rjridle/GRAMS/2_Schematics_and_Layout/6_WIRING_DIAGRAM/Images/4TBLK_Wurth_Elektronik_691322310004.png

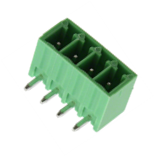
2_Schematics_and_Layout/6_WIRING_DIAGRAM/Images/4TBLK_Wurth_Elektronik_691322310004.png
