rjridle/GRAMS/3_Documentation/Polsir_isolated_design_discussion_06042024 1.pptx

## Polsir IPDU Isolated Design Discussion

## Overview of Ground Loop Risk to Polsir Design

- In the Polsir system, returns are tied to chassis in multiple places (input power source, S-band antenna, polarimeters)
  - Multiple connections to chassis and a shared return create loops (called ground loops) that can pick up noise and allow extraneous current flow in the system
  - This noise/current through chassis can impact sensitive measurements and damage electronics
- The IPDU can reduce these risks by implementing isolation in the design

Multiple tie points to chassis in the system and a single shared return produce ground loops, a design risk that can introduce noise and adversely impact sensitive instruments.

## Ground Loops

Simplified System Diagram

Ground Loop Illustration

Associated Design Risks
- The loop through the return and chassis forms an antenna
  - EM fields can induce current in the loop, introducing AC noise into the system
  - A large EM pulse can cause a current spike and damage the electronics
- The two chassis connection points may not have precisely the same ground voltage
  - This can cause a current flow that introduces an error in measurements

## Isolated Design Solution

In this isolated design, there is no path for a ground loop between the input and output

## Our System

Motor generates EM fields, which couple with RTN-chassis loop antenna, and generate chassis noise

Polarimeters require close ties to chassis due to high frequencies

Polarimeters share frequency bands with S-band antenna, which may increase susceptibility to chassis noise damage

S-band antenna requires close ties to chassis due to high frequencies

Vadir has sensitive electronics (24-bit ADC, 16-bit requirement); precise measurements are needed

## Input-Output Isolated System Solution

Noise generated by the motors and battery is kept away from sensitive electronics on Vadir and the polarimeters, at the cost of a second PCB and reduced PDU efficiency

Battery, motors, and the S-band antenna share a return

There are still ground loops on the input side and on the output side, but not across input to output

Polarimeters, Mini-Z, and Vadir share a return

Two conversion stages are needed, requiring a second PCB and reducing overall PDU efficiency (~4.7W additional dissipation)

## Isolated Design Impacts

Benefits
- An isolated design of the PDU can keep noise on the input side away from sensitive electronics and measurements on the output side
  - Ground loops within the input and output sides of the system would remain, but the overall risk is reduced
Drawbacks/Considerations
- A second PCB is required for the isolated converter stage, impacting cost and schedule
- PDU dissipation increases by approximately 4.7W
  - Currently investigating whether BCT can accommodate the increased power draw

Including an isolated stage in the PDU significantly improves the design overall, but has impacts on the power budget, cost, and schedule

All numbers shown are approximations

## Backup Slides

## Grounding Diagram
