rjridle/GRAMS/3_Documentation/4_Design_Specification_Documentation/SiPM_Warm_TPC_Box.pptx

Telemetry
Power Board 2

S33

S32

S31

S23

Warm TPC
Comm Board

Warm TPC
Power
(+/- 2V)

S22

Telemetry
Power Board 1

S21

S13

S12

S11
