rjridle/GRAMS/3_Documentation/4_Design_Specification_Documentation/Support_Images_For_Cold_TPC_SiPM_Users.pptx

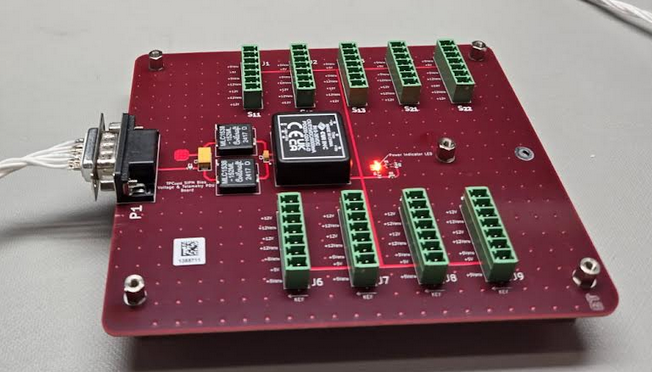
[picture p19: figure]

LED Indicator

## Slide 2

J2 – J7

1
2
3
4
5
6
7

+5V RTN

+5V RTN

+5V IN

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
+12V RTN

+12V IN

J2

+12V RTN

+12V IN

## Slide 3

Rack Supply

Chassis

+12V

+12V_RTN

Telemetry Power Board

J1

W1

J1

J2

W2

P_Out

J2

## Slide 4

TP

Shield

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
Chassis

TP

+12V_RTN

+12V IN

Würth Electronik
9-Position Socketed D-Sub
Part Num: 61800924923

TP

+12V_RTN

+12V IN

Terminate all +12V lines into the same banana connector
Terminate all +12V_RTN lines into the same banana connector
Terminate the Chassis line into its own banana connector

TP

+12V_RTN

+12V_RTN

+12V IN

+12V IN

Chassis

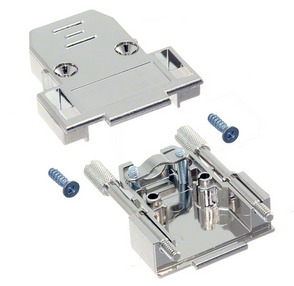
[picture p20: figure]

Würth Elektronik
9-Position Backshell
Part Number: 260709

## Slide 5

Würth Elektronik
3-Position Terminal Block
Part Number: 691361300003

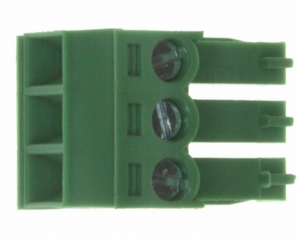
[picture p21: figure]

Phoenix Contact
7-Position Terminal Block
Part Number: 1803620

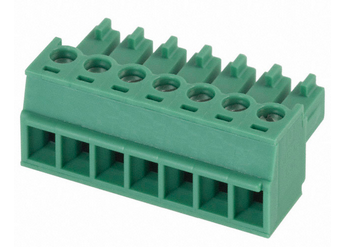
[picture p22: figure]

TP

Würth Elektronik
4-Position Terminal Block
Part Number: 691361100004

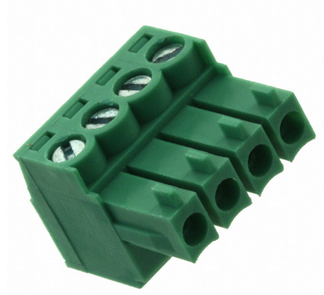
[picture p23: figure]

TP

## Slide 6

TP

Shield

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
Chassis

TP

HV Current Monitor

Telemetry Return

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
Chassis

Würth Electronik
9-Position Pin D-Sub
Part Num: 61800924823

TP

High Voltage Enable -

High Voltage Enable +

TP

High Voltage Monitor

Telemetry Return

Telemetry Return

Set High Voltage

Chassis

Würth Elektronik
9-Position Backshell
Part Number: 260709
