rjridle/GRAMS/3_Documentation/4_Design_Specification_Documentation/Support_Images_For_DSD.pptx

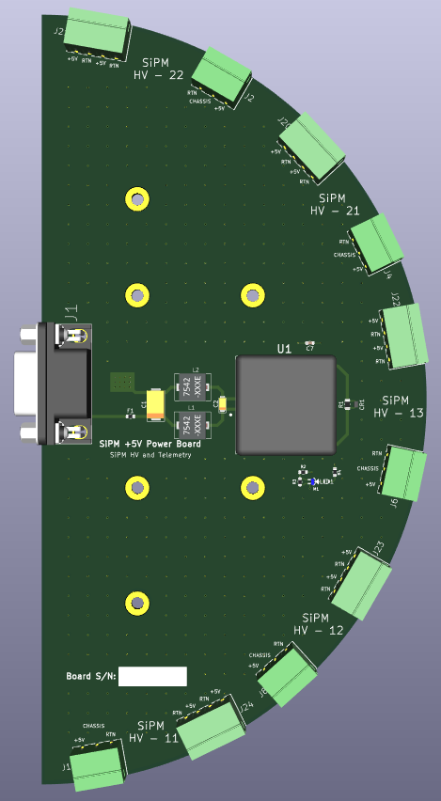
[picture p24: figure]

Telemetry
Power Board 2

S33

S32

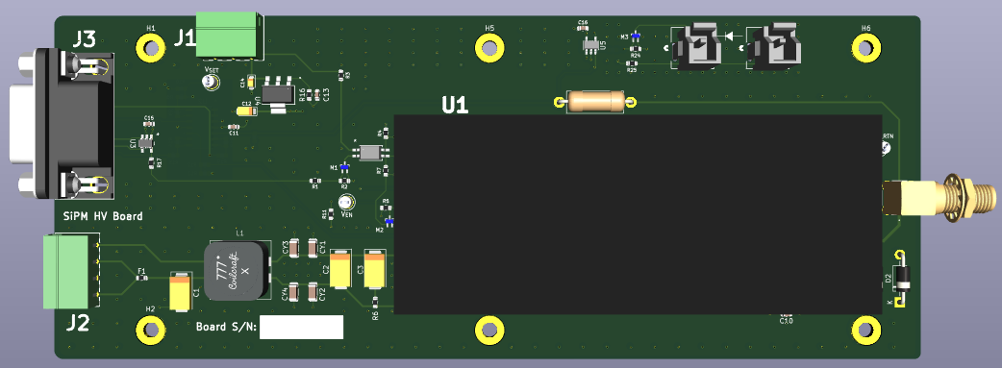
[picture p25: figure]

S33

S31

S23

Warm TPC
Comm Board

Warm TPC
Power
(+/- 2V)

S22

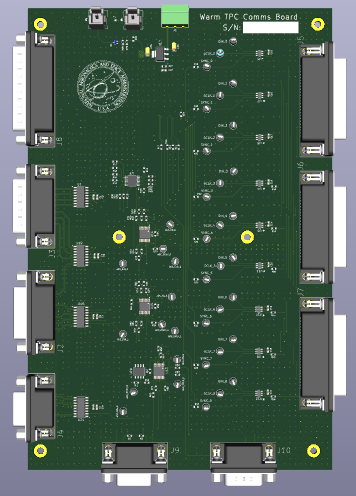
[picture p26: figure]
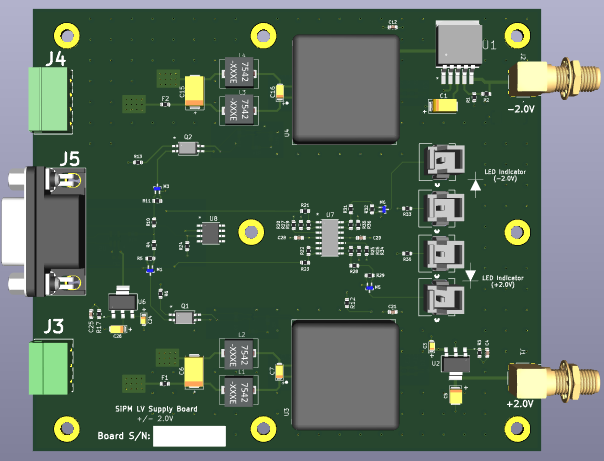
[picture p27: figure]

Telemetry
Power Board 1

S21

S13

S12

S11

S11

## Slide 2

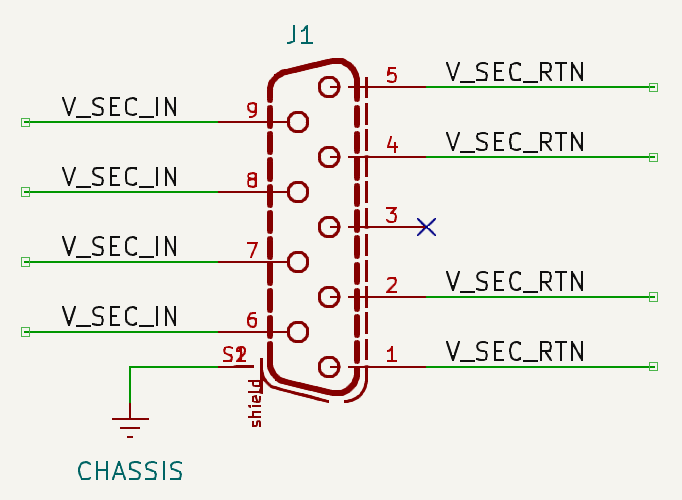
[picture p28: figure]

- J1 is a 9-Socketed D-Sub Connector
- U1 is the PDQ10-Q24-S5-D CUI DC-DC Converter
- LED1 indicates when output voltage from converter is on
- Terminal blocks (3 and 4 – Pos) headers

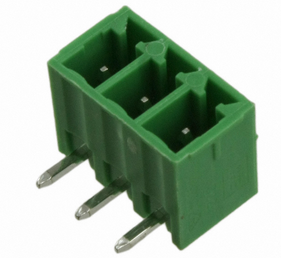
[picture p29: figure]

691322310003

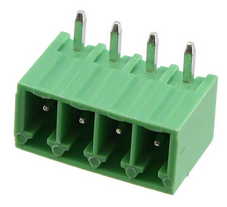
[picture p30: figure]

691322110004

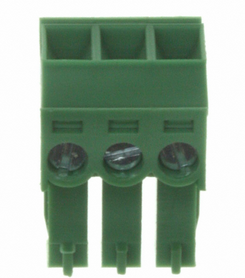
[picture p31: figure]

691361300003

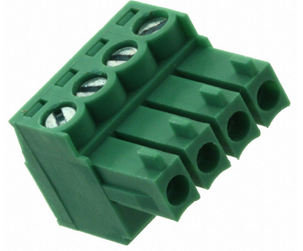
[picture p32: figure]

691361100004

## Slide 3

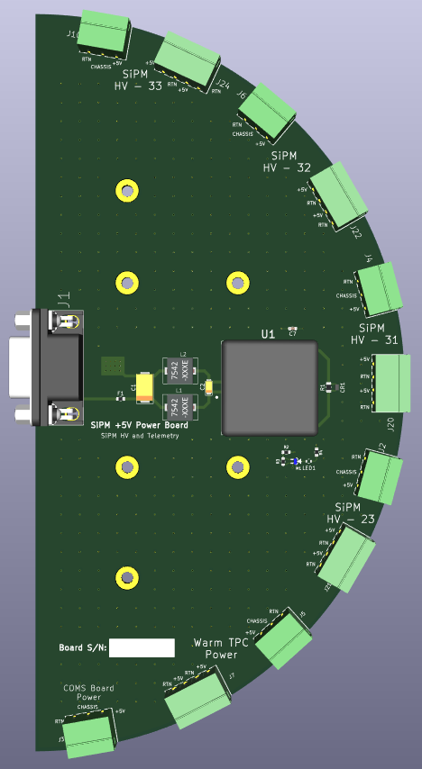
[picture p33: figure]
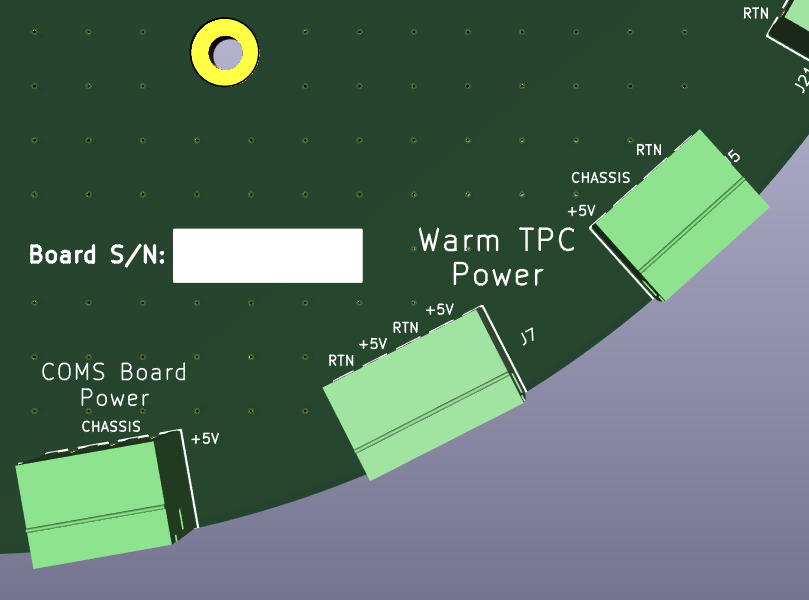
[picture p34: figure]

## Slide 4

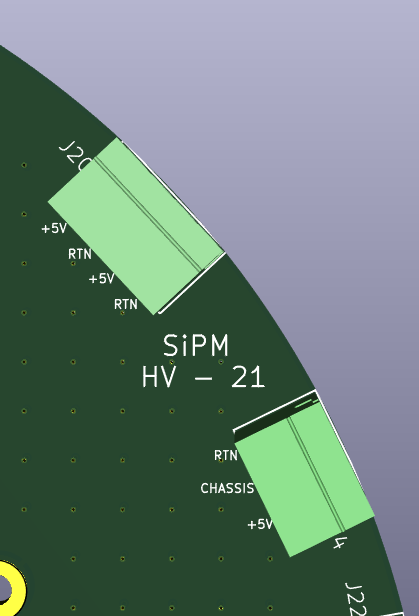
[picture p35: figure]

Power Board

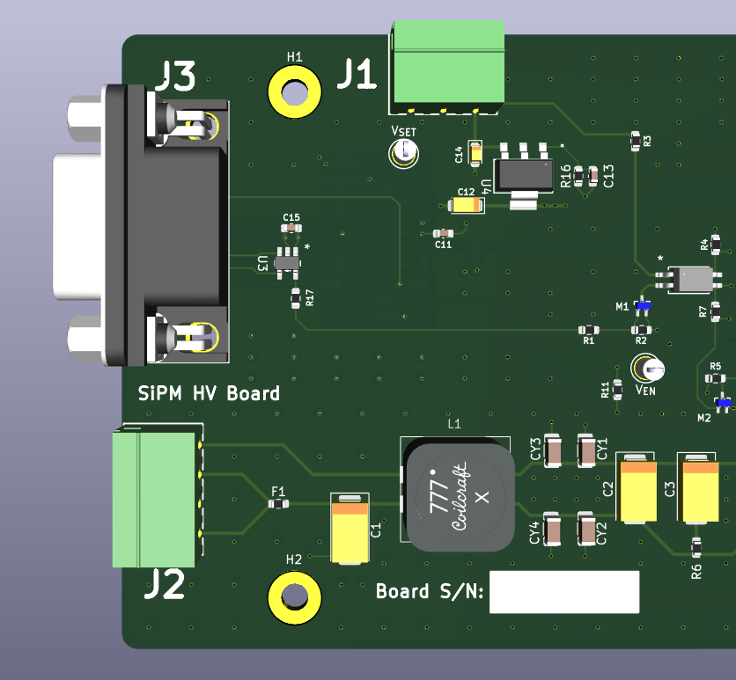
[picture p36: figure]

SiPM HV Board
