rjridle/GRAMS/2_Schematics_and_Layout/Block_Diagrams/SiPM_PDU_Block_Diagram.pptx

## SiPM HV Board (Box Concept)

## Slide 2

SiPM PDU BOX

SiPM HV Board

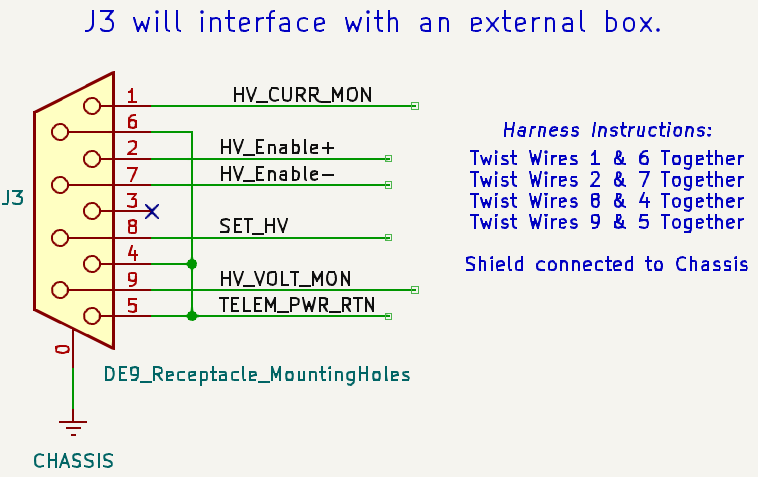
[picture p37: figure]

+12V

+5V

V_SEC_RTN

Telem V+

V_SEC

1

9-Pos D-Sub

Telem RTN

SiPM HV Board

SMA

V_SEC_RTN

V_SEC

2

9-Pos D-Sub

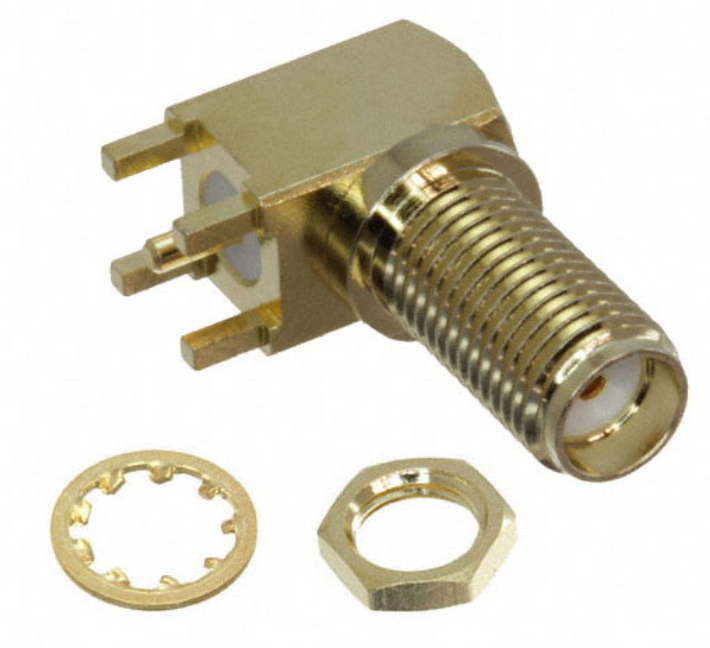
[picture p38: figure]

+12V

V_SEC

Telem RTN

Telem V+

SMA

V_SEC_RTN

V_SEC

V_SEC_RTN

V_SEC

Telemetry Supply (+5V)

V_SEC_RTN

Telem RTN

Telem V+

V_SEC_RTN

V_SEC

SiPM HV Board

Telem RTN

Telem V+

9

9-Pos D-Sub

SMA

Indicator LED outside of box

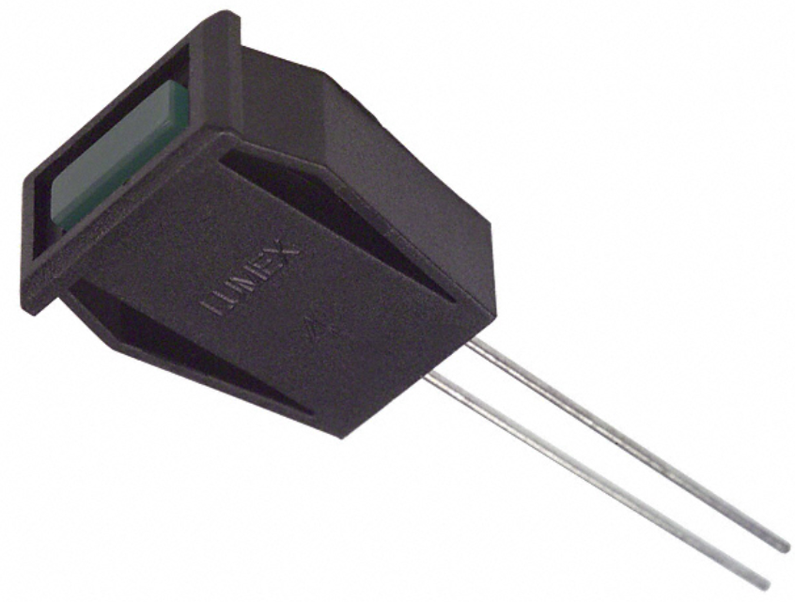
[picture p39: figure]

SiPM LV (+/- 2V Rails)

V_SEC_RTN

V_SEC

15-Pos D-Sub

+2V

RTN

Telem RTN

Telem V+

-2V

## SiPM HV Board (Schematic Design)

## Slide 4

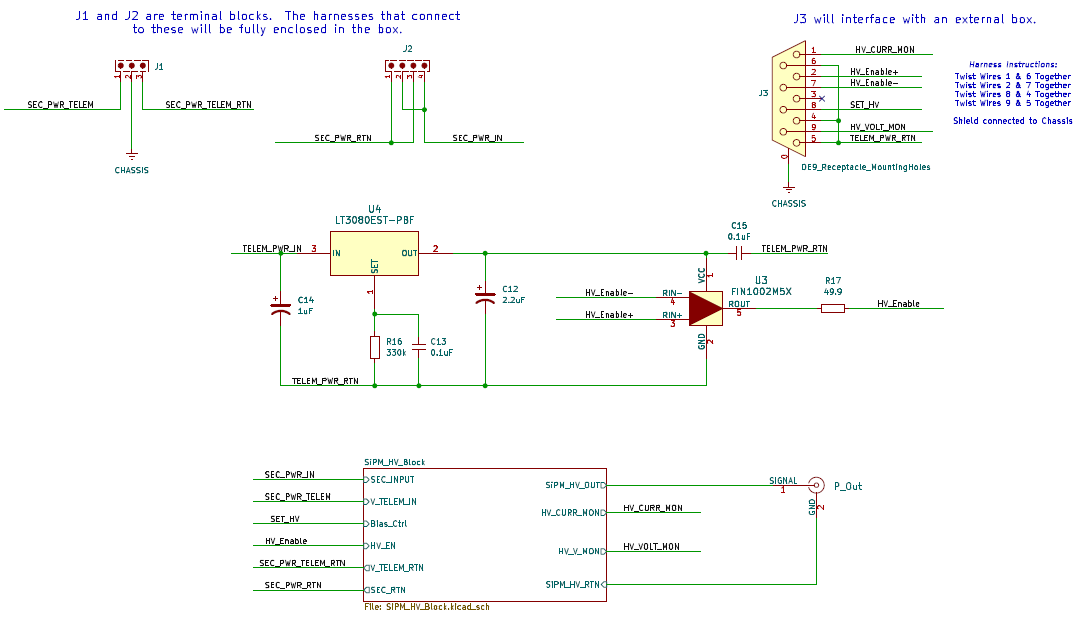
[picture p40: figure]

3.3V Logic for Enable Signal

LVDS Receiver

## Slide 5

DC-DC Converter Supplying SiPM with HV

Zap Trap

Prevents any drift
between HV and LV Returns

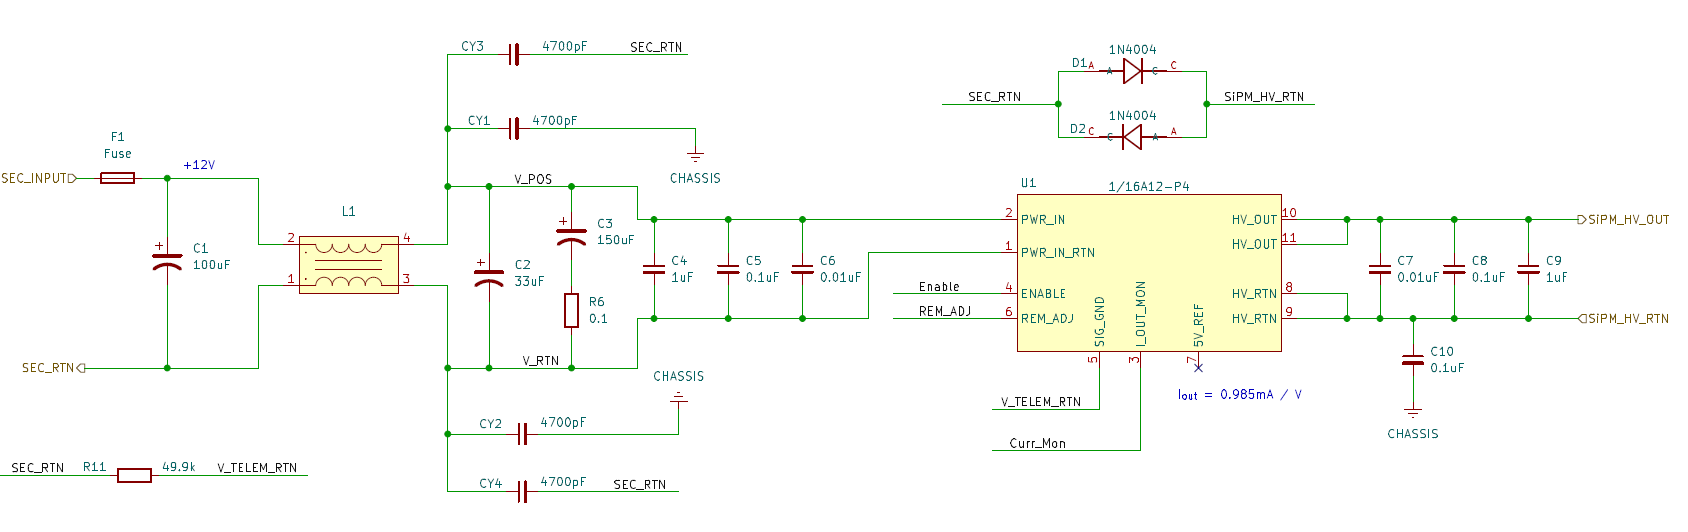
[picture p41: figure]

Safety Fuse

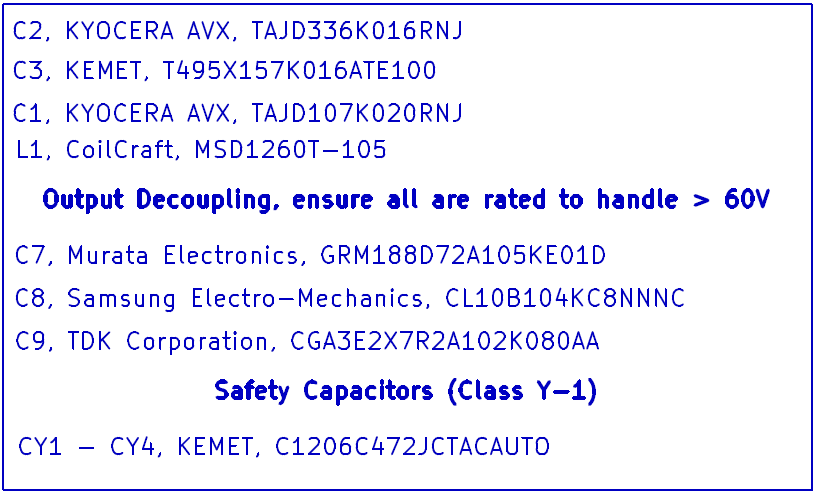
[picture p42: figure]

Keeps telemetry and secondary
returns from drifting away from
each other

## Slide 6

HV Enable Circuitry

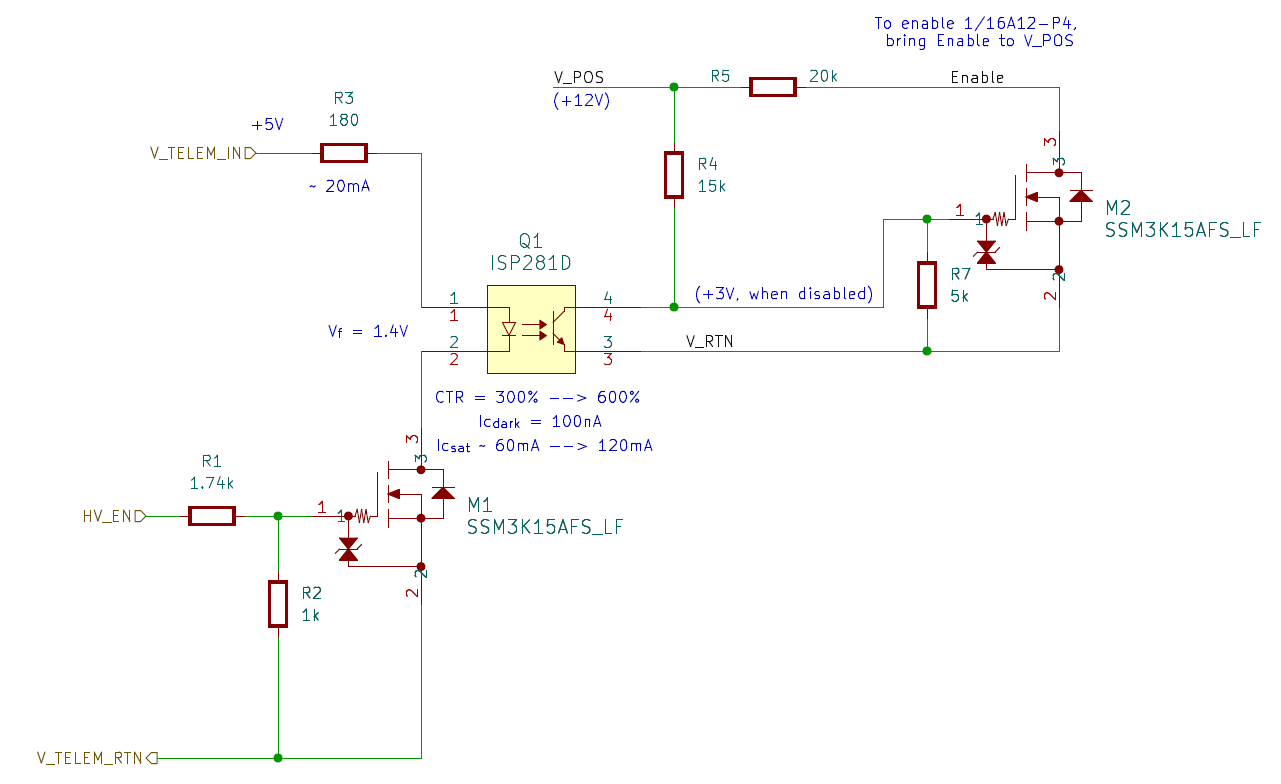
[picture p43: figure]

(DNP)

- Q1 Notes:
  - Pins 1 and 2 on Telemetry return plane
  - Pins 3 and 4 on the secondary return plane
- R5 is a DNP, as Enable pin within 1/16A12-P4 converter should be tied to V_POS via 10k resistor. If not, install R5.

## Slide 7

Telemetry Circuitry

Setting the HV Level

Current Monitor is outputting a voltage

HV Current Monitor

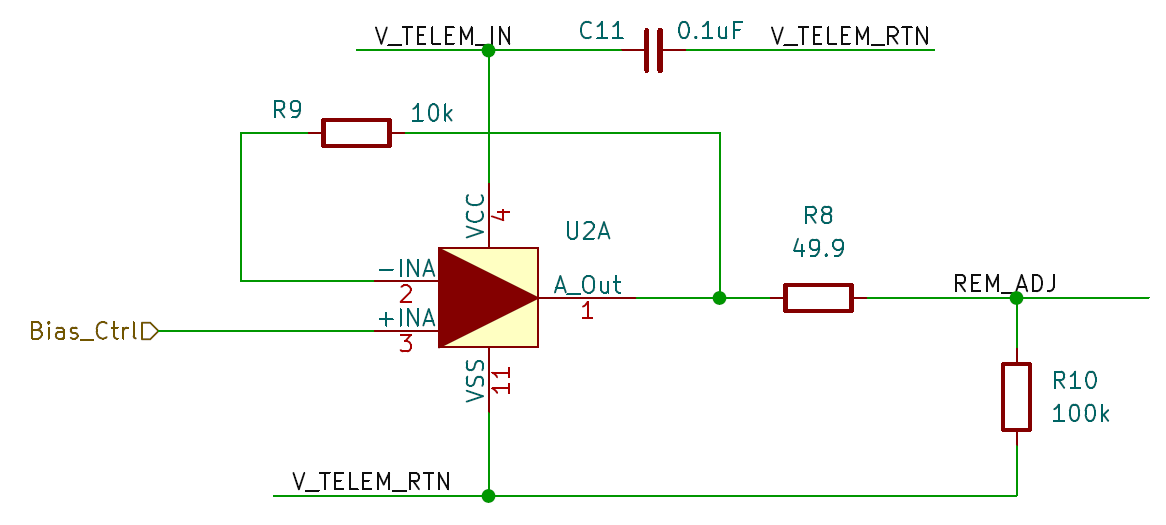
[picture p44: figure]
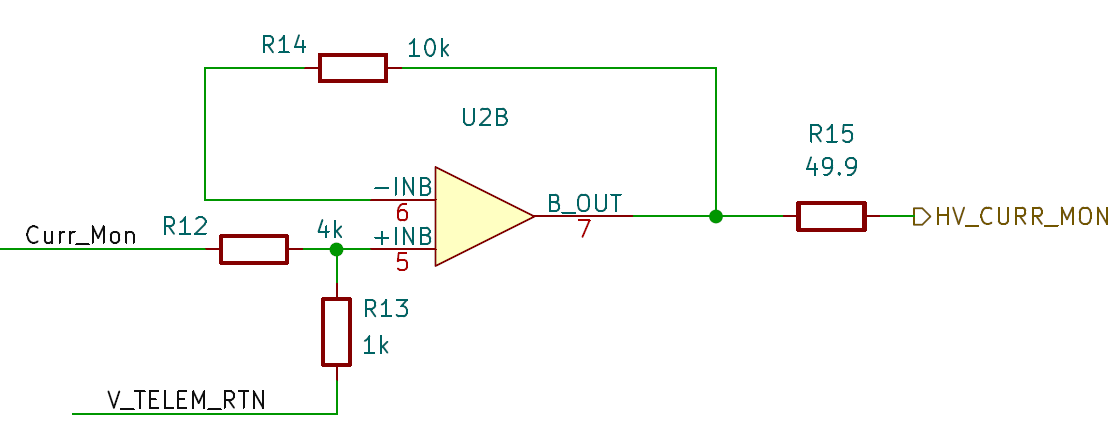
[picture p45: figure]

i_(HV) =(0.985mA)/(HV_CURR_MON)

V_(HV) =13.33(HV_(SET) )

High Voltage Monitor

Indicator LED

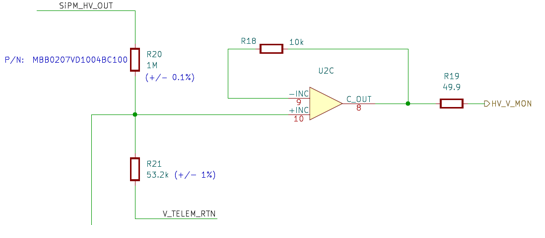
[picture p46: figure]

- R24 keeps M3 off when not driven by U2D.

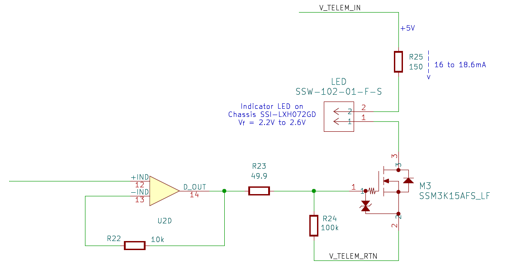
[picture p47: figure]

Shares Input from
High Voltage Mon
circuit.

HV_(MON) =V_(HV) ((R_21)/(R_20 +R_21))

V_(HV) =0.05(HV_(MON) )

V_(th) =1.5V
