rjridle/GRAMS/3_Documentation/Grounding Configuration.pptx

## GRAMS PDU Grounding Configuration

Dave Durachka, Code 564

## List of Sub-Systems in the PDU

1. Cold Time-Projection Chamber
  - Houses the SiPM Power Boards (x6), the SiPM Pre-Amplifier, Charge Pre-Amplifier, as well as Telemetry Power Boards
  - The High Voltage Board Inside the pressure vessel is also part of the Cold TPC section.
2. Warm Time-Projection Chamber
  - Houses the Shaper Power board, as well as the data acquisition power boards
3. CPU
  - Hub CPU and DAQ CPU power boards are housed here
4. Time of Flight Section
  - This houses the Time-Of-Flight Power Board.

## Design Philosophy

- Each of the sub-systems will be powered from a single DC-DC Conversion done on the Main PDU Box. This box will receive the +28V from the battery pack on the balloon gondola and convert down to +12V that will drive each Sub-System’s PDU Board.
  - Each sub-system will have a dedicated power board that will receive the +12V and convert down or up to the prescribed value needed for the sub-system.
  - Requirements have been captured for the PDU system and agreed to by everyone.
  - An Interface Control Document (ICD) will accompany this presentation to provide completeness to this design.

## Harnessing Nomenclature

- Classes of Harnessing
  - Input Power Cables to the PDU (Preceded with a P) at the box level
  - Telemetry Cables within the PDU (Preceded with a T) at the box level
  - Cables providing power From the PDU (Preceded with a J) at the box level

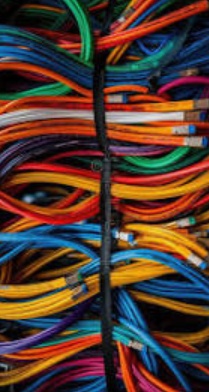
[picture p75: figure]

## COLD TPC PDU

## Cold TPC SiPM Bias Power Board

- The Image to the left is describing the board providing power for both the SiPM Bias as well as the telemetry section of the SiPM Bias Board.
  - J2 – J7 will provide +12V and +5V to each SiPM Bias Board.
  - This board will receive +12V from the Main DC-DC PDU Board.

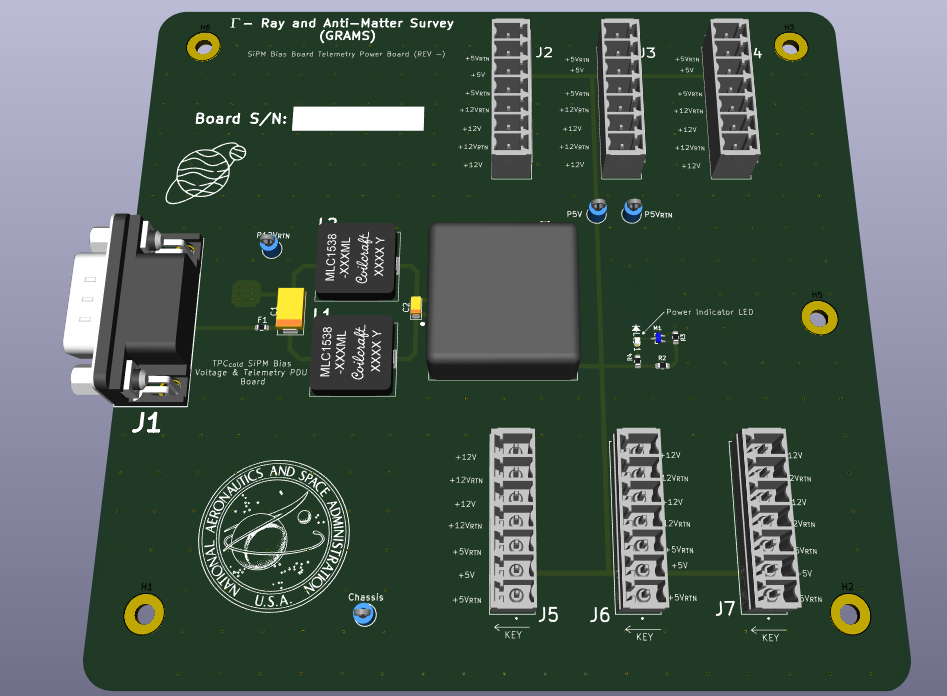
[picture p76: figure]

## Cold TPC SiPM Bias Board

- The SiPM Bias Board is shown to the Right.
  - J1 and J2 receive the +12V and +5V (with returns) respectively.
  - J3 is the command / control, and telemetry portal to this board.
  - U1 is the 1/16A12-P4-I5 converter manufactured by Ultravolt and will provide the prescribed voltage rail to each SiPM within the Cold TPC Section.

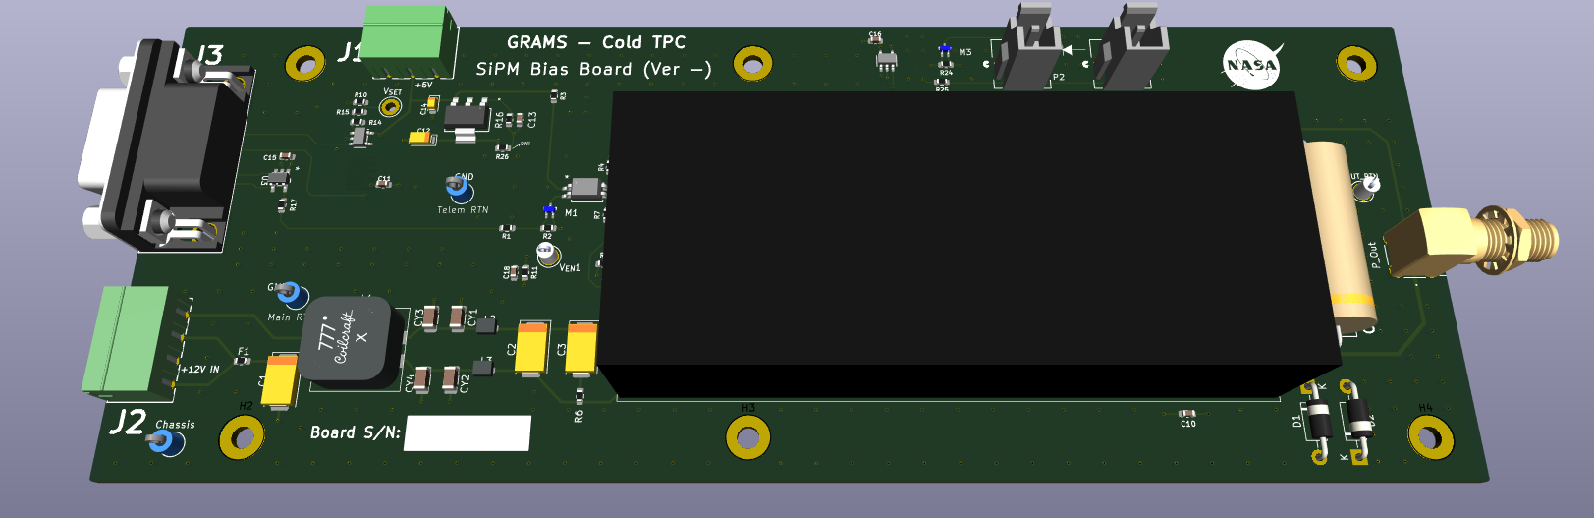
[picture p77: figure]
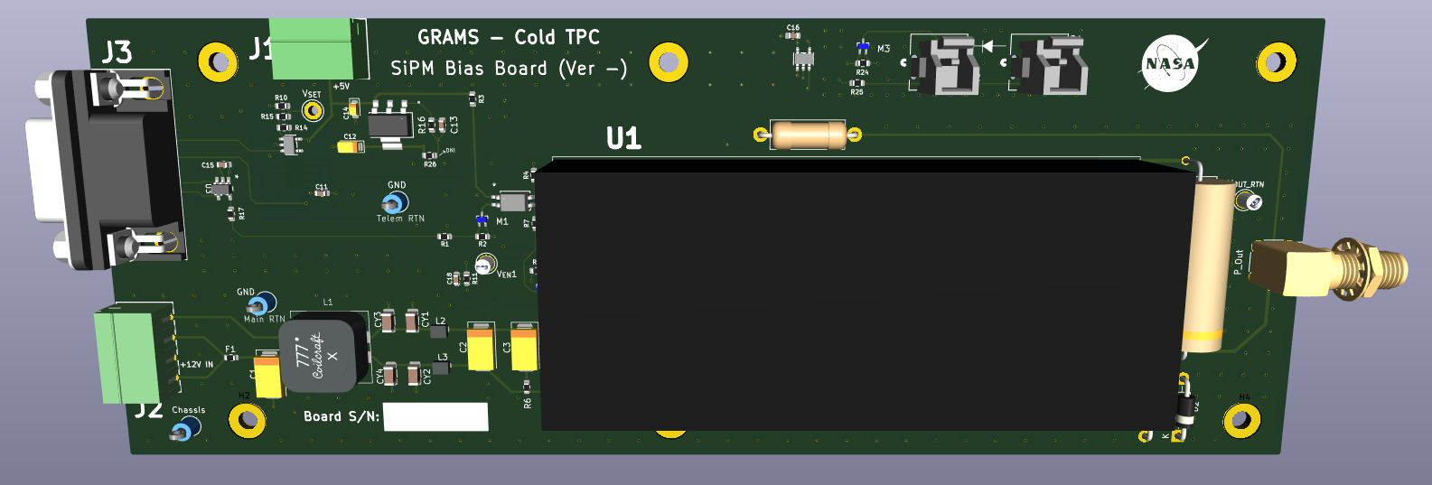
[picture p78: figure]

## Cold TPC SiPM Bias Box Wiring Diagram

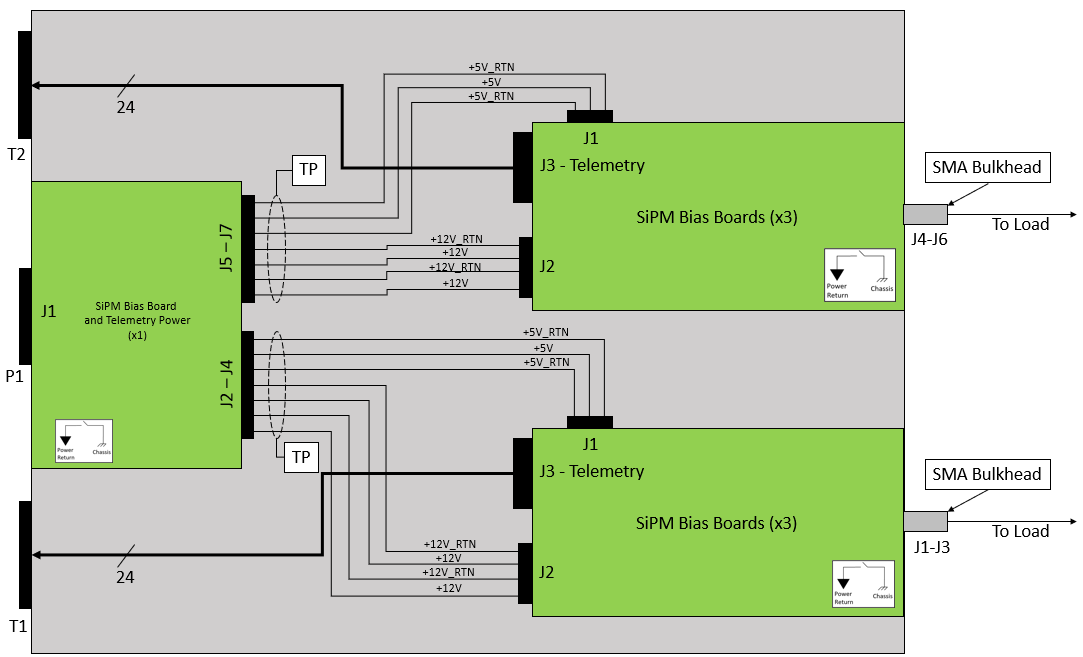
[picture p79: figure]

Chassis

## Cold TPC SiPM Bias Box Design

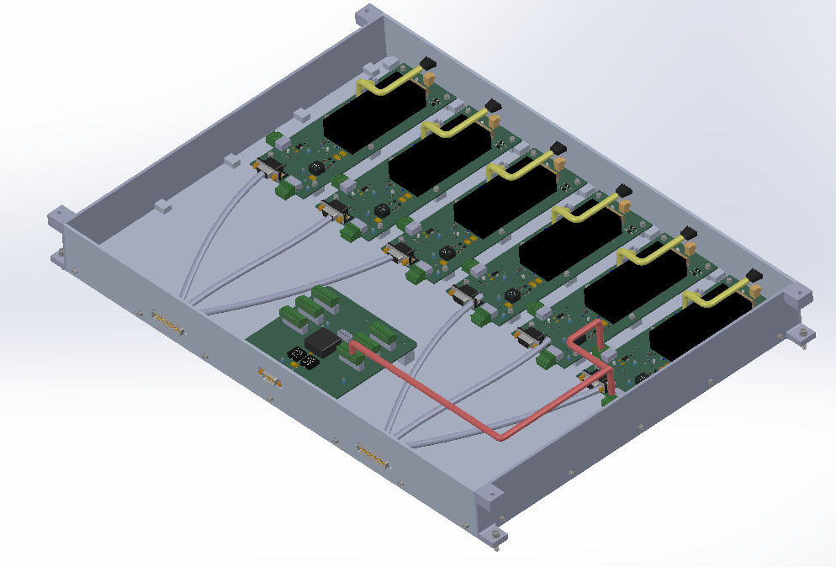
[picture p80: figure]

## Cold TPC Charge and SiPM Pre-Amp Power Board

- The image to the left describes the power board providing +/- 5V for the telemetry sections of the PDU Boards servicing the Charge and SiPM Pre-Amplifier Sub-Systems

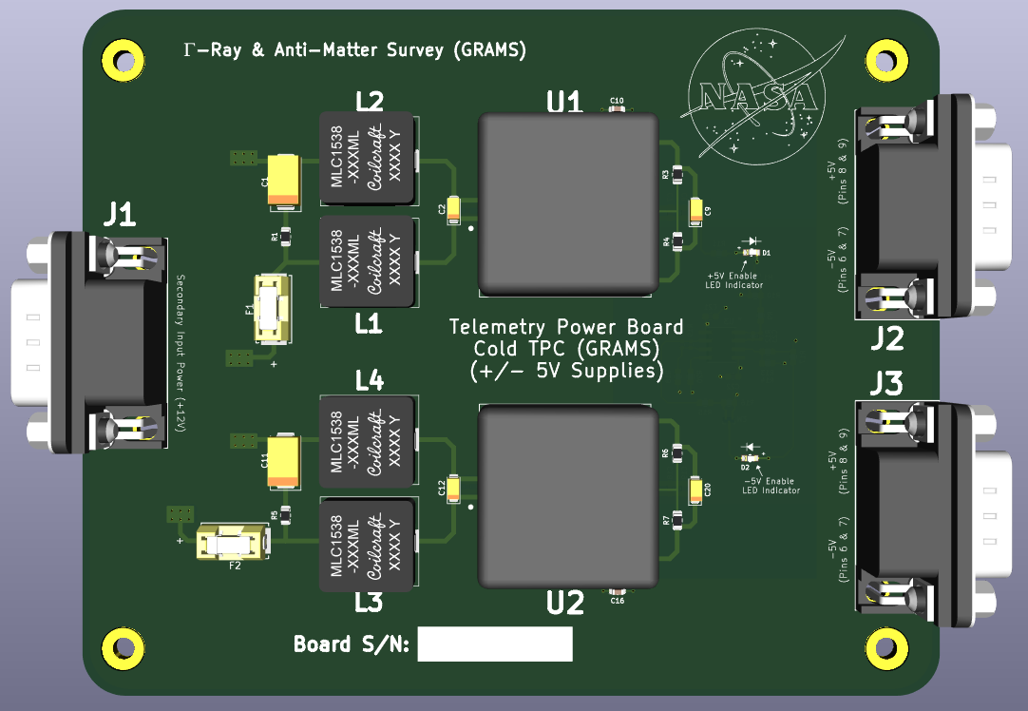
[picture p81: figure]

## SiPM Pre-Amplifier Board

- The Image to the Right is showing the SiPM Pre-Amplifier PDU Board.
  - J1 receives +12V from the Main PDU Board
  - J2 receives the +/- 5V from the Charge and SiPM Pre-Amplifier Board shown in the previous slide.
  - J3 Provides the telemetry from this board.
  - J4 and J5 deliver +2.5 / -5 respectively to the load.

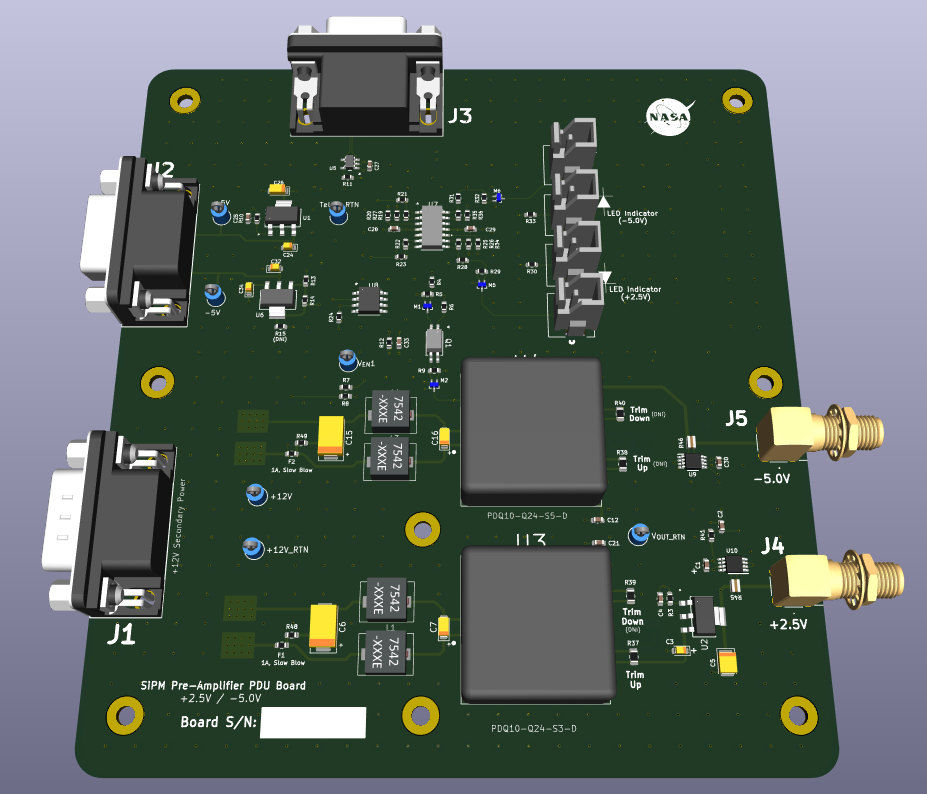
[picture p82: figure]

## Charge Pre-Amplifier Board

- The image to the right is showing the Charge Pre-Amplifier PDU Board
  - J1 is receiving the +12V from the Main PDU Board
  - J2 is receiving the +/- 5V from the Charge and Pre-Amplifier Power board
  - J3 is providing the telemetry from this board
  - J5 and J4 are providing the +/- 5V to the Load.

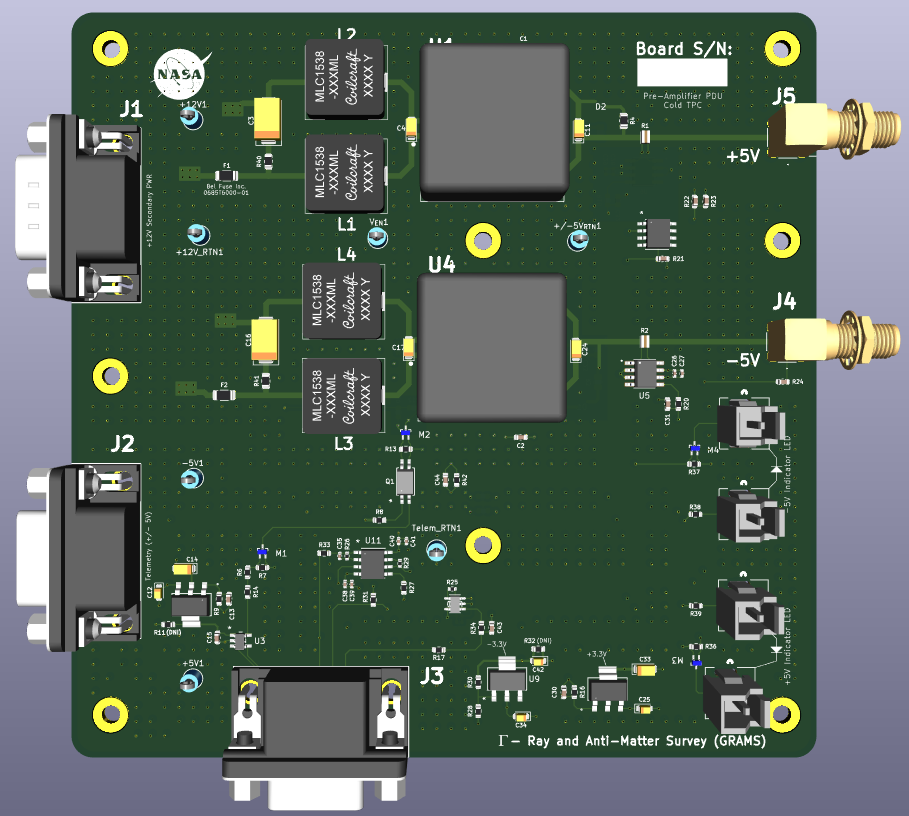
[picture p83: figure]

## Cold TPC Charge and SiPM Pre-Amp Box Wiring Diagram

* All harnessing called out in this drawing are Twisted Pair

15

T3

Telemetry Values

SiPM Pre-Amplifier
PDU Board

8

+12V_RTN

+12V

8

+/- 5V_RTN

+/- 5V

J2 (Telem power)

J3 (Telem)

P2

(-5V) J5

J7

To Load

SiPM and Charge
Pre-Amp Power Board

J1 (Main Power)

(+2.5V) J4

J8

To Load

P3

Charge Pre-Amplifier
PDU Board

J1 (Main Power)

(+5V) J5

J9

To Load

8

+12V

8

(-5V) J4

J10

To Load

P4

+12V_RTN

+/- 5V_RTN

+/- 5V

J2 (Telem power)

J3 (Telem)

12

Telemetry Values

T4

## High Voltage Bias (-10kV) for Cold TPC

- Images to right show the HV PDU board for the Cold TPC
  - J1 and J2 receive the main input power of +12V. The pinout orientation are identical, swapping these will not harm anything.
  - J3 is the Telemetry I/O
  - J4 provides a means to configure he onboard DAC and provide the enable signal. This board will reside in its own box.

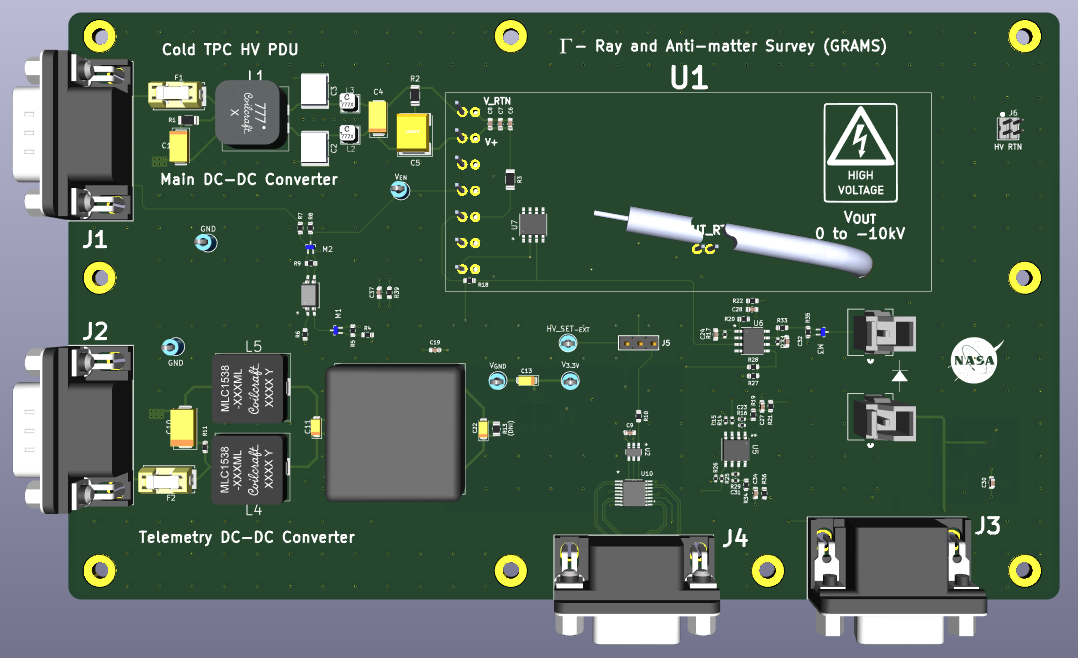
[picture p84: figure]
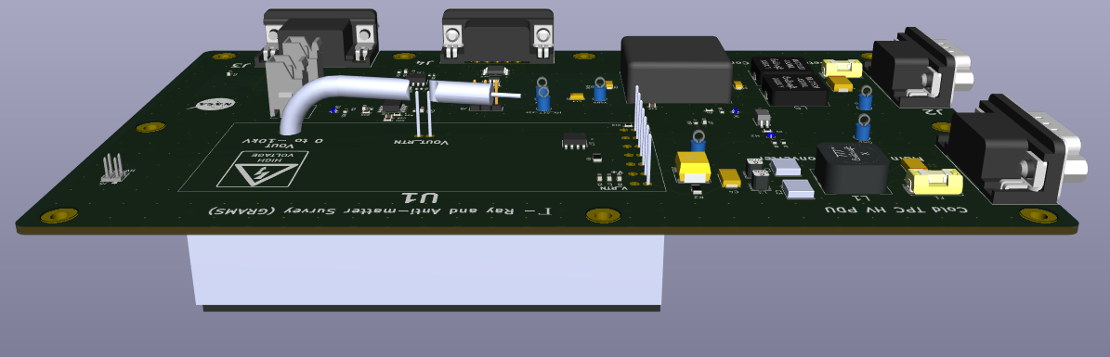
[picture p85: figure]

DC-DC Converter resides on bottom of the board

## Backup Slides

## Slide 16

Cold TPC PDU Section

SiPM Bias Boards (x6)

SiPM Pre-Amp &
Charge Pre-Amp

-10kV HV PDU

Main DC-DC
Converter Board

+28V

=

=

+12V

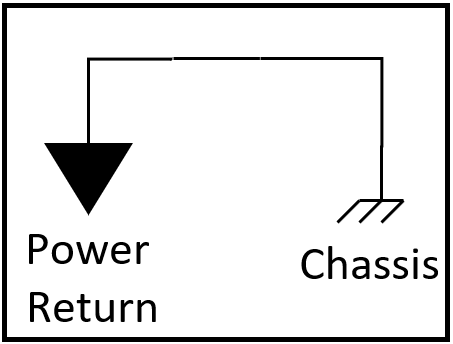
[picture p86: figure]

+28V RTN

+12V
RTN

Warm TPC PDU Section

Caen/Nevis DAQ

Shaper

HUB and DAQ Computer PDUs

Flight Computer

Power
Return

Chassis

## Slide 17

SiPM Bias Box (Cold TPC) Wiring Diagram

+12V_RTN

+12V_RTN

24

+5V_RTN

+5V_RTN

+5V

T2

SiPM Bias Board
and Telemetry Power
(x1)

TP

J3 - Telemetry

J1

SMA Bulkhead

J5 – J7

+12V_RTN

+12V

SiPM Bias Boards (x3)

J4-J6

To Load

J1

+12V

J2

+5V

P1

J2 – J4

+5V_RTN

+5V_RTN

TP

J1

J3 - Telemetry

SiPM Bias Boards (x3)

J1-J3

SMA Bulkhead

To Load

24

+12V_RTN

+12V

+12V

J2

T1
