rjridle/GRAMS/3_Documentation/6_Telemetry/GRAMS Telemetry.pptx

## GRAMS Telemetry

## COLD TPC (Low Voltage PDU) +2.5 / -5V

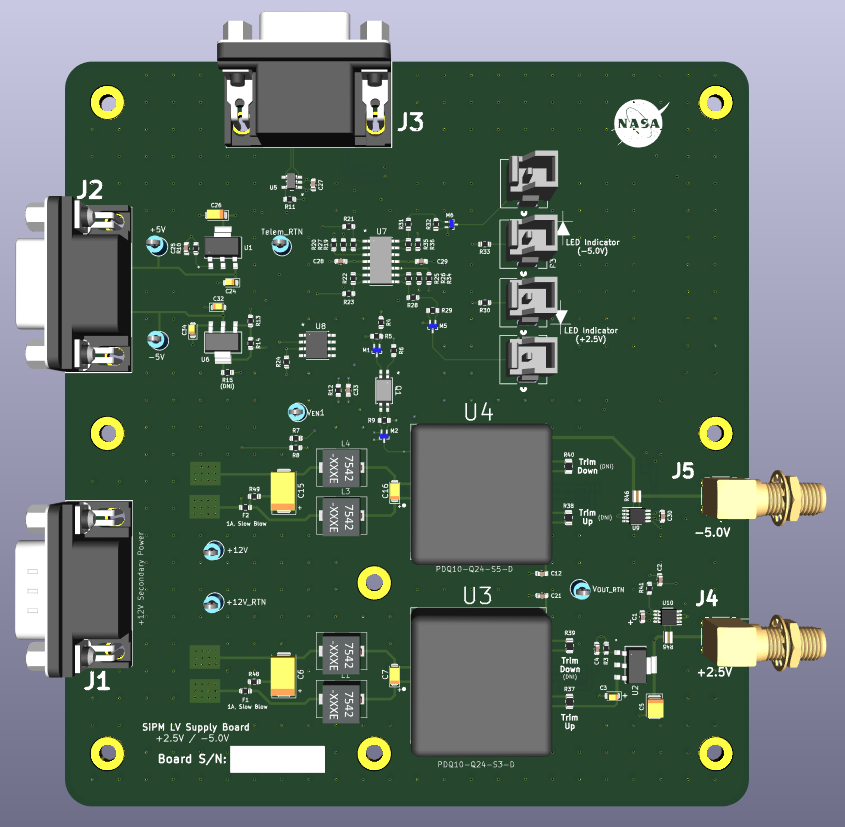
[picture p87: figure]
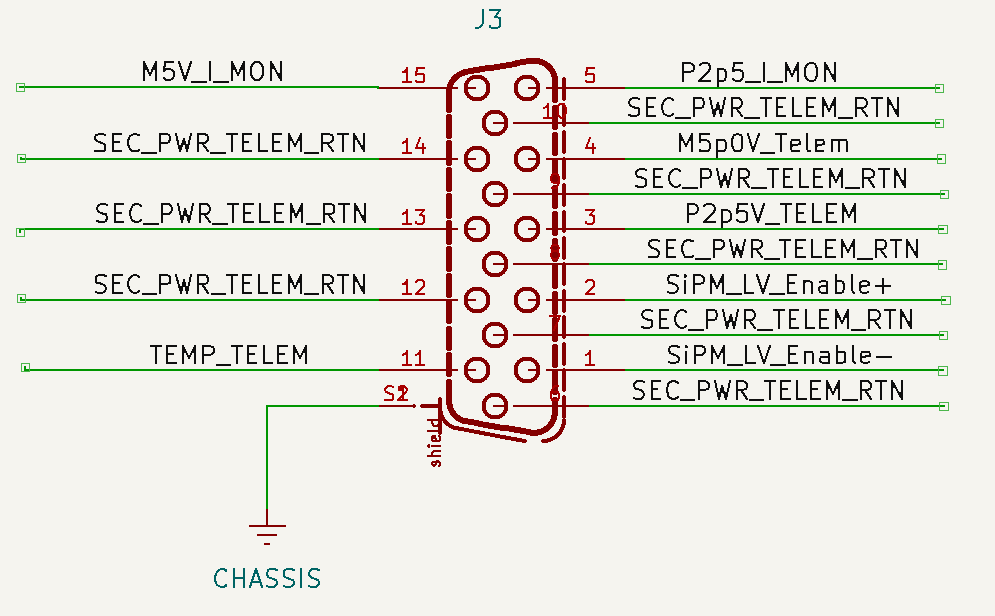
[picture p88: figure]

## COLD TPC (Pre-Amplifier PDU) +/- 5V

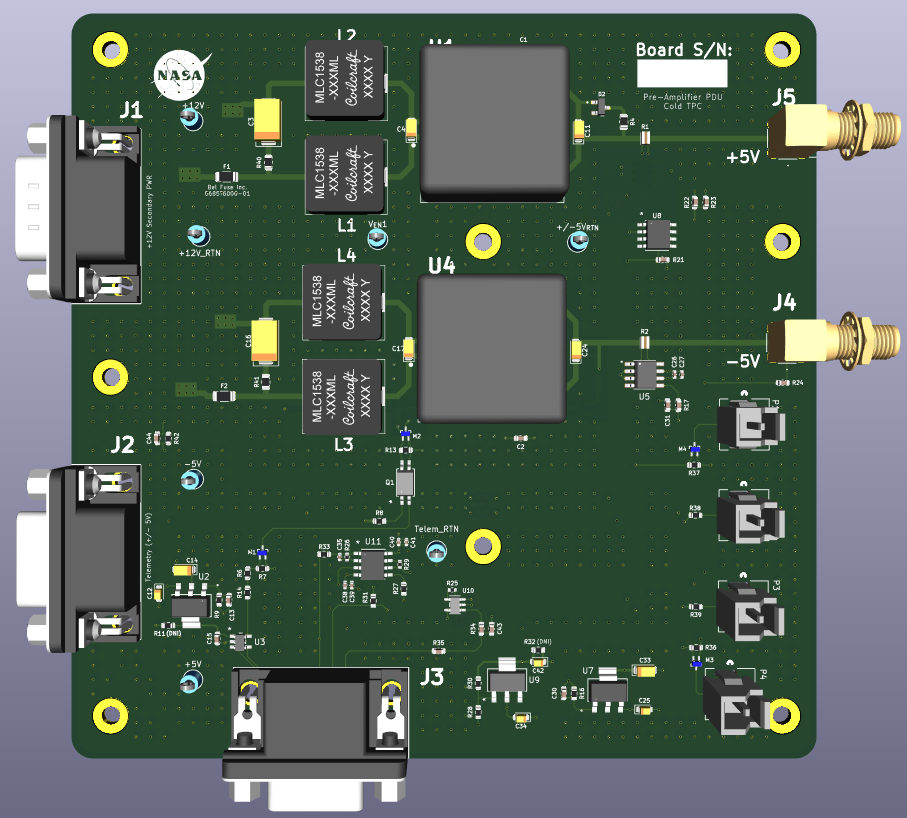
[picture p89: figure]
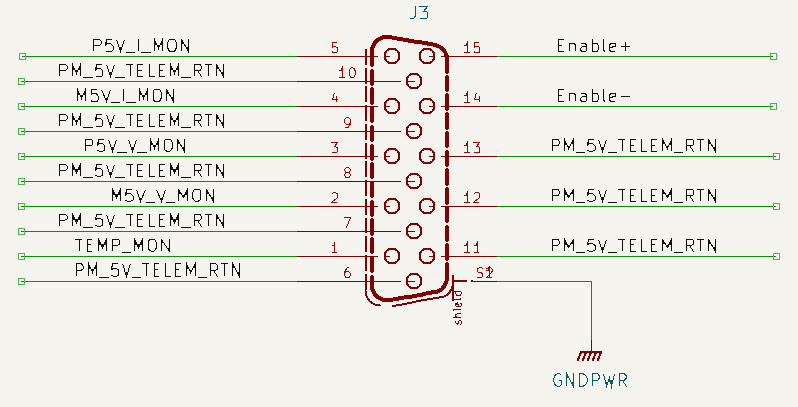
[picture p90: figure]

## COLD TPC (HV Bias) 0 to +60V

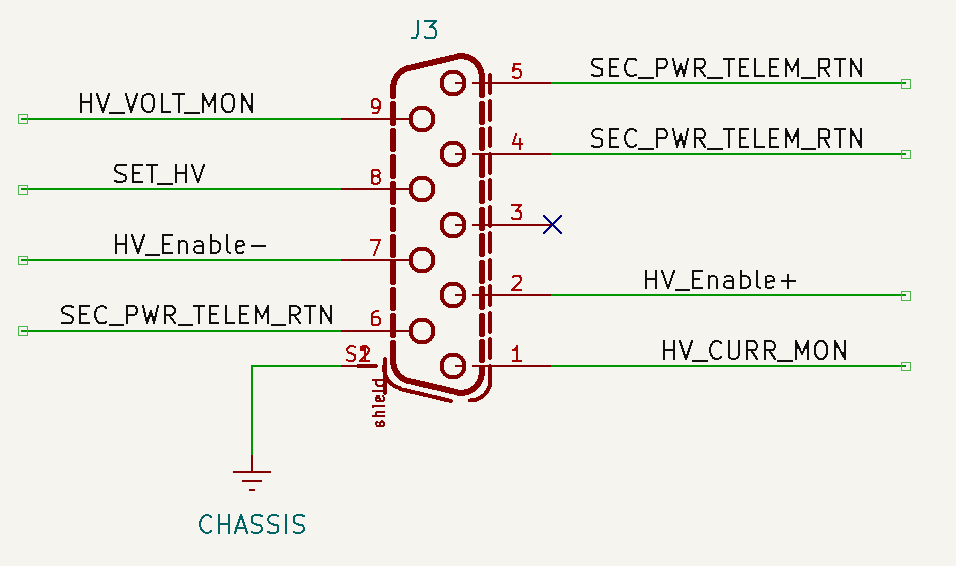
[picture p91: figure]
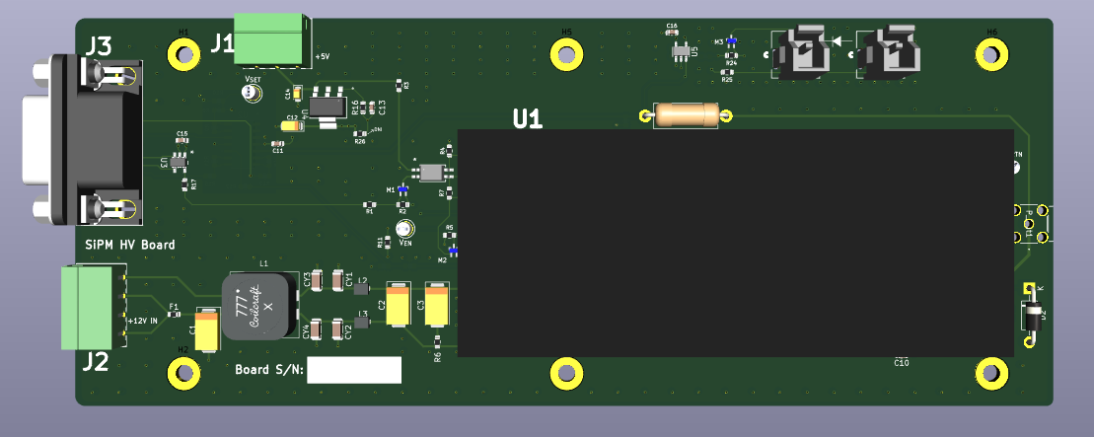
[picture p92: figure]

## TPC Cold PDU Box Block Diagram

## Slide 6

44-Pin D-Sub
(Telemetry for SiPM HV Boards)

Telemetry Power Board for SiPM HV Boards

Telemetry I/O

SiPM HV Bias 1

Secondary / Telemetry PWR

NOTES:
- All of the 9-Pin Secondary Power connectors have the same configuration. All of these will be receiving power from the main PDU Board.

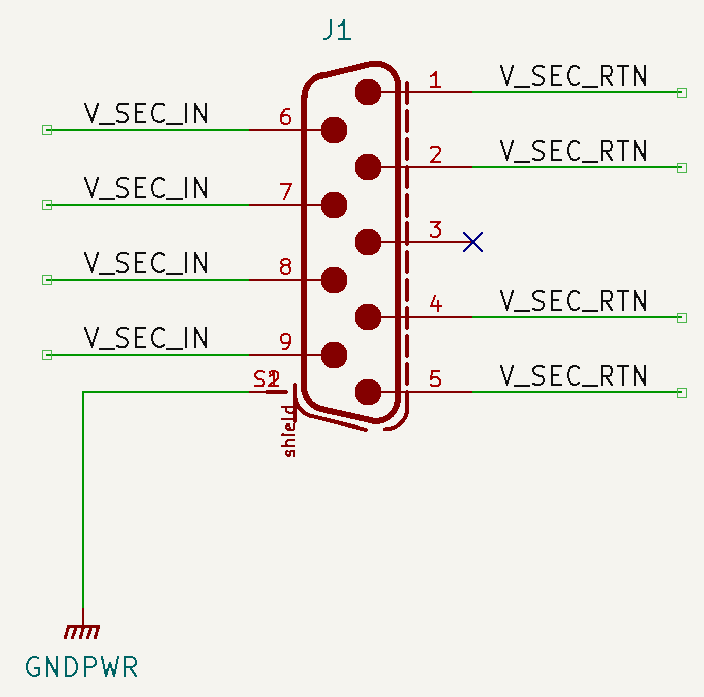
[picture p93: figure]

SiPM HV Bias 2

9-Pin D-Sub
Secondary Power

SiPM HV Bias 3

9-Pin D-Sub
Secondary Power

Telemetry Power Board for COLD TPC LV Boards

37-Pin D-Sub
(Telemetry for Cold TPC LV Boards)

SiPM HV Bias 6

Cold TPC (+2.5V / -5V)

Cold TPC (Pre-Amplifier PDU)

Secondary PWR

Telemetry PWR

9-Pin D-Sub
Secondary Power

9-Pin D-Sub
Secondary Power

Telemetry PWR

Secondary PWR
