rjridle/GRAMS/3_Documentation/5_Reviews/TPC-COLD/SiPM Box/GRAMS - SiPM PDU.pptx

## Gamma Ray and Anti-Matter Survey (GRAMS)

Power Distribution Unit (PDU)
Time Projection Chamber (TPC) SiPM Power & Telemetry Review

## Agenda

- The Power Distribution Unit (PDU) for GRAMS is extensive
  - Only reviewing the Silicon Photo-Multiplier (SiPM) PDU circuitry today
- Overview of Requirements for SiPM bias, command & control
- Block Diagram
- Schematic Review
- Grounding Configuration
- Layout Review

## Requirements for TPC SiPM Power

- The bias to the SiPMs shall be adjustable
  - VMIN 43V → VMAX 60V
  - Bias shall also have Enable / Disable Circuitry
  - Telemetry Points to measure the Bias and Current
  - The Current Draw for each SiPM is expected to be 20mA
  - Temperature Range: -55C to +70C
    - Target maximum altitude: 36km

Hamamatsu: S13370 Series

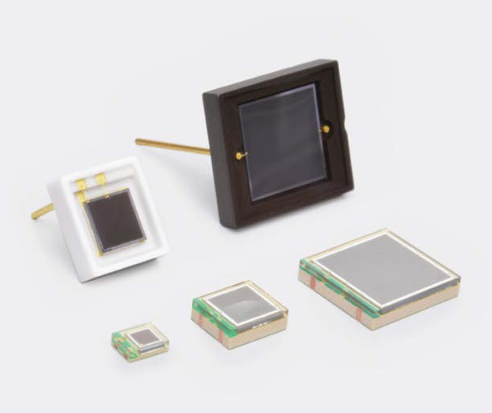
[picture p104: figure]

## Detector Information and Energy Ranges

- GRAMS is using a Liquid Argon Time Projection Chamber (LArTPC) to detect the high energy events
  - High energy particles through the argon will generate scintillated light to be collected by the SiPMs.
  - Typical bubble chamber operation
    - Superheated liquid is in the chamber and held just below its boiling point
    - Interaction with the high energy particles will cause the liquid to boil along its path, creating ‘bubbles’.

Generic bubble chamber image

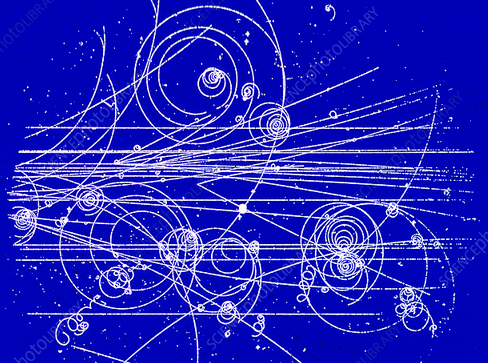
[picture p105: figure]
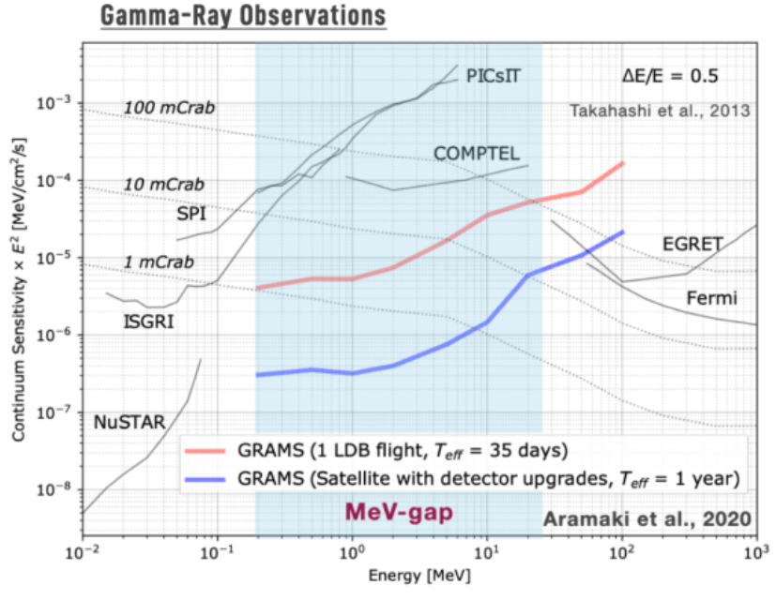
[picture p106: figure]

## SiPM DC-DC Converter Choice

- Ultravolt 1/16A12-P4 DC-DC Converter
  - Able to supply 62V @ 4W.
    - 60V @ 20mA: 1.2W
  - Has remote Enable / Disable Feature
  - Has remote adjust feature for the output voltage

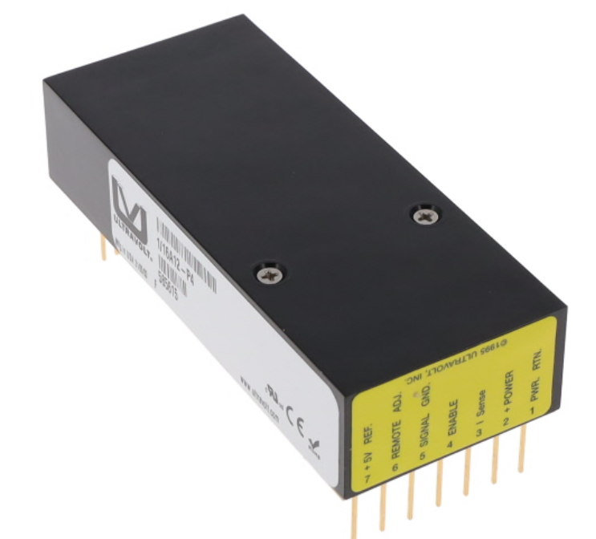
[picture p107: figure]

## 1/16A12-P4 Specifications

Input Parameters of the 1/16A12-P4 Converter
Parameter | Conditions | Values | Units
Input Voltage Range | Full Power | 11 to 16 | Volts
Current | Standby / Disabled | < 30 | mA
Current | Max Load @ output | < 100 | mA
AC Ripple | Max Load @ output | < 80 | mA(peak-peak)
Input Z | Nominal Conditions | 1.1 | MΩ
Enable/Disable Lvl | Nominal Conditions | Disable: 0 to 0.5 | Volts
| | Enable: < 2.4
Output Parameters of the 1/16A12-P4 Converter (Vin = 12V)
Parameter | Conditions | Values | Units
Output Power | Max Load @ Output | 4 | Watts
Max Current Output | Entire Output Range | 64 | mA
Output V Ripple | 0.02% of Output V | 1.28 | mV
Temperature Range
Parameter | Maximum (Deg C) | Minimum (Deg C) | Range (Deg C)
Op. (@ Max Load) | -40 | 65 | 105
Storage | -55 | 105 | 160

- Applying +12V at the input.
- Expecting a current draw of 20mA for each SiPM.
- Output Bias will range from 40 to 60V.
- Operational Temperature specs assume maximum load conditions

## PDQ10-Q24-S5-D DC-DC Converter

- Used these on COM-PAIR extensively to great success

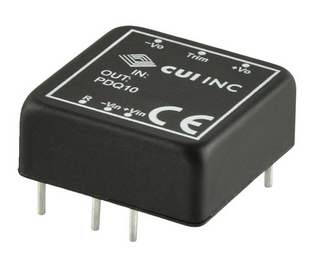
[picture p108: figure]

Input Parameters of the PDQ10-Q24-S5-D Converter
Parameter | Conditions | Values | Units
Input Voltage Range | Full Power | 9 to 36 | Volts
Current | Maximum Input | 1.4 | A
Current | Max Load @ Input | 1.02 | A
Output Parameters of the 1/16A12-P4 Converter (Vin = 12V)
Parameter | Conditions | Values | Units
Output Power | Max Load @ Output | 10 | Watts
Max Current Output | Entire Output Range | 835 | mA
Output V Ripple | 0.02% of Output V | 100 | mV
Temperature Range
Parameter | Maximum (Deg C) | Minimum (Deg C) | Range (Deg C)
Op. (@ Max Load) | -40 | 105 | 145
Storage | -55 | 125 | 180

## Block Diagram of TPC SiPM Box

- This box houses 10 boards
  - One Telemetry Power Board
  - Nine SiPM Power Boards
- Telemetry Board
  - Provides +12V to each SiPM DC-DC Converter
  - Provides +5V that drives Telemetry on SiPM Boards

S11

+12VIN

+5V

+12VRTN

=

=

+5VRTN

9 SiPM
PDU
Boards

S33

## SiPM Power Board

Board Dimensions: 7” x 2.8”

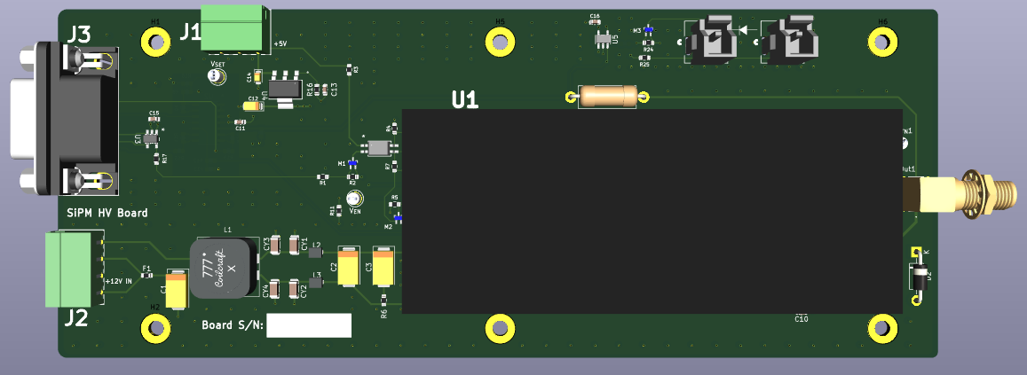
[picture p109: figure]

## TPC SiPM Telemetry Power Board

Board Dimensions: 5.9” x 4.9”

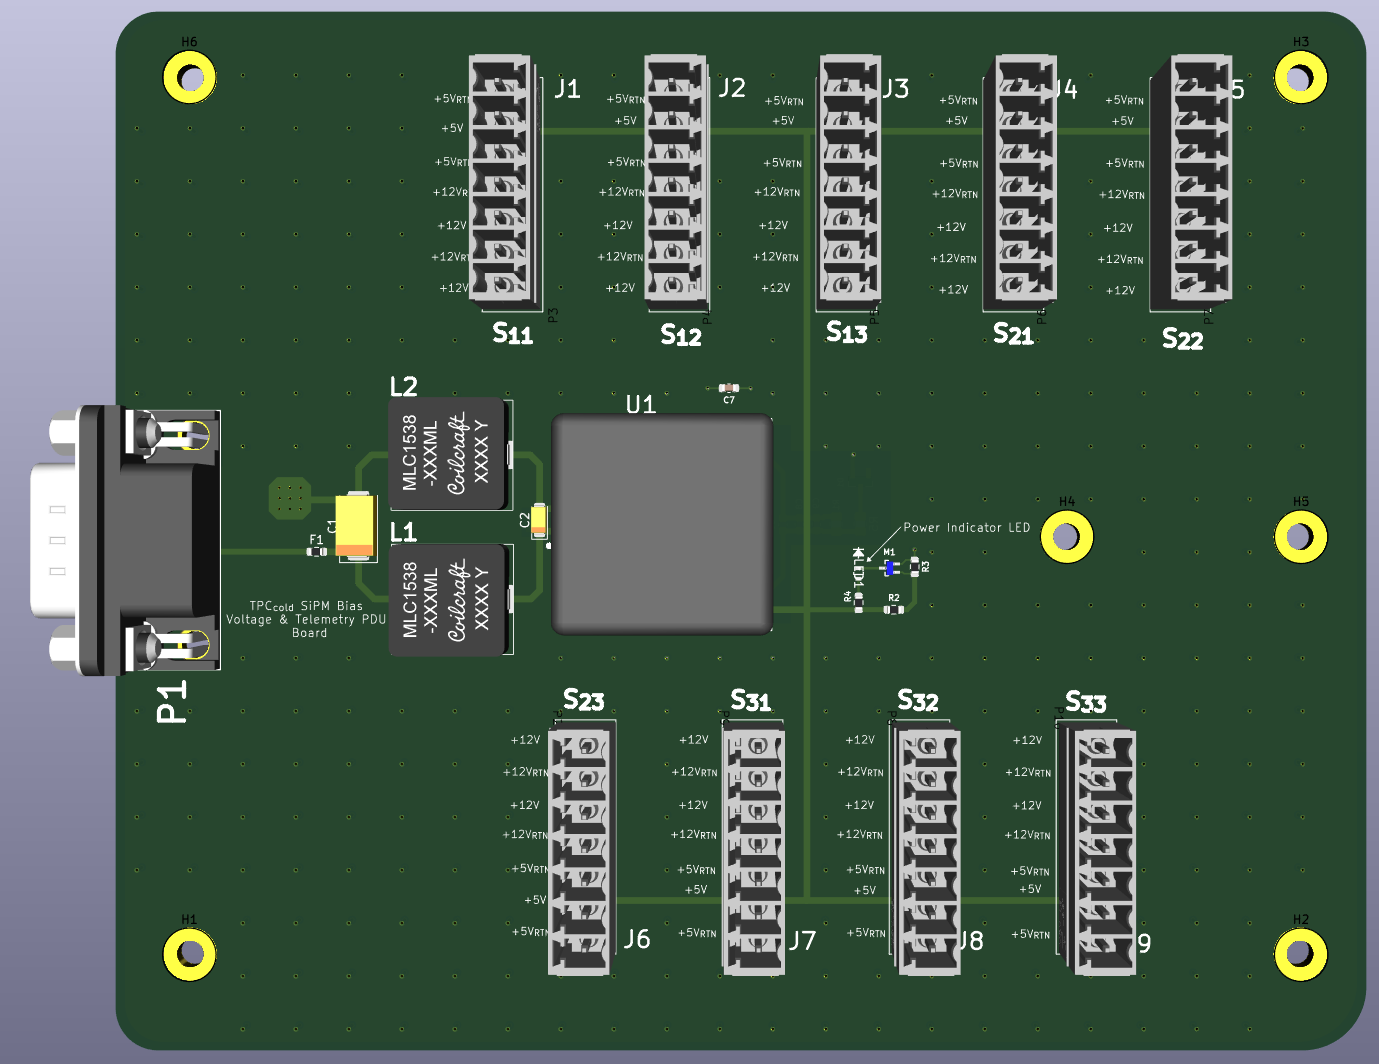
[picture p110: figure]

Wurth Electronik Phoenix Socket: 1803471


Wurth Electronik Phoenix Contact: 1803620

## Schematic Review of SiPM Bias Board

## Input EMI/EMC Network

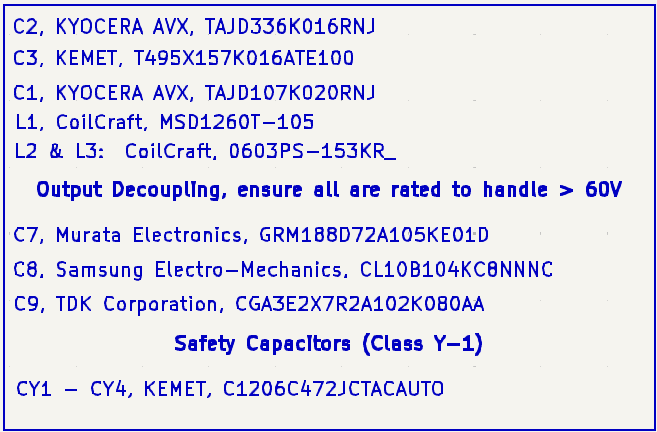
[picture p111: figure]
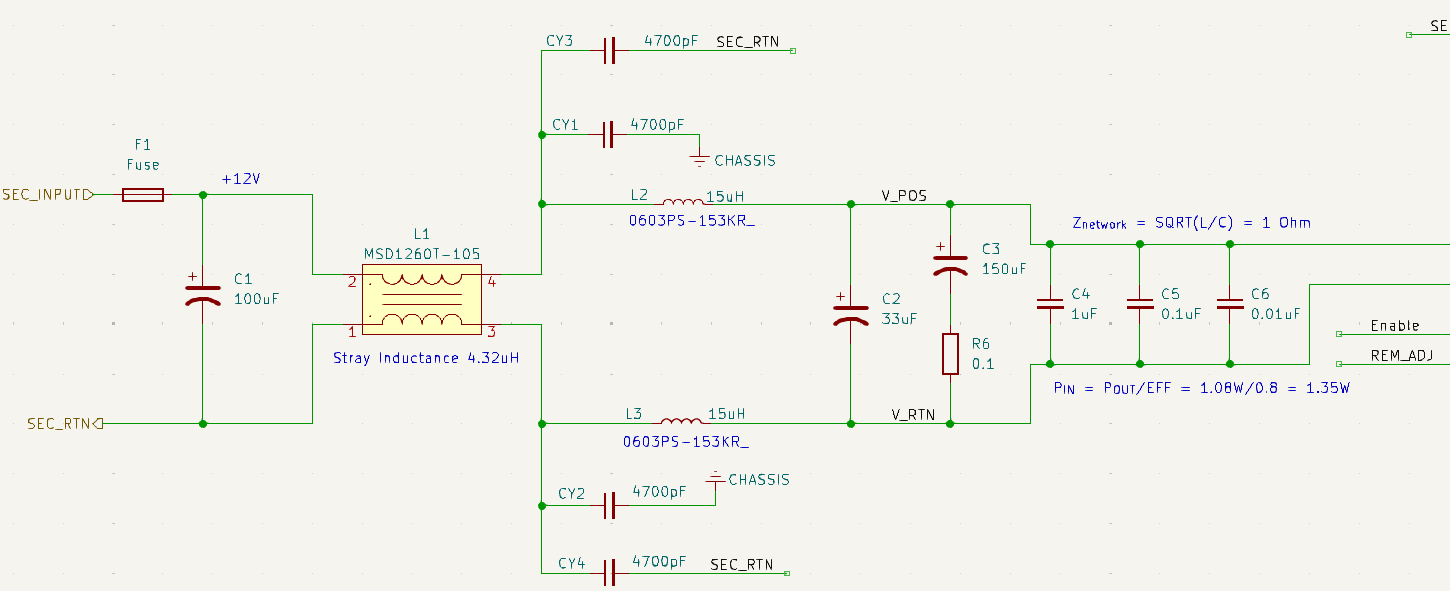
[picture p112: figure]

## Impedance and Cutoff Frequency of Input Filter

- Some Calculations:

Z_(IN_(min)) =(0.85(12V)^2)/(4W)=30.6Ω

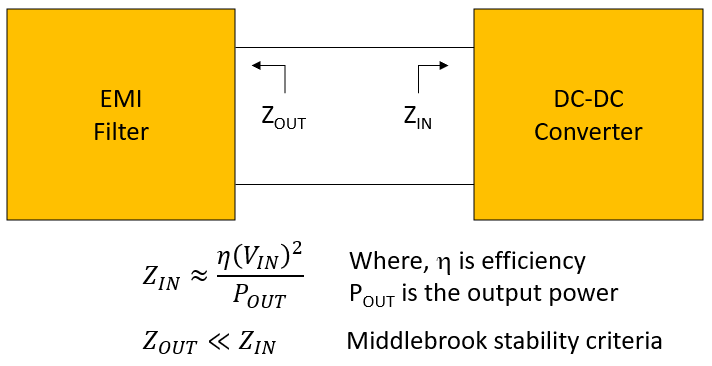
[picture p113: figure]

Impedances

Z_(Out) ≈1.1Ω

L_(Stray) ≈4.32μH

L_(Diff) =30μH

L_(Total) ≈34.32μH

Frequency

C_(Total) ≈30μF

f_c =1/(2(π)√(LC))=4.96kHz

(f_(sw) =64kHz)

## Enable / Disable Circuitry

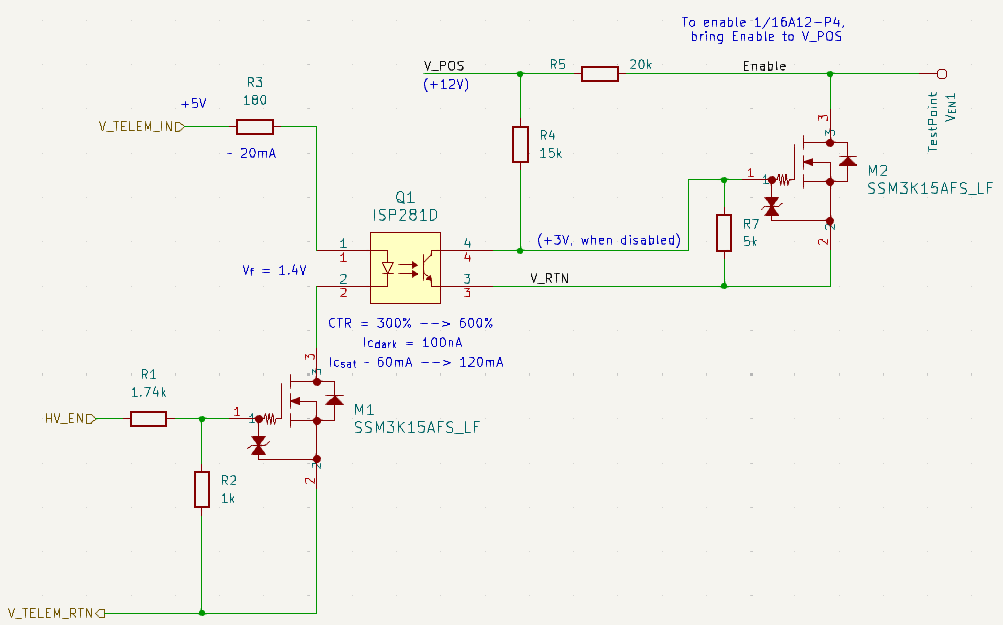
[picture p114: figure]

- 1/16A12-P4 Enable Signal
  - There is a 10kΩ Pull-Up resistor internal to the Converter that defaults the block to enabled if no external control circuitry is added.
  - Am using an opto-coupler to control this function
  - ISP281D:
    - Current Transfer Ratio (CTR): 300 to 600%
    - ID = 100nA
    - ISAT = 60 to 120mA

Truth Table
HV_EN | Low | High
Enable Line | Low | High
DC-DC Conv. | Disabled | Enabled

## Output Bias Control

- Output Bias Control is from external signal
  - Buffered in (LTC2052HV)
  - R10 ensures bias is low if Bias_Ctrl is floating

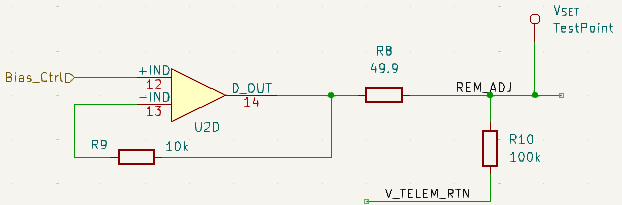
[picture p115: figure]

Bias Control Levels
Bias_Ctrl | 0V | 5V
Output Voltage | 0V | 65V

## Output Bias Current Monitoring

- The 1/16A12-P4 device has internal current monitoring
  - Pin 3, I_OUT_MON
I_(out) =(0.985mA)/V
  - IOUT = 20mA, I_OUT_MON = 19.7mA

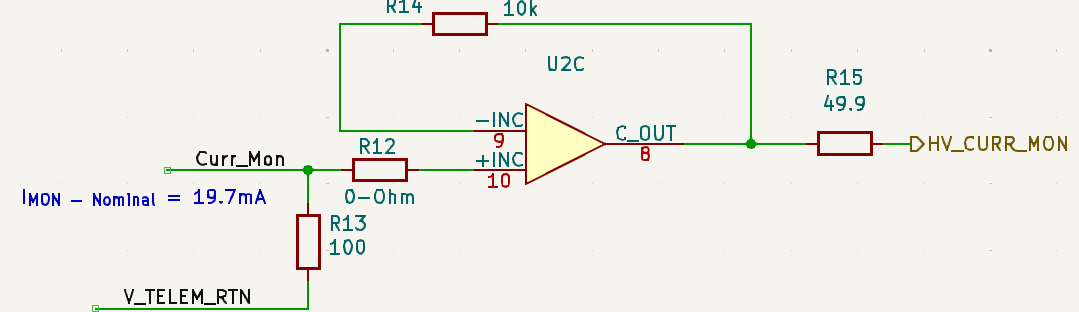
[picture p116: figure]

## Output Bias Voltage Monitoring

- Using a voltage divider and buffering output
  - 1MΩ resistor, (MBB0207VD1004BC100) is capable of dissipating 400mW.
  - Vdrop across this resistor is: 57V is the output bias is set to 60V.
    - PD = 3.3mW
  - Vdiv = 0.05(Bias Output)
    - 60V will produce 3V at the input of U2B

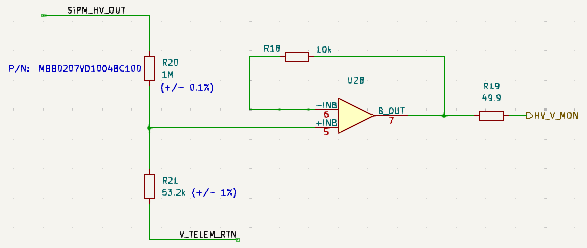
[picture p117: figure]

## LED Indicator

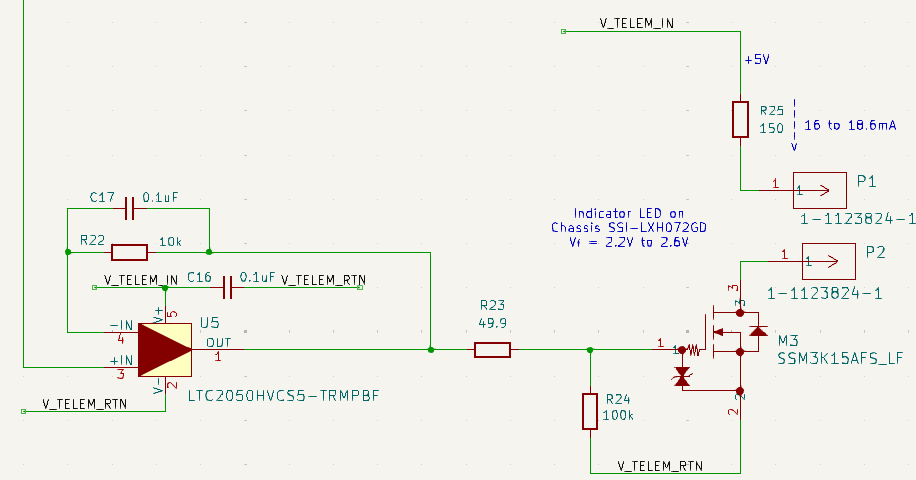
[picture p118: figure]

Part Num: SSI-LXH072GD

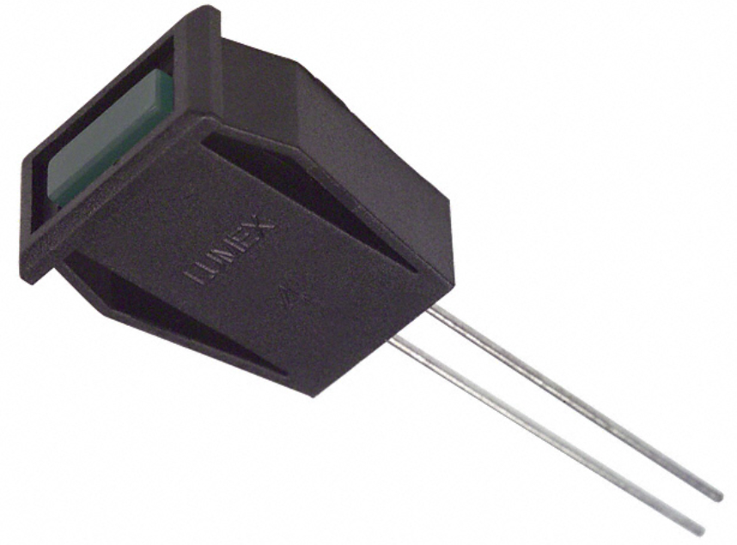
[picture p119: figure]

Mounted on Chassis

+3V @ Bias Level = 60V
+2V @ Bias Level = 40V

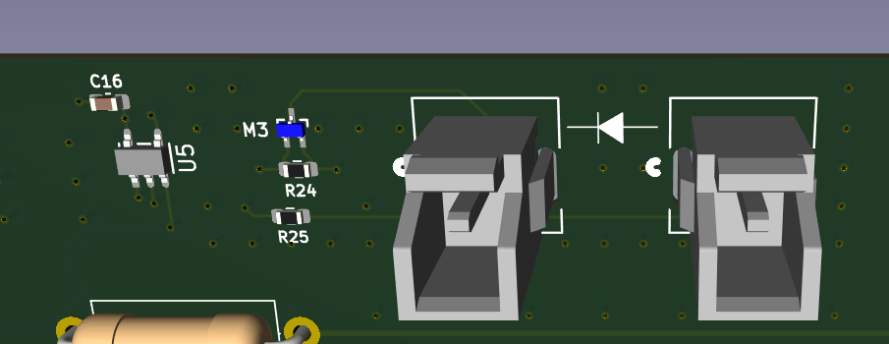
[picture p120: figure]

1-1123824-1

## Input Current and Power Calculations

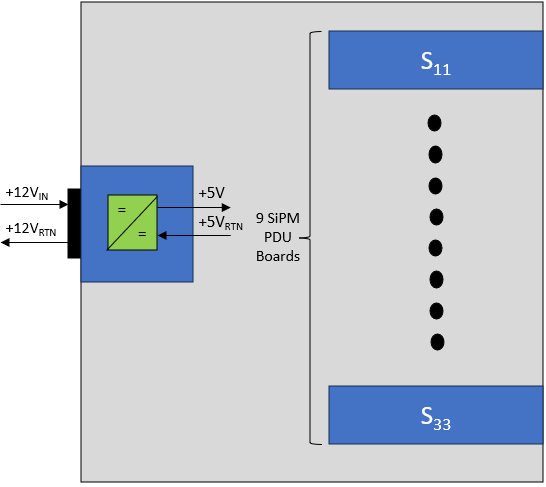
[picture p121: figure]

There are 9 boards pulling this
11.97WTotal
0.998A Total

- 1/16A12-P4
  - The expected load from each SiPM is approximately 20mA at maximum.
    - Sub-system testing is on-going.
    - VMIN 43V → VMAX 60V
    - Manufacturer quotes efficiency at 90%

P_(OUT_Min) =(43V)(0.02A)=860mW

P_(OUT_Max) =(60V)(0.02A)=1.2W

P_(IN) =(P_(OUT))/η=(1.2W)/(90%)=1.33W

i_(IN) =(1.33W)/(12V)=111mA

## Telemetry I/O

- All of the telemetry and control functions are sent and received through J3 (9-Pos Socketed D-SUB)
  - Enable function is received as a differential signal (LVDS)
  - U3, SN65LVDS2DBVR receives this signal, delivers to input of optocoupler (Q1)
  - SEC_PWR_TELEM_RTN is tied to the secondary 5V_RTN on the board.

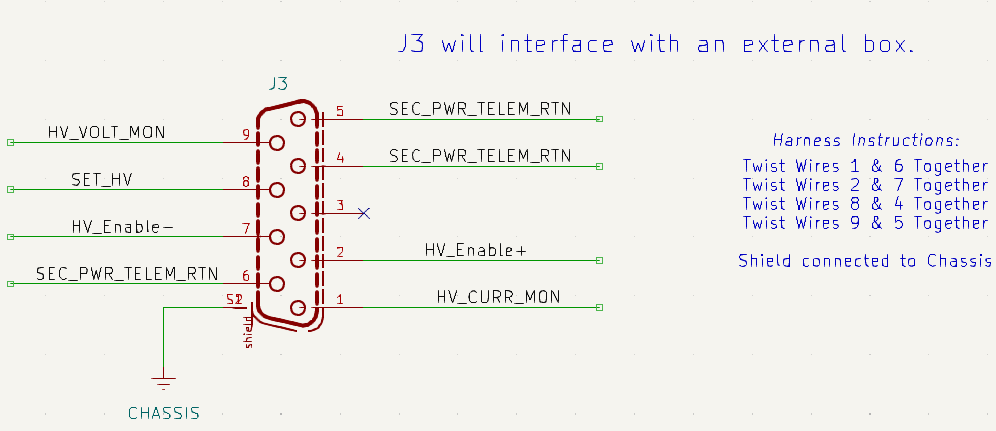
[picture p122: figure]

## Grounding Configuration

SiPM Telemetry
Power Board

SiPM Power
Board

V12V_RTN

+12VRTN

+12VIN

=

=

+5VRTN

+5VIN

SiPMBias_RTN

+12VIN

J1

49.9k

=

SiPMBias_RTN

SiPMBias

+12VRTN

J2

=

## Layout Review of SiPM Bias Board

## Layer Definition and Stack-Up

- 6 – Layer Board
  - Layer 1: Routing
  - Layer 2: Secondary Power RTN
  - Layer 3: Power Rails (+5V, +3.3V)
  - Layer 4: Routing
  - Layer 5: Secondary Power RTN
  - Layer 6: Chassis GND

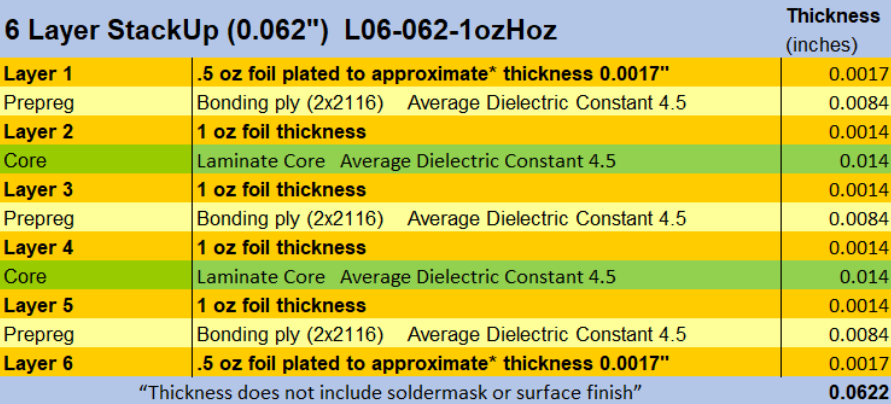
[picture p123: figure]

Board Fab House: Sunstone Circuits
Standard 6-Layer Stack up
Not expecting high currents or any high-speed signals

## Schematic Review of SiPM Telemetry Power Board

## Schematic of DC-DC Converter

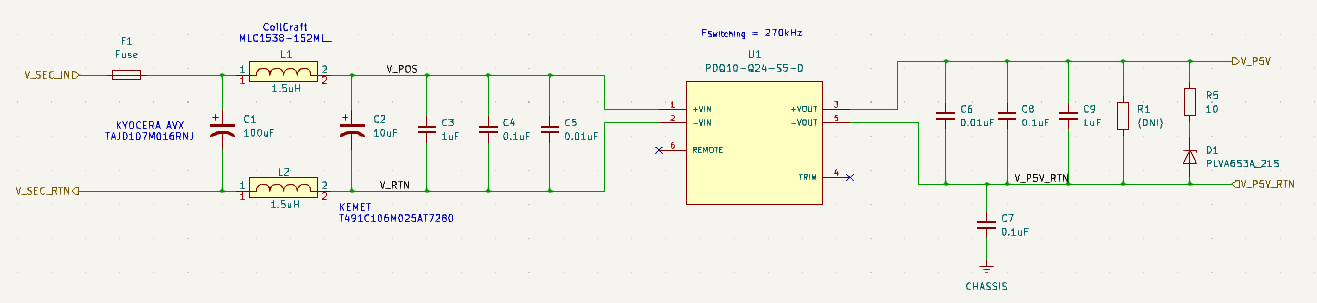
[picture p124: figure]

PDQ10-Q24-S5-D is manufactured by CUI
Used these extensively on COM-PAIR. No issues were seen.

## Impedance and Cutoff Frequency of Input Filter

- Some Calculations:

Z_(IN_(min)) =(0.85(12V)^2)/(10W)=12.24Ω

Impedances

Z_(Out) ≈0.548Ω

L_(Total) =3μH

C_(Total) =10μF

f_c =1/(2(π)√(LC))=29.1kHz

(f_(sw) =240kHz)

Frequency

## LED Power Indicator

- Useful to have a visual indicator if the board is working as designed.
  - LED will turn on if the +5V is being generated.

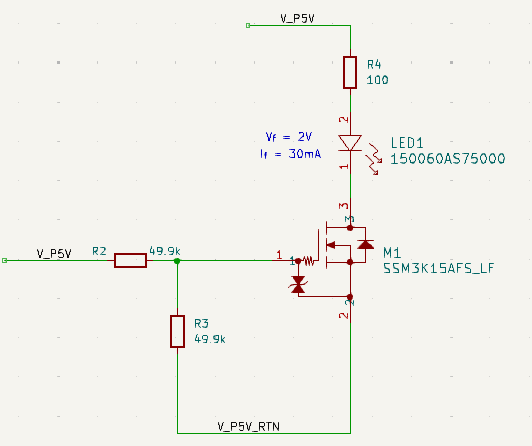
[picture p125: figure]

## Input Current and Power Calculations

- PDQ10-Q24-S5-D
  - The load from a single SiPM HV Board is ~ 52mA
    - There are 9 SiPM Boards
    - Total Current is ~ 470mA

P_(OUT) =(5V)(0.47A)=2.35W

P_(IN) =(P_(OUT))/η=(2.35W)/(80%)=2.94W

i_(IN) =(2.94W)/(12V)=245mA

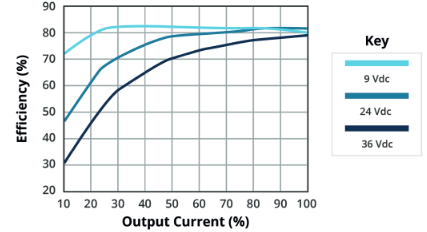
[picture p126: figure]

Combine this with SiPM HV Board Current:
Total Current Draw: 1.243A Total , 12V
14.92Watts

≈23.5%

## Layout Review of SiPM Telemetry Power Board

## Layer Definition and Stack-Up

- 6 – Layer Board
  - Layer 1: Routing
  - Layer 2: Secondary Power RTN
  - Layer 3: Secondary Power Rail (+12VIN)
  - Layer 4: Secondary Power Rail (+5VRTN)
  - Layer 5: Secondary Power RTN
  - Layer 6: Chassis GND

Board Fab House: Sunstone Circuits
Standard 6-Layer Stack up
Not expecting high currents or any high-speed signals
