rjridle/GRAMS/2_Schematics_and_Layout/1_COLD_TPC/3_COLD_TPC_Telem_PM5V_PDU/Quote/rjridle_3_COLD_TPC_Telem_PM5V_PDU Board _ CircuitHub.pdf

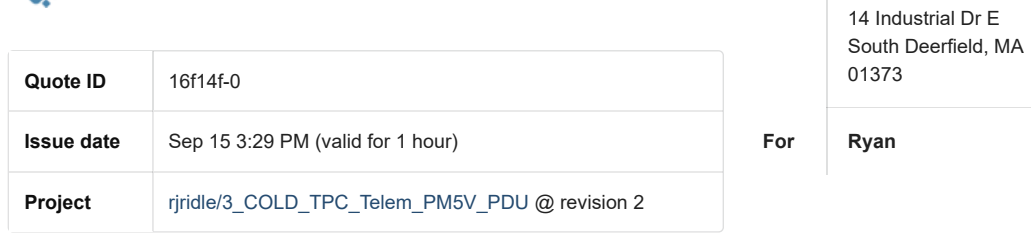
[picture p127: figure]
Quote ID; Project; rjridle/3_COLD_TPC_Telem_PM5V_PDU @ revision 2; 14 Industrial Dr E South Deerfield, MA 01373; For; Ryan

# 2 unit(s) of rjridle/3_COLD_TPC_Telem_PM5V_PDU to ship in 14 business days

Description | Quantity | Unit cost | Line cost
PCBs | 2 | $372.44 | $744.88
Parts | 2 | $197.69 | $395.38
Assembly | 2 | $256.41 | $512.82
Firmware | 2 | $0.00 | $0.00
Processing fee | | $0.00 | $0.00
Shipping (Ground) | | $14.18 | $14.18
Sales tax | | $0.00 | $0.00
| | Total | $1,667.26

# Details

Issue date | Sep 15 3:29 PM (valid for 1 hour)
From | CircuitHub
CircuitHub, Inc.

## PCB

Layers | 6
Dimensions | 127.05mm x 101.65mm

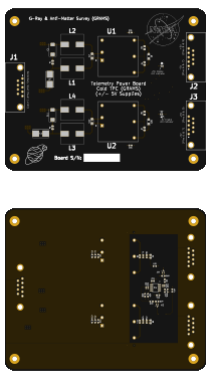
[picture p128: figure]

Min trace | 0.2mm
Min pitch | 0.2mm
Min hole | -mm
Blind/Buried holes | 0
Surface finish | ENIG
Soldermask | black
Silkscreen | white
Stackup | No custom stackup specified Standard stackups (http://docs.circuithub.com/board-specifications/standard-stackups)
Total thickness | 1.6mm

## Assembly & Parts

- 22 part(s) to be purchased and fitted
- 0 part(s) to be consigned (not purchased) and fitted
- 54 location(s) to be fitted

### Terms & Conditions

Quote is based on the information specified in this invoice.
Unless otherwise agreed to, these are the exact specifications that are to be built. All specifications listed in this invoice will override those specified in the original design files.
This invoice can be amended by additional requests, agreed to by Circuithub, on the order page. Further charges may apply. See further terms & conditions. (http://docs.circuithub.com/miscellaneous/terms-and-conditions)
Placing an order with CircuitHub signifies that you agree to all terms & conditions listed here.
Outer copper | 1 oz
Inner copper | 1 oz
Material | FR4 with TG130-135
Unique designs | 0
Cutouts | None
Via in pad | Fill not required
Impedance control | No impedance control specified
Custom requirements | No additional custom requirements specified
