rjridle/GRAMS/2_Schematics_and_Layout/1_COLD_TPC/4_COLD_TPC_SiPM_Pre_Amp/Quote/SiPM_Pre-Amp_Quote.pdf

# Saved Quote Detail

## Quote Info

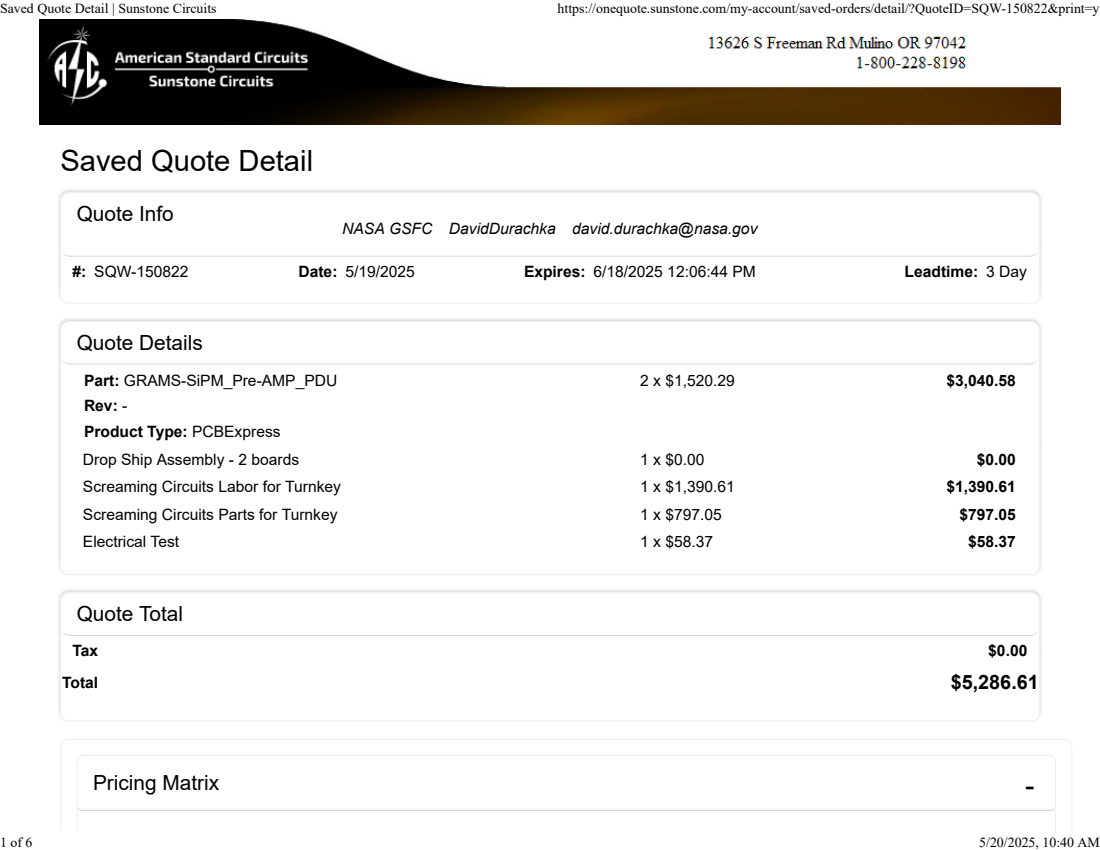
[picture p129: page 1]
#: SQW-150822; Date: 5/19/2025; Expires: 6/18/2025 12:06:44 PM; Leadtime: 3 Day; Quote Details; Drop Ship Assembly - 2 boards; Screaming Circuits Labor for Turnkey; Screaming Circuits Parts for Turnkey; Electrical Test; Quote Total; Tax; Total; Pricing Matrix; Saved Quote Detail | Sunstone Circuits; https://onequote.sunstone.com/my-account/saved-orders/detail/?QuoteID=SQW-150822&print=y

NASA GSFC DavidDurachka david.durachka@nasa.gov

Part: GRAMS-SiPM_Pre-AMP_PDU
Rev: -
Product Type: PCBExpress

Estimated shipping dates are based on an order date of "5/19/2025 " placed prior to cut off time.

*Electrical test charges are calculated from quantity and build time selections.
*Different quantity and build time selections will change the cost of the Electrical Test service.

QTY

1 Day
Wed May 21

2 Day
Thu May 22

3 Day
Fri May 23

4 Day
Tue May 27

1 Week
Wed May 28

2 Week
Wed Jun 04

3 Week
Wed Jun 11
ETest
2 | $2754.85 | $1950.41 | $1520.29 | $1307.73 | $1037.91 | $920.54 | $872.59 | $ 58.37
4 | $1455.77 | $1030.59 | $803.24 | $690.89 | $548.28 | $486.24 | $460.89 | $ 66.75
10 | $713.82 | $505.10 | $393.49 | $338.34 | $268.33 | $237.88 | $225.44 | $ 91.87
50 | $275.11 | $194.55 | $151.47 | $130.18 | $103.16 | $91.41 | $86.60 | $ 259.33

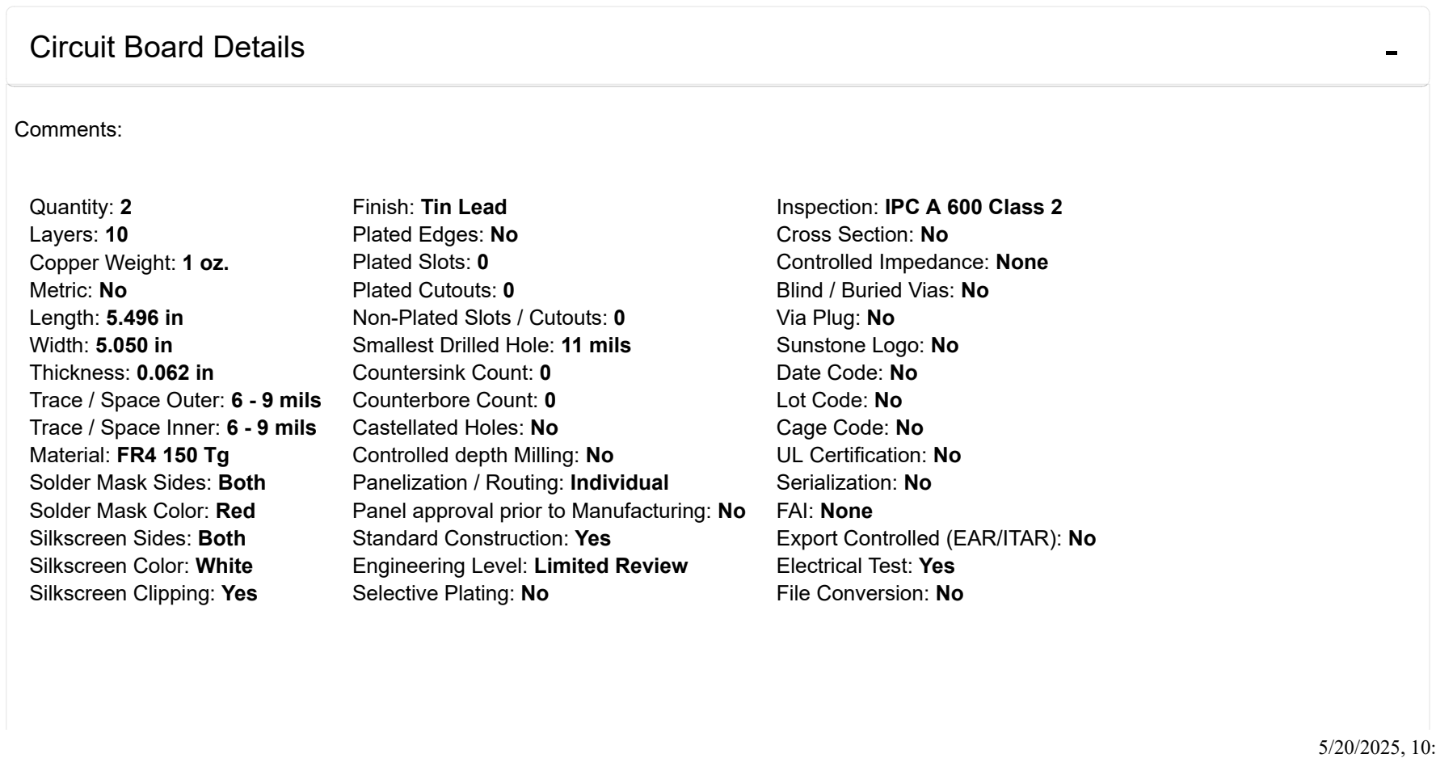
[picture p130: figure]
Comments:; Quantity: 2 Layers: 10 Copper Weight: 1 oz. Metric: No Length: 5.496 in Width: 5.050 in Thickness: 0.062 in Trace / Space Outer: 6 - 9 mils Trace / Space Inner: 6 - 9 mils Material: FR4 150 Tg Solder Mask Sides: Both Solder Mask Color: Red Silkscreen Sides: Both Silkscreen Color: White Silkscreen Clipping: Yes; Finish: Tin Lead Plated Edges: No Plated Slots: 0 Plated Cutouts: 0 Non-Plated Slots / Cutouts: 0 Smallest Drilled Hole: 11 mils Countersink Count: 0 Counterbore Count: 0 Castellated Holes: No Controlled depth Milling: No Panelization / Routing: Individual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

Panel approval prior to Manufacturing: No

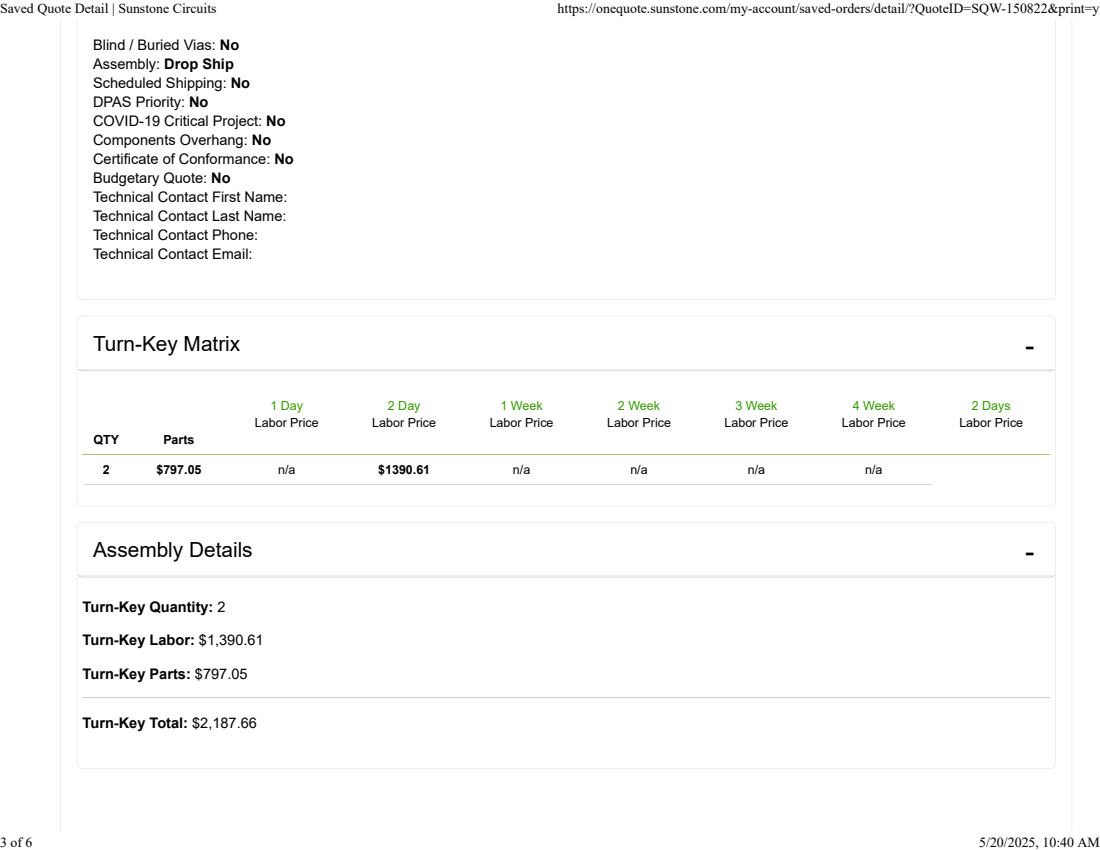
[picture p131: page 3]
QTY; Parts; 1 Day Labor Price; 2 Day Labor Price; 1 Week Labor Price; 2 Week Labor Price; 3 Week Labor Price; 4 Week Labor Price; 2 Days Labor Price; Turn-Key Matrix; Assembly Details

Blind / Buried Vias: No
Assembly: Drop Ship
Scheduled Shipping: No
DPAS Priority: No
COVID-19 Critical Project: No
Components Overhang: No
Certificate of Conformance: No
Budgetary Quote: No
Technical Contact First Name:
Technical Contact Last Name:
Technical Contact Phone:
Technical Contact Email:

Turn-Key Quantity: 2

Turn-Key Labor: $1,390.61

Turn-Key Parts: $797.05

Turn-Key Total: $2,187.66

SQW-150822-202551912648801-20250515011053-GRAMS_COLD_TPC_SiPM_Pre-AMP_PDUzip.zip

2 - COLD_TPC_P25M5-B_Paste.gbr | 3.2KB | 5/15/2025 4:07 PM | 2 - COLD_TPC_P25M5-B_Silkscreen.gbr | 36.4KB | 5/15/2025 4:07 PM
2 - COLD_TPC_P25M5-Edge_Cuts.gbr | 1.1KB | 5/15/2025 4:07 PM | 2 - COLD_TPC_P25M5-F_Cu.gbr | 63.5KB | 5/15/2025 4:07 PM
2 - COLD_TPC_P25M5-F_Mask.gbr | 13.9KB | 5/15/2025 4:07 PM | 2 - COLD_TPC_P25M5-F_Paste.gbr | 10.6KB | 5/15/2025 4:07 PM
2 - COLD_TPC_P25M5-F_Silkscreen.gbr | 295.8KB | 5/15/2025 4:07 PM | 2 - COLD_TPC_P25M5-In1_Cu.gbr | 266.2KB | 5/15/2025 4:07 PM
2 - COLD_TPC_P25M5-In2_Cu.gbr | 372.7KB | 5/15/2025 4:07 PM | 2 - COLD_TPC_P25M5-In3_Cu.gbr | 137.3KB | 5/15/2025 4:07 PM
2 - COLD_TPC_P25M5-In4_Cu.gbr | 20.6KB | 5/15/2025 4:07 PM | 2 - COLD_TPC_P25M5-In5_Cu.gbr | 20.5KB | 5/15/2025 4:07 PM
2 - COLD_TPC_P25M5-In6_Cu.gbr | 81.9KB | 5/15/2025 4:07 PM | 2 - COLD_TPC_P25M5-In7_Cu.gbr | 17.6KB | 5/15/2025 4:07 PM
2 - COLD_TPC_P25M5-In8_Cu.gbr | 266.2KB | 5/15/2025 4:07 PM | 2 - COLD_TPC_P25M5-job.gbrjob | 6.4KB | 5/15/2025 4:07 PM
2 - COLD_TPC_P25M5-NPTH.drl | 786B | 5/15/2025 4:07 PM | 2 - COLD_TPC_P25M5-NPTH-drl_map.gbr | 29.8KB | 5/15/2025 4:07 PM
2 - COLD_TPC_P25M5-PTH.drl | 7.7KB | 5/15/2025 4:07 PM | 2 - COLD_TPC_P25M5-PTH-drl_map.gbr | 192.3KB | 5/15/2025 4:07 PM
GRAMS_COLD_TPC_SiPM_Pre-AMP_PDU.cad | 140.3KB | 5/15/2025 4:06 PM | GRAMS_COLD_TPC_SiPM_Pre-AMP_PDU_BOM.xlsx | 15.6KB | 5/15/2025 4:05 PM
2 - COLD_TPC_P25M5-B_Cu.gbr | 675.1KB | 5/15/2025 4:07 PM | 2 - COLD_TPC_P25M5-B_Mask.gbr | 6.5KB | 5/15/2025 4:07 PM

© 2025 ASC Sunstone Circuits LLC. All Rights Reserved.
