rjridle/GRAMS/2_Schematics_and_Layout/1_COLD_TPC/5_COLD_TPC_Charge_Pre_Amp/Quote/Cold_TPC_Charge_Pre-Amp-PDU_Quote.pdf

# Saved Quote Detail

## Quote Info

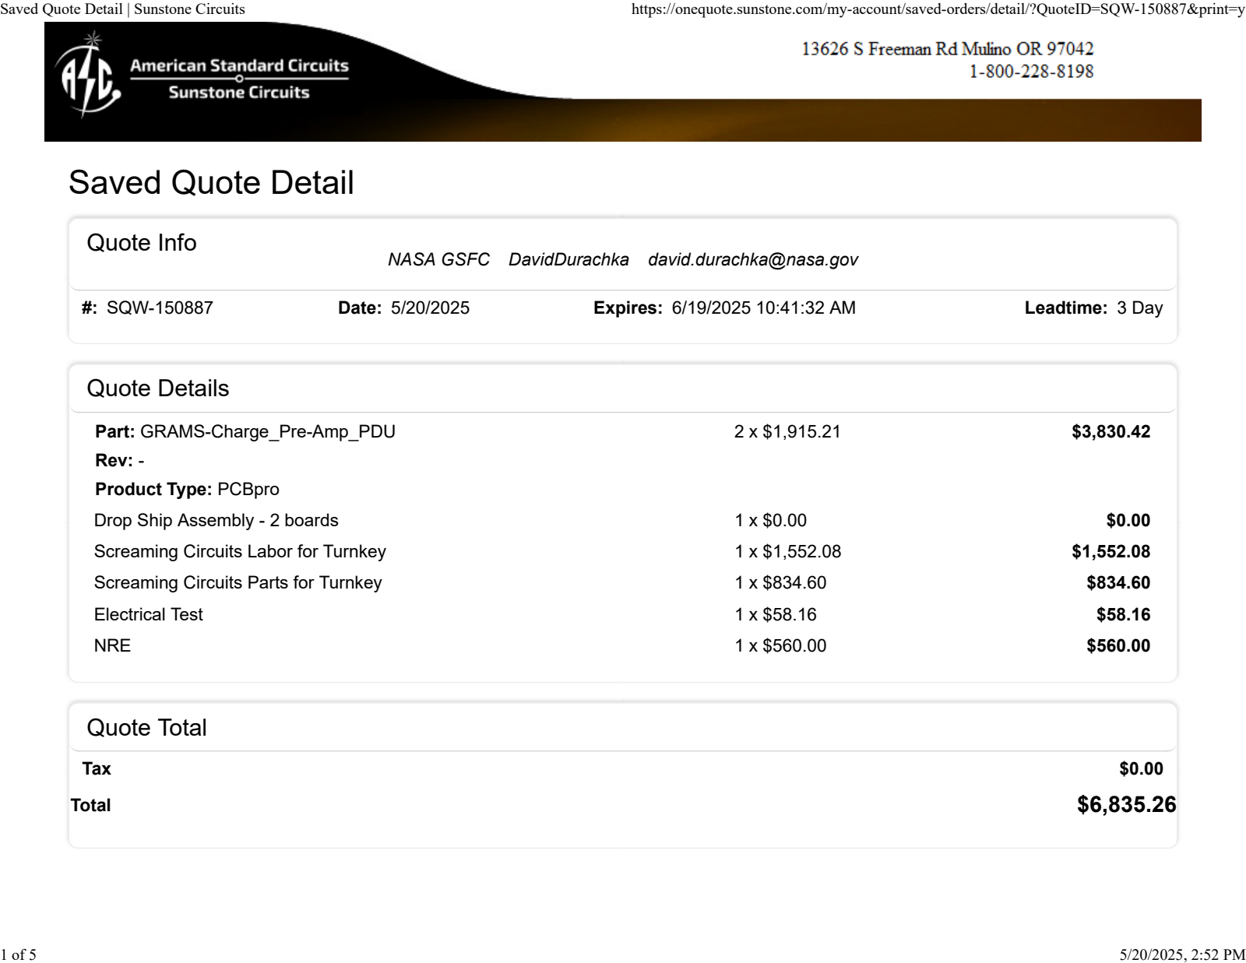
[picture p132: page 1]

#: SQW-150887 | Date: 5/20/2025 | Expires: 6/19/2025 10:41:32 AM | Leadtime: 3 Day

NASA GSFC DavidDurachka david.durachka@nasa.gov

## Quote Details

Part: GRAMS-Charge_Pre-Amp_PDU Rev: -
Product Type: PCBpro
2 x $1,915.21 | $3,830.42
Drop Ship Assembly - 2 boards | 1 x $0.00 | $0.00
Screaming Circuits Labor for Turnkey | 1 x $1,552.08 | $1,552.08
Screaming Circuits Parts for Turnkey | 1 x $834.60 | $834.60
Electrical Test | 1 x $58.16 | $58.16
NRE | 1 x $560.00 | $560.00

## Quote Total

Tax | | $0.00
Total | | $6,835.26
Saved Quote Detail | Sunstone Circuits | https://onequote.sunstone.com/my-account/saved-orders/detail/?QuoteID=SQW-150887&print=y
1 of 5 | 5/20/2025, 2:52 PM

Estimated shipping dates are based on an order date of "5/20/2025 " placed prior to cut off time.

*Electrical test charges are calculated from quantity and build time selections.
*Different quantity and build time selections will change the cost of the Electrical Test service.

QTY

1 Day
Wed May 21

2 Day
Thu May 22

3 Day
Fri May 23

4 Day
Tue May 27

1 Week
Wed May 28

2 Week
Wed Jun 04

3 Week
Wed Jun 11
ETest
2 | Custom | $3061.01 | $1915.21 | $1656.00 | $1398.92 | $1106.24 | $913.97 | $ 58.16
4 | Custom | $1611.10 | $1007.94 | $871.49 | $736.16 | $582.09 | $480.88 | $ 66.33
10 | Custom | $741.16 | $463.58 | $400.78 | $338.51 | $267.60 | $221.02 | $ 90.82
50 | Custom | $277.19 | $173.25 | $149.74 | $126.42 | $99.87 | $82.43 | $ 254.12
Pricing Matrix | -

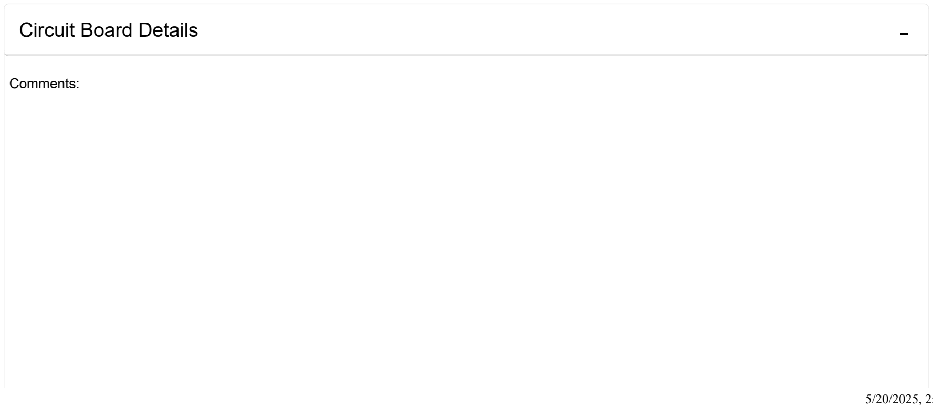
[picture p133: figure]
Comments:; Circuit Board Details

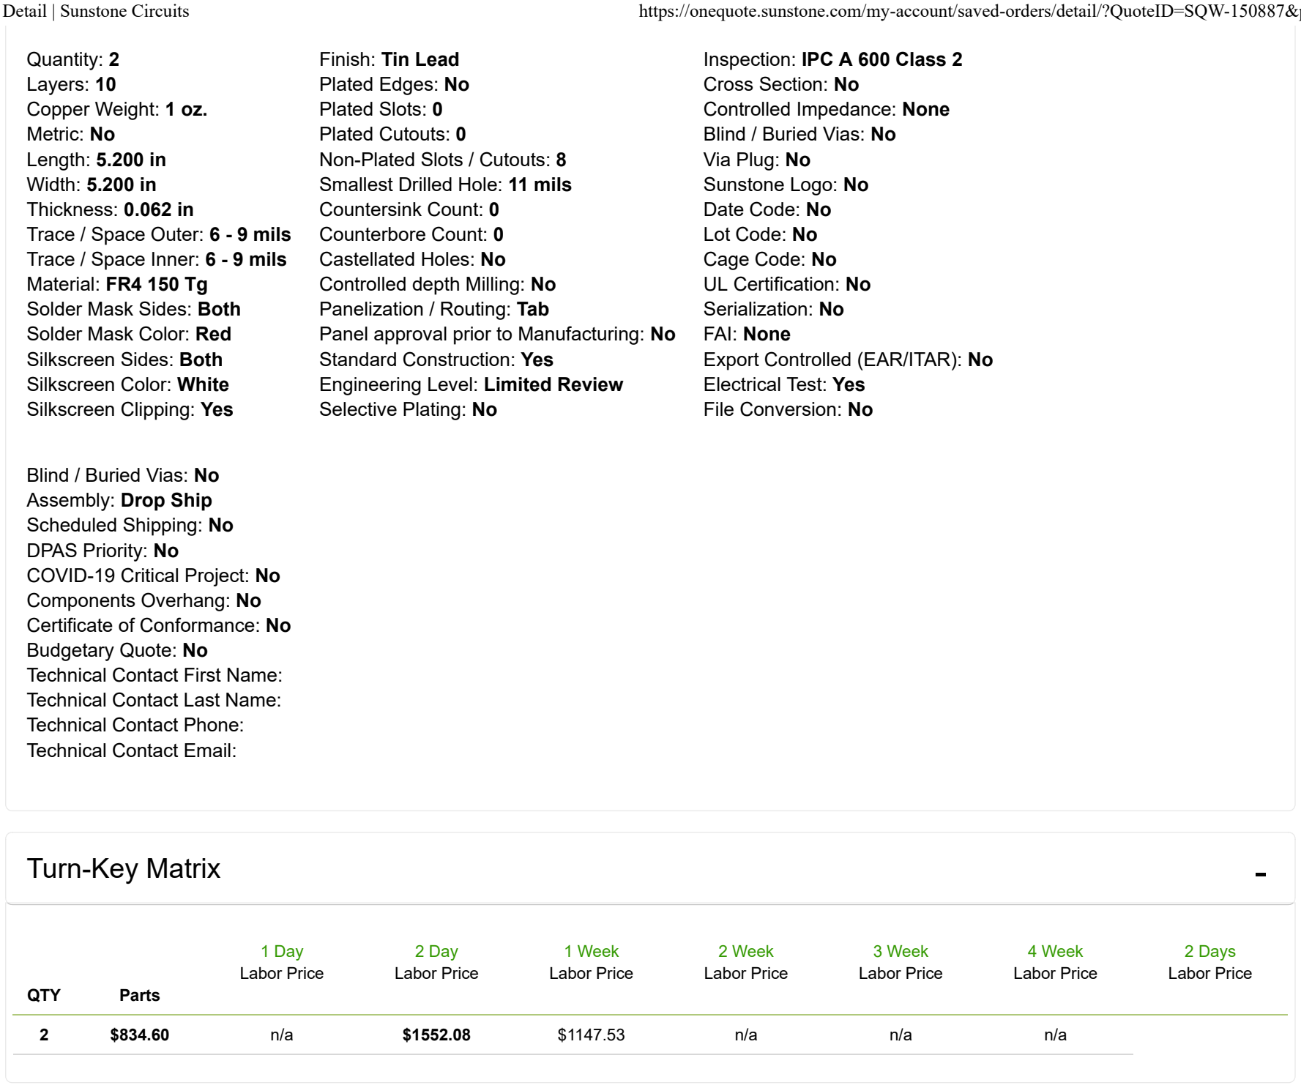
[picture p134: figure]
Quantity: 2 Layers: 10 Copper Weight: 1 oz. Metric: No Length: 5.200 in Width: 5.200 in Thickness: 0.062 in Trace / Space Outer: 6 - 9 mils Trace / Space Inner: 6 - 9 mils Material: FR4 150 Tg Solder Mask Sides: Both Solder Mask Color: Red Silkscreen Sides: Both Silkscreen Color: White Silkscreen Clipping: Yes; Finish: Tin Lead Plated Edges: No Plated Slots: 0 Plated Cutouts: 0 Non-Plated Slots / Cutouts: 8 Smallest Drilled Hole: 11 mils Countersink Count: 0 Counterbore Count: 0 Castellated Holes: No Controlled depth Milling: No Panelization / Routing: Tab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

Panel approval prior to Manufacturing: No

Assembly Details | -

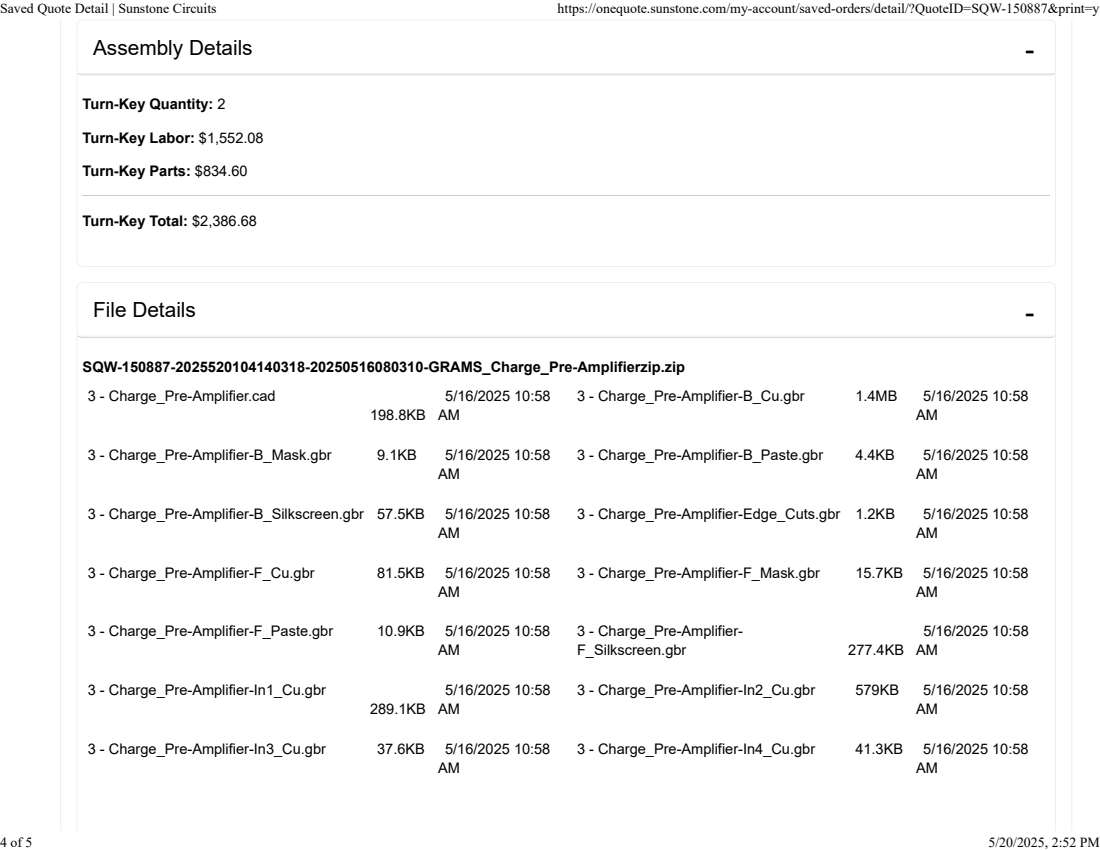
[picture p135: page 4]
File Details

Turn-Key Quantity: 2

Turn-Key Labor: $1,552.08

Turn-Key Parts: $834.60

Turn-Key Total: $2,386.68

SQW-150887-2025520104140318-20250516080310-GRAMS_Charge_Pre-Amplifierzip.zip

3 - Charge_Pre-Amplifier.cad | 198.8KB | 5/16/2025 10:58 AM | 3 - Charge_Pre-Amplifier-B_Cu.gbr | 1.4MB | 5/16/2025 10:58 AM

3 - Charge_Pre-Amplifier-B_Mask.gbr | 9.1KB | 5/16/2025 10:58 AM | 3 - Charge_Pre-Amplifier-B_Paste.gbr | 4.4KB | 5/16/2025 10:58 AM

3 - Charge_Pre-Amplifier-B_Silkscreen.gbr | 57.5KB | 5/16/2025 10:58 AM | 3 - Charge_Pre-Amplifier-Edge_Cuts.gbr | 1.2KB | 5/16/2025 10:58 AM

3 - Charge_Pre-Amplifier-F_Cu.gbr | 81.5KB | 5/16/2025 10:58 AM | 3 - Charge_Pre-Amplifier-F_Mask.gbr | 15.7KB | 5/16/2025 10:58 AM

3 - Charge_Pre-Amplifier-F_Paste.gbr | 10.9KB | 5/16/2025 10:58 AM | 3 - Charge_Pre-Amplifier-F_Silkscreen.gbr | 277.4KB | 5/16/2025 10:58 AM

3 - Charge_Pre-Amplifier-In1_Cu.gbr | 289.1KB | 5/16/2025 10:58 AM | 3 - Charge_Pre-Amplifier-In2_Cu.gbr | 579KB | 5/16/2025 10:58 AM

3 - Charge_Pre-Amplifier-In3_Cu.gbr | 37.6KB | 5/16/2025 10:58 AM | 3 - Charge_Pre-Amplifier-In4_Cu.gbr | 41.3KB | 5/16/2025 10:58 AM

© 2025 ASC Sunstone Circuits LLC. All Rights Reserved.

3 - Charge_Pre-Amplifier-In5_Cu.gbr | 39.5KB | 5/16/2025 10:58 AM | 3 - Charge_Pre-Amplifier-In6_Cu.gbr | 310.1KB | 5/16/2025 10:58 AM
3 - Charge_Pre-Amplifier-In7_Cu.gbr | 711.7KB | 5/16/2025 10:58 AM | 3 - Charge_Pre-Amplifier-In8_Cu.gbr | 289.1KB | 5/16/2025 10:58 AM
3 - Charge_Pre-Amplifier-job.gbrjob | 6.5KB | 5/16/2025 10:58 AM | 3 - Charge_Pre-Amplifier-NPTH.drl | 800B | 5/16/2025 10:58 AM
3 - Charge_Pre-Amplifier-NPTH-drl_map.gbr | 30KB | 5/16/2025 10:58 AM | 3 - Charge_Pre-Amplifier-PTH.drl | 16.1KB | 5/16/2025 10:58 AM
3 - Charge_Pre-Amplifier-PTH-drl_map.gbr | 287KB | 5/16/2025 10:58 AM | Charge_Pre-Amplifier_BOM.xlsx | 17.6KB | 5/16/2025 10:57 AM
