rjridle/GRAMS/3_Documentation/PGRAMS_2025May06.pdf

# pGRAMS Electronics Meeting #XX

# 2025 MAY 06

1

# pGRAMS Electronics Meeting

# BayCat (Hub Computer) I/Os

### 1 Intel Atom “Bay Trail” Processor

Up to 1.9 GHz clock rate. Quad, dual or single core options. Low power consumption.

### 2 High-performance Video

Integrated Intel Gen 7 graphics core supports DirectX 11, OpenGL 4, and H.264, MPEG-2 encoding/decoding. Analog VGA (2a) and mini DisplayPort video output (2b); both outputs support multiple display modes including Extended Desktop and Clone.

### 3 Trusted Platform Module (on back side)

On-board TPM security chip can lock out unauthorized hardware and software

### 4 RAM (on back side)

Up to 8 GB DDR3L socketed memory
(one SO-DIMM).

### 5 Network

Dual Ethernet interfaces, autodetect 10BaseT / 100BaseTX / 1000BaseT with remote boot support.

### 6 Industrial I/O

One USB 3.0 port (6a on back side); Dual RS-232/422/485 serial ports (6b); four USB 2.0 ports support keyboard, mouse, and other devices, three 8254 timer/counters, I²

C, and audio support (6c).

### 7 Digital I/O

Twenty-four 3.3V digital I/O lines.

### 8 SATA

3 Gb/s SATA port. Supports rotating or solid state SATA drive.

### 9 Mini PCIe socket

Supports Wi-Fi modems, GPS receivers, flash data storage with auto-detect mSATA flash storage support, and other mini PCIe modules.

### 10 MicroSD Socket

Supports removable microSD card solid-state drives.
12

11

10 9

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
### 11 SPI Interface

Supports SPI and SPX devices, including low cost analog and digital modules.

### 12 Main Power Input

5V Input ±5%

### 13 PC/104 Expansion (on back side)

Legacy PCI connector, stack-down

### 14 PC/104 Expansion (on back side)

Legacy ISA connector, stack-down

### Industrial Temperature

-40° to +85°C operation for harsh environments

### PC/104 Form Factor

Industry-standard PC/104-Plus expansion

### MIL-STD-202G

Qualified for high shock/vibration environments

# Features

2

# Adapter Cable (CBR-4005A)

# CBR-4005B Paddle Board

# BayCat (Hub Computer) I/Os

3

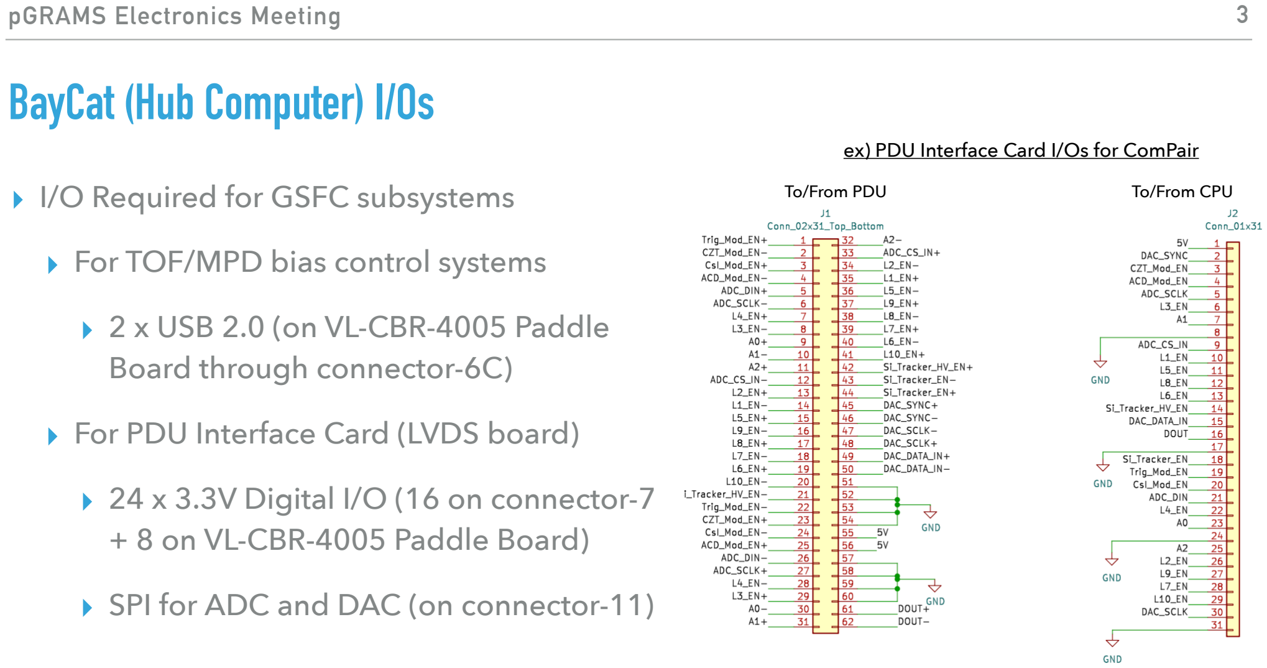
[picture p136: page 3]

# ▸ I/O Required for GSFC subsystems ▸ For TOF/MPD bias control systems ▸ 2 x USB 2.0 (on VL-CBR-4005 Paddle Board through connector-6C) ▸ For PDU Interface Card (LVDS board) ▸ 24 x 3.3V Digital I/O (16 on connector-7 + 8 on VL-CBR-4005 Paddle Board) ▸ SPI for ADC and DAC (on connector-11)

# ex) PDU Interface Card I/Os for ComPair

To/From PDU | To/From CPU

# BayCat (Hub Computer) I/Os

4

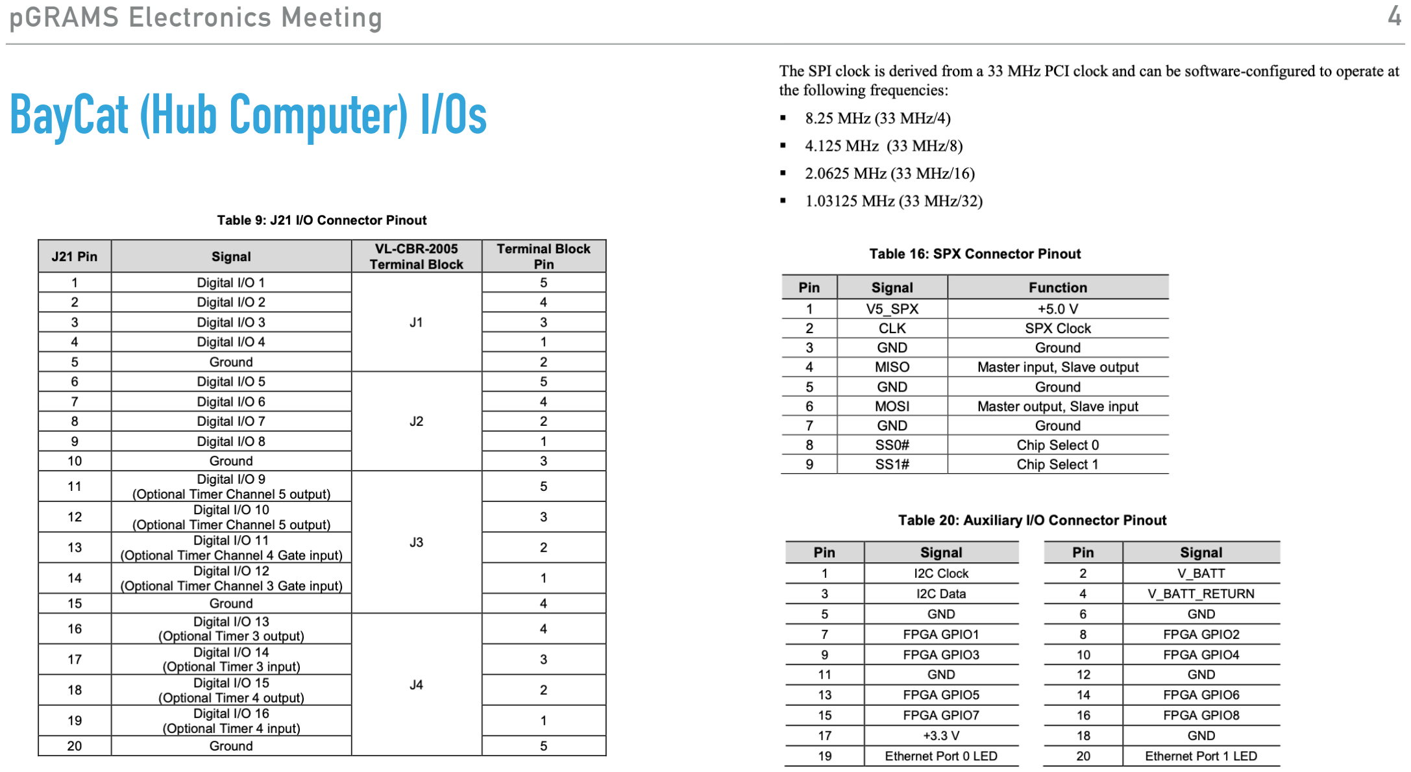
[picture p137: page 4]

# PDU Required number of Digital I/Os for pGRAMS

5

▸ Power Enable (13) 1. SiPM (6) Power EN 2. Cold TPC HV EN 3. Cold TPC Charge Pre-Amp EN 4. Cold TPC SiPM Pre-Amp EN 5. Warm TPC Shaper EN 6. CAEN - NEVIS 3.3V EN 7. CAEN - NEVIS 12V EN 8. CAEN - NEVIS +/- 5V EN 9. HUB CPU EN 10.DAQ CPU EN 11.TOF/MPD Readout +12V EN 12.TOF/MPD Bias Control +12V (+6V?) EN 13.TOF/MPD Bias DC-DC +12V (+6V?) EN

# ▸ PDU DAC MUX (3: A0 A1 A2) 1. SiPM 0 2. SiPM 1 3. SiPM 2 4. SiPM 3 5. SiPM 4 6. SiPM 5 7. TPC HV

# ▸ PDU ADC MUX (3: A0 A1 A2)

1. ???
2. ???
3. ???
4. ???
5. ???
6. ???
7. ???
