rjridle/GRAMS/1_Design_Requirements_Matrix/PDU-Requirements-Matrix_GRAMS_12-Nov-24.xlsx

Sheet: Sheet1
Power Distribution Unit - Environmental
Requirement ID | Requirement | Requirement Description | Values | Rationale | Verification (T - Test, A - Analysis, I - Inspection)
GRAMS-PDU-ENV-1 | Survive Temperature Environment | PDU Shall be able to withstand temperature variation during balloon flight | Low Temp: (-20) C High Temp: (50) C | During the Balloon Flight, the payload will be subject to temperature swings in the environment | T: Thermal Testing
GRAMS-PDU-ENV-2 | Mitigation of electrical arcing | Dimensions of layout and harnessing consistent with Paechen Law | - | Primarily for the (-10kV), in quazi-vacuum environment, high voltages can arc. | A and T: Analysis showing HV nodes if exposed are far enough apart to prevent arcing. Testing in Vacuum chamber (or Bell Jar) may be called for.
GRAMS-PDU-ENV-3 | Heat Dissipation | PDU Shall provide thermal path for waste heat | - | During the balloon flight, the efficiencies will not be 100%, waste heat from the converters will be generated, must provide thermal path for this heat to escape safely | T: Thermal Testing
Power Distribution Unit - Electrical (TOF-MPD - Time of Flight, Multi-Purpose-Detector)
Requirement ID | Requirement | Requirement Description | Values | Rationale | Verification
GRAMS-PDU-ELEC-1 | Time-of-Flight / Multi-Purpose Detector Voltage and Current Requirements | 48-Watt, 12V rail is nominal for TOF-MPD Unit | Voltage Rail: 12V Nominal Current: 4A | Values are based on data provided by the Design Team | T, A
Power Distribution Unit - Electrical (TPC - Time Projection Chamber) Cold Pre-AMP
Requirement ID | Requirement | Requirement Description | Values | Rationale | Verification
GRAMS-PDU-ELEC-2 | Time Projection Chamber Voltage and Current Requirements | 20-Watt, +/- 5V rail is nominal for TPC Unit | Voltage Rail: (+/- 5V) Nominal Current: 110mA / Channel | There are 180 Channels | T, A
GRAMS-PDU-ELEC-3 | Time Projection Chamber (-10kV Rail) | Current draw is <= 100nA | Maximum Voltage Rail is -10kV | Values are based on data provided by the Design Team | T, A
GRAMS-PDU_ELEC-4 | SiPM Pre-Amplifier Voltages and Current Requirements | +2.5 / -5V Rails for nominal performance | Voltage Rails: (+2.5 / -5V), Nominal Current: Unknown |  | T, A
Power Distribution Unit - Electrical (TPC - Warm) - SiPM Supplies
Requirement ID | Requirement | Requirement Description | Values | Rationale | Verification
GRAMS-PDU-ELEC-5 | SiPM Readout Supply | 2-Watt, +/- 2V rail is nominal for TPC Unit | Voltage Rail: (+/- 2V) Nominal Current: 0.5A | Values are based on data provided by the Design Team | T, A
GRAMS-PDU-ELEC-6 | SiPM HV Supply | 150mW, +72V rail is nominal | Voltage Rail: (72V) Nominal Current: 2mA | Values are based on data provided by the Design Team | T, A
Power Distribution Unit - Electrical (TPC - Warm) - CAEN Electronics
Requirement ID | Requirement | Requirement Description | Values | Rationale | Verification
GRAMS-PDU-ELEC-7 | +12V @ 4A |  |  |  | T, A
GRAMS-PDU-ELEC-8 | + 5V @ 5A |  |  |  | T, A
GRAMS-PDU-ELEC-9 | + 3.3V @ 10A |  |  |  | T, A
Power Distribution Unit - Electrical (TPC - Warm) - MicroBooNE Electronics
Requirement ID | Requirement | Requirement Description | Values | Rationale | Verification
GRAMS-PDU-ELEC-10 | +12V @ 2.48A |  |  | Time Protection Chamber | T, A
GRAMS-PDU-ELEC-11 | +/- 5V @ 4A |  |  | Time Protection Chamber | T, A
GRAMS-PDU-ELEC-12 | + 3.3V @ 8.49A |  |  | Time Protection Chamber | T, A
Power Distribution Unit - Electrical (Shaper Electronics)
Requirement ID | Requirement | Requirement Description | Values | Rationale | Verification
GRAMS-PDU-ELEC-13 | Shaper Electronics Voltage and Current Requirements | 3-Watt, +/- 3.3V rail is nominal | Voltage Rail: (+/- 3V) Nominal Current: 900mA | There are 6 boxes, each box houses 30 channels drawing 2.5mA each | T, A
NOTES: | These requirements assume that the PDU is providing a single or dual supply to the units described above. (i.e. not supplying a single rail for each channel)
Power Distribution Unit - Telemetry (Sub-Systems)
Requirement ID | Requirement | Requirement Description | Values | Rationale | Verification
GRAMS-PDU-TELEM-1, 2, 3… ,x | Need to understand what values need to be tracked. Currents and Voltages, be specific on what your needs are. Please go through the requirements above, don't say you want to track everything because that means it wasn't really looked at. Please review these requirements and provide comments.
Power Distribution Unit - Command (Sub-Systems)
Requirement ID | Requirement | Requirement Description | Values | Rationale | Verification
GRAMS-PDU-CMD-1, 2, 3… ,x | Need to understand the enable / disable features you would like to see. What needs to be enabled when? What do you want to turn off and on from control window?
GRAMS-PDU-CMD-(x+1) | Power-On Sequencing | This requirement describes how to power-on the PDU itself. (This will be fleshed out during design) | - | It may be necessary to power-on portions of the design before others. This to be completed as the design matures | T, A
Information from John Mitchell on 1-July-24

Sheet: Telemetry Points
Box / Board: | SiPM Box
 | TPC_Warm Telemetry Points
 |  | Name | Equation | Nominal Value
 | 1 | Positive 2 Volt Rail | Rail Voltage = V | 2V
 | 2 | Negative 2 Volt Rail | Rail Voltage = -V | 2V
 | 3 | Temperature | Temp(Kelvin) = V * 125 | 25K
 | 4 | Enable + | Enable Signal
 | 5 | Enable -
 | SiPM HV Board
 |  | Name | Equation | Nominal Value
 | 1 | HV Volt Mon | HV = V(0.0505) | 2.53V (for 50V)
 | 2 | HV Current Mon
