rjridle/GRAMS/1_Design_Requirements_Matrix/PDU-Requirements-Matrix_GRAMS_24-July_24.xlsx

Power Distribution Unit - Environmental
Requirement ID | Requirement | Requirement Description | Values | Rationale | Verification (T - Test, A - Analysis, I - Inspection)
GRAMS-PDU-ENV-1 | Survive Temperature Environment | PDU Shall be able to withstand temperature variation during balloon flight | Low Temp: (-20) C High Temp: (50) C | During the Balloon Flight, the payload will be subject to temperature swings in the environment | T: Thermal Testing
GRAMS-PDU-ENV-2 | Mitigation of electrical arcing | Dimensions of layout and harnessing consistent with Paechen Law | - | Primarily for the (-10kV), in quazi-vacuum environment, high voltages can arc. | A and T: Analysis showing HV nodes if exposed are far enough apart to prevent arcing. Testing in Vacuum chamber (or Bell Jar) may be called for.
GRAMS-PDU-ENV-3 | Heat Dissipation | PDU Shall provide thermal path for waste heat | - | During the balloon flight, the efficiencies will not be 100%, waste heat from the converters will be generated, must provide thermal path for this heat to escape safely | T: Thermal Testing
Power Distribution Unit - Electrical (TOF-MPD - Time of Flight, Multi-Purpose-Detector)
Requirement ID | Requirement | Requirement Description | Values | Rationale | Verification
GRAMS-PDU-ELEC-1 | Time-of-Flight / Multi-Purpose Detector Voltage and Current Requirements | 48-Watt, 12V rail is nominal for TOF-MPD Unit | Voltage Rail: 12V (Verify) Nominal Current: 4A (Verify) | Values are based on data provided by the Design Team | T, A
GRAMS-PDU-ELEC-2 | Power Supply Ripple Requirement | The power supply ripple shall be <= (Ripple Value) | Power Supply Ripple Requirement | This sets the ripple requirement for the supply. | T, A, I
Power Distribution Unit - Electrical (TPC - Time Projection Chamber) Cold Pre-AMP
Requirement ID | Requirement | Requirement Description | Values | Rationale | Verification
GRAMS-PDU-ELEC-3 | Time Projection Chamber Voltage and Current Requirements | 60-Watt, +/- 5V rail is nominal for TPC Unit | Voltage Rail: (+/- 5V) (Verify) Nominal Current: 6A (Verify) | Values are based on data provided by the Design Team | T, A
GRAMS-PDU-ELEC-4 | Power Supply Ripple Requirement | The power supply ripple shall be <= (Ripple Value) | Power Supply Ripple Requirement | This sets the ripple requirement for the supply. | T, A, I
Power Distribution Unit - Electrical (TPC - Warm)
Requirement ID | Requirement | Requirement Description | Values | Rationale | Verification
GRAMS-PDU-ELEC-5 | Charge Sensitive Preamplifier | 36-Watt, +/- 6V rail is nominal for TPC Unit | Voltage Rail: (+/- 6V) Nominal Current: 3A | Values are based on data provided by the Design Team | T, A
GRAMS-PDU-ELEC-6 | Power Supply Ripple Requirement for +/- 6V Rail on CSA | The power supply ripple shall be <= 1mV(RMS) | Less than or equal to 1mV rms | This sets the ripple requirement for the supply | T, A, I
GRAMS-PDU-ELEC-8 | SiPM Supply | 2-Watt, +/- 2V rail is nominal for TPC Unit | Voltage Rail: (+/- 2V) Nominal Current: 0.5A | Values are based on data provided by the Design Team | T, A
GRAMS-PDU-ELEC-7 | Power Supply Ripple Requirement for +/- 2V Rail on SiPM Power Supply | The power supply ripple shall be <= 1mV(RMS) | Less than or equal to 1mV rms | This sets the ripple requirement for the supply | T, A, I
GRAMS-PDU-ELEC-9 | SiPM HV Supply | 150mW, +72V rail is nominal | Voltage Rail: (72V) Nominal Current: 2mA | Values are based on data provided by the Design Team | T, A
GRAMS-PDU-ELEC-10 | Power Supply Ripple Requirement for +72V Rail (SiPM HV Rail) | The power supply ripple shall be <= 100uV pk-pk | Less than or equal to 0.1mV pk-pk | This sets the ripple requirement for the supply | T, A, I
GRAMS-PDU-ELEC-11 | Time Projection Chamber HV | x-Watts, 0 to -10kV | Voltage Rail: (0 to -10kV) Nominal Current: ? | Values are based on data provided by the Design Team | T, A
GRAMS-PDU-ELEC-12 | Power Supply Ripple Requirement for -10kV Rail (TPC HV Rail) | The power supply ripple shall be <= 3mV pk-pk | Less than 3mV pk-pk | This sets the ripple requirement for the supply | T, A, I
GRAMS-PDU-ELEC-13 | The TPC HV Rail shall be settable from 0 to -10kV from a control signal | A control signal shall be supplied from the command console that allows the TPC HV value to be set from 0 to -10kV | - | Conversion equation to be provided after design has been completed. | T, A, I
Power Distribution Unit - Electrical (PMT - Photo-Muiltiplier-Tubes)
Requirement ID | Requirement | Requirement Description | Values | Rationale | Verification
GRAMS-PDU-ELEC-14 | Photo Multiplier Tube Electronics Voltage and Current Requirements | 60-Watt, +/- 12V rail is nominal for TPC Unit | Voltage Rail: (+/- 12V) (Verify) Nominal Current: 2.4A (Verify) | Values are based on data provided by the Design Team | T, A
GRAMS-PDU-ELEC-15 | Power Supply Ripple Requirement for +/- 12V Rail | The power supply ripple shall be <= (Ripple Value) | Power Supply Ripple Requirement | This sets the ripple requirement for the supply | T, A, I
GRAMS-PDU-ELEC-16 |  | 13-Watt, +/- 5V rail is nominal for TPC Unit | Voltage Rail: (+/- 5V) (Verify) Nominal Current: 1.3A (Verify) | Values are based on data provided by the Design Team | T, A
GRAMS-PDU-ELEC-17 | Power Supply Ripple Requirement for +/- 5V Rail | The power supply ripple shall be <= (Ripple Value) | Power Supply Ripple Requirement | This sets the ripple requirement for the supply | T, A, I
Power Distribution Unit - Electrical (Shaper Electronics)
Requirement ID | Requirement | Requirement Description | Values | Rationale | Verification
GRAMS-PDU-ELEC-18 | Shaper Electronics Voltage and Current Requirements | 87-Watt, +/- 5V rail is nominal for TPC Unit | Voltage Rail: (+/- 5V) (Verify) Nominal Current: 8.7A (Verify) | Values are based on data provided by the Design Team | T, A
GRAMS-PDU-ELEC-19 | Power Supply Ripple Requirement for +/- 5V Rail | The power supply ripple shall be <= (Ripple Value) | Power Supply Ripple Requirement | This sets the ripple requirement for the supply | T, A, I
Power Distribution Unit - Electrical (Fill In Other Sub-Systems Here)
Requirement ID | Requirement | Requirement Description | Values | Rationale | Verification
GRAMS-PDU-ELEC-20
GRAMS-PDU-ELEC-21
GRAMS-PDU-ELEC-22
GRAMS-PDU-ELEC-23
GRAMS-PDU-ELEC-24
GRAMS-PDU-ELEC-25
GRAMS-PDU-ELEC-26
NOTES: | These requirements assume that the PDU is providing a single or dual supply to the units described above. (i.e. not supplying a single rail for each channel)
Power Distribution Unit - Telemetry (Sub-Systems)
Requirement ID | Requirement | Requirement Description | Values | Rationale | Verification
GRAMS-PDU-TELEM-1, 2, 3… ,x | Need to understand what values need to be tracked. Currents and Voltages, be specific on what your needs are. Please go through the requirements above, don't say you want to track everything because that means it wasn't really looked at. Please review these requirements and provide comments.
Power Distribution Unit - Command (Sub-Systems)
Requirement ID | Requirement | Requirement Description | Values | Rationale | Verification
GRAMS-PDU-CMD-1, 2, 3… ,x | Need to understand the enable / disable features you would like to see. What needs to be enabled when? What do you want to turn off and on from control window?
GRAMS-PDU-CMD-(x+1) | Power-On Sequencing | This requirement describes how to power-on the PDU itself. (This will be fleshed out during design) | - | It may be necessary to power-on portions of the design before others. This to be completed as the design matures | T, A
