rjridle/GRAMS/1_Design_Requirements_Matrix/DAQ_CAEN.jpg

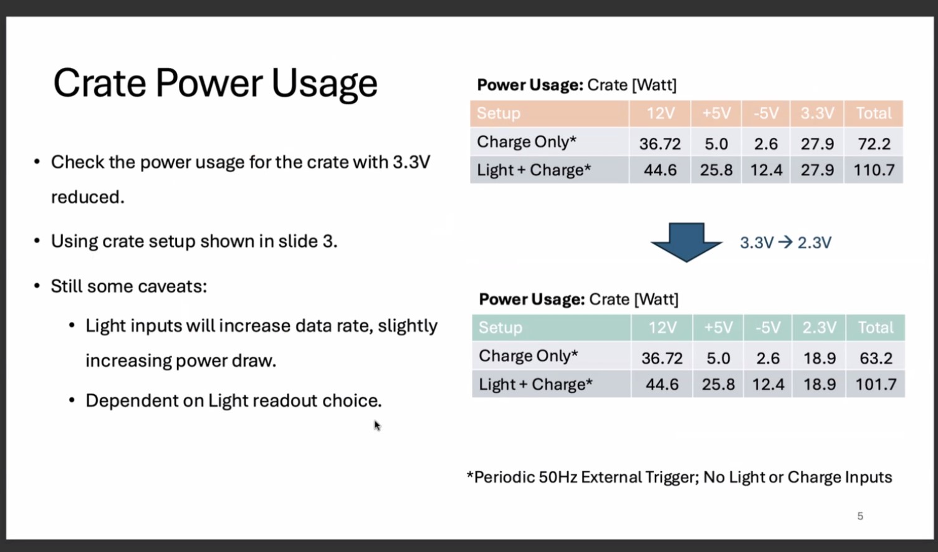
1_Design_Requirements_Matrix/DAQ_CAEN.jpg
