rjridle/GRAMS/1_Design_Requirements_Matrix/Screenshot 2024-09-09 102645.png

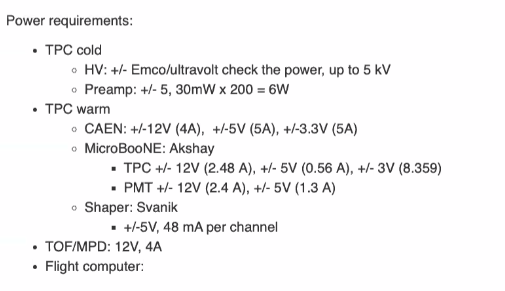
1_Design_Requirements_Matrix/Screenshot 2024-09-09 102645.png
