rjridle/GRAMS/1_Design_Requirements_Matrix/Screenshot 2024-12-09 161006.png

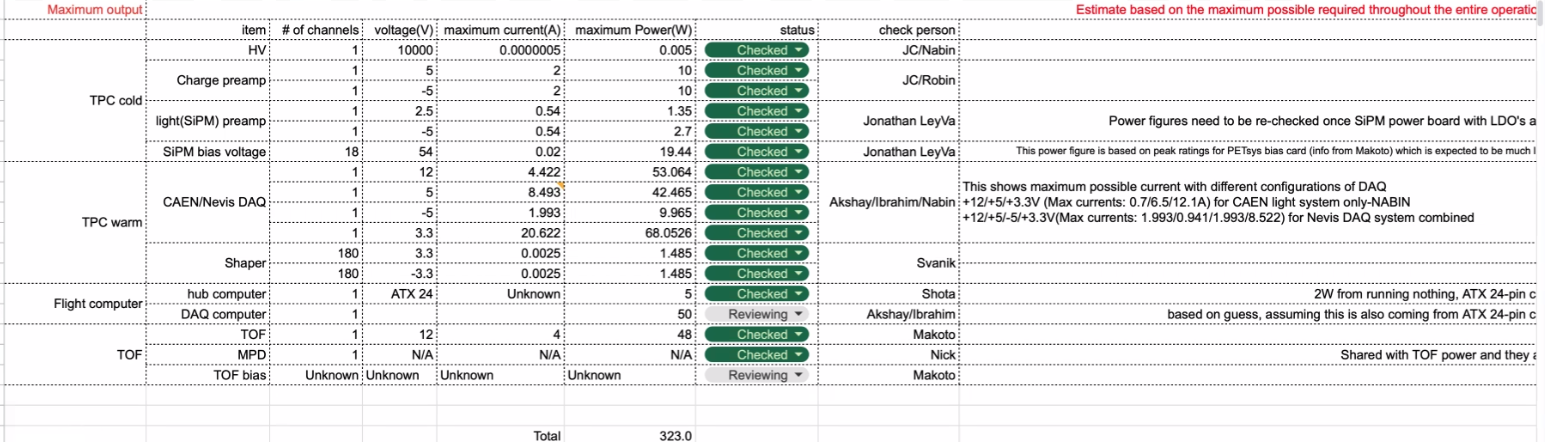
1_Design_Requirements_Matrix/Screenshot 2024-12-09 161006.png
