rjridle/GRAMS/1_Design_Requirements_Matrix/Voltage_Power_Sheet (Nov-21-24).png

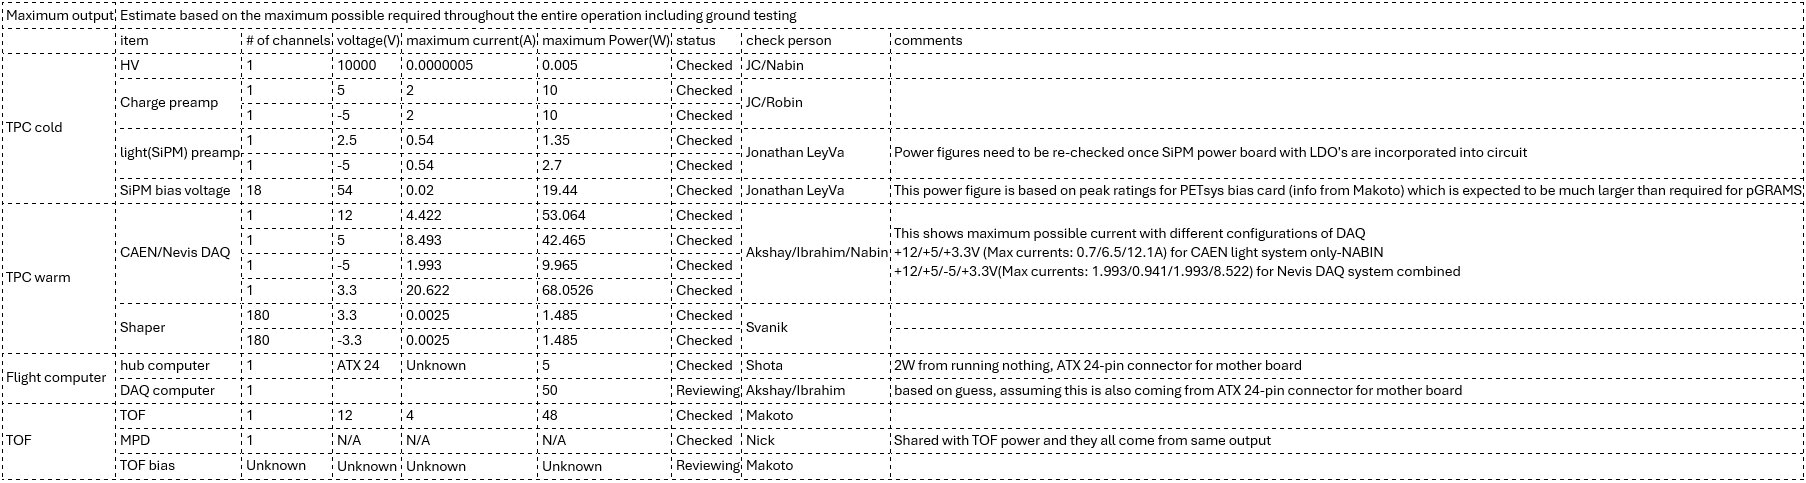
1_Design_Requirements_Matrix/Voltage_Power_Sheet (Nov-21-24).png
