rjridle/GRAMS/2_Schematics_and_Layout/100_GSE/Simulation_Folder/Stability/LC_CIRCUIT.png

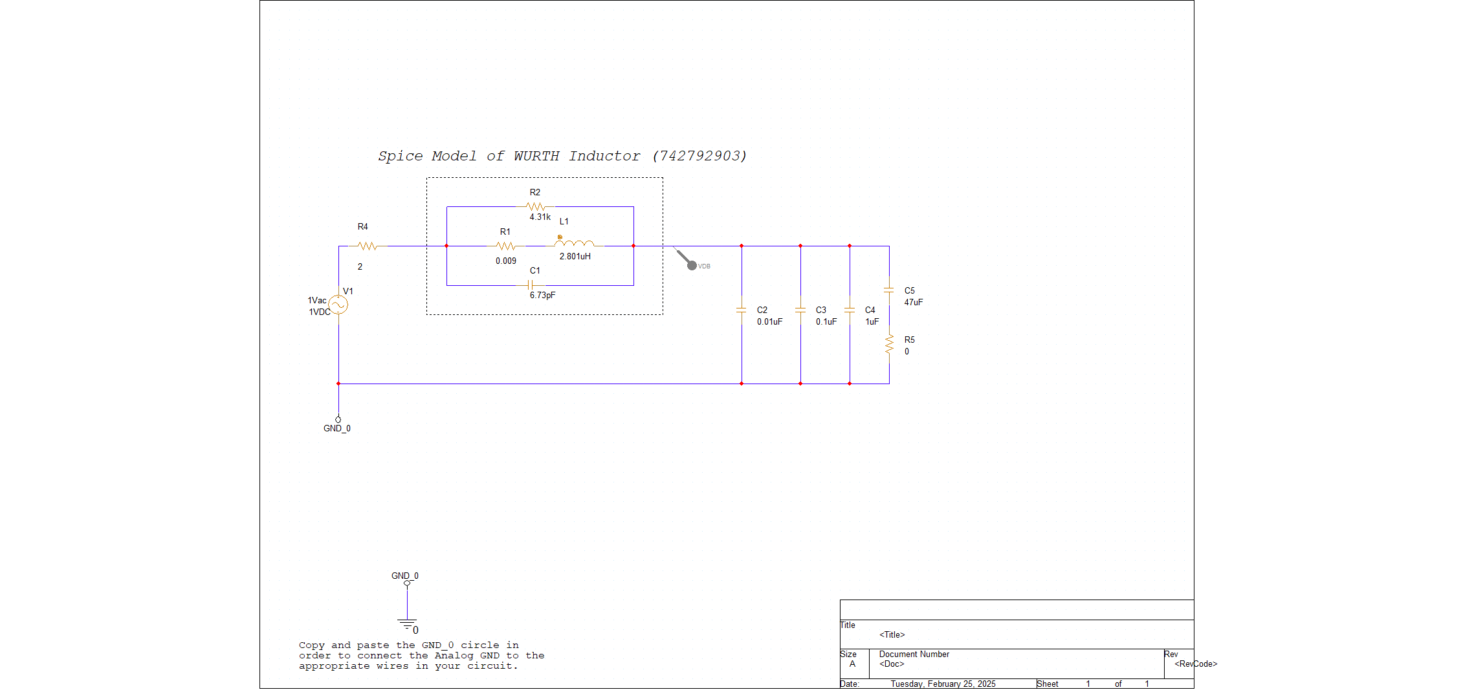
2_Schematics_and_Layout/100_GSE/Simulation_Folder/Stability/LC_CIRCUIT.png
