rjridle/GRAMS/2_Schematics_and_Layout/Images/Galaxy.png

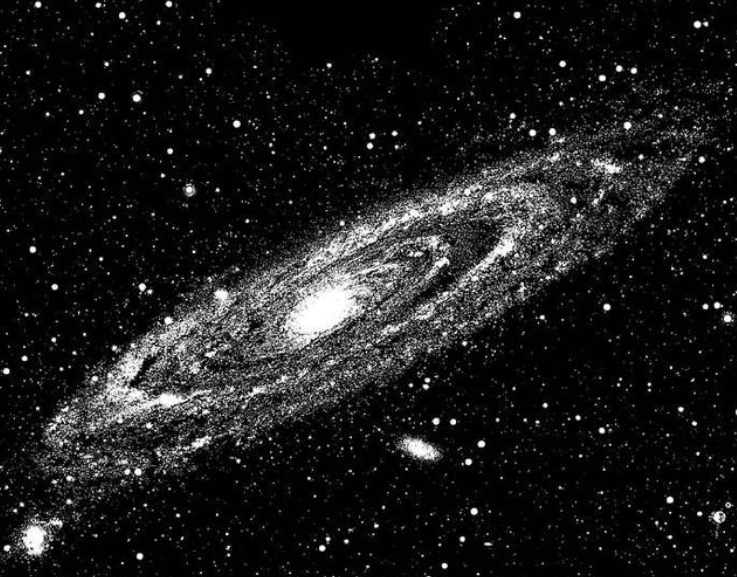
2_Schematics_and_Layout/Images/Galaxy.png
