rjridle/GRAMS/2_Schematics_and_Layout/Images/High_Voltage_Symbol.png

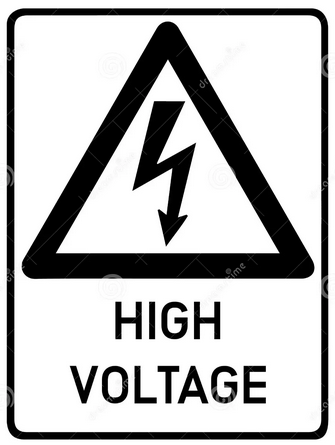
2_Schematics_and_Layout/Images/High_Voltage_Symbol.png
