rjridle/GRAMS/2_Schematics_and_Layout/Images/Moon.jpg

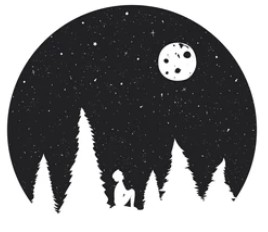
2_Schematics_and_Layout/Images/Moon.jpg
