rjridle/GRAMS/2_Schematics_and_Layout/Images/NASA_MeatBall_1.jpg

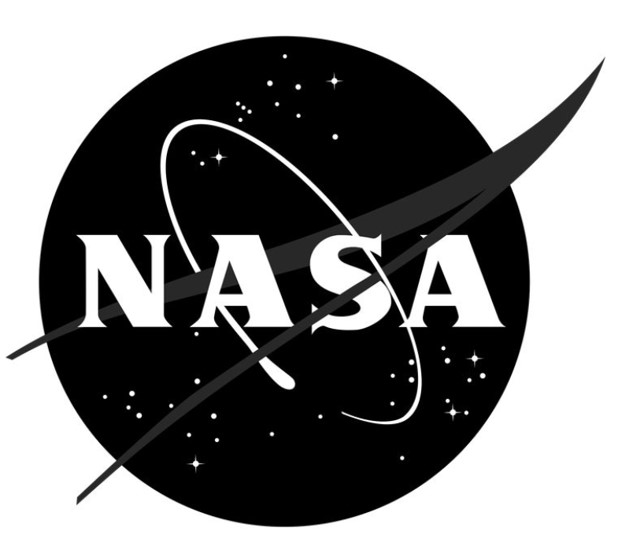
2_Schematics_and_Layout/Images/NASA_MeatBall_1.jpg
