rjridle/GRAMS/2_Schematics_and_Layout/Images/NASA_MeatBall_1.png

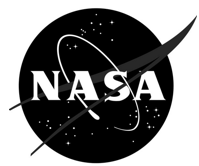
2_Schematics_and_Layout/Images/NASA_MeatBall_1.png
