rjridle/GRAMS/2_Schematics_and_Layout/Images/NASA_Meatball_10.png

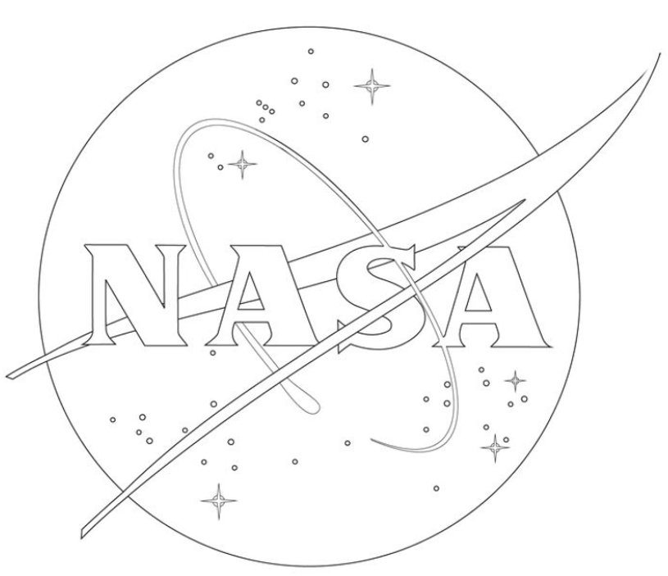
2_Schematics_and_Layout/Images/NASA_Meatball_10.png
