rjridle/GRAMS/2_Schematics_and_Layout/Images/Orbit_Image.png

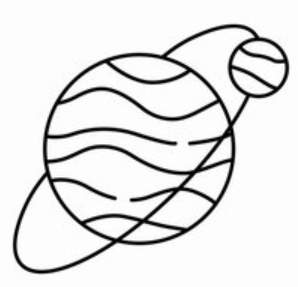
2_Schematics_and_Layout/Images/Orbit_Image.png
