rjridle/GRAMS/2_Schematics_and_Layout/Images/Small_MeatBall.png

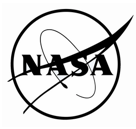
2_Schematics_and_Layout/Images/Small_MeatBall.png
