rjridle/GRAMS/2_Schematics_and_Layout/Images/Time_Of_Flight.png

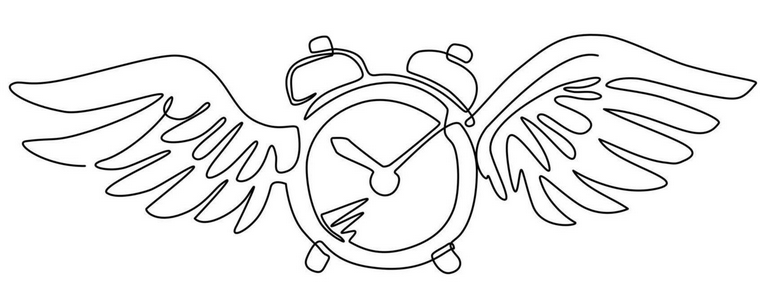
2_Schematics_and_Layout/Images/Time_Of_Flight.png
