rjridle/GRAMS/3_Documentation/pGRAMS_Block_Diagram.jpeg

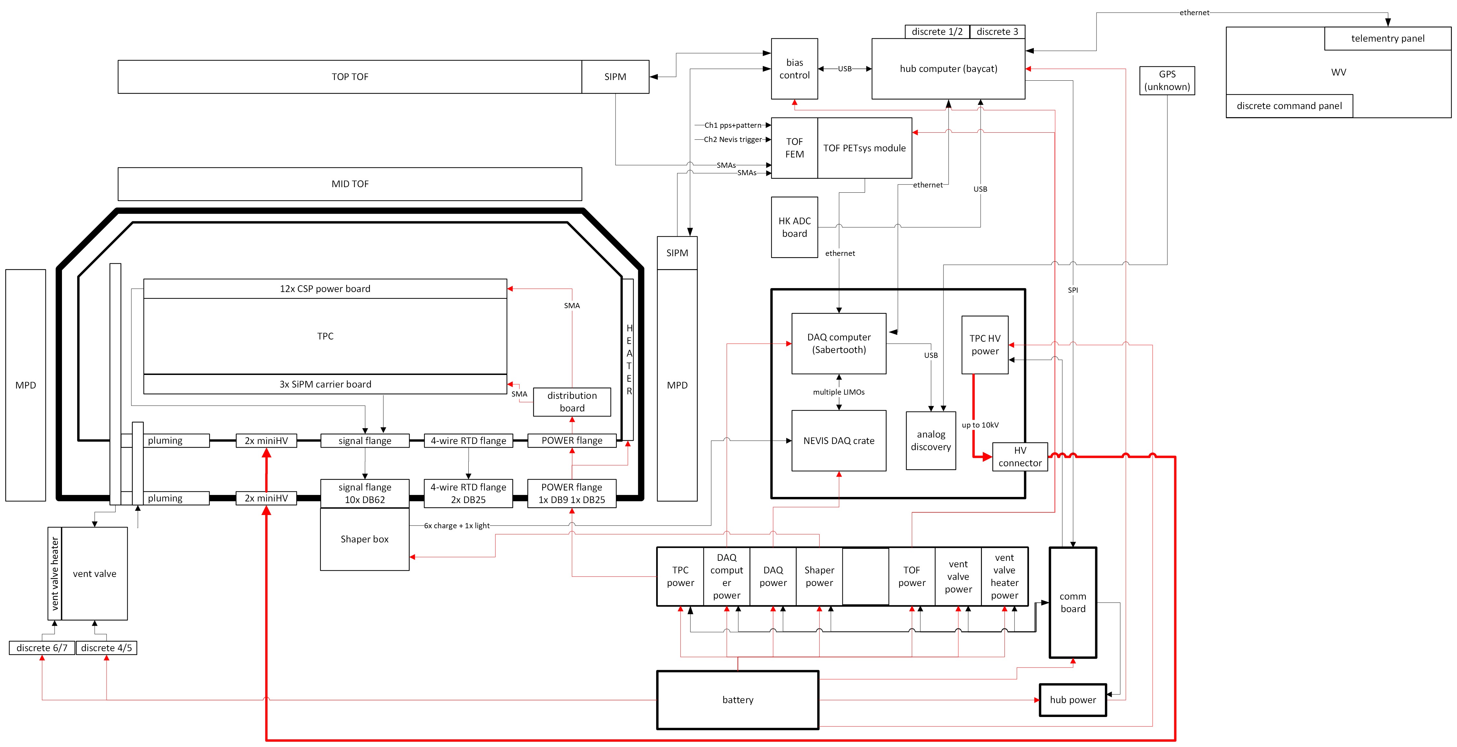
3_Documentation/pGRAMS_Block_Diagram.jpeg
