rjridle/GRAMS/2_Schematics_and_Layout/1_COLD_TPC/2_COLD_TPC_SiPM_Bias_PDU/rjridle_2_COLD_TPC_SiPM_Bias_PDU Parts _ CircuitHub.pdf

# 8 unit(s) of rjridle/2_COLD_TPC_SiPM_Bias_PDU to ship in 13 business days

Description | Quantity | Unit cost | Line cost
PCBs | 8 | $108.8475 | $870.78
Parts | 8 | $967.02125 | $7,736.17
Assembly | 8 | $143.1975 | $1,145.58
Firmware | 8 | $0.00 | $0.00
Processing fee | | $0.00 | $0.00
Shipping (Ground) | | $18.00 | $18.00
Sales tax | | $0.00 | $0.00
| | Total | $9,770.53

# Details

Quote ID | 16ccbd-0
Issue date | Aug 26 2:01 PM (valid for 1 hour)
Project | rjridle/2_COLD_TPC_SiPM_Bias_PDU (https://app.circuithub.com/workspaces/rjridle/projects/rjridle/2_COLD_TPC_SiPM_Bias_PDU/revisions/68446/parts) @ revision 1
From | CircuitHub CircuitHub, Inc. 14 Industrial Dr E South Deerfield, MA
| 01373
For | Ryan

# PCB

Layers | 6
Dimensions | 196.85mm x 73.025mm

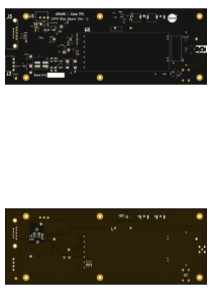
[picture p155: figure]

Min trace | 0.2mm
Min pitch | 0.241mm
Min hole | 0.3mm
Blind/Buried holes | 0
Surface finish | ENIG
Soldermask | black
Silkscreen | white
Stackup | No custom stackup specified Standard stackups (http://docs.circuithub.com/board-specifications/standard-stackups)
Total thickness | 1.6mm
Outer copper | 1 oz
Inner copper | 1 oz

# Assembly & Parts

- 44 part(s) to be purchased and fitted
- 0 part(s) to be consigned (not purchased) and fitted
- 75 location(s) to be fitted

## Terms & Conditions

Quote is based on the information specified in this invoice.
Unless otherwise agreed to, these are the exact specifications that are to be built. All specifications listed in this invoice will override those specified in the original design files.
This invoice can be amended by additional requests, agreed to by Circuithub, on the order page. Further charges may apply. See further terms & conditions. (http://docs.circuithub.com/miscellaneous/terms-and-conditions)
Placing an order with CircuitHub signifies that you agree to all terms & conditions listed here.
Material | FR4 with TG130-135
Unique designs | 0
Cutouts | None
Via in pad | Fill not required
Impedance control | No impedance control specified
Custom requirements | No additional custom requirements specified
