rjridle/GRAMS/2_Schematics_and_Layout/1_COLD_TPC/3_COLD_TPC_Telem_PM5V_PDU/rjridle_3_COLD_TPC_Telem_PM5V_PDU Parts _ CircuitHub.pdf

# 2 unit(s) of rjridle/3_COLD_TPC_Telem_PM5V_PDU to ship in 13 business days

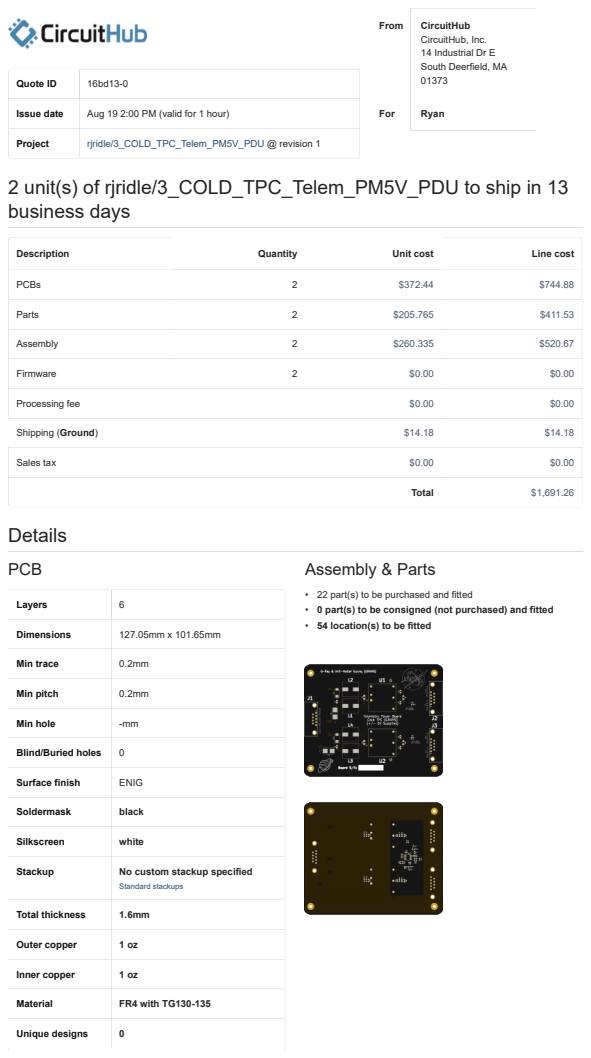
[picture p156: page 1]
Description; Quantity; Unit cost; Line cost; PCBs; Parts; Assembly; Firmware; Processing fee; Shipping (Ground); Sales tax; Total; Details; Quote ID; Issue date; Aug 19 2:00 PM (valid for 1 hour); Project; rjridle/3_COLD_TPC_Telem_PM5V_PDU @ revision 1; From; CircuitHub; For; Ryan; PCB; Layers; Dimensions; Min trace; Min pitch; Min hole; Blind/Buried holes; Surface finish; ENIG; Soldermask; black; Silkscreen; white; Stackup; No custom stackup specified; Standard stackups; Total thickness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

CircuitHub, Inc.
14 Industrial Dr E
South Deerfield, MA

• 22 part(s) to be purchased and fitted
• 0 part(s) to be consigned (not purchased) and fitted
• 54 location(s) to be fitted

### Terms & Conditions

Quote is based on the information specified in this invoice.
Unless otherwise agreed to, these are the exact specifications that are to be built. All specifications listed in this invoice will override those specified in the original design files.
This invoice can be amended by additional requests, agreed to by Circuithub, on the order page. Further charges may apply. See further terms & conditions. (http://docs.circuithub.com/miscellaneous/terms-and-conditions)
Placing an order with CircuitHub signifies that you agree to all terms & conditions listed here.
Cutouts | None
Via in pad | Fill not required
Impedance control | No impedance control specified
Custom requirements | No additional custom requirements specified
