rjridle/GRAMS/2_Schematics_and_Layout/2_WARM_TPC/10_WARM_TPC_Shaper/rjridle_10_WARM_TPC_Shaper Parts _ CircuitHub.pdf

# 2 unit(s) of rjridle/10_WARM_TPC_Shaper to ship in 20 business days

Description | Quantity | Unit cost | Line cost
PCBs | 2 | $589.405 | $1,178.81
Parts | 2 | $732.135 | $1,464.27
Assembly | 2 | $1,118.365 | $2,236.73
Firmware | 2 | $0.00 | $0.00
Processing fee | | $0.00 | $0.00
Shipping (Ground) | | $15.62 | $15.62
Sales tax | | $0.00 | $0.00
| | Total | $4,895.43

# Details

Quote ID | 16c2dc-0
Issue date | Aug 21 3:31 PM (valid for 1 hour)
Project | rjridle/10_WARM_TPC_Shaper (https://app.circuithub.com/workspaces/rjridle/projects/rjridle/10_WARM_TPC_Shaper/revisions/68475/parts) @ revision 1
From | CircuitHub CircuitHub, Inc. 14 Industrial Dr E South Deerfield, MA
| 01373
For | Ryan

## PCB

Layers | 10
Dimensions | 119.38mm x 233.68mm

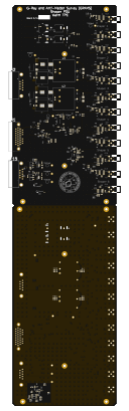
[picture p158: figure]

Min trace | 0.2mm
Min pitch | 0.2mm
Min hole | 0.3mm
Blind/Buried holes | 0
Surface finish | ENIG
Soldermask | black
Silkscreen | white
Stackup | No custom stackup specified Standard stackups (http://docs.circuithub.com/board-specifications/standard-stackups)
Total thickness | 1.6mm
Outer copper | 1 oz
Inner copper | 1 oz

## Assembly & Parts

- 50 part(s) to be purchased and fitted
- 0 part(s) to be consigned (not purchased) and fitted
- 219 location(s) to be fitted

### Terms & Conditions

Quote is based on the information specified in this invoice.
Unless otherwise agreed to, these are the exact specifications that are to be built. All specifications listed in this invoice will override those specified in the original design files.
This invoice can be amended by additional requests, agreed to by Circuithub, on the order page. Further charges may apply. See further terms & conditions. (http://docs.circuithub.com/miscellaneous/terms-and-conditions)
Placing an order with CircuitHub signifies that you agree to all terms & conditions listed here.
Material | FR4 with TG130-135
Unique designs | 0
Cutouts | None
Via in pad | Fill not required
Impedance control | No impedance control specified
Custom requirements | No additional custom requirements specified
