rjridle/GRAMS/2_Schematics_and_Layout/2_WARM_TPC/8_CAEN_NEVIS_DAQ_12V/rjridle_8_WARM_TPC_CAEN_NEVIS_DAQ_12V Parts _ CircuitHub.pdf

# 2 unit(s) of rjridle/8_WARM_TPC_CAEN_NEVIS_DAQ_12V to ship in 13 business days

Description | Quantity | Unit cost | Line cost
PCBs | 2 | $372.275 | $744.55
Parts | 2 | $308.78 | $617.56
Assembly | 2 | $381.475 | $762.95
Firmware | 2 | $0.00 | $0.00
Processing fee | | $0.00 | $0.00
Shipping (Ground) | | $14.18 | $14.18
Sales tax | | $0.00 | $0.00
| | Total | $2,139.24

# Details

Quote ID | 16c2de-0
Issue date | Aug 21 3:33 PM (valid for 1 hour)
Project | rjridle/8_WARM_TPC_CAEN_NEVIS_DAQ_12V (https://app.circuithub.com/workspaces/rjridle/projects/rjridle/8_WARM_TPC_CAEN_NEVIS_DAQ_12V/revisions/68473/parts) @ revision 1
From | CircuitHub CircuitHub, Inc. 14 Industrial Dr E South Deerfield, MA
| 01373
For | Ryan

# PCB

Layers | 6
Dimensions | 142.00000000000003mm x 90mm

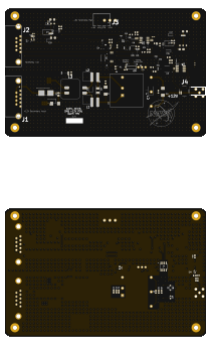
[picture p161: figure]

Min trace | 0.2mm
Min pitch | 0.22mm
Min hole | 0.3mm
Blind/Buried holes | 0
Surface finish | ENIG
Soldermask | black
Silkscreen | white
Stackup | No custom stackup specified Standard stackups (http://docs.circuithub.com/board-specifications/standard-stackups)
Total thickness | 1.6mm
Outer copper | 1 oz

# Assembly & Parts

- 44 part(s) to be purchased and fitted
- 0 part(s) to be consigned (not purchased) and fitted
- 77 location(s) to be fitted

### Terms & Conditions

Quote is based on the information specified in this invoice.
Unless otherwise agreed to, these are the exact specifications that are to be built. All specifications listed in this invoice will override those specified in the original design files.
This invoice can be amended by additional requests, agreed to by Circuithub, on the order page. Further charges may apply. See further terms & conditions. (http://docs.circuithub.com/miscellaneous/terms-and-conditions)
Placing an order with CircuitHub signifies that you agree to all terms & conditions listed here.
Inner copper | 1 oz
Material | FR4 with TG130-135
Unique designs | 0
Cutouts | None
Via in pad | Fill not required
Impedance control | No impedance control specified

Custom
requirements

No additional custom requirements specified
