rjridle/GRAMS/2_Schematics_and_Layout/2_WARM_TPC/9_CAEN_NEVIS_DAQ_3p3V/rjridle_7_WARM_TPC_CAEN_NEVIS_DAQ_3P3V Parts _ CircuitHub.pdf

# 2 unit(s) of rjridle/7_WARM_TPC_CAEN_NEVIS_DAQ_3P3V to ship in 16 business days

Description | Quantity | Unit cost | Line cost
PCBs | 2 | $506.655 | $1,013.31
Parts | 2 | $404.925 | $809.85
Assembly | 2 | $398.68 | $797.36
Firmware | 2 | $0.00 | $0.00
Processing fee | | $0.00 | $0.00
Shipping (Ground) | | $15.62 | $15.62
Sales tax | | $0.00 | $0.00
| | Total | $2,636.14

# Details

Quote ID | 16bd5e-0
Issue date | Aug 19 3:01 PM (valid for 1 hour)
Project | rjridle/7_WARM_TPC_CAEN_NEVIS_DAQ_3P3V (https://app.circuithub.com/workspaces/rjridle/projects/rjridle/7_WARM_TPC_CAEN_NEVIS_DAQ_3P3V/revisions/68472/parts) @ revision 1
From | CircuitHub CircuitHub, Inc. 14 Industrial Dr E South Deerfield, MA
| 01373
For | Ryan

## PCB

Layers | 8
Dimensions | 190.05mm x 117.55mm

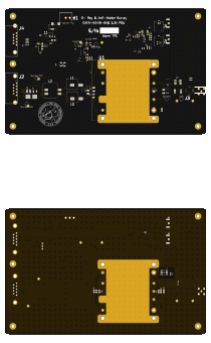
[picture p162: figure]

Min trace | 0.2mm
Min pitch | 0.2mm
Min hole | -mm
Blind/Buried holes | 0
Surface finish | ENIG
Soldermask | black
Silkscreen | white
Stackup | No custom stackup specified Standard stackups (http://docs.circuithub.com/board-specifications/standard-stackups)
Total thickness | 1.6mm
Outer copper | 1 oz
Inner copper | 1 oz

## Assembly & Parts

- 50 part(s) to be purchased and fitted
- 0 part(s) to be consigned (not purchased) and fitted
- 78 location(s) to be fitted

### Terms & Conditions

Quote is based on the information specified in this invoice.
Unless otherwise agreed to, these are the exact specifications that are to be built. All specifications listed in this invoice will override those specified in the original design files.
This invoice can be amended by additional requests, agreed to by Circuithub, on the order page. Further charges may apply. See further terms & conditions. (http://docs.circuithub.com/miscellaneous/terms-and-conditions)
Placing an order with CircuitHub signifies that you agree to all terms & conditions listed here.
Material | FR4 with TG130-135
Unique designs | 0
Cutouts | None
Via in pad | Fill not required
Impedance control | No impedance control specified
Custom requirements | No additional custom requirements specified
