rjridle/GRAMS/3_Documentation/Parts.xlsx

Quantity | Part | Part # | Vendor
2 | Cold TPC Telemetry Power Board |  | board
2 | SiPM HV Board |  | board
2 | Cold TPC SiPM Bias Voltage & Telemetry PDU |  | board
2 | Cold TPC HV PDU Board |  | board
12 | 100uF Tantalum Caps |  | KYOCERA AVX
7 | CONN D-SUB Plug 9pos R/A Solder |  | Digikey
16 | S29AL016J558FIR2 |  | Digikey
100 | CONN PLUG HSG 1POS |  | Digikey
50 | CONN SOCKET 18-22AWG CRIMP TIN |  | Digikey
30 | LED 2.3x7MM GREEN PANEL MOUNT |  | Digikey
5 | Isolated DC/DC Converters - Thru Hole | PDQ30-Q24-S5-D | Mouser
3 | CONN D-SUB Plug 9pos R/A Solder | 732-618009231221-ND
5 | Coilcraft MLC1538-152ML |  | Digikey
1 | 2x Zero-Drift Op Amp | LTC2051HVCS8 | Mouser
10 | Fuseblock w/ fuse 2A | 0154002.DR | Mouser
10 | 100uF Tantalum Caps KYOCERA | TAJD107K020RNJ | Mouser
50? | RES SMD 10K OHM 0.1% | P10KDCCT-ND | Digikey
9 | 10uF 16V Tantalum Capacitors | TAJA106K016RNJ | Mouser
9 | 0603 4.99Kohm 0.1% | ERA-3AEB4991V | Mouser
50? | 1uF 16V X5R 0402 10% | C0402C105K4PACTU | Mouser
9 | 10uF 16V Tantalum Capacitors | T491A106M016AT | Mouser
4 | 10ohm 1W 25ppm Thin Film Resistor | PCAN0805E10R0BST5 | Mouser
9 | 100Kohms 0603 1/10W Thin Film Resistor | ERA-3AEB104V | Mouser
9 | SM Sign N-CH MOS 30V | SSM3K15AFS,LF | Mouser
9 | CAP CER 10000PF 50V X7R 0603 | 1276-1009-1-ND | Digikey
9 | RES SMD 49.9K OHM 1% 1/16W 0603 | A102282CT-ND | Digikey
9 | CAP CER 1UF 25V X7R 0603 | 587-2984-1-ND | Digikey
4 | RES 24.9 OGM 0.01% 1/10W 0603 | RNCF0603TKY24R9CT-ND | Digikey
9 | RES SMD 300 OHM 1% 1/10W 0603 | 13-RT0603FRE07300RLCT-ND | Digikey
9 | WL-SMCW SMDMono TpVw Wurth Single Color LED | 150060VS75000 | Mouser
9 | CAP CER 0.1UF 16V X7R 0603 | 311-1088-1-ND | Digikey
1 | 3/4 Wave Transformer | ? | ?
2 | ARIES SOT23 | ? | ?
