rjridle/GRAMS/2_Schematics_and_Layout/1_COLD_TPC/2_COLD_TPC_SiPM_Bias_PDU/BOM/2_COLD_TPC_SiPM_Bias_PDU.xlsx

Item | Qty | REF DES | Manufacturer | Part Number |  |  |  | Description / Value | Package | Part Type | Notes
 |  |  |  | Manufacturer | Digi-Key | Mouser | Coil Craft
1 | 1 | C1 | Kyocer AVX | TAJD107K020RNJ | 478-1724-1-ND | - | - | Tantalum Capacitor, 100uF 20V | 2917 | SMD | -
2 | 1 | C2 | Kyocer AVX | TAJD336K016RNJ | 478-3930-1-ND | - | - | Tantalum Capacitor, 33uF 16V | 2917 | SMD | -
3 | 1 | C3 | KEMET | T495X157K016ATE100 | 399-3898-1-ND | - | - | Tantalum Capacitor, 150uF 16V | 2917 | SMD | -
4 | 1 | C4 | Taiyo Yuden | TMK107B7105KA-T | 587-2984-1-ND | - | - | Ceramic Capacitor, X7R 1uF | 0603 | SMD | -
5 | 8 | C5,C8,C10,C11,C13,C15,C16,C17 | Samsung Electro-Mechanics | CL10B104KB8NNNC | 1276-1000-1-ND | - | - | Ceramic Capacitor, X7R 0.1uF | 0603 | SMD | -
6 | 1 | C6 | Yageo | CC0603KRX7R9BB103 | 311-1085-1-ND | - | - | Ceramic Capacitor, X7R 0.01uF | 0603 | SMD | -
7 | 1 | C12 | Kyocer AVX | TAJA225K035RNJ | 478-3073-1-ND | - | - | Tantalum Capacitor, 2.2uF 35V | 1206 | SMD | -
8 | 4 | CY1,CY2,CY3,CY4 | KEMET | C1206C472JCTACAUTO | 399-C1206C472JBTACAUTOCT-ND | - | - | Saftey Capacitor, X8G 4700pF | 1206 | SMD | -
9 | 1 | C7 | Murata Electronics | GRM188D72A105KE01D | 490-GRM188D72A105KE01DCT-ND | - | - | Ceramic Capacitor, 1uF 100V | 0603 | SMD | -
10 | 1 | C8 | Samsung Electro-Mechanics | CL10B104KC8NNNC | 1276-6807-1-ND | - | - | Ceramic Capacitor, 0.1uF 100V | 0603 | SMD | -
11 | 1 | C9 | TDK Corporation | CGA3E2X7R2A102K080AA | 445-5806-1-ND | - | - | Ceramic Capacitor, 1nF 100V | 0603 | SMD | -
12 | 1 | C14 | Kyocer AVX | F921C105MPA | 478-8126-1-ND | - | - | Tantalum Capacitor, 1uF 16V | 0805 | SMD | -
13 | 2 | D1,D2 | Diotec Semiconductor | 1N4004 | 4878-1N4004CT-ND | - | - | General Purpose Diode, 400V, 1A | DO-41 | Through Hole | -
14 | 1 | F1 | Little Fuse | 0438001.WR | F2947CT-ND | - | - | FUSE BRD MNT 1A 32VAC 63VDC 0603 | 0603 | SMD | -
15 | 1 | J1 | Würth Elektronik | 691322310003 | 732-2089-ND | - | - | TERM BLOCK HDR 3POS 90DEG 3.81MM | 3 Pos | Through Hole | -
16 | 1 | J2 | Würth Elektronik | 691322110004 | 732-2771-ND | - | - | TERM BLOCK HDR 4POS 90DEG 3.5MM | 4 Pos | Through Hole | -
17 | 1 | J3 | Würth Elektronik | 618009231121 | 732-618009231121-ND | - | - | CONN D-SUB RCPT 9POS R/A SLDR | 9 Pos | Through Hole | -
18 | 1 | L1 | Coil Craft | MSD1260T-105 | - | - | MSD1260T-105 | Common Mode Choke |  | SMD | -
19 | 2 | L2,L3 | Coil Craft | 0603PS-153KR_ | - | - | 0603PS-153KR_ | Series Shielded Inductors (15uH) |  | SMD | -
20 | 3 | M1,M2,M3 | Toshiba Semiconductor and Storage | SSM3K15AFS,LF | SSM3K15AFSLFCT-ND | - | - | N-Channel 30 V 100mA (Ta) 100mW (Ta) | SSM | SMD | -
21 | 2 | P1,P2 | TE Connectivity AMP Connectors | 1-1123824-1 | A30708-ND | - | - | Connector Header | 1-Pos | Through Hole | -
22 | 1 | P_Out1 | Adam Tech | RF2-49B-T-00-50-G-HDW | 2057-RF2-49B-T-00-50-G-HDW-ND | - | - | RF SMA CONNECTOR | - | Through Hole | -
23 | 1 | Q1 | Isocom Components 2004 LTD | ISP281D | 58-ISP281DCT-ND | - | - | Opto-Isolator | 4-SOP | SMD | -
24 | 1 | R1 | Stackpole Electronics Inc | RMCF0603FT1K74 | RMCF0603FT1K74CT-ND | - | - | Series Resistor, 1.74k | 0603 | SMD | -
25 | 1 | R2 | YAGEO | RC0603FR-071KL | 311-1.00KHRCT-ND | - | - | Series Resistor, 1k | 0603 | SMD | -
26 | 1 | R3 | Panasonic Electronic Components | ERJ-3EKF1000V | P100HCT-ND | - | - | Series Resistor, 180 | 0603 | SMD | -
27 | 1 | R4 | Panasonic Electronic Components | ERA-3AEB153V | P15KDBCT-ND | - | - | Series Resistor, 15k | 0603 | SMD | -
28 | 1 | R5 | Panasonic Electronic Components | ERJ-3EKF2002V | P20.0KHCT-ND | - | - | Series Resistor, 20k | 0603 | SMD | -
29 | 1 | R6 | Panasonic Electronic Components | ERJ-3RSFR10V | P.10AJCT-ND | - | - | Series Resistor, 0.1 Ohms | 0603 | SMD | -
30 | 1 | R7 | Yageo | RT0603BRE075KL | 13-RT0603BRE075KLCT-ND | - | - | Series Resistor, 5k | 0603 | SMD | -
31 | 5 | R8,R15,R17,R19,R23 | Panasonic Electronic Components | ERJ-3EKF49R9V | P49.9HCT-ND | - | - | Series Resistor, 49.9 | 0603 | SMD | -
32 | 4 | R9,R14,R18,R22 | Susumu | RR0816P-103-D | RR08P10.0KDCT-ND | - | - | Series Resistor, 10K | 0603 | SMD | -
33 | 2 | R10,R24 | Panasonic Electronic Components | ERJ-3EKF1003V | P100KHCT-ND | - | - | Series Resistor, 100k | 0603 | SMD | -
34 | 1 | R11 | Yageo | RC0603FR-0749K9L | 311-49.9KHRCT-ND | - | - | Series Resistor, 49.9k | 0603 | SMD | -
35 | 1 | R12 | Stackpole Electronics Inc | RMCF0603ZT0R00 | RMCF0603ZT0R00CT-ND | - | - | Series Resistor, 0-Ohms | 0603 | SMD | -
36 | 1 | R13 | Panasonic Electronic Components | ERJ-3EKF1000V | P100HCT-ND | - | - | Series Resistor, 100 Ohms | 0603 | SMD | -
37 | 1 | R16 | Panasonic Electronic Components | ERJ-3EKF3303V | P330KHCT-ND | - | - | Series Resistor, 330k | 0603 | SMD | -
38 | 1 | R20 | Vishay Beyschlag/Draloric/BC Components | MBB0207VD1004BC100 | BC4506CT-ND | - | - |  |  | Through Hole | -
39 | 1 | R21 | KOA Speer Electronics, Inc. | RN73H1JTTD5302D100 | 2019-RN73H1JTTD5302D100CT-ND | - | - | Series Resistor, 53k | 0603 | SMD | -
40 | 1 | R25 | Panasonic Electronic Components | ERA-3AEB151V | P150DBCT-ND | - | - | Series Resistor, 150 Ohms | 0603 | SMD | -
41 | 2 | R26,R27 | Do Not Install
42 | 1 | U1 | ULTRAVOLT / Advanced Energy | 1/16A12-P4 | 2309-1/16A12-P4-ND | - | - | DC-DC Converter | - | Through Hole | -
43 | 1 | U2 | Analog Devices Inc. | LTC2052HVCS#PBF | LTC2052HVCS#PBF-ND | - | - | Quad Op-Amp Package | 14-SO | SMD | -
44 | 1 | U3 | Texas Instruments | SN65LVDS2DBVR | 296-6920-1-ND | - | - | LVDS Receiver | SOT-23-5 | SMD | -
45 | 1 | U4 | Analog Devices Inc. | LT3080EST#PBF | 505-LT3080EST#PBF-ND | - | - | Adjustable Voltage Regulator | SOT-223-3 | SMD | -
46 | 1 | U5 | Analog Devices Inc. | LTC2050HVCS5-TRMPBF | 505-LTC2050HVCS5#TRMPBFCT-ND | - | - | Single Op-Amp | TSOT-23-5 | SMD | -
47 | 3 | Ven, Vout, Vset | Keystone Electronics | 5011 | 36-5011-ND | - | - | Test Point | - | Through Hole | -
Total | 73 | Parts
