rjridle/GRAMS/2_Schematics_and_Layout/1_COLD_TPC/3_COLD_TPC_Telem_PM5V_PDU/BOM/GRAMS-PM5V_Cold-TPC_Telem_BRD_BOM.xlsx

Item | Qty | REF DES | Manufacturer | Part Number |  |  |  | Description / Value | Package | Part Type | Notes
 |  |  |  | Manufacturer | Digi-Key | Mouser | Coil Craft
1 | 2 | C1,C11 | KYOCERA AVX | TAJD107M016RNJ | 478-3919-1-ND | - | - | 16V Tantalum, 100uF | 2917 | SMD | -
2 | 4 | C2,C9,C12,C20 | KEMET | T491A106K016AT | 399-8269-1-ND | - | - | 16V Tantalum, 10uF | 1206 | SMD | -
3 | 4 | C3,C8,C13,C19 | KEMET | C0603C105K4RACTU | 399-C0603C105K4RACTUCT-ND | - | - | Ceramic Capacitor, 1uF | 0603 | SMD | -
4 | 2 | C23, C24 | KYOCERA AVX | 0402ZD105KAT2A | 478-KGM05AR51A105KHCT-ND | - | - | Ceramic Capacitor, 1uF | 0402 | SMD | -
4 | 8 | C4,C7,C10,C14,C16,C18,C21,C22 | YAGEO | CC0603KRX7R7BB104 | 311-1088-1-ND | - | - | Ceramic Capacitor, 0.1uF | 0603 | SMD | -
5 | 4 | C5,C6,C15,C17 | Murata Electronics | GCM188R72A103KA37D | 490-4781-1-ND | - | - | Ceramic Capacitor, 0.01uF | 0603 | SMD | -
6 | 2 | D1,D2 | Würth Elektronik | 150060VS75000 | 732-4980-1-ND | - | - | Green 570nm LED | 0603 | SMD | -
7 | 2 | F1,F2
8 | 3 | J1,J2,J3 | Würth Elektronik | 618009231221 | 732-618009231221-ND | - | - | 9 P0S D-Sub Plug, Male Pins Con | - | Through Hole | -
9 | 4 | L1,L2,L3,L4 | Coil Craft | MLC1538-152ML_ | - | - | MLC1538-152ML_ | Inductors | - | SMD | -
10 | 2 | M1,M2 | Toshiba Semiconductor | SSM3K15AFS,LF | SSM3K15AFSLFCT-ND | - | - | N-Channel 3FET | - | SMD | -
11 | 2 | R1,R5 | YAGEO | RC0805FR-0710RL | 311-10.0CRCT-ND | - | - | 10-Ohm 0.125W Resistor | 0805 | SMD | -
12 | 6 | R2,R3,R4,R6,R7,R8 | DO NOT INSTALL
13 | 3 | R9,R15,R20 | YAGEO | RC0603FR-0724R9L | 311-24.9HRCT-ND | - | - | 24.9 Ohm Resistor (0.1W) | 0603 | SMD | -
14 | 2 | R10,R16 | Vishay Dale | CRCW0603100KFKEA | 541-100KHCT-ND | - | - | 100K-Ohm Resistor (0.1W) | 0603 | SMD | -
15 | 2 | R11,R17 | YAGEO | RC0603JR-07300RL | 311-300GRCT-ND | - | - | 300-Ohm Resistor (0.1W) | 0603 | SMD | -
16 | 2 | R12,R19 | YAGEO | RC0402JR-0710KL | 311-10KJRCT-ND | - | - | 10k-Ohm resistor (1/16W) | 0402 | SMD | -
17 | 2 | R13,R14 | YAGEO | RT0603BRD0750KL | 13-RT0603BRD0750KLCT-ND | - | - | 50k-Ohm resistor (0.1W) | 0603 | SMD | -
18 | 1 | R18 | YAGEO | RT0603BRE075KL | 13-RT0603BRE075KLCT-ND | - | - | 5k-Ohm resistor (0.1W) | 0603 | SMD | -
19 | 2 | U1,U2 | CUI Inc. | PDQ30-Q24-S5-D | 102-3891-ND | - | - | Isolated DC DC Converter 5V, 6A | - | Through Hole | -
20 | 1 | U3 | Analog Devices | LTC2051HVCS8#TRPBF | LTC2051HVCS8#TRPBFCT-ND | - | - | Chopper 0-Drift Dual Amp | 8-SOIC | SMD | -
