rjridle/GRAMS/2_Schematics_and_Layout/1_COLD_TPC/4_COLD_TPC_SiPM_Pre_Amp/Build_Files/GRAMS_COLD_TPC_SiPM_Pre-AMP_PDU_BOM.xlsx

# | Reference | Value | Manufacturer | Man. Part Num | Distributor | Dist. Part Num | Package | Description | Part Type
1 | +5V,+12V | TestPoint | Keystone Electronics | 5005 | Digi-Key | 36-5005-ND |  | Red PC Test Point, Compact Phosphor Bronze Silver Plating Through Hole Mounting Type | Through Hole
2 | +12V_RTN,Telem_RTN,V_{OUT_RTN} | TestPoint | Wurth Electronics | 5006 | Digi-Key | 36-5006-ND |  | Black PC Test Point, Compact Phosphor Bronze Silver Plating Through Hole Mounting Type | Through Hole
3 | -5V1 | TestPoint | Keystone Electronics | 5009 | Digi-Key | 36-5009-ND |  | Yellow PC Test Point, Compact Phosphor Bronze Silver Plating Through Hole Mounting Type | Through Hole
4 | C1,C4,C9,C12,C13,C18,C21,C22,C25,C27,C28,C29,C30,C33 | 0.1uF | YAGEO | CC0603KRX7R7BB104 | Digi-Key | 311-1088-1-ND | 0603 (1608 Metric) | 0.1µF±10% 16V Ceramic Capacitor X7R 0603 (1608 Metric) | SMD
5 | C2,C8,C14,C17,C23,C31 | 1uF | Samsung Electro-Mechanics | CL10B105KO8NNNC | Digi-Key | 1276-1019-1-ND | 0603 (1608 Metric) | 1µF±10% 16V Ceramic Capacitor X7R 0603 (1608 Metric)
6 | C3,C24,C32,C34 | 1uF | KYOCERA AVX | F921C105MPA | Digi-Key | 478-8126-1-ND | 0805 (2012 Metric) | 1µF Molded Tantalum Capacitors 16 V 0805 (2012 Metric) 12Ohm | SMD
7 | C5,C26 | 2.2uF | KYOCERA AVX | TAJA225K035RNJ | Digi-Key | 478-3073-1-ND | 1206 (3216 Metric) | 2.2µF Molded Tantalum Capacitors 35 V 1206 (3216 Metric) 4.5Ohm | SMD
8 | C6,C15 | 100uF | KYOCERA AVX | TAJD107K016RNJ | Digi-Key | 478-1723-1-ND | 2917 (7343 Metric) | 100µF Molded Tantalum Capacitors 16 V 2917 (7343 Metric) 600mOhm | SMD
9 | C7,C16 | 10uF | KYOCERA AVX | T491A106M016AT | Digi-Key | 399-3687-1-ND | 1206 (3216 Metric) | 10µF Molded Tantalum Capacitors 16 V 1206 (3216 Metric) 7Ohm | SMD
10 | C10,C11,C19,C20 | 0.01uF | KEMET | C0603C103K5RACTU | Digi-Key | 399-C0603C103K5RACTUCT-ND | 0603 (1608 Metric) | 10000 pF±10% 50V Ceramic Capacitor X7R 0603 (1608 Metric) | SMD
11 | D1,D2 | PLVA653A_215 | Nexperia USA Inc. | PLVA653A,215 | Digi-Key | 1727-5168-1-ND | TO-236AB | Zener Diode 5.3 V 250 mW±4% Surface Mount TO-236AB | SMD
12 | F1,F2 | Fuse | Bourns Inc. | SF-0603SP100M-2 | Digi-Key | SF-0603SP100M-2CT-ND | 0603 (1608 Metric) | 1 A AC 32 V DC Fuse Board Mount (Cartridge Style Excluded) Surface Mount 0603 (1608 Metric) | SMD
13 | J1 | 618009231221 | Wurth Electronics | 618009231221 | Digi-Key | 732-618009231221-ND |  | CONN D-SUB PLUG 9POS R/A SOLDER | Through Hole
14 | J2 | 618009231121 | Wurth Electronics | 618009231121 | Digi-Key | 732-618009231121-ND |  | CONN D-SUB RCPT 9POS R/A SOLDER | Through Hole
15 | J3 | 618015330923 | Wurth Electronics | 618015330923 | Digi-Key | 732-618015330923-ND |  | CONN D-SUB HD RCPT 15P R/A SLDR | Through Hole
16 | J4,J5 | RF2-49B-T-00-50-G-HDW | Adam Tech | RF2-49B-T-00-50-G-HDW | Digi-Key | 2057-RF2-49B-T-00-50-G-HDW-ND | SMA Right Angle Solder | SMA Connector Jack, Female Socket 50 Ohms Through Hole, Right Angle Solder | Through Hole
17 | L1,L2,L3,L4 | 1.5uH | Coil Craft | MLC7540-142ME | Digi-Key | MLC7540-142ME |  | Shielded Power Inductors€“ MLC75xx | SMD
18 | M1,M2,M5,M6 | SSM3K15AFS_LF | Toshiba Semiconductor and Storage | SSM3K15AFS,LF | Digi-Key | SSM3K15AFSLFCT-ND | SSM_TOS | MOSFET N-CH 30V 100MA SSM | SMD
19 | P1,P2,P3,P4 | 1-1123824-1 | TE Connectivity AMP Connectors | 1-1123824-1 | Digi-Key | A30708-ND |  | Connector Header Through Hole 1 position | Through Hole
20 | Q1 | ISP281D | Isocom Components 2004 LTD | ISP281D | Digi-Key | 58-ISP281DCT-ND | 4-SOP | Optoisolator Transistor Output 3750Vrms 1 Channel 4-SOP | SMD
21 | R1,R2,R48,R49 | 10 | Stackpole Electronics Inc | RMCF0603FT10R0 | Digi-Key | RMCF0603FT10R0CT-ND | 0603 (1608 Metric) | 10 Ohms±1% 0.1W, 1/10W Chip Resistor 0603 (1608 Metric) Automotive AEC-Q200 Thick Film | SMD
22 | R3 | 250k | Vishay Sfernice | P0603H2503BNT | Digi-Key | 716-P0603H2503BNTCT-ND | 0603 (1608 Metric) | 250 kOhms±0.1% 0.125W, 1/8W Chip Resistor 0603 (1608 Metric) Anti-Sulfur, Automotive AEC-Q200, Moisture Resistant, Pulse Withstanding Thin Film | SMD
23 | R4 | 835 | KOA Speer Electronics, Inc. | RN73H1JTTD8350A05 | Digi-Key | 2019-RN73H1JTTD8350A05CT-ND | 0603 (1608 Metric) | 835 Ohms±0.05% 0.1W, 1/10W Chip Resistor 0603 (1608 Metric) Automotive AEC-Q200, Moisture Resistant Metal Film | SMD
24 | R5,R12 | 1k | YAGEO | RT0603BRD071KL | Digi-Key | YAG1237CT-ND | 0603 (1608 Metric) | 1 kOhms±0.1% 0.1W, 1/10W Chip Resistor 0603 (1608 Metric) Thin Film | SMD
25 | R6 | 180 | Vishay Beyschlag/Draloric/BC Components | MCT06030C1800FP500 | Digi-Key | 749-1612-1-ND | 0603 (1608 Metric) | 180 Ohms±1% 0.125W, 1/8W Chip Resistor 0603 (1608 Metric) Anti-Sulfur Thin Film | SMD
26 | R7 | 15k | Panasonic Electronic Components | ERA-3AEB153V | Digi-Key | P15KDBCT-ND | 0603 (1608 Metric) | 15 kOhms±0.1% 0.1W, 1/10W Chip Resistor 0603 (1608 Metric) Automotive AEC-Q200 Thin Film | SMD
27 | R8,R19,R22,R26,R35 | 10k | Stackpole Electronics Inc | RNCP0603FTD10K0 | Digi-Key | RNCP0603FTD10K0CT-ND | 0603 (1608 Metric) | 10 kOhms±1% 0.125W, 1/8W Chip Resistor 0603 (1608 Metric) Anti-Sulfur Thin Film | SMD
28 | R9,R25 | 5k | YAGEO | RT0603BRE075KL | Digi-Key | 13-RT0603BRE075KLCT-ND | 0603 (1608 Metric) | 5 kOhms±0.1% 0.1W, 1/10W Chip Resistor 0603 (1608 Metric) Thin Film | SMD
29 | R10 | 330k | Susumu | RG1608P-334-B-T5 | Digi-Key | RG16P330KBCT-ND | 0603 (1608 Metric) | 330 kOhms±0.1% 0.1W, 1/10W Chip Resistor 0603 (1608 Metric) Anti-Sulfur, Automotive AEC-Q200 Thin Film | SMD
30 | R11,R21,R23,R28,R31,R34 | 49.9 | Stackpole Electronics Inc | RNCP0603FTD49R9 | Digi-Key | RNCP0603FTD49R9CT-ND | 0603 (1608 Metric) | 49.9 Ohms±1% 0.125W, 1/8W Chip Resistor 0603 (1608 Metric) Anti-Sulfur Thin Film | SMD
31 | R13 | 196 | Panasonic Electronic Components | ERA-3AEB1960V | Digi-Key | P196DBCT-ND | 0603 (1608 Metric) | 196 Ohms±0.1% 0.1W, 1/10W Chip Resistor 0603 (1608 Metric) Automotive AEC-Q200 Thin Film | SMD
32 | R14,R15 | 120 | YAGEO | RT0603DRE07120RL | Digi-Key | 311-2409-1-ND | 0603 (1608 Metric) | 120 Ohms±0.5% 0.1W, 1/10W Chip Resistor 0603 (1608 Metric) Thin Film | SMD
33 | R20,R41,R42,R43,R44 | 24.9 | Stackpole Electronics Inc | RNCF0603TKY24R9 | Digi-Key | RNCF0603TKY24R9CT-ND | 0603 (1608 Metric) | 24.9 Ohms±0.01% 0.1W, 1/10W Chip Resistor 0603 (1608 Metric) Automotive AEC-Q200 Thin Film | SMD
34 | R24 | 8k | YAGEO | RT0603BRE078KL | Digi-Key | 13-RT0603BRE078KLCT-ND | 0603 (1608 Metric) | 8 kOhms±0.1% 0.1W, 1/10W Chip Resistor 0603 (1608 Metric) Thin Film | SMD
35 | R27 | 20k | Vishay Dale | TNPW060320K0BEEA | Digi-Key | TNP20.0KAACT-ND | 0603 (1608 Metric) | 20 kOhms±0.1% 0.21W Chip Resistor 0603 (1608 Metric) Anti-Sulfur, Automotive AEC-Q200, Moisture Resistant Thin Film | SMD
36 | R29,R32 | 100k | Vishay Dale | TNPW0603100KBEEA | Digi-Key | TNP100KAACT-ND | 0603 (1608 Metric) | 100 kOhms±0.1% 0.21W Chip Resistor 0603 (1608 Metric) Anti-Sulfur, Automotive AEC-Q200, Moisture Resistant Thin Film | SMD
37 | R30,R33 | 150 | Panasonic Electronic Components | ERA-3AEB151V | Digi-Key | P150DBCT-ND | 0603 (1608 Metric) | 150 Ohms±0.1% 0.1W, 1/10W Chip Resistor 0603 (1608 Metric) Automotive AEC-Q200 Thin Film | SMD
38 | R36 | 40k | Vishay Dale Thin Film | PAT0603E4002BST1 | Digi-Key | PAT40KACT-ND | 0603 (1608 Metric) | 40 kOhms±0.1% 0.15W Chip Resistor 0603 (1608 Metric) Anti-Sulfur, Automotive AEC-Q200, Moisture Resistant Thin Film | SMD
39 | R37,R38,R39,R40 | DO NOT POPULATE |  |  |  |  |  | - | -
40 | R45,R46 | FCSL20R010FER | Ohmite | FCSL20R010FER | Digi-Key | FCSL20R010FERCT-ND | 0805 (2012 Metric) | 10 mOhms±1% 1W Chip Resistor Wide 0805 (2012 Metric), 0508 Current Sense, Moisture Resistant Metal Foil | SMD
41 | U1,U2 | LT3080EST-PBF | Analog Devices Inc. | LT3080EST#PBF | Digi-Key | 505-LT3080EST#PBF-ND | SOT223-3 | IC REG LIN POS ADJ 1.1A SOT223-3 | SMD
42 | U3,U4 | PDQ10-Q24-S3-D | CUI Inc. | PDQ10-Q24-S3-D | Digi-Key | 102-3868-ND | DIP-6 CUI | Isolated Module DC DC Converter 1 Output 3.3V 2.5A 9V - 36V Input | Through Hole
43 | U5 | SN65LVDS2DBVR | Texas Instruments | SN65LVDS2DBVR | Digi-Key | 296-6920-1-ND | SOT-23-5 | 0/1 Receiver LVDS SOT-23-5 | SMD
44 | U6 | LM337IMPX/NOPB | Texas Instruments | LM337IMPX/NOPB | Mouser | 926-LM337IMPX/NOPB | SOT223-4 | Linear Voltage Regulators 3-Term Adj Neg Reg A 926-LM337IMP/NOPB | SMD
45 | U7 | LTC2052HVCS | Analog Devices Inc. | LTC2052HVCS#PBF | Digi-Key | LTC2052HVCS#PBF-ND | 14-SOIC | Chopper (Zero-Drift) Amplifier 4 Circuit Rail-to-Rail 14-SO | SMD
46 | U8 | AD590JRZ-RL | Analog Devices Inc. | AD590JRZ | Digi-Key | AD590JRZ-ND | 8-SOIC | SENSOR ANALOG -55C-150C 8SOIC | SMD
47 | U9,U10 | INA286 | Texas Instruments | INA286AIDR | Digi-Key | 296-43593-1-ND | 8-SOIC | Current Monitor Regulator High/Low-Side 8-SOIC | SMD
48 | V_{EN} | TestPoint | Wurth Electronics | 5008 | Digi-Key | 36-5008-ND |  | Orange PC Test Point, Compact Phosphor Bronze Silver Plating Through Hole Mounting Type | Through Hole
