rjridle/GRAMS/2_Schematics_and_Layout/1_COLD_TPC/5_COLD_TPC_Charge_Pre_Amp/Build_Files/Charge_Pre-Amplifier_BOM.xlsx

# | Reference | Qty | Value | Distributor | Dist. Part Num | Manufacturer | Man. Part Num | Package | Part Type | Description
1 | +/-5V_{RTN},+12V_RTN,Telem_RTN | 3 | TestPoint | Digi-Key | 36-5006-ND | Keystone Electronics | 5006 |  | Through Hole | Black PC Test Point, Compact Phosphor Bronze Silver Plating Through Hole Mounting Type
2 | +5V1,+12V1 | 2 | TestPoint | Digi-Key | 36-5007-ND | Keystone Electronics | 5007 |  | Through Hole | White PC Test Point, Compact Phosphor Bronze Silver Plating Through Hole Mounting Type
3 | -5V1 | 1 | TestPoint | Digi-Key | 36-5008-ND | Keystone Electronics | 5008 |  | Through Hole | Orange PC Test Point, Compact Phosphor Bronze Silver Plating Through Hole Mounting Type
4 | C1,C2,C6,C9,C13,C15,C19,C22,C30,C44 | 10 | 0.1uF | Digi-Key | 399-C0603C104K5RACTUCT-ND | KEMET | C0603C104K5RACTU | 0603 (1608 Metric) | SMD | 0.1 µF ±10% 50V Ceramic Capacitor X7R 0603 (1608 Metric)
5 | C3,C16 | 2 | 100uF | Digi-Key | 399-3770-1-ND | KEMET | T491D107K016AT | 2917 (7343 Metric) | SMD | 100 µF Molded Tantalum Capacitors 16 V 2917 (7343 Metric) 700mOhm
6 | C4,C11,C17,C24 | 4 | 10uF | Digi-Key | 399-3687-1-ND | KEMET | T491A106M016AT | 1206 (3216 Metric) | SMD | 10 µF Molded Tantalum Capacitors 16 V 1206 (3216 Metric) 7Ohm
7 | C5,C10,C18,C23,C31,C32,C35,C43 | 8 | 1uF | Digi-Key | 1276-1184-1-ND | Samsung Electro-Mechanics | CL10B105KA8NNNC | 0603 (1608 Metric) | SMD | 1 µF ±10% 25V Ceramic Capacitor X7R 0603 (1608 Metric)
8 | C7,C8,C20,C21 | 4 | 0.01uF | Digi-Key | 478-KGM15AR71H103KTCT-ND | KYOCERA AVX | KGM15AR71H103KT | 0603 (1608 Metric) | SMD | 10000 pF ±10% 50V Ceramic Capacitor X7R 0603 (1608 Metric)
9 | C12,C25,C34,C42 | 4 | 1uF | Digi-Key | 478-8126-1-ND | KYOCERA AVX | F921C105MPA | 0805 (2012 Metric) | SMD | 1 µF Molded Tantalum Capacitors 16 V 0805 (2012 Metric) 12Ohm
10 | C14,C33 | 2 | 2.2uF | Digi-Key | 478-3073-1-ND | KYOCERA AVX | TAJA225K035RNJ | 1206 (3216 Metric) | SMD | 2.2 µF Molded Tantalum Capacitors 35 V 1206 (3216 Metric) 4.5Ohm
11 | C26,C28,C37,C38,C40 | 5 | 0.01uF | Digi-Key | 490-1313-1-ND | Murata Electronics | GRM155R71C103KA01D | 0402 (1005 Metric) | SMD | 10000 pF ±10% 16V Ceramic Capacitor X7R 0402 (1005 Metric)
12 | C27,C29,C36,C39,C41 | 5 | 0.1uF | Digi-Key | 1276-6720-1-ND | Samsung Electro-Mechanics | CL05B104KA5NNNC | 0402 (1005 Metric) | SMD | 0.1 µF ±10% 25V Ceramic Capacitor X7R 0402 (1005 Metric)
13 | D1,D2 | 2 | PLVA653A,215 | Digi-Key | 1727-5168-1-ND | Nexperia USA Inc. | PLVA653A,215 | TO-236AB | SMD | Zener Diode 5.3 V 250 mW ±4% Surface Mount TO-236AB
14 | F1,F2 | 2 | Fuse | Digi-Key | 5923-0685T6000-01CT-ND | Bel Fuse Inc. | 0685T6000-01 | 1206 (3216 Metric) | SMD | 6 A 63 V AC 63 V DC Fuse Board Mount (Cartridge Style Excluded) Surface Mount 1206 (3216 Metric)
15 | J1 | 1 | 618009231221 | Digi-Key | 732-618009231221-ND | Wurth Electronics | 618009231221 |  | Through Hole | CONN D-SUB PLUG 9POS R/A SOLDER
16 | J2 | 1 | 618009231121 | Digi-Key | 732-618009231121-ND | Wurth Electronics | 618009231121 |  | Through Hole | CONN D-SUB RCPT 9POS R/A SOLDER
17 | J3 | 1 | 618015330923 | Digi-Key | 732-618015330923-ND | Wurth Electronics | 618015330923 |  | Through Hole | CONN D-SUB HD RCPT 15P R/A SLDR
18 | J4,J5 | 2 | RF2-49B-T-00-50-G-HDW | Digi-Key | 2057-RF2-49B-T-00-50-G-HDW-ND | Adam Tech | RF2-49B-T-00-50-G-HDW |  | Through Hole | SMA Connector Jack, Female Socket 50 Ohms Through Hole, Right Angle Solder (Voltage Rating = 335V)
19 | L1,L2,L3,L4 | 4 | 1.5uH | Coil Craft | MLC1245-152ML | Coil Craft | MLC1245-152ML |  | SMD | Shielded Power Inductors MLC12xx/15xx
20 | M1,M2,M3,M4 | 4 | SSM3K15AFS_LF | Digi-Key | SSM3K15AFSLFCT-ND | Toshiba Semiconductor and Storage | SSM3K15AFS,LF | SSM_TOS | SMD | MOSFET N-CH 30V 100MA SSM
21 | P1,P2,P3,P4 | 4 | 1-1123824-1 | Digi-Key | A30708-ND | TE Connectivity AMP Connectors | 1-1123824-1 |  | Through Hole | Connector Header Through Hole 1 position
22 | Q1 | 1 | ISP281D | Digi-Key | 58-ISP281DCT-ND | Isocom Components 2004 LTD | ISP281D | 4-SOP | SMD | Optoisolator Transistor Output 3750Vrms 1 Channel 4-SOP
23 | R1,R2 | 2 | FCSL20R010FER | Digi-Key | FCSL20R010FERCT-ND | Ohmite | FCSL20R010FER | 0805 (2012 Metric) | SMD | 10 mOhms ±1% 1W Chip Resistor Wide 0805 (2012 Metric), 0508 Current Sense, Moisture Resistant Metal Foil
24 | R3,R4,R40,R41 | 4 | 10 | Digi-Key | P10ADCT-ND | Panasonic Electronic Components | ERJ-P06J100V | 0805 (2012 Metric) | SMD | 10 Ohms ±5% 0.5W, 1/2W Chip Resistor 0805 (2012 Metric) Automotive AEC-Q200, Pulse Withstanding Thick Film
25 | R5,R11,R15 | 3 | DO NOT INSTALL
26 | R6 | 1 | 835 | Digi-Key | 2019-RN73R1JTTD8350B25CT-ND | KOA Speer Electronics, Inc. | RN73R1JTTD8350B25 | 0603 (1608 Metric) | SMD | 835 Ohms ±0.1% 0.125W, 1/8W Chip Resistor 0603 (1608 Metric) Automotive AEC-Q200, Moisture Resistant Thin Film
27 | R7 | 1 | 1k | Digi-Key | YAG1237CT-ND | YAGEO | RT0603BRD071KL | 0603 (1608 Metric) | SMD | 1 kOhms ±0.1% 0.1W, 1/10W Chip Resistor 0603 (1608 Metric) Thin Film
28 | R8 | 1 | 180 | Digi-Key | A129679CT-ND | TE Connectivity Passive Product | CRGCQ0603F180R | 0603 (1608 Metric) | SMD | 180 Ohms ±1% 0.1W, 1/10W Chip Resistor 0603 (1608 Metric) Automotive AEC-Q200, Moisture Resistant Thick Film
29 | R9,R16 | 2 | 330k | Digi-Key | P330KDBCT-ND | Panasonic Electronic Components | ERA-3AEB334V | 0603 (1608 Metric) | SMD | 330 kOhms ±0.1% 0.1W, 1/10W Chip Resistor 0603 (1608 Metric) Automotive AEC-Q200 Thin Film
30 | R10 | 1 | 15k | Digi-Key | P15KDBCT-ND | Panasonic Electronic Components | ERA-3AEB153V | 0603 (1608 Metric) | SMD | 15 kOhms ±0.1% 0.1W, 1/10W Chip Resistor 0603 (1608 Metric) Automotive AEC-Q200 Thin Film
31 | R12 | 1 | 20k | Digi-Key | P20KDBCT-ND | Panasonic Electronic Components | ERA-3AEB203V | 0603 (1608 Metric) | SMD | 20 kOhms ±0.1% 0.1W, 1/10W Chip Resistor 0603 (1608 Metric) Automotive AEC-Q200 Thin Film
32 | R13 | 1 | 5k | Digi-Key | 13-RT0603BRE075KLCT-ND | YAGEO | RT0603BRE075KL | 0603 (1608 Metric) | SMD | 5 kOhms ±0.1% 0.1W, 1/10W Chip Resistor 0603 (1608 Metric) Thin Film
33 | R14 | 1 | 49.9 | Digi-Key | P49.9HCT-ND | Panasonic Electronic Components | ERJ-3EKF49R9V | 0603 (1608 Metric) | SMD | 49.9 Ohms ±1% 0.1W, 1/10W Chip Resistor 0603 (1608 Metric) Automotive AEC-Q200 Thick Film
34 | R17,R18,R19,R20,R27,R34,R35 | 7 | 24.9 | Digi-Key | 13-RT0603FRE0724R9LCT-ND | YAGEO | RT0603FRE0724R9L | 0603 (1608 Metric) | SMD | 24.9 Ohms ±1% 0.1W, 1/10W Chip Resistor 0603 (1608 Metric) Thin Film
35 | R21 | 1 | 8k | Digi-Key | 13-RT0603BRE078KLCT-ND | YAGEO | RT0603BRE078KL | 0603 (1608 Metric) | SMD | 8 kOhms ±0.1% 0.1W, 1/10W Chip Resistor 0603 (1608 Metric) Thin Film
36 | R22,R23,R36,R37 | 4 | 100k | Digi-Key | P100KDBCT-ND | Panasonic Electronic Components | ERA-3AEB104V | 0603 (1608 Metric) | SMD | 100 kOhms ±0.1% 0.1W, 1/10W Chip Resistor 0603 (1608 Metric) Automotive AEC-Q200 Thin Film
37 | R24 | 1 | 49.9k | Digi-Key | TNP49.9KAACT-ND | Vishay Dale | TNPW060349K9BEEA | 0603 (1608 Metric) | SMD | 49.9 kOhms ±0.1% 0.21W Chip Resistor 0603 (1608 Metric) Anti-Sulfur, Automotive AEC-Q200, Moisture Resistant Thin Film
38 | R25,R26,R29 | 3 | -- mixed values -- | Digi-Key | P24.9KDCCT-ND | Panasonic Electronic Components | ERA-2AEB2492X | 0402 (1005 Metric) | SMD | 24.9 kOhms ±0.1% 0.063W, 1/16W Chip Resistor 0402 (1005 Metric) Automotive AEC-Q200 Thin Film
39 | R28 | 1 | 196 | Digi-Key | P196DBCT-ND | Panasonic Electronic Components | ERA-3AEB1960V | 0603 (1608 Metric) | SMD | 196 Ohms ±0.1% 0.1W, 1/10W Chip Resistor 0603 (1608 Metric) Automotive AEC-Q200 Thin Film
40 | R30,R32 | 2 | 120 | Digi-Key | P120DBCT-ND | Panasonic Electronic Components | ERA-3AEB121V | 0603 (1608 Metric) | SMD | 120 Ohms ±0.1% 0.1W, 1/10W Chip Resistor 0603 (1608 Metric) Automotive AEC-Q200 Thin Film
41 | R31,R33 | 2 | 49.9 | Digi-Key | 541-2031-1-ND | Vishay Dale | TNPW060349R9BEEA | 0603 (1608 Metric) | SMD | 49.9 Ohms ±0.1% 0.21W Chip Resistor 0603 (1608 Metric) Anti-Sulfur, Automotive AEC-Q200, Moisture Resistant Thin Film
42 | R38,R39 | 2 | 150 | Digi-Key | P150DBCT-ND | Panasonic Electronic Components | ERA-3AEB151V | 0603 (1608 Metric) | SMD | 150 Ohms ±0.1% 0.1W, 1/10W Chip Resistor 0603 (1608 Metric) Automotive AEC-Q200 Thin Film
43 | R42 | 1 | 49.9k | Digi-Key | TNPU49.9KBACT-ND | Vishay Dale | TNPU060349K9BZEN00 | 0603 (1608 Metric) | SMD | 49.9 kOhms ±0.1% 0.1W, 1/10W Chip Resistor 0603 (1608 Metric) Anti-Sulfur, Automotive AEC-Q200, Moisture Resistant Thin Film
44 | U1,U4 | 2 | PDQ10-Q24-S5-D | Digi-Key | PDQ30-Q24-S5-D | CUI Inc. | 102-3891-ND | DIP-6 CUI | Through Hole | Isolated Module DC DC Converter 1 Output 5V 6A 9V - 36V Input
45 | U2,U7 | 2 | LT3080EST-PBF | Digi-Key | 505-LT3080EST#PBF-ND | Analog Devices Inc. | LT3080EST#PBF | SOT223-3 | SMD | IC REG LIN POS ADJ 1.1A SOT223-3
46 | U3 | 1 | SN65LVDS2DBVR | Digi-Key | 296-6920-1-ND | Texas Instruments | SN65LVDS2DBVR | SOT-23-5 | SMD | 0/1 Receiver LVDS SOT-23-5
47 | U5,U6 | 2 | INA286 | Digi-Key | 296-43593-1-ND | Texas Instruments | INA286AIDR | 8-SOIC | SMD | IC CURRENT MONITOR 0.4% 8SOIC
48 | U8 | 1 | AD590JRZ-RL | Digi-Key | AD590JRZ-ND | Analog Devices Inc. | AD590JRZ | 8-SOIC | SMD | SENSOR ANALOG -55C-150C 8SOIC
49 | U9 | 1 | LM337IMPX/NOPB | Mouser | 926-LM337IMPX/NOPB | Texas Instruments | LM337IMPX/NOPB | SOT223-4 | SMD | Linear Voltage Regulators 3-Term Adj Neg Reg A 926-LM337IMP/NOPB
50 | U10 | 1 | LTC2050HVCS5-TRMPBF | Digi-Key | 505-LTC2050HVCS5#TRMPBFCT-ND | Analog Devices Inc. | LTC2050HVCS5#TRMPBF | TSOT23-5 | SMD | IC OPAMP ZER-DRIFT 1CIR TSOT23-5
51 | U11 | 1 | LTC2051H | Digi-Key | LTC2051HVCS8#TRPBFCT-ND | Analog Devices Inc. | LTC2051HVCS8#TRPBF | 8-SOIC | SMD | IC OPAMP ZERO-DRIFT 2 CIRC 8SOIC
52 | V_{EN} | 1 | TestPoint | Digi-Key | 36-5005-ND | Keystone Electronics | 5005 |  | Through Hole | Red PC Test Point, Compact Phosphor Bronze Silver Plating Through Hole Mounting Type
