rjridle/GRAMS/2_Schematics_and_Layout/2_WARM_TPC/10_WARM_TPC_Shaper/BOM/BOM_WARM_TPC_Shaper.xlsx

Qty | Reference | Value | Footprint | DNP | Manufacturer | Distributor | Dist. Part Num | Notes | Package | Part Type
7 | C1,C18,C21,C22,C65,C66,C67 | 100uF,10uF,1uF | Capacitor_Tantalum_SMD:CP_EIA-2012-12_Kemet-R,Capacitor_Tantalum_SMD:CP_EIA-3216-12_Kemet-S,Capacitor_Tantalum_SMD:CP_EIA-7343-20_Kemet-V |  | KYOCERA AVX | Digi-Key | 478-1655-1-ND,478-1723-1-ND,478-8927-1-ND |  | 0805 (2012 Metric),1206 (3216 Metric),2917 (7343 Metric) | SMD
25 | C2,C7,C9,C14,C24,C27,C30,C33,C36,C39,C42,C45,C48,C51,C54,C57,C60,C63,C64,C68,C69,C71,C72,C73,C74 | 0.1uF,1uF | Capacitor_SMD:C_0402_1005Metric,Capacitor_SMD:C_0603_1608Metric |  | Samsung Electro-Mechanics | Digi-Key | 1276-1019-1-ND,1276-1445-1-ND,1276-6720-1-ND |  | 0402 (1005 Metric),0603 (1608 Metric) | SMD
43 | C3,C4,C5,C6,C8,C10,C11,C12,C13,C15,C16,C17,C19,C23,C25,C26,C28,C29,C31,C32,C34,C35,C37,C38,C40,C41,C43,C44,C46,C47,C49,C50,C52,C53,C55,C56,C58,C59,C61,C62,C70,C75,C76 | 0.01uF,0.1uF | Capacitor_SMD:C_0402_1005Metric,Capacitor_SMD:C_0603_1608Metric |  | KEMET | Digi-Key | 399-C0402C103K5RACTUCT-ND,399-C0603C103K5RACTUCT-ND,399-C0603C104K5RAC7411CT-ND |  | 0402 (1005 Metric),0603 (1608 Metric) | SMD
1 | C20 | 2.2uF | Capacitor_Tantalum_SMD:CP_EIA-3216-12_Kemet-S |  | Vishay Sprague | Digi-Key | 718-1131-1-ND |  | 1206 (3216 Metric) | SMD
2 | D2,D3 | 1SMB5915BT3G | ONSemi:DIOM5436X247N |  | onsemi | Digi-Key | 1SMB5915BT3GOSCT-ND |  | Surface Mount SMB | SMD
2 | F1,F5 | Fuse | Resistor_SMD:R_1206_3216Metric |  | 0438001.WR | Digi-Key | F2947CT-ND |  | 0603 (1608 Metric) | SMD
1 | J1 | M83513/10-E01CP | Cinch_Connectivity:BEL_M83513_10-E01CP |  | ITT Cannon, LLC | Digi-Key | IM83513/10-E01CP-ND |  | - | Through Hole
4 | J2,J15,LED1,LED2 | 150060AS75000,618009231121,618009231221 | Wurth_Elektronik:618009231121,Wurth_Elektronik:618009231221,Wurth_Elektronik:LED_0AS75000_WRE |  | Wurth Elektronik | Digi-Key | 732-150060AS75000CT-ND,732-618009231121-ND,732-618009231221-ND |  | -,0603 (1608 Metric),None | SMD,Through Hole
12 | J3,J4,J5,J6,J7,J8,J9,J10,J11,J12,J13,J14 | RF2-49B-T-00-50-G-HDW | Adam_Tech:CONN_RF2-49B-T-00-50-G-HDW_ADM |  | Adam Tech | Digi-Key | 2057-RF2-49B-T-00-50-G-HDW-ND |  | - | Through Hole
4 | L1,L2,L9,L10 | 1.5uH | CoilCraft:MLC1538- |  | Coil Craft | Coil Craft | MLC1538-152ML_ |  | - | SMD
6 | M1,M2,M3,M4,M5,M6 | SSM3K15AFS_LF | Toshiba_Semi:SSM_TOS |  | Toshiba Semiconductor and Storage | Digi-Key | SSM3K15AFSLFCT-ND |  | Surface Mount SSM | SMD
4 | P1,P2,P3,P4 | 1-1123824-1 | TE_Connectivity:conn1_1-1123824-1_TEC |  | TE Connectivity AMP Connectors | Digi-Key | A30708-ND |  | - | Through Hole
1 | Q1 | ISP281D | ISOCOM:ISP281D_ISO |  | Isocom Components 2004 LTD | Digi-Key | 58-ISP281DCT-ND |  | 4-SOP | SMD
12 | R1,R2,R3,R4,R5,R6,R7,R8,R9,R10,R11,R12 | FCSL20R010FER | Foil_Resistors:RES_FCSL20_OHM-L |  | Ohmite | Digi-Key | FCSL20R010FERCT-ND |  | 0805 (2012 Metric) | SMD
12 | R13,R26,R33,R40,R51,R52,R59,R64,R65,R66,R72,R76 | 10k,15k | Resistor_SMD:R_0402_1005Metric,Resistor_SMD:R_0603_1608Metric |  | Panasonic Electronic Components | Digi-Key | P10KDCCT-ND,P15KDBCT-ND |  | 0402 (1005 Metric),0603 (1608 Metric) | SMD
32 | R14,R15,R16,R17,R18,R19,R20,R21,R22,R23,R24,R25,R27,R29,R30,R31,R34,R35,R36,R41,R42,R43,R44,R45,R46,R49,R50,R56,R57,R58,R71,R77 | 10,100k,120,150,180,196,49.9 | Resistor_SMD:R_0603_1608Metric |  | Vishay Dale | Digi-Key | 541-2031-1-ND,541-3165-1-ND,541-4531-1-ND,541-TNPW0603150RBYENCT-ND,541-TNPW0603196RBEEACT-ND,TNP10.0AACT-ND,TNP100KAACT-ND |  | 0603 (1608 Metric) | SMD
12 | R28,R54,R62,R63,R67,R68,R69,R70,R74,R75,R78,R79 | 1k,24.9,330k,5k,845,8k | Resistor_SMD:R_0402_1005Metric,Resistor_SMD:R_0603_1608Metric |  | YAGEO | Digi-Key | 13-RT0603BRE075KLCT-ND,13-RT0603BRE078KLCT-ND,13-RT0603FRE0724R9LCT-ND,311-24.9LRCT-ND,311-330KGRCT-ND,311-845HRCT-ND,YAG1237CT-ND |  | 0402 (1005 Metric),0603 (1608 Metric) | SMD
7 | R32,R38,R39,R53,R60,R61,R73 | 10k | Resistor_SMD:R_0603_1608Metric |  | Stackpole Electronics Inc | Digi-Key | RNCP0603FTD10K0CT-ND |  | 0603 (1608 Metric) | SMD
1 | R37 | 5.97k | Resistor_SMD:R_0603_1608Metric |  | KOA Speer Electronics, Inc. | Digi-Key | 2019-RN73R1JTTD5971B25CT-ND |  | 0603 (1608 Metric) | SMD
2 | R47,R48 | 10 | Resistor_SMD:R_0805_2012Metric |  | TE Connectivity Passive Product | Digi-Key | A126420CT-ND |  | 0805 (2012 Metric) | SMD
1 | R55 | (DNI) | Resistor_SMD:R_0603_1608Metric | DNP
7 | SEC_{RTN}1,SEC_{RTN}2,TELEM_{+5V}1,TELEM_{-5V}1,TELEM_{RTN}1,TELEM_{RTN}2,V_{EN}1 | TestPoint | TestPoint:TestPoint_Keystone_5005-5009_Compact |  | Keystone Electronics | Digi-Key | 36-5005-ND |  | - | Through Hole
2 | U1,U2 | PDQ10-Q24-S3-D | CUI:CONV_PDQ10-Q24-S3-D |  | CUI Inc. | Digi-Key | 102-3868-ND |  | DIP-6 CUI | Through Hole
6 | U3,U16,U17,U18,U20,U22 | AD590JRZ-RL,LT3080EST-PBF,LTC2050HVCS5-TRMPBF,LTC2051HVCS5-TRMPBF | Analog_Devices:R_8_ADI,Analog_Devices:SOT-3_ST_LIT,Analog_Devices:S_5_ADI |  | Analog Devices Inc. | Digi-Key | 505-LT3080EST#PBF-ND,505-LTC2050HVCS5#TRMPBFCT-ND,AD590JRZ-ND,LTC2051HVIS8#TRPBFCT-ND |  | 8-SOIC,SOT-223-3,TSOT-23-5 | SMD
14 | U4,U5,U6,U7,U8,U9,U10,U11,U12,U13,U14,U15,U19,U21 | INA286,LM337IMPX/NOPB,SN65LVDS2DBVR | Texas_Instruments:DBV5,Texas_Instruments:INA28x_8SOIC,Texas_Instruments:LM337IMPX |  | Texas Instruments | Digi-Key | 296-43593-1-ND,296-6920-1-ND,LM337IMPX/NOPBCT-ND |  | 8-SOIC,SOT-223-4,SOT-23-5 | SMD
