rjridle/GRAMS/3_Documentation/PDU_Table.xlsx

Sheet: PDU Harnessing
List of Harnesses
Box 1 | Board |  | Harness # |  | Box 2 | Designators on Board |  |  |  | Description
 | Con - 1 | Con - 2 |  |  |  | Con - 1 |  | Con - 2
 | Battery Pack | MPD | P - 1 | P - 1 |  |  |  | P1 | 25-FDSUB | Main Power from Battery is routed into the PDU here
Main PDU Box | 0_MAIN_PDU | 1_COLD_TPC_SiPM_and_TELEM_PDU | P - 2 | P - 2 | Cold TPC SiPM Bias Box | J2 | 9-FDSUB | J1 | 9-MDSUB
 | 0_MAIN_PDU | 3_COLD_TPC_TELEM_PM5V_PDU | P - 4 | P - 4 | COLD TPC SiPM & Charge Pre Amp Box | J4 | 9-FDSUB | J1 | 9-MDSUB
 |  | 4_COLD_TPC_SiPM_PRE_AMP | P - 3 | P - 3 |  | J3 | 9-FDSUB | J1 | 9-MDSUB
 |  | 5_COLD_TPC_CHARGE_PRE_AMP | P - 5 | P - 5 |  | J5 | 9-FDSUB | J1 | 9-MDSUB
 | 0_MAIN_PDU | 6_COLD_TPC_HV | P - 6 | P - 6 | COLD TPC HV Box | J6 | 9-FDSUB | J1 | 9-MDSUB
 |  |  | P - 7 | P - 7 |  | J7 | 9-MDSUB | J2 | 9-FDSUB
 | 0_MAIN_PDU | 7_WARM_TPC_CAEN_NEVIS_DAQ_P3V3 | P - 11 | P - 11 | WARM TPC DAQ PDU Box | J11 | 9-FDSUB | J2 | 9-MDSUB
 |  | 8_WARM_TPC_CAEN_NEVIS_DAQ_12V | P - 10 | P - 10 |  | J10 | 9-FDSUB | J1 | 9-MDSUB
 |  | 9_WARM_TPC_CAEN_NEVIS_DAQ_PM5V | P - 8 | P - 8 |  | J8 | 9-FDSUB | J2 | 9-MDSUB
 |  |  | P - 9 | P - 9 |  | J9 | 9-FDSUB | J3 | 9-MDSUB
 | 0_MAIN_PDU | 10_WARM_TPC_SHAPER | P - 12 | P - 12 | WARM TPC Shaper Box | J12 | 9-FDSUB | J2 | 9-MDSUB
 | 0_MAIN_PDU | 11_CPU_PDU | P - 15 | P - 15 | CPU & TOF Box | J15 | 9-FDSUB | J1 | 9-MDSUB
 |  |  | P - 16 | P - 16 |  | J16 | 9-FDSUB | J2 | 9-MDSUB
 |  |  | P - 14 | P - 14 |  | J14 | 9-FDSUB | J3 | 9-MDSUB
 |  |  | P - 17 | P - 17 |  | J17 | 9-FDSUB | J4 | 9-MDSUB
 |  |  | P - 18 | P - 18 |  | J18 | 9-FDSUB | J5 | 9-MDSUB
 |  |  | P - 20 | P - 20 |  | J20 | 9-FDSUB | J13 | 9-MDSUB
 |  | 12_TOF_PDU | P - 13 | P - 13 |  | J13 | 9-FDSUB | J1 | 9-MDSUB
 |  |  | P - 14 | P - 14 |  | J14 | 9-FDSUB | J2 | 9-MDSUB
 | 0_MAIN_PDU | 13_COMMS | P - 21 | P - 21 | COMMS and HUB Box | J21 | 9-FDSUB | J1 | 9-MDSUB
COLD TPC SiPM Bias Box | 1_COLD_TPC_SiPM_and_TELEM_PDU | 0_MAIN_PDU | P1 | P1 | Main PDU Box | J1 | 9-MDSUB | J2 | 9-FDSUB
 |  | 2_COLD_TPC_SiPM_BIAS_PDU | W - 102 | W - 102 | COLD TPC SiPM Bias Box | J2 | 7-TBLK | J1 | 3-TBLK
 |  |  |  |  |  |  |  | J2 | 4-TBLK
 |  |  | W - 103 | W - 103 |  | J3 | 7-TBLK | J1 | 3-TBLK
 |  |  |  |  |  |  |  | J2 | 4-TBLK
 |  |  | W - 104 | W - 104 |  | J4 | 7-TBLK | J1 | 3-TBLK
 |  |  |  |  |  |  |  | J2 | 4-TBLK
 |  |  | W - 105 | W - 105 |  | J5 | 7-TBLK | J1 | 3-TBLK
 |  |  |  |  |  |  |  | J2 | 4-TBLK
 |  |  | W - 106 | W - 106 |  | J6 | 7-TBLK | J1 | 3-TBLK
 |  |  |  |  |  |  |  | J2 | 4-TBLK
 |  |  | W - 107 | W - 107 |  | J7 | 7-TBLK | J1 | 3-TBLK
 |  |  |  |  |  |  |  | J2 | 4-TBLK
 |  |  | W - 100 | T1
 |  |  | W - 101 | T2
 |  |  |  |  | To Load
COLD TPC SiPM & Charge Pre-Amp Box |  |  | W - 202 | W - 202 |  | J?
 |  |  | W - 203 | W - 203 |  | J?
WARM TPC DAQ PDU Box |  |  | W - 203 | W - 203 |  | J?
 |  |  | W - 204 | W - 204 |  | J?
 |  |  | W - 205 | W - 205 |  | J?
 |  |  | W-300 | W-300
 |  |  | W-301 | W-301
 |  |  | W - 400 | W - 400
 |  |  | W - 500 | W - 500
 |  |  | W - 501 | W - 501
 |  |  | W - 502 | W - 502
 |  |  | W - 503 | W - 503
 |  |  | W - 504 | W - 504
 |  |  | W - 505 | W - 505
 |  |  | W - 506 | W - 506
 |  |  | W - 507 | W - 507
 |  |  | W - 508 | W - 508
 | Harness Descriptions
 | Designator | Description |  |  |  |  |  |  |  | Terminations | Comments / Questons
 | P1 | High Voltage Bias (0V to -10kV) |  |  |  |  |  |  |  | SHV Cable and Terminations
 | P2 | +/- 5V (6Watts) 200 Channels |  |  |  |  |  |  |  | Plan to use D-Sub Harnessing | How are these fanned out?
 | P3 | CAEN, +/- 12V (96-Watts) |  |  |  |  |  |  |  | Plan to use D-Sub Harnessing
 | P4 | CAEN, +/- 5V (50 Watts) |  |  |  |  |  |  |  | Plan to use D-Sub Harnessing
 | P5 | CAEN, +/- 3.3V (33 Watts) |  |  |  |  |  |  |  | Plan to use D-Sub Harnessing
 | P6 | u-Boon, +/- 12V (60 Watts) |  |  |  |  |  |  |  | Plan to use D-Sub Harnessing
 | P7 | u-Boon, +/- 5V (5.6 Watts) |  |  |  |  |  |  |  | Plan to use D-Sub Harnessing
 | P8 | u-Boon, +/- 3.3V (55 Watts) |  |  |  |  |  |  |  | Plan to use D-Sub Harnessing
 | P9 | u-Boon, +/- 12V (58 Watts) |  |  |  |  |  |  |  | Plan to use D-Sub Harnessing
 | P10 | u-Boon, +/- 5V (13 Watts) |  |  |  |  |  |  |  | Plan to use D-Sub Harnessing
 | P11 | Shaper, +/- 3.3V (0.5 W) |  |  |  |  |  |  |  | SMA Cabling
 | P12 | Shaper, +/- 3.3V (0.5 W) |  |  |  |  |  |  |  | SMA Cabling
 | P13 | Shaper, +/- 3.3V (0.5 W) |  |  |  |  |  |  |  | SMA Cabling
 | P14 | Shaper, +/- 3.3V (0.5 W) |  |  |  |  |  |  |  | SMA Cabling
 | P15 | Shaper, +/- 3.3V (0.5 W) |  |  |  |  |  |  |  | SMA Cabling
 | P16 | Shaper, +/- 3.3V (0.5 W) |  |  |  |  |  |  |  | SMA Cabling
 | P17 | SiPM HV Supply (Adjustable) (0.5W) |  |  |  |  |  |  |  | SMA Cabling
 | P18 | SiPM HV Supply (Adjustable) (0.5W) |  |  |  |  |  |  |  | SMA Cabling
 | P19 | SiPM HV Supply (Adjustable) (0.5W) |  |  |  |  |  |  |  | SMA Cabling
 | P20 | SiPM HV Supply (Adjustable) (0.5W) |  |  |  |  |  |  |  | SMA Cabling
 | P21 | SiPM HV Supply (Adjustable) (0.5W) |  |  |  |  |  |  |  | SMA Cabling
 | P22 | SiPM HV Supply (Adjustable) (0.5W) |  |  |  |  |  |  |  | SMA Cabling
 | P23 | SiPM HV Supply (Adjustable) (0.5W) |  |  |  |  |  |  |  | SMA Cabling
 | P24 | SiPM HV Supply (Adjustable) (0.5W) |  |  |  |  |  |  |  | SMA Cabling
 | P25 | SiPM HV Supply (Adjustable) (0.5W) |  |  |  |  |  |  |  | SMA Cabling
 | P26 | TOF/MPD (96 Watts) |  |  |  |  |  |  |  | Plan to use D-Sub Harnessing
 | Total Power Calculation
 | HV Bias | 0.001
 | Cold TPC Pre-Amp | 6
 | CAEN | 96
 |  | 50
 |  | 33
 | u-Boon | 60
 |  | 5.6
 |  | 55
 |  | 58
 |  | 13
 | Shaper | 3
 | SiPM HV Supply | 4.5
 | TOF/MPD | 96
 |  | 480.101

Sheet: PDU Converter Efficiency
 |  |  |  |  | Input Power Calculations (Cold TPC SiPM Bias Box)
 |  |  |  |  | Board Name | Output Power (W) | DC-DC Converter | % of Load | Efficiency (%) | Input Power (W)
 |  |  |  |  | 1_COLD_TPC_SiPM_and_TELEM_PDU | 6.435 | PDQ10-Q24-S5-D | 0.6435 | 0.84 | 7.4646
 |  |  |  |  | 2_COLD_TPC_SiPM_BIAS_PDU | 20.5 | 1/16A12-P4-I5 |  | 0.8 | 24.6
 |  |  |  |  |  |  |  |  | Total: | 32.0646
 |  |  |  |  | Input Power Calculations (Cold TPC SiPM and Charge Pre-Amp Box)
 |  |  |  |  | Board Name | Output Power (W) | DC-DC Converter | % of Load | Efficiency (%) | Input Power (W)
 |  |  |  |  | 3_COLD_TPC_TELEM_PM5V_PDU
 |  |  |  |  | 4_COLD_TPC_SiPM_PRE_AMP | 3.35 |  |  | 0.8 | 22.2W
 |  |  |  |  | 5_COLD_TPC_CHARGE_PRE_AMP | 20 |  |  | 0.9 | 5.72W
 |  |  |  |  |  |  |  |  | Total: | 31.16W
Input Power Calculations (Cold TPC Section) - Telemetry
Board Name | Output Power | Efficiency | Input Power
HV Board (Telem) | 2W | 0.9 | 2.1W
Charge Pre-Amp PDU Board (Telem) | 2W | 0.9 | 2.1W
SiPM Pre-Amp PDU Board (Telem) | 2.25W | 0.8 | 2.8W
SiPM Bias Board (Telem) (x6) | 3.47W | 0.9 | 3.85W
 |  | Total: | 10.85W
Input Power Calculations (Cold TPC Section) - Telemetry |  |  |  |  |  |  |  |  |  |  | Input Power Calculations (Cold TPC SiPM Bias Box)
Board Name | Output Power | Efficiency | Input Power |  |  |  |  |  |  |  | Board Name | Output Power | Efficiency | Input Power
HV Board (Telem) | 2W | 0.9 | 2.1W
Charge Pre-Amp PDU Board (Telem) | 2W | 0.9 | 2.1W |  |  |  |  |  |  |  | HV Board | Negligible
SiPM Pre-Amp PDU Board (Telem) | 2.25W | 0.8 | 2.8W
SiPM Bias Board (Telem) (x6) | 3.47W | 0.9 | 3.85W
 |  | Total: | 10.85W
Converter | QSB40024S12 | PDQ10-Q24-S5-D | 1/16A12-P4-I5
Vin (V) | 24 | 12 | 12
Vout (V) | 12 | 5 | 54 | Average Vout
Max Input Current (A) | 19.36 | 1.53 | 0.40
Max Output Current (A) | 33.3 | 2 | 0.064
Max Output Power (W) | 399.6 | 10 | 3.456
% of load | Efficiency (%)
0.1 | 0.77 | 0.5 | 0.83
0.2 | 0.84 | 0.65 | 0.83
0.3 | 0.85 | 0.75 | 0.83
0.4 | 0.85 | 0.78 | 0.83
0.5 | 0.86 | 0.81 | 0.83
0.6 | 0.86 | 0.84 | 0.83
0.7 | 0.86 | 0.84 | 0.83
0.8 | 0.86 | 0.84 | 0.83
0.9 | 0.86 | 0.84 | 0.83
1 | 0.86 | 0.84 | 0.83

Sheet: PDU Power Demand
PDU Maximum and Nominal Power Budget
KEY | Cells in Yellow need to be added/verified |  |  |  | Cells in Blue will auto-calculate once the values are entered |  |  |  |  |  | Cells in Red have not been reviewed yet
Maximum Outputs
Estimate based on the maximum possible required throughout the entire operation including ground testing
TPC cold | HV | 1 | 1 | 10000 | 5e-07 | 0.005 | 5e-07 | 0.005 | Reviewing | JC/Nabin |  | Total Power Demand on Main DC-DC Converter Box
 | Charge PreAmp | 1 | 1 | 5 | 2 | 10 | 2 | 10 | Reviewing | JC/Robin |  | Box | Boards | # Channels | Voltage (V) | Max Current (A) | Max Power (W)
 |  | 1 | 1 | -5 | 2 | 10 | 2 | 10 | Reviewing |  |  | Cold TPC HV | HV | 2x input 9-DSUB | V_SEC_IN (+12V)
 | SiPM PreAmp | 1 | 3 | (bezier |  |  | 0.54 | 1.35 | Reviewing | Jonathan LeyVa | Power figures need to be re-checked once SiPM power board with LDO's are incorporated into circuit. Current SiPM Bias board only has +/-5V so it will need a redesign |  |  | output 1-JACK | P5V (+5V) | 5e-07 | 0.005
 |  | 1 | 3 |  | (pts |  | 0.54 | 2.7 | Reviewing |  |  | Cold TPC SiPM Bias | SiPM_and_TELEM_PDU | input 9-DSUB | V_SEC_IN (+12V)
 | SiPM Bias (6x) | 1 | 18 |  |  | (xy 694.69 336.55) (xy 688.34 327.66) (xy 679.45 322.58) (xy 673.1 336.55) | 0.36 | 19.44 | Reviewing |  | This power figure is based on peak ratings for PETsys bias card (info from Makoto) which is expected to be much larger than required for pGRAMS |  |  | 7x output 7-TBLK | V_SEC_OUT (+12V) & SEC_SiPM_PWR (+5V) | Sends to SiPM_BIAS_PDU
TPC warm | CAEN-NEVIS +/-5V DAQ PDU | 1 | 1 |  | ) |  | 11.66 | 58.3 | Checked | Jon Sensenig/Nabin | This shows maximum possible current with different configurations of DAQ +12/+5/+3.3V (Max currents: 0.7/6.5/12.1A) for CAEN light system only-NABIN +12/+5/-5/+3.3V(Max currents: 1.993/0.941/1.993/8.522) for Nevis DAQ system combined +12/+5/-5/+3.3V (Max currents: 3.67/5.16/2.47/8.46) for Nevis DAQ system combined (update 03/05/2025 Jon) (Optional: Can replace 3.3V with 2.3V to reduce power usage 2.3V @ 8.21A) |  | 6x SiPM_BIAS_PDU | input 3-TBLK | V_SEC_IN (+12V)
 |  | 1 | 1 |  | (stroke (width 0.5) (type default) (color 255 0 0 1)) |  | 2.47 | 12.35 | Checked |  |  |  |  | input 4-TBLK | V_SEC_OUT (+12V) & SEC_SiPM_PWR (+5V)
 | CAEN-NEVIS 12V DAQ PDU | 1 | 1 |  | (fill (type none)) |  | 4.37 | 52.44 | Checked |  |  |  |  | output 1-JACK | SiPM_HV_OUT (+54V) | 0.02 x 6 = 0.12 | 6.48
 | CAEN-NEVIS 3.3V DAQ PDU | 1 | 1 |  | (uuid fc31c553-8c7b-4d46-a089-f27eee51e3f5) |  | 20.56 | 67.848 | Checked |  |  | Cold TPC SiPM Charge & Pre-Amp | TELEM_PM5V_PDU | input 9-DSUB | V_SEC_IN (+12V)
 | Shaper | 6 | 180 | ) |  |  | 0.45 | 8.91 | Reviewing | Svanik |  |  |  | output 9-DSUB | P5_OUT (+5V) | 8.493 | 42.465
 |  | 6 | 180 | -3.3 | 0.0025 | 1.485 | 0.45 | 8.91 | Reviewing |  |  |  |  | output 9-DSUB | M5_OUT (-5V) | 1.993 | 9.965
CPU | Sabertooth | 1 | 1 | 12 | 4 | 4 | 4 | 48 | Checked | Jon Sensenig | ~~based on guess, assuming this is also coming from ATX 24-pin connector for mother board~~ |  | SiPM_PRE_AMP | input 9-DSUB | V_SEC_IN (+12V)
 | PCIe Bifurcator | 1 | 1 | 12 | 2 | 2 | 2 | 24 | Checked |  | based on preliminary measurements with flight equivalent electronics setup at 500Hz event rate |  |  | input 9-DSUB | PM5_TELEM (+/-5V)
 | Saberthooth IO | 1 | 1 | 3.3 | 0.5 | 0.5 | 0.5 | 1.65 | Checked |  |  |  |  | output 1-JACK | P5V_OUT (+5V) | 0.54 | 2.7
 | SSD | 1 | 1 | 5 | 1 | 1 | 1 | 5 | Checked |  |  |  |  | output 1-JACK | M5V_OUT (-5V) | 0.54 | 2.7
TOF/MPD | TOF / MPD | 1 | 1 | 12 | 4 | 48 | 4 | 48 | Checked | Makoto / Nick |  |  | SiPM_CHARGE_PRE_AMP | input 9-DSUB | V_SEC_IN (+12V)
 | TOF bias | 2 | 2 | 5 | 3 | 15 | 6 | 30 | Reviewing | Luke |  |  |  | input 9-DSUB | PM5_TELEM (+/-5V)
Flight computer | Hub Computer | 1 | 1 | 5 | 1 | 5 | 5 | 5 | Reviewing | Robin/Shota | 2W from running nothing, ATX 24-pin connector for mother board |  |  | output 1-JACK | P5V_OUT (+5V) | 2 | 10
 |  |  |  |  |  | Total | 67.9 | 413.903 |  |  |  |  |  | output 1-JACK | M5V_OUT (-5V) | 2 | 10
 |  |  |  |  |  |  |  |  |  |  |  | Warm TPC DAQ | CAEN_NEVIS_DAQ_PM5V | 2x input 9-DSUB | V_SEC_IN (+12V)
 |  |  |  |  |  |  |  |  |  |  |  |  |  | output 9-DSUB | P5_OUT (+5V) | 8.493 | 42.465
 |  |  |  |  |  |  |  |  |  |  |  |  |  | output 9-DSUB | M5_OUT (-5V) | 1.993 | 9.965
 |  |  |  |  |  |  |  |  |  |  |  |  | CAEN_NEVIS_DAQ_12V | 2x input 9-DSUB | V_SEC_IN (+12V)
Nominal/Flight Outputs |  |  |  |  |  |  |  |  |  |  |  |  |  | output 1-JACK | P12V_OUT (+12V) | 4.422 | 53.064
Estimate for flight operation |  |  |  |  |  |  |  |  |  |  |  |  | CAEN_NEVIS_DAQ_P3V3 | 2x input 9-DSUB | V_SEC_IN (+12V)
 | PDU Subsystem | # of Outputs | # of channels | Voltage (V) | Nom Channel Current (A) | Nom Channel Power (W) | Nom PDU Current (A) | Nom PDU Power (W) | Status | Check Person | Comments |  |  | output 1-JACK | V_3V3_SUPPLY (+3.3V) | 20.622 | 68.0526
TPC cold | HV | 1 | 1 | 10000 |  | 0 | 0 | 0 | Reviewing | JC/Nabin |  | Warm TPC Shaper | SHAPER | input 9-DSUB | V_SEC_IN (+12V)
 | Charge PreAmp | 1 | 1 | 5 |  | 0 | 0 | 0 | Reviewing | JC/Robin |  |  |  | input 9-DSUB | V_TELEM_IN (+/-5V)
 |  | 1 | 1 | -5 |  | 0 | 0 | 0 | Reviewing |  |  |  |  | 6x output 1-JACK | P_SHPR_x (+3.3V) | 0.0025 | 1.485
 | SiPM PreAmp | 1 | 3 | 2.5 |  | 0 | 0 | 0 | Reviewing | Jonathan LeyVa |  |  |  | 6x output 1-JACK | M_SHPR_x (-3.3V) | 0.0025 | 1.485
 |  | 1 | 3 | -5 |  | 0 | 0 | 0 | Reviewing |  |  | CPU & TOF | CPU | 6x input 9-DSUB | V_SEC_IN (+12V)
 | SiPM Bias | 1 | 18 | 54 |  | 0 | 0 | 0 | Reviewing |  |  |  |  | output 15-DSUB | Sabertooth_P12V_OUT(+12V) | 4.16 | 50
TPC warm | CAEN-NEVIS +/-5V DAQ PDU | 1 | 1 | 5 | 5.1 | 25.5 | 5.1 | 25.5 | Checked | Jon Sensenig/Nabin |  |  |  | output 9-DSUB | PCIe_Bifurcation_12V_OUT (+12V) | 1
 |  | 1 | 1 | -5 | 2.47 | 12.35 | 2.47 | 12.35 | Checked |  |  |  |  | output 15-DSUB | SSD_5V_OUT(+5V) | 1
 | CAEN-NEVIS 12V DAQ PDU | 1 | 1 | 12 | 3.72 | 44.64 | 3.72 | 44.64 | Checked |  |  |  |  | output 9-DSUB | Sabertooth_IO (+12V, +5V, +3.3V) | 1
 | CAEN-NEVIS 3.3V DAQ PDU | 1 | 1 | 3.3 | 8.46 | 27.918 | 8.46 | 27.918 | Checked |  |  |  |  | output 1-JACK | HUB_5V_OUT (+5V) | 1 | 5
 | Shaper | 6 | 180 | 3.3 |  | 0 | 0 | 0 | Reviewing | Svanik |  |  | TOF | 2x input 9-DSUB | V_SEC_IN (+12V)
 |  | 6 | 180 | -3.3 |  | 0 | 0 | 0 | Reviewing |  |  |  |  | output 1-JACK | V_TOF_OUT (+12V) | 4 | 48
CPU | Sabertooth | 1 | 1 | 12 | 3.3 | 39.6 | 3.3 | 39.6 | Reviewing | Jon Sensenig |  |  |  | output 1-JACK | V_TOF_OUT (+12V) | 4 | 48
 | PCIe Bifurcator | 1 | 1 | 12 | 0.65 | 7.8 | 0.65 | 7.8 | Reviewing |  |  | Hub & Comms | Comms | input 9-DSUB | V_SEC_IN (+12V)
 | Saberthooth IO | 1 | 1 | 3.3 | 0.07 | 0.231 | 0.07 | 0.231 | Checked |  |  |  |  | misc outputs | N/A | 0.036 | 263
 | SSD | 1 | 1 | 5 | 1 | 5 | 1 | 5 | Checked |  |  | Current Draw @ 12V |  |  |  | 67.297 | Amps
TOF/MPD | TOF / MPD | 1 | 1 | 12 | 2 | 24 | 2 | 24 | Reviewing | Makoto / Nick |  | Total Power Needs |  |  |  | 5.6 | Watts
 | TOF bias | 2 | 2 | 5 | 1.5 | 7.5 | 3 | 15 | Reviewing | Luke
Flight computer | Hub computer | 1 | 1 | 5 |  | 0 | 0 | 0 | Reviewing | Robin/Shota
 |  |  |  |  |  | Total | 29.8 | 202.039
 |  |  |  |  |  | Estimated Nominal Output Power | 181.24W
 |  |  |  |  |  |  | 259.444
