rjridle/GRAMS/3_Documentation/6_Telemetry/Telemetry_Tables.xlsx

Sheet: Sheet1
COLD TPC List of Telemetry Points
Low Voltage Board (+2.5V / -5V)
Connector Designator | Type of Connector | Pin-Out Description |  | Equation | Units
 |  | Pin | Signal Name
J3 (On Board) | HD-DSUB Female 15 (P/N: 618015330923 Man: Wurth Electronik) | 1 | Enable - | - | None
 |  | 2 | Enable + | - | None
 |  | 3 | +2.5V Voltage Monitor | V = Value | Volts
 |  | 4 | -5.0V Voltage Monitor | V = -2*Value | Volts
 |  | 5 | +2.5V Current Monitor | I = Value | Amps
 |  | 6 | Telemetry RTN | - | None
 |  | 7 | Telemetry RTN | - | None
 |  | 8 | Telemetry RTN | - | None
 |  | 9 | Telemetry RTN | - | None
 |  | 10 | Telemetry RTN | - | None
 |  | 11 | Temperature Monitor | T = Value(125) | Kelvin
 |  | 12 | Telemetry RTN | - | None
 |  | 13 | Telemetry RTN | - | None
 |  | 14 | Telemetry RTN | - | None
 |  | 15 | -5.0V Current Monitor | I = Value | Amps
COLD TPC List of Telemetry Points
Pre-Amplifier PDU Board (+/- 5V)
Connector Designator | Type of Connector | Pin-Out Description |  | Equation | Units
 |  | Pin | Signal Name
J3 (On Board) | HD-DSUB Female 15 (P/N: 618015330923 Man: Wurth Electronik) | 1 | Temperature Monitor | T = Value(125) | Kelvin
 |  | 2 | -5V Voltage Monitor | V = (-Value * 2) | Volts
 |  | 3 | +5V Voltage Monitor | V = (Value * 2) | Volts
 |  | 4 | -5V Current Monitor | I = Value | Amps
 |  | 5 | +5V Current Monitor | I = Value | Amps
 |  | 6 | Telemetry RTN | - | None
 |  | 7 | Telemetry RTN | - | None
 |  | 8 | Telemetry RTN | - | None
 |  | 9 | Telemetry RTN | - | None
 |  | 10 | Telemetry RTN | - | None
 |  | 11 | N/C | - | None
 |  | 12 | N/C | - | None
 |  | 13 | N/C | - | None
 |  | 14 | Enable - | - | None
 |  | 15 | Enable + | - | None
COLD TPC List of Telemetry Points
High Voltage Board (Telemetry)
Connector Designator | Type of Connector | Pin-Out Description |  | Equation | Units
 |  | Pin | Signal Name
J3 (On Board) | HD-DSUB Female 15 (P/N: 618015330923 Man: Wurth Electronik) | 1 | Temp Monitor 1 | T = Value(125) | Kelvin
 |  | 2 | Temp Monitor 2 | T = Value(125) | Kelvin
 |  | 3 | N/C | - | None
 |  | 4 | HV Current Monitor | I = (8e-5)*Value | Amps
 |  | 5 | HV Set Value | HV = 13*Value | Volts
 |  | 6 | Telemetry RTN | - | None
 |  | 7 | Telemetry RTN | - | None
 |  | 8 | Telemetry RTN | - | None
 |  | 9 | Telemetry RTN | - | None
 |  | 10 | Telemetry RTN | - | None
 |  | 11 | N/C | - | None
 |  | 12 | N/C | - | None
 |  | 13 | N/C | - | None
 |  | 14 | N/C | - | None
 |  | 15 | N/C | - | None
COLD TPC List of Telemetry Points
High Voltage Board (SPI and Enables)
Connector Designator | Type of Connector | Pin-Out Description |  | Equation | Units
 |  | Pin | Signal Name
J3 (On Board) | HD-DSUB Female 9 (P/N: 618009231121 Man: Wurth Electronik) | 1 | DAC Sync_n+ | - | None
 |  | 2 | Enable + | - | None
 |  | 3 | N/C | - | None
 |  | 4 | DAC SCLK+ | - | None
 |  | 5 | DAC Data_IN- | - | None
 |  | 6 | DAC Sync_n- | - | None
 |  | 7 | Enable - | - | None
 |  | 8 | DAC SCLK- | - | None
 |  | 9 | DAC Data_IN+ | - | None

Sheet: Cold TPC
SiPM Bias Board Telemetry |  | Box Level Connector
Board 0 J3 connector |  | T1 Connector, 44 Pin
Pin Locatoin | Signal | Pin Location | Signal Name | Twisted Pair
1 | High Voltage Current Monitor | 1 | B0, HV Current Mon (Pin 1) | B0, Return (Pin 5) | 23
2 | HV-Enable + | 2 | B0, HV Enable + | B0, HV Enable - (Pin 7) | 24
3 | No Conn | 3 | B0, Set HV (Pin 8) | B0, Return (Pin 6) | 25
4 | Return | 4 | B0, HV Voltage Mon (Pin 9) | B0, Return (Pin 8) | 26
5 | Return | 5 | B0, Return | B0, HV Current Mon (Pin 1) | 27
6 | Return | 6 | B0, Return | B0, Set HV (Pin 8) | 28
7 | HV-Enable - | 7 | B0, HV Enable - | B0, HV Enable + | 29
8 | SET HV | 8 | B0, Return | B0, HV Voltage Mon (Pin 9) | 30
9 | HV Voltage Monitor | 9 |  |  | 31
 |  | 10 |  |  | 32
 |  | 11 |  |  | 33
 |  | 12 |  |  | 34
 |  | 13 |  |  | 35
 |  | 14 |  |  | 36
 |  | 15 |  |  | 37
 |  | 16 |  |  | 38
 |  | 17 |  |  | 39
 |  | 18 |  |  | 40
 |  | 19 |  |  | 41
 |  | 20 |  |  | 42
 |  | 21 |  |  | 43
 |  | 22 |  |  | 44
