rjridle/GRAMS/Ki-CAD6_Library_Files/Parts/Analog Devices/AD590KRZ/R_8_ADI.step

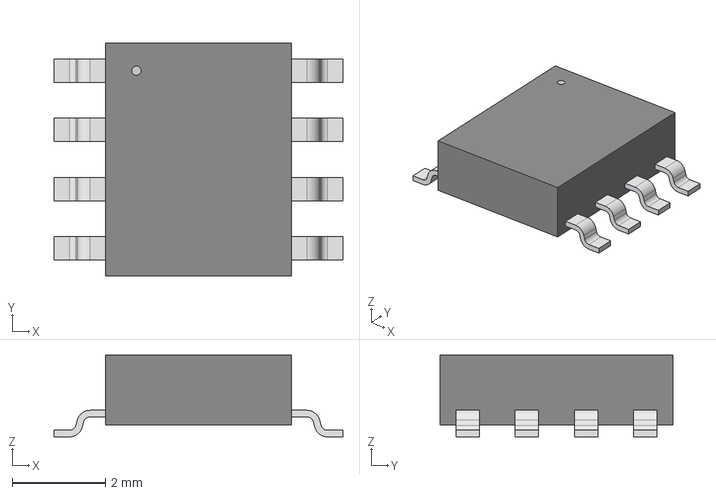
[picture p167: CAD file, 2025-10-30]
Ki-CAD6_Library_Files/Parts/Analog Devices/AD590KRZ/R_8_ADI.step
6.20 x 5.00 x 1.75 mm
