rjridle/GRAMS/Ki-CAD6_Library_Files/Parts/Analog Devices/AD8465/CP_12_3_ADI.step

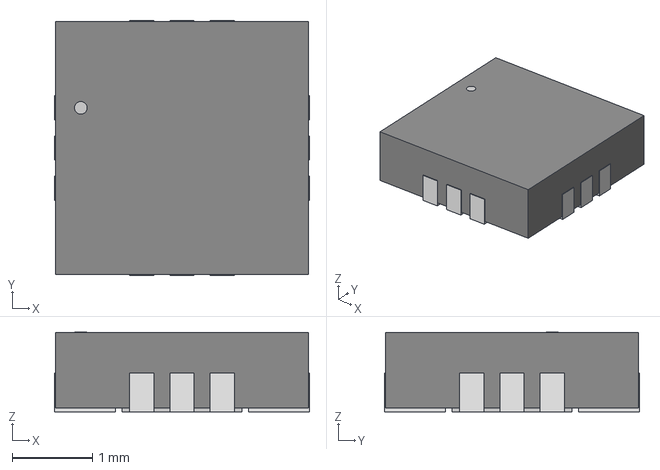
[picture p168: CAD file, 2025-10-30]
Ki-CAD6_Library_Files/Parts/Analog Devices/AD8465/CP_12_3_ADI.step
3.18 x 3.18 x 0.993 mm
