rjridle/GRAMS/Ki-CAD6_Library_Files/Parts/Analog Devices/LT3080EST-PBF/SOT-3_ST_LIT.step

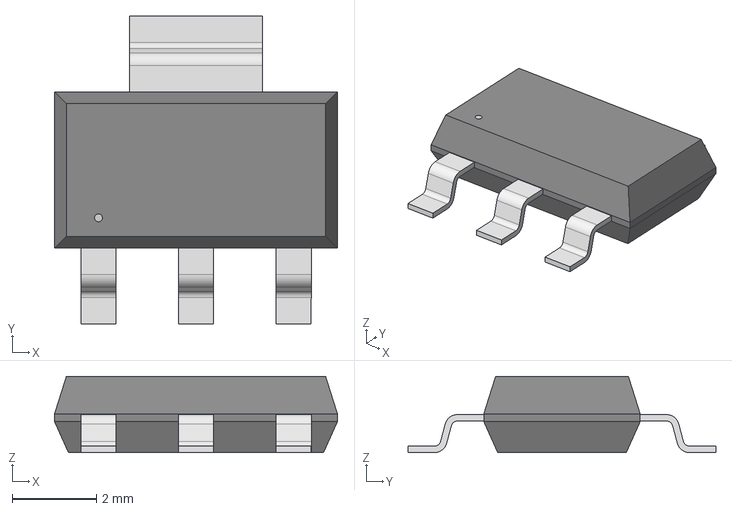
[picture p169: CAD file, 2025-10-30]
Ki-CAD6_Library_Files/Parts/Analog Devices/LT3080EST-PBF/SOT-3_ST_LIT.step
6.71 x 7.29 x 1.81 mm
