rjridle/GRAMS/Ki-CAD6_Library_Files/Parts/Analog Devices/LT5400-4/MSOP-8_MS_LIT.step

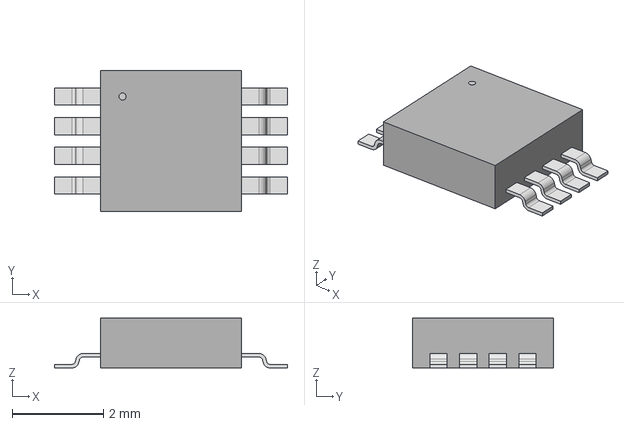
[picture p170: CAD file, 2025-10-30]
Ki-CAD6_Library_Files/Parts/Analog Devices/LT5400-4/MSOP-8_MS_LIT.step
5.11 x 3.10 x 1.09 mm
