rjridle/GRAMS/Ki-CAD6_Library_Files/Parts/Analog Devices/LT6650/S_5_ADI.step

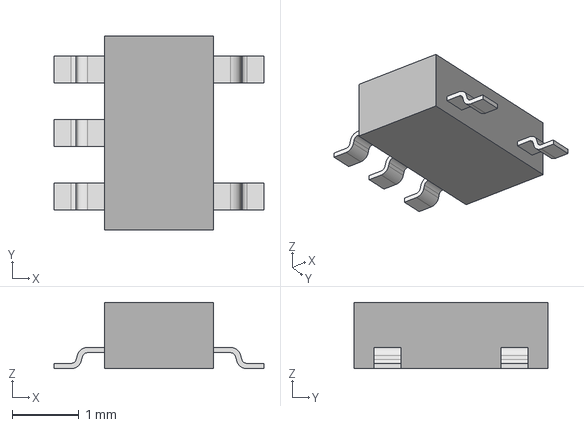
[picture p171: CAD file, 2025-10-30]
Ki-CAD6_Library_Files/Parts/Analog Devices/LT6650/S_5_ADI.step
3.14 x 2.90 x 0.991 mm
