rjridle/GRAMS/Ki-CAD6_Library_Files/Parts/Analog Devices/LTC2052HV/SO-14_S_LIT.step

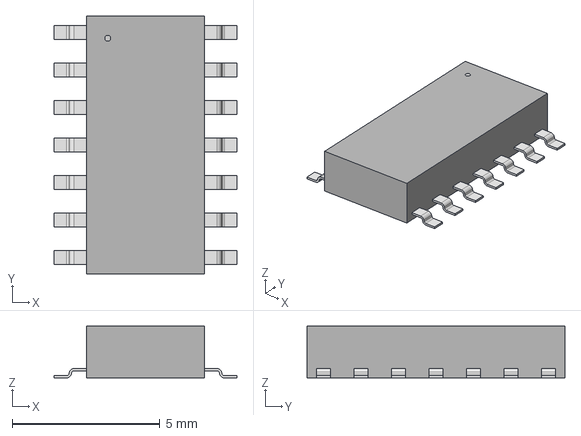
[picture p172: CAD file, 2025-10-30]
Ki-CAD6_Library_Files/Parts/Analog Devices/LTC2052HV/SO-14_S_LIT.step
6.20 x 8.74 x 1.75 mm
