rjridle/GRAMS/Ki-CAD6_Library_Files/Parts/CoilCraft/MLC1770/Coilcraft-MLC1770.STEP

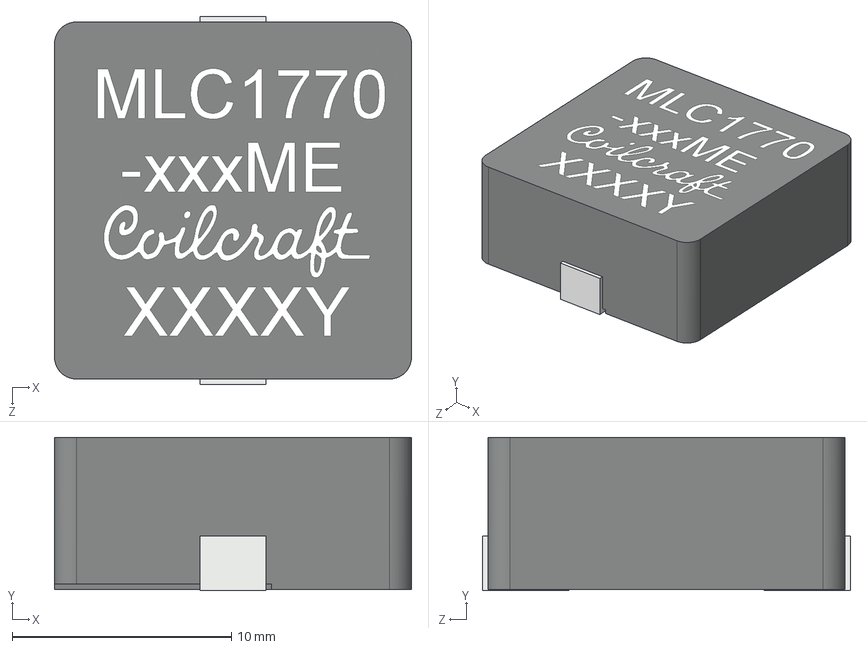
[picture p173: CAD file, 2025-10-30]
Ki-CAD6_Library_Files/Parts/CoilCraft/MLC1770/Coilcraft-MLC1770.STEP
16.3 x 7.00 x 16.8 mm
