rjridle/GRAMS/Ki-CAD6_Library_Files/Parts/CoilCraft/MLC7542/3D Models/Coilcraft-MLC7542.STEP

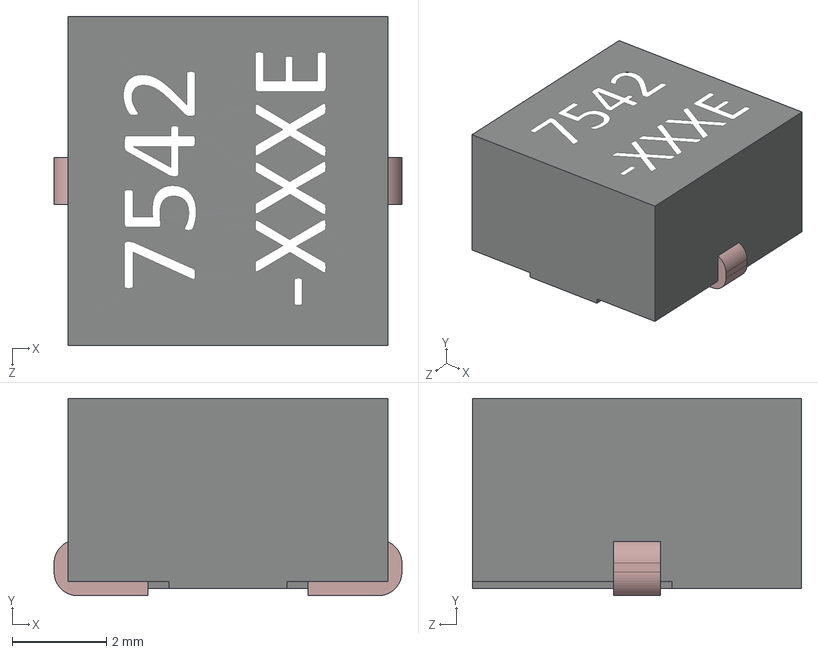
[picture p174: CAD file, 2025-10-30]
Ki-CAD6_Library_Files/Parts/CoilCraft/MLC7542/3D Models/Coilcraft-MLC7542.STEP
7.40 x 4.20 x 7.00 mm
