rjridle/GRAMS/Ki-CAD6_Library_Files/Parts/CoilCraft/MSD1260T-105/3D/Coilcraft-MSD1260T.STEP

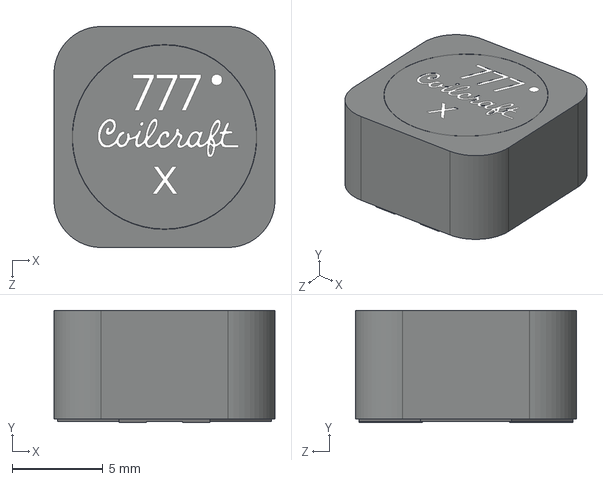
[picture p175: CAD file, 2025-10-30]
Ki-CAD6_Library_Files/Parts/CoilCraft/MSD1260T-105/3D/Coilcraft-MSD1260T.STEP
12.2 x 6.20 x 12.2 mm
