rjridle/GRAMS/Ki-CAD6_Library_Files/Parts/CoilCraft/MSS1278H/Coilcraft-MSS1278H.STEP

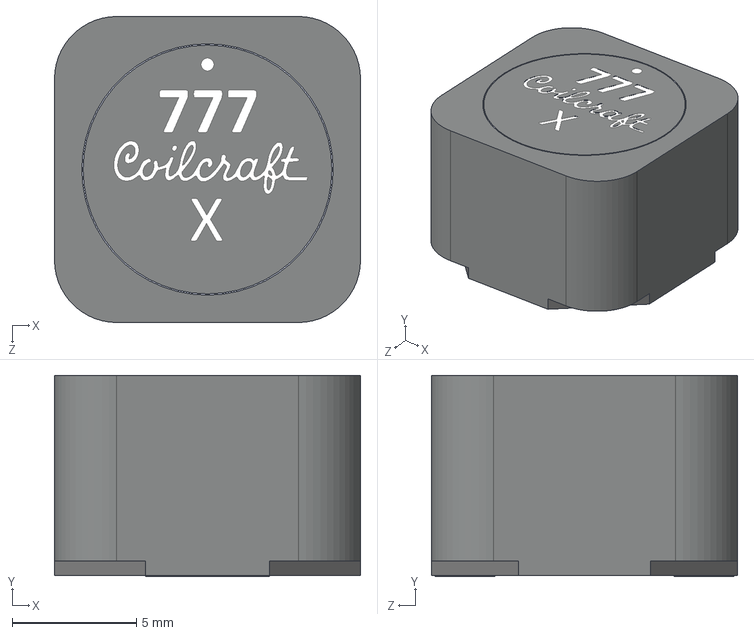
[picture p176: CAD file, 2025-10-30]
Ki-CAD6_Library_Files/Parts/CoilCraft/MSS1278H/Coilcraft-MSS1278H.STEP
12.3 x 8.09 x 12.3 mm
