rjridle/GRAMS/Ki-CAD6_Library_Files/Parts/CUI/PDQ30-Q24-S3-D/3D Model/PDQ10-Q24-S3-D--3DModel-STEP-387902.STEP

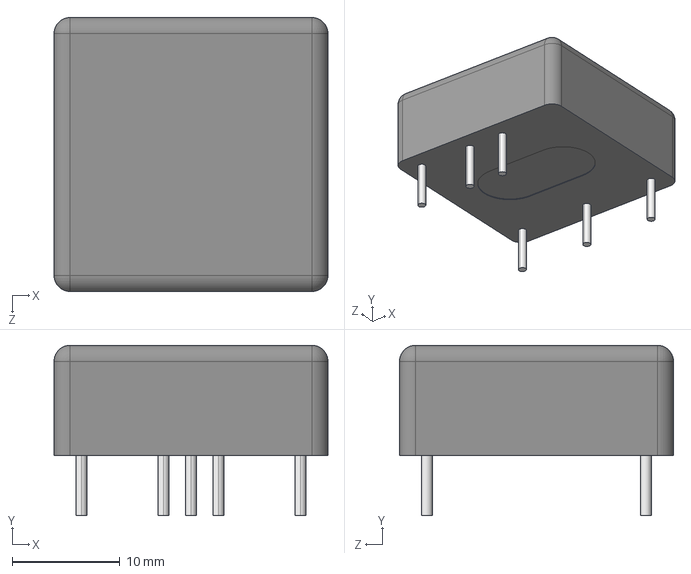
[picture p177: CAD file, 2025-10-30]
Ki-CAD6_Library_Files/Parts/CUI/PDQ30-Q24-S3-D/3D Model/PDQ10-Q24-S3-D--3DModel-STEP-387902.STEP
25.4 x 15.8 x 25.4 mm
