rjridle/GRAMS/Ki-CAD6_Library_Files/Parts/Hirose/DF14A-2P-1.25H_56/DF14A-2P-1.25H_56_/3D/DF14A-2P-1.25H_56_.stp

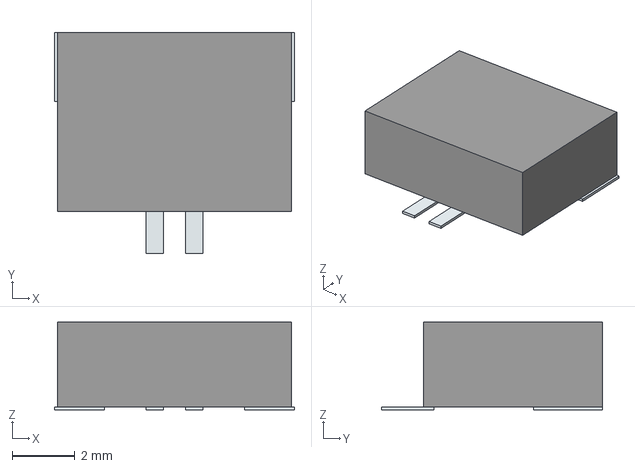
[picture p178: CAD file, 2025-10-30]
Ki-CAD6_Library_Files/Parts/Hirose/DF14A-2P-1.25H_56/DF14A-2P-1.25H_56_/3D/DF14A-2P-1.25H_56_.stp
7.65 x 7.03 x 2.80 mm
Pins
