rjridle/GRAMS/Ki-CAD6_Library_Files/Parts/Hirose/DF52-2S-0-8H-21/3D_Model/DF52-2S-0.8H.stp

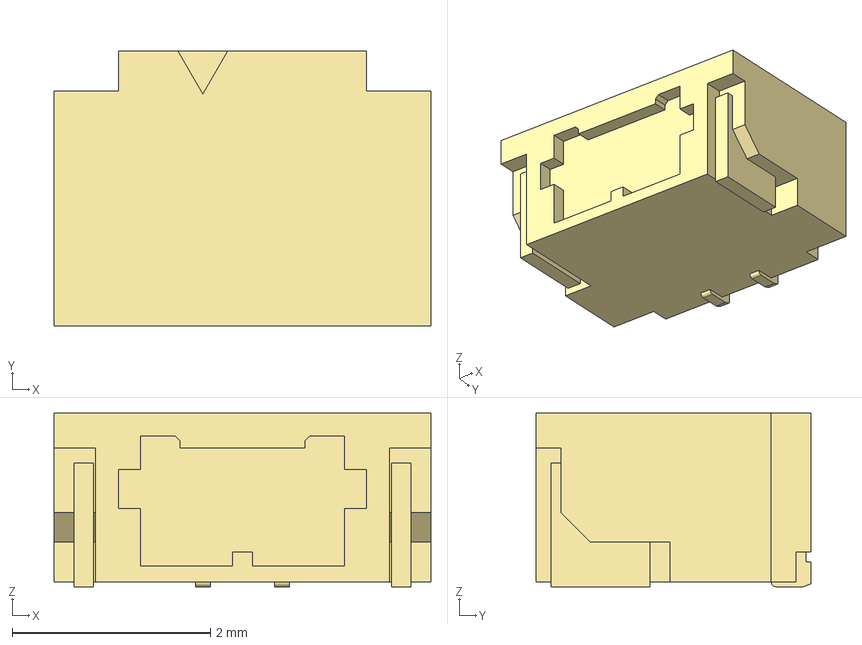
[picture p179: CAD file, 2025-10-30]
Ki-CAD6_Library_Files/Parts/Hirose/DF52-2S-0-8H-21/3D_Model/DF52-2S-0.8H.stp
3.80 x 2.77 x 1.75 mm
