rjridle/GRAMS/Ki-CAD6_Library_Files/Parts/ISOCOM/ISP281D/ISP281D_ISO.step

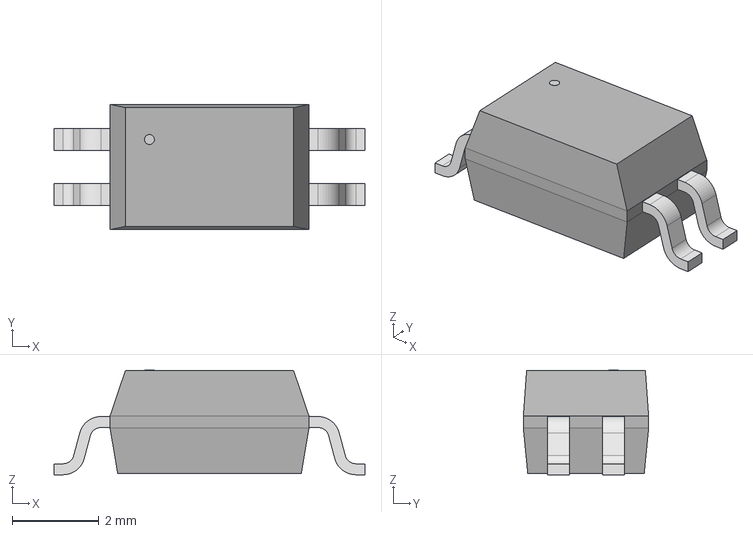
[picture p180: CAD file, 2025-10-30]
Ki-CAD6_Library_Files/Parts/ISOCOM/ISP281D/ISP281D_ISO.step
7.19 x 2.90 x 2.42 mm
