rjridle/GRAMS/Ki-CAD6_Library_Files/Parts/Little_Fuse/015401-5DR/0154Series_LTF.step

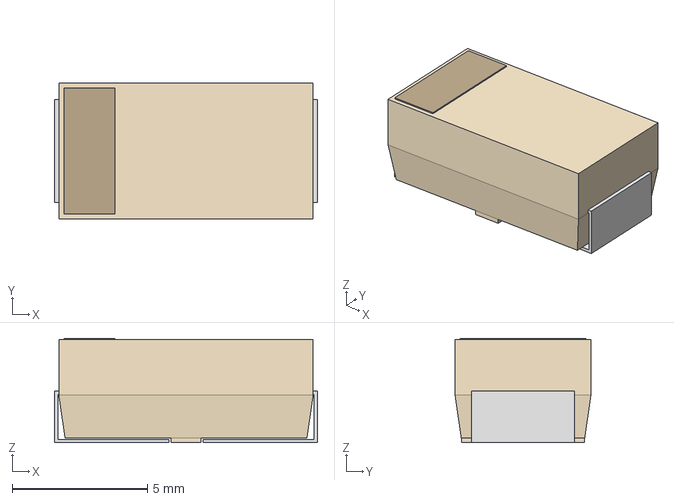
[picture p181: CAD file, 2025-10-30]
Ki-CAD6_Library_Files/Parts/Little_Fuse/015401-5DR/0154Series_LTF.step
9.73 x 5.03 x 3.86 mm
