rjridle/GRAMS/Ki-CAD6_Library_Files/Parts/Little_Fuse/SMDJ6-0A/SMDJSeries_LTF.step

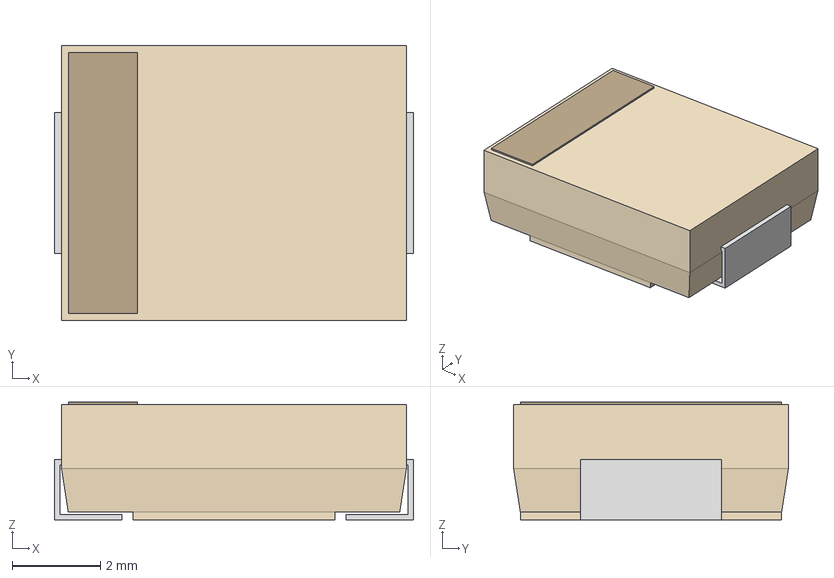
[picture p182: CAD file, 2025-10-30]
Ki-CAD6_Library_Files/Parts/Little_Fuse/SMDJ6-0A/SMDJSeries_LTF.step
8.13 x 6.22 x 2.67 mm
