rjridle/GRAMS/Ki-CAD6_Library_Files/Parts/MEDER_Elec/Reed_Relays/SIL03-1A72-71D/3D_Model/SIL03-1A72-71D/3D/SIL03-1A72-71D.stp

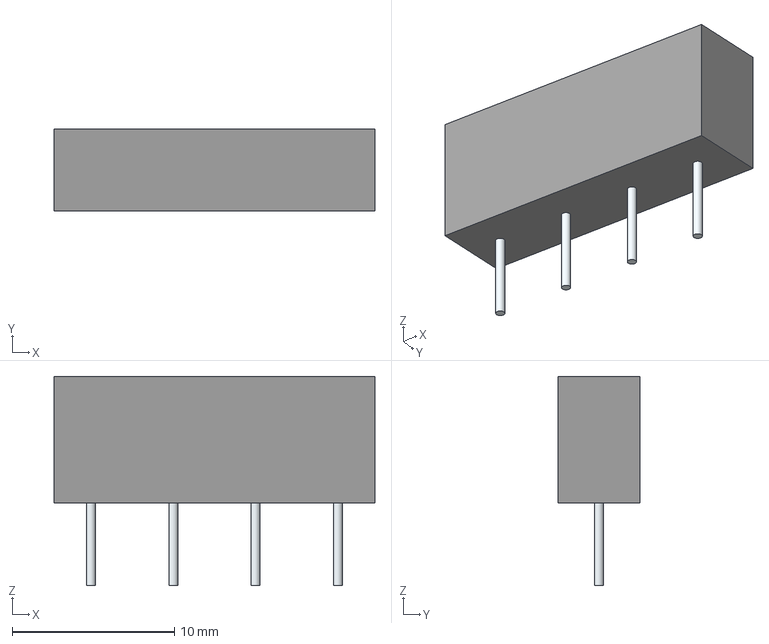
[picture p183: CAD file, 2025-10-30]
Ki-CAD6_Library_Files/Parts/MEDER_Elec/Reed_Relays/SIL03-1A72-71D/3D_Model/SIL03-1A72-71D/3D/SIL03-1A72-71D.stp
19.8 x 5.08 x 12.9 mm
Leads x 4
