rjridle/GRAMS/Ki-CAD6_Library_Files/Parts/Samtec/SMP/SMP-PC-P-HG-ST-TH2.stp

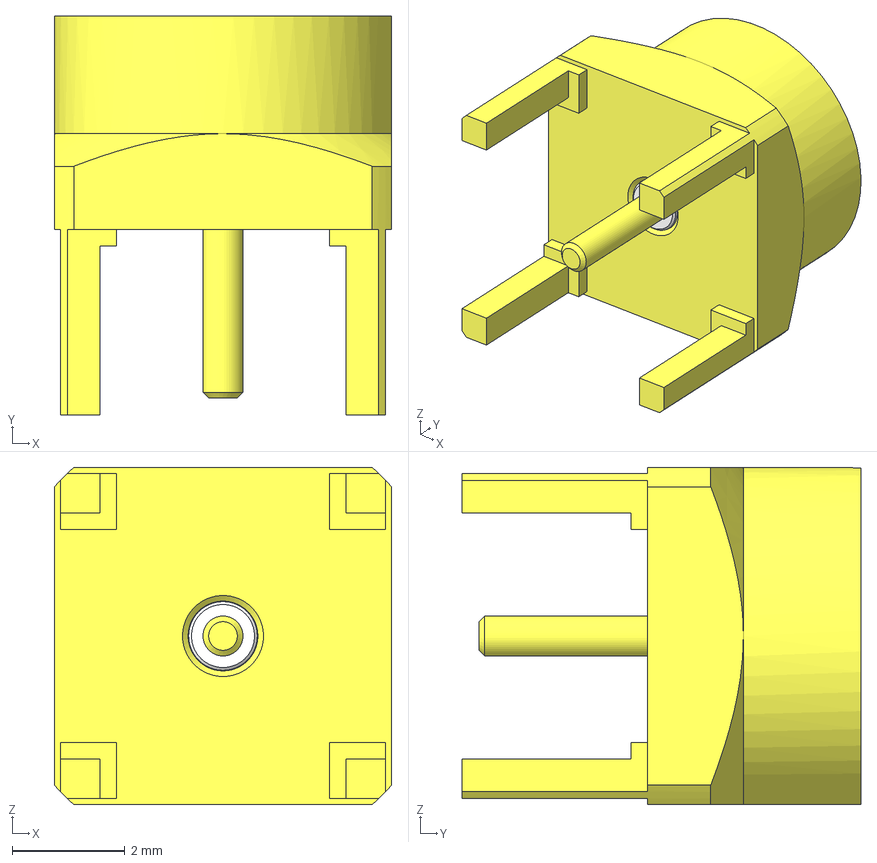
[picture p184: CAD file, 2025-10-30]
Ki-CAD6_Library_Files/Parts/Samtec/SMP/SMP-PC-P-HG-ST-TH2.stp
5.99 x 7.09 x 5.99 mm
SMP-PC-P-HG-ST-TH2_s
SMP-PC-P-HG-ST-TH2_i
SMP-PC-P-HG-ST-TH2_p
