rjridle/GRAMS/Ki-CAD6_Library_Files/Parts/Samtec/T1M-02-F-SH-L/Cable_Interconnect/ISS1-02-L.stp

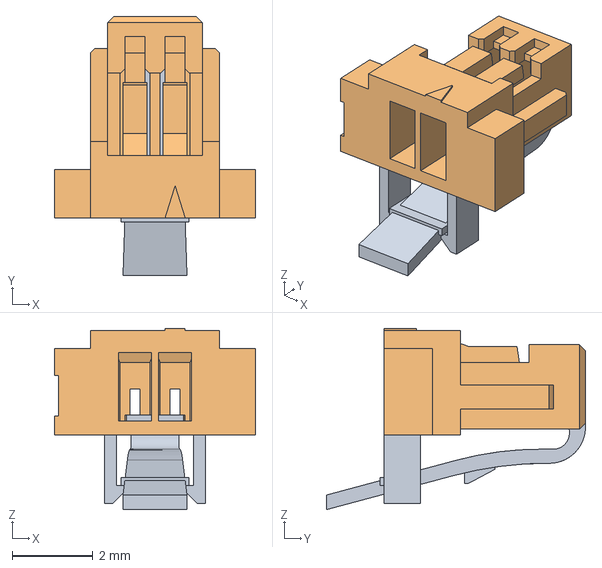
[picture p185: CAD file, 2025-10-30]
Ki-CAD6_Library_Files/Parts/Samtec/T1M-02-F-SH-L/Cable_Interconnect/ISS1-02-L.stp
5.00 x 6.43 x 4.50 mm
ISS1-02-L-latch
ISS1-02-Lbody
