rjridle/GRAMS/Ki-CAD6_Library_Files/Parts/Samtec/T1M-02-F-SH-L/T1M-02-F-SH-L.stp

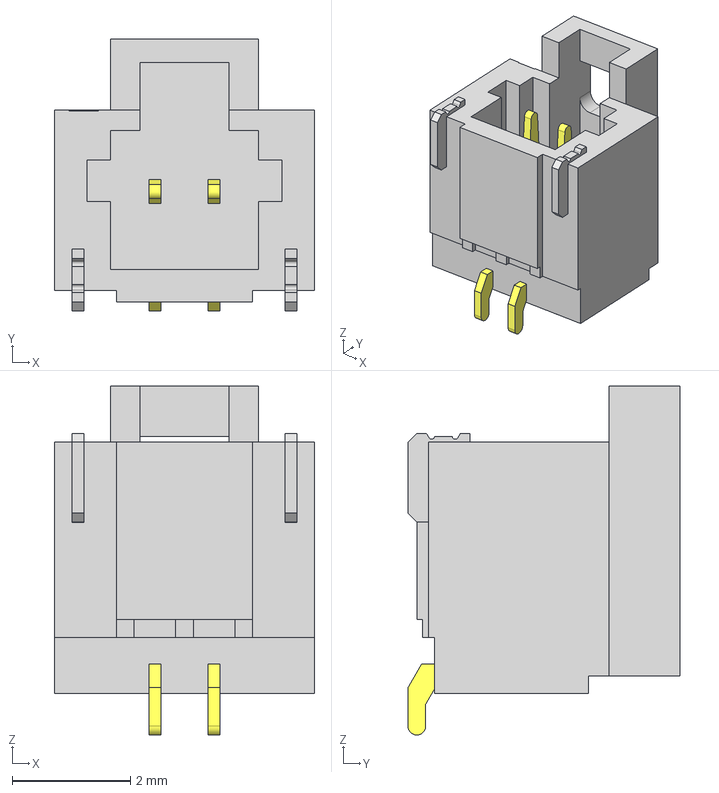
[picture p186: CAD file, 2025-10-30]
Ki-CAD6_Library_Files/Parts/Samtec/T1M-02-F-SH-L/T1M-02-F-SH-L.stp
4.40 x 4.60 x 5.90 mm
P2T1M-02-T-SH-L
T1T1M-02-T-SH-L
