rjridle/GRAMS/Ki-CAD6_Library_Files/Parts/Samtec/T1M-03-F-SH-L/Cable_Interconnect/ISS1-03-L.stp

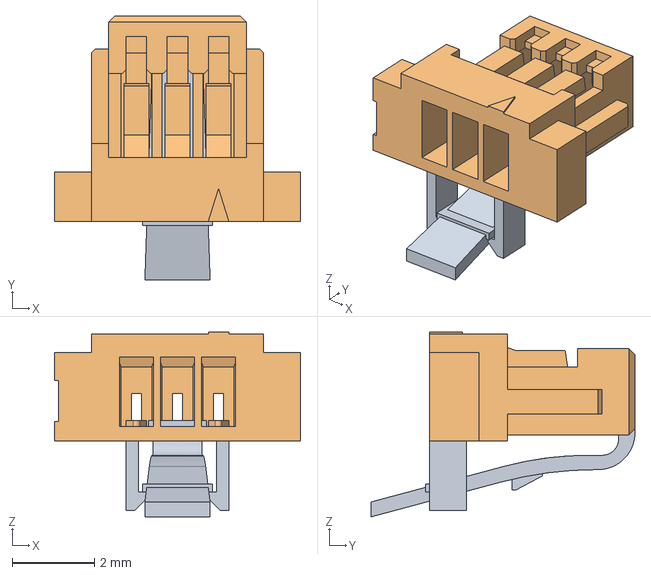
[picture p188: CAD file, 2025-10-30]
Ki-CAD6_Library_Files/Parts/Samtec/T1M-03-F-SH-L/Cable_Interconnect/ISS1-03-L.stp
6.00 x 6.43 x 4.50 mm
ISS1-03-L-latch
ISS1-03-Lbody
