rjridle/GRAMS/Ki-CAD6_Library_Files/Parts/Samtec/T1M-03-F-SV-L/3D Model/T1M-03-F-SV-L.stp

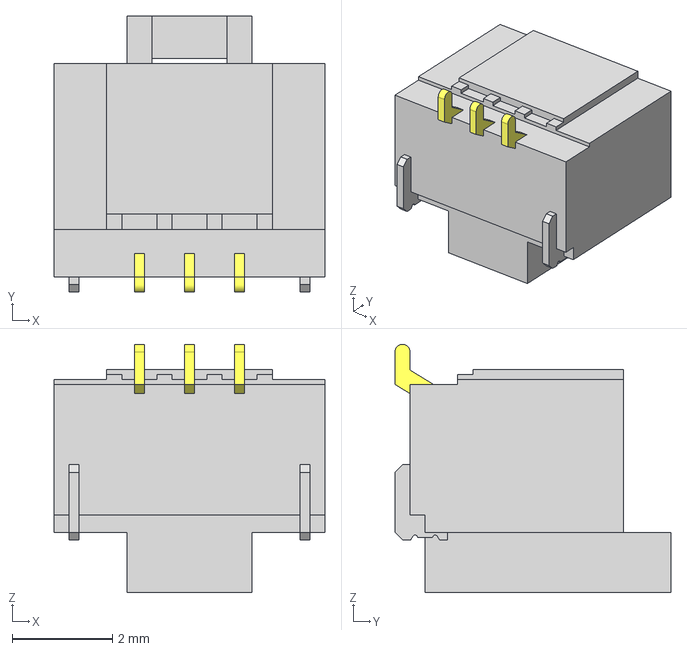
[picture p190: CAD file, 2025-10-30]
Ki-CAD6_Library_Files/Parts/Samtec/T1M-03-F-SV-L/3D Model/T1M-03-F-SV-L.stp
5.40 x 5.50 x 4.95 mm
P2T1M-03-T-SV-L
T1T1M-03-T-SV-L
