rjridle/GRAMS/Ki-CAD6_Library_Files/Parts/Samtec/T1M-05-F-SH-L/T1M-05-F-SH-L.step

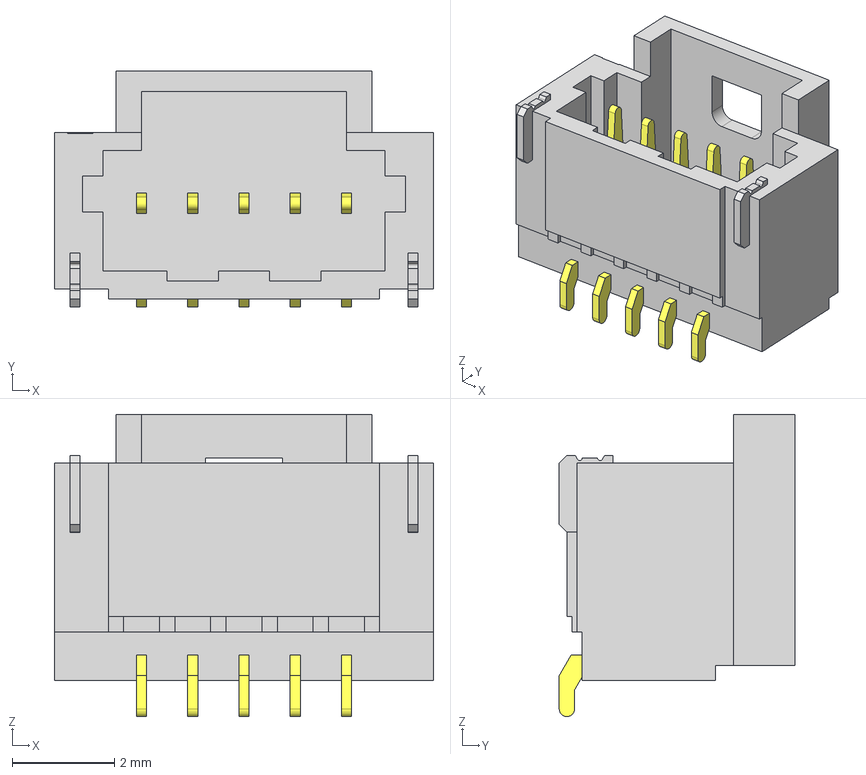
[picture p191: CAD file, 2025-10-30]
Ki-CAD6_Library_Files/Parts/Samtec/T1M-05-F-SH-L/T1M-05-F-SH-L.step
7.40 x 4.60 x 5.90 mm
T1T1M-05-T-SH-L
P2T1M-05-T-SH-L
