rjridle/GRAMS/Ki-CAD6_Library_Files/Parts/Samtec/T1M-06-F-SH-L/3D Model/T1M-06-X-SH-L.step

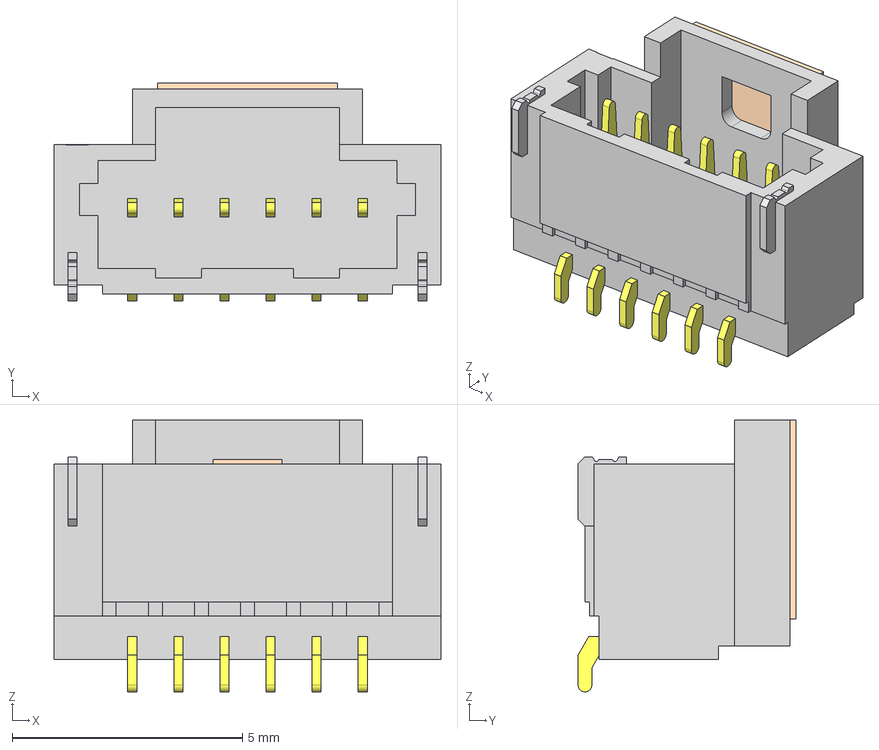
[picture p192: CAD file, 2025-10-30]
Ki-CAD6_Library_Files/Parts/Samtec/T1M-06-F-SH-L/3D Model/T1M-06-X-SH-L.step
8.40 x 4.73 x 5.90 mm
T1T1M-06-T-SH-L
P2T1M-06-T-SH-L
K-DOT-154x170-297-005
