rjridle/GRAMS/Ki-CAD6_Library_Files/Parts/Samtec/T1M-09-F-SH-L/Cable_Interconnect/ISS1-09-L.stp

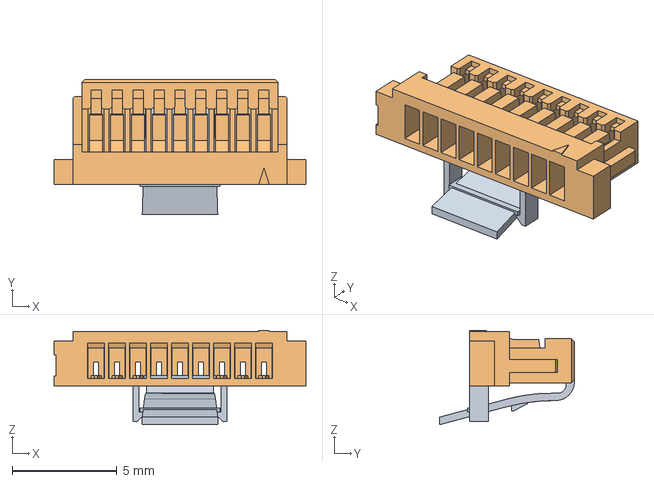
[picture p193: CAD file, 2025-10-30]
Ki-CAD6_Library_Files/Parts/Samtec/T1M-09-F-SH-L/Cable_Interconnect/ISS1-09-L.stp
12.0 x 6.43 x 4.50 mm
ISS1-09-L-latch
ISS1-09-Lbody
