rjridle/GRAMS/Ki-CAD6_Library_Files/Parts/Samtec/T1M-09-F-SH-L/T1M-09-F-SH-L.step

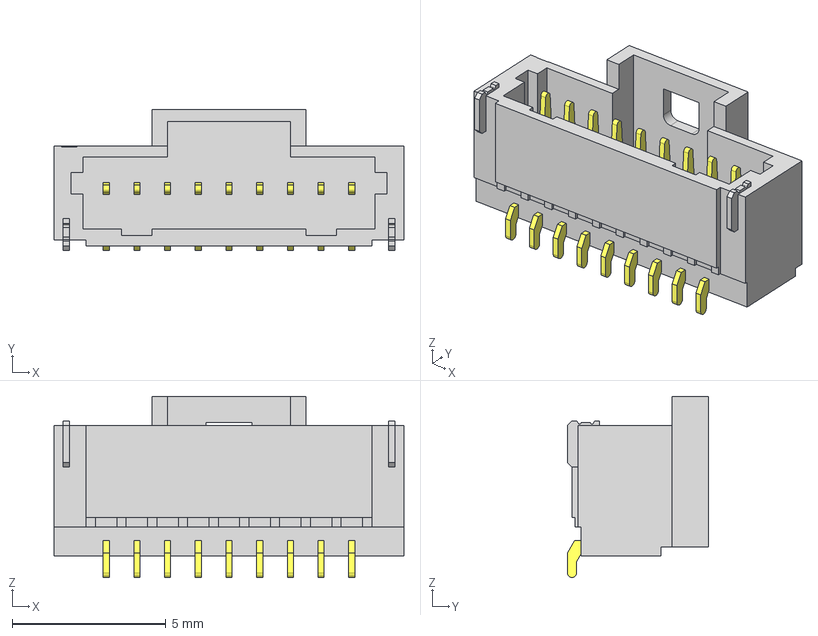
[picture p194: CAD file, 2025-10-30]
Ki-CAD6_Library_Files/Parts/Samtec/T1M-09-F-SH-L/T1M-09-F-SH-L.step
11.4 x 4.60 x 5.90 mm
P2T1M-09-T-SH-L
T1T1M-09-T-SH-L
