rjridle/GRAMS/Ki-CAD6_Library_Files/Parts/Samtec/T1M-10-F-SH-L-K/Cable_Interconnect/ISS1-10-L.stp

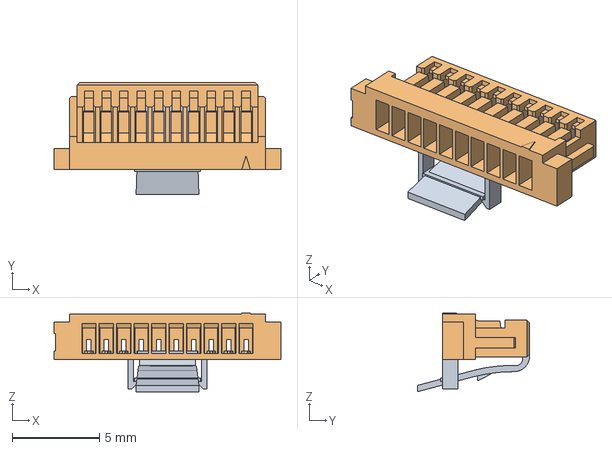
[picture p196: CAD file, 2025-10-30]
Ki-CAD6_Library_Files/Parts/Samtec/T1M-10-F-SH-L-K/Cable_Interconnect/ISS1-10-L.stp
13.0 x 6.43 x 4.50 mm
ISS1-10-L-latch
ISS1-10-Lbody
