rjridle/GRAMS/Ki-CAD6_Library_Files/Parts/Samtec/T1M-10-F-SH-L-K/T1M-10-F-SH-L-K.step

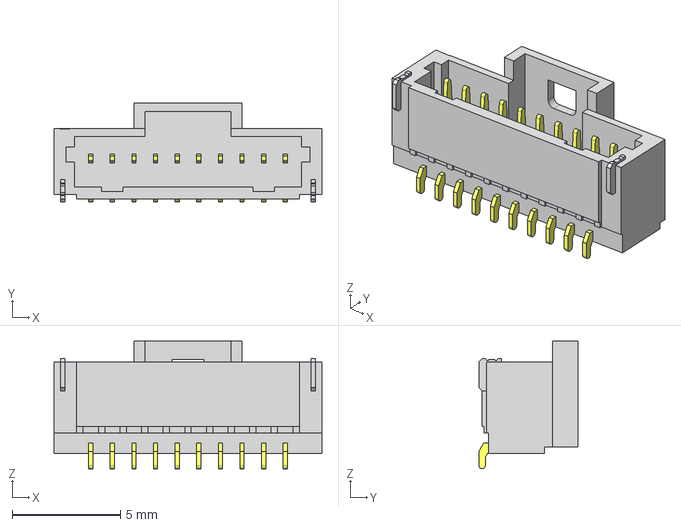
[picture p197: CAD file, 2025-10-30]
Ki-CAD6_Library_Files/Parts/Samtec/T1M-10-F-SH-L-K/T1M-10-F-SH-L-K.step
12.4 x 4.60 x 5.90 mm
P2T1M-10-T-SH-L
T1T1M-10-T-SH-L
