rjridle/GRAMS/Ki-CAD6_Library_Files/Parts/TE_Connectivity/Rt_Angle_Connectors/5103310-5/c-5103310-5-b-3d.stp

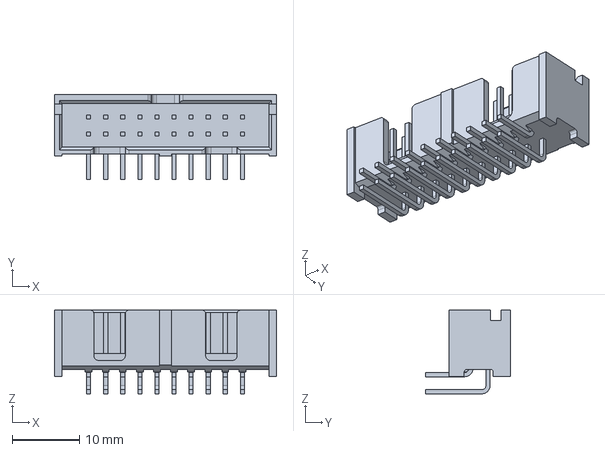
[picture p199: CAD file, 2025-10-30]
Ki-CAD6_Library_Files/Parts/TE_Connectivity/Rt_Angle_Connectors/5103310-5/c-5103310-5-b-3d.stp
33.0 x 12.6 x 12.5 mm

Ki-CAD6_Library_Files/Parts/Texas_Inst/INA283AIDGKT/STEP/DGK0008A.stp
4.90 x 3.00 x 1.10 mm
BODY_MUA08A
LEAD_MUA08A x 8
