rjridle/GRAMS/Ki-CAD6_Library_Files/Parts/Texas_Inst/INA350CDS/DDF0008A.stp

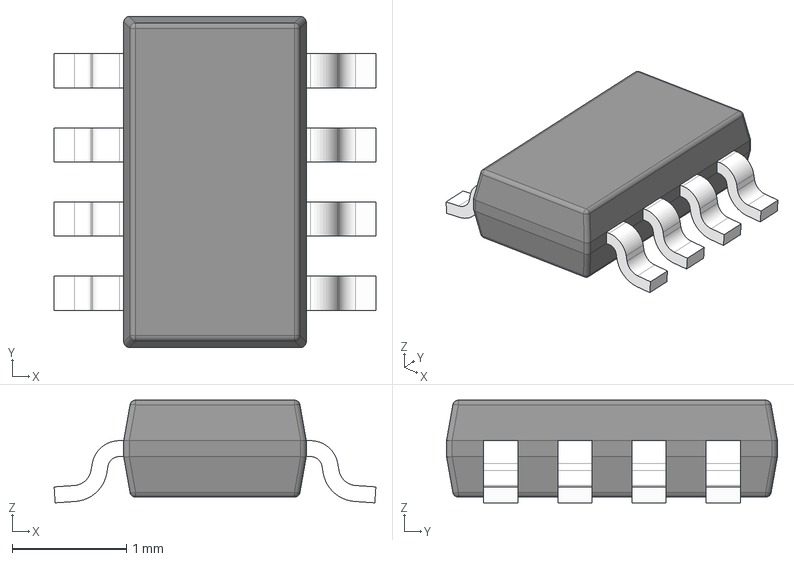
[picture p201: CAD file, 2025-10-30]
Ki-CAD6_Library_Files/Parts/Texas_Inst/INA350CDS/DDF0008A.stp
2.82 x 2.90 x 0.9 mm
BODY-SO
LEAD-SO x 8
PIN1-ID
