rjridle/GRAMS/Ki-CAD6_Library_Files/Parts/Texas_Inst/LM117HVHRQMLV/NDT0003A.stp

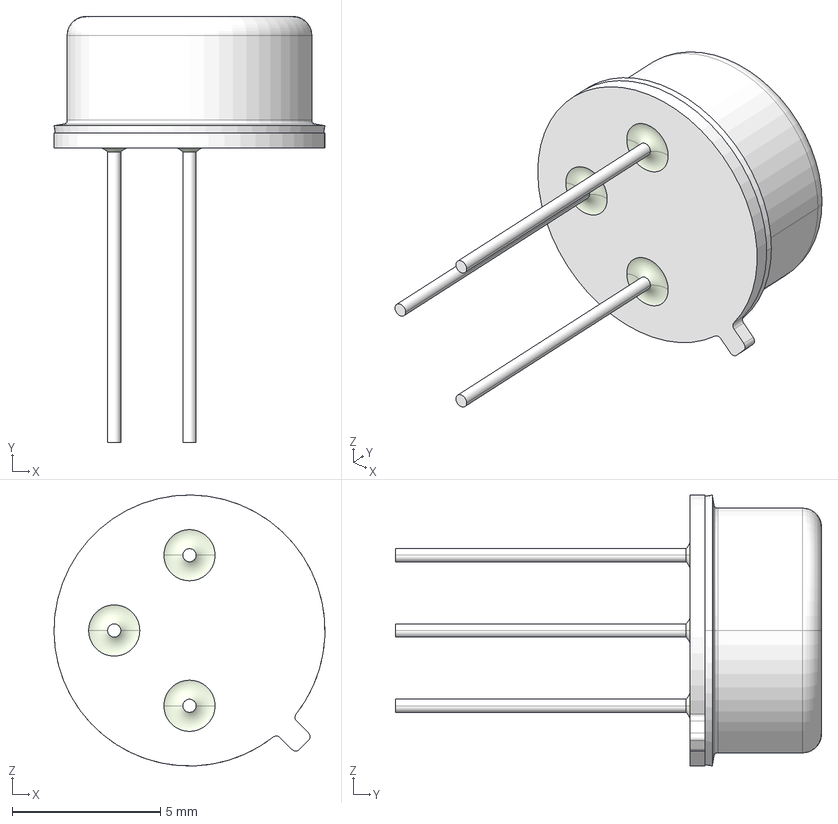
[picture p202: CAD file, 2025-10-30]
Ki-CAD6_Library_Files/Parts/Texas_Inst/LM117HVHRQMLV/NDT0003A.stp
9.14 x 14.4 x 9.14 mm
CAN_AF0
GLASS_AF0
GLASS_AF1
GLASS_AF2
PIN1_AF0
PIN1_AF1
PIN1_AF2
CANCOVER_AF0
