rjridle/GRAMS/Ki-CAD6_Library_Files/Parts/Texas_Inst/lp3964/MP05A_TEX.step

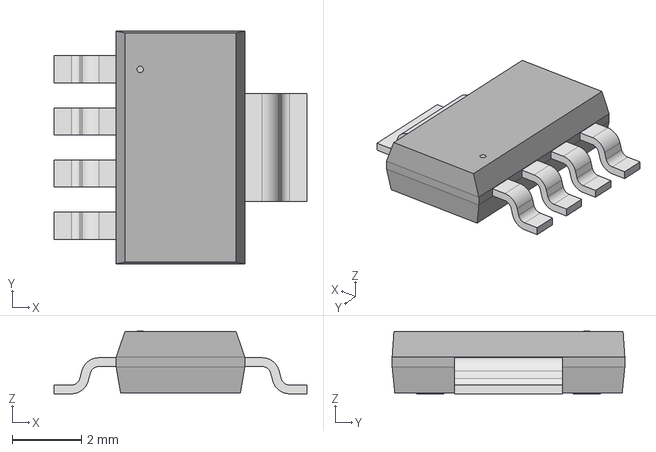
[picture p203: CAD file, 2025-10-30]
Ki-CAD6_Library_Files/Parts/Texas_Inst/lp3964/MP05A_TEX.step
7.29 x 6.71 x 1.81 mm
