rjridle/GRAMS/Ki-CAD6_Library_Files/Parts/Texas_Inst/TLV9054/RUC_Package/RUC0014A.stp

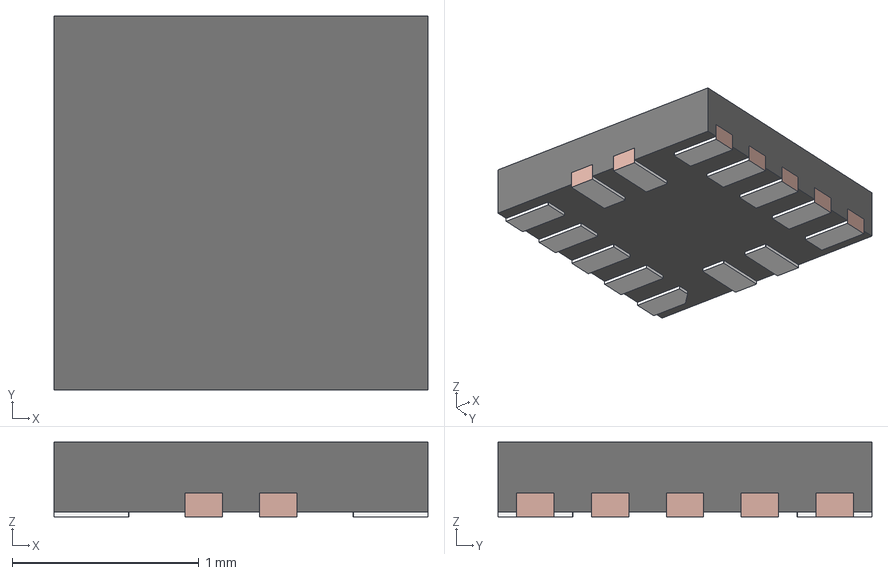
[picture p204: CAD file, 2025-10-30]
Ki-CAD6_Library_Files/Parts/Texas_Inst/TLV9054/RUC_Package/RUC0014A.stp
2.00 x 2.00 x 0.4 mm
FRAME
