rjridle/GRAMS/Ki-CAD6_Library_Files/Parts/Toshiba/Dual NFET/SSM6N35FE-LM/STEP/ES6.step

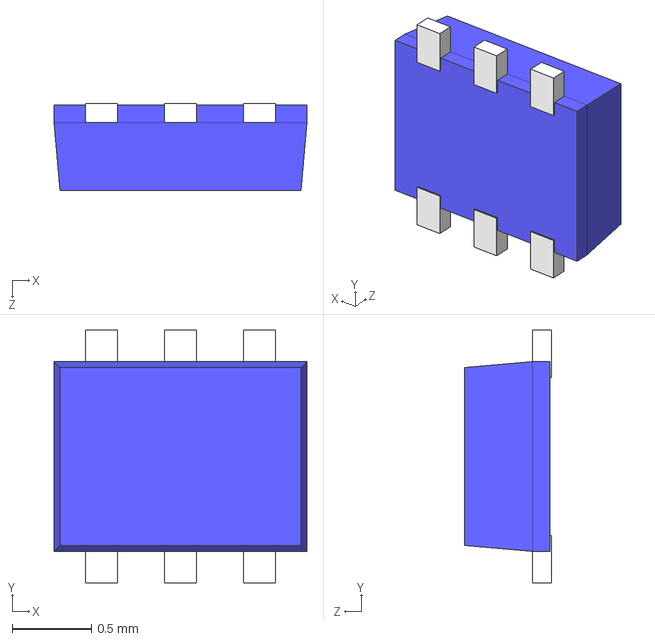
[picture p205: CAD file, 2025-10-30]
Ki-CAD6_Library_Files/Parts/Toshiba/Dual NFET/SSM6N35FE-LM/STEP/ES6.step
1.60 x 1.60 x 0.55 mm
