rjridle/GRAMS/Ki-CAD6_Library_Files/Parts/Toshiba/Single NFET/SSM3K15AFS-LF/STEP/SSM.step

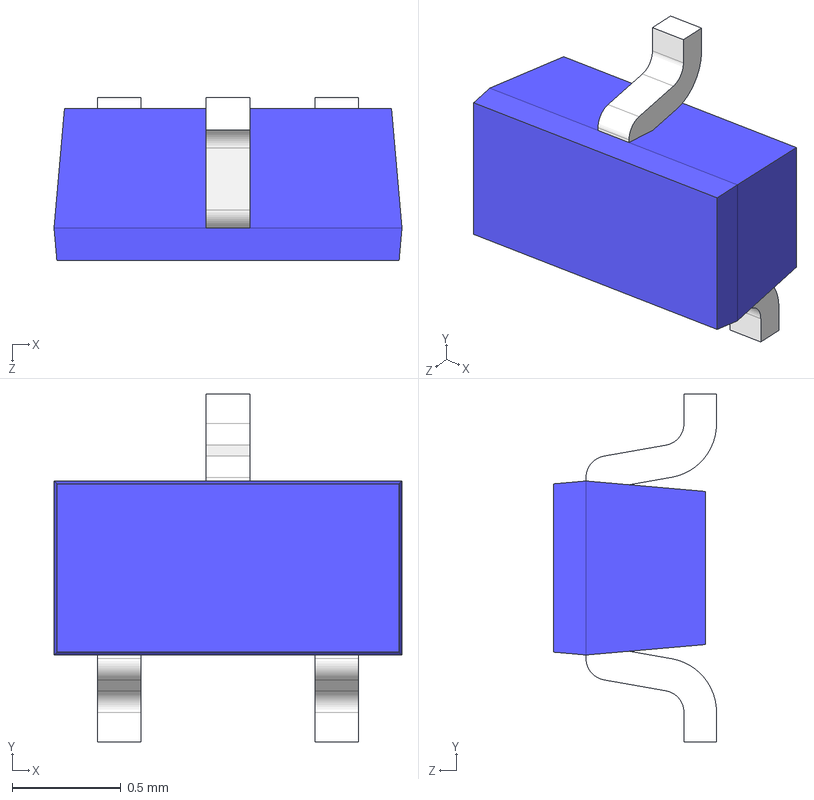
[picture p206: CAD file, 2025-10-30]
Ki-CAD6_Library_Files/Parts/Toshiba/Single NFET/SSM3K15AFS-LF/STEP/SSM.step
1.60 x 1.60 x 0.75 mm
