rjridle/GRAMS/Ki-CAD6_Library_Files/Parts/Ultra Volt/3D_Model/OL-076_revA_US.stp

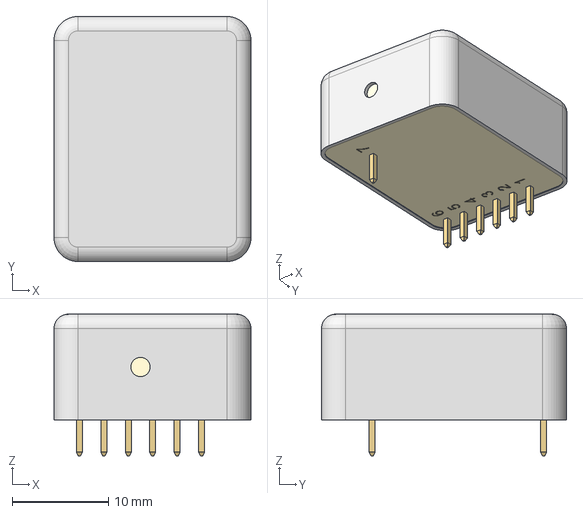
[picture p207: CAD file, 2025-10-30]
Ki-CAD6_Library_Files/Parts/Ultra Volt/3D_Model/OL-076_revA_US.stp
20.5 x 25.5 x 14.7 mm
