rjridle/GRAMS/Ki-CAD8_Library_Files/ADAM_TECH/SMA_Bulkhead/3D_Model/RF2-49B-T-00-50-G-HDW--3DModel-STEP-269445(1).STEP

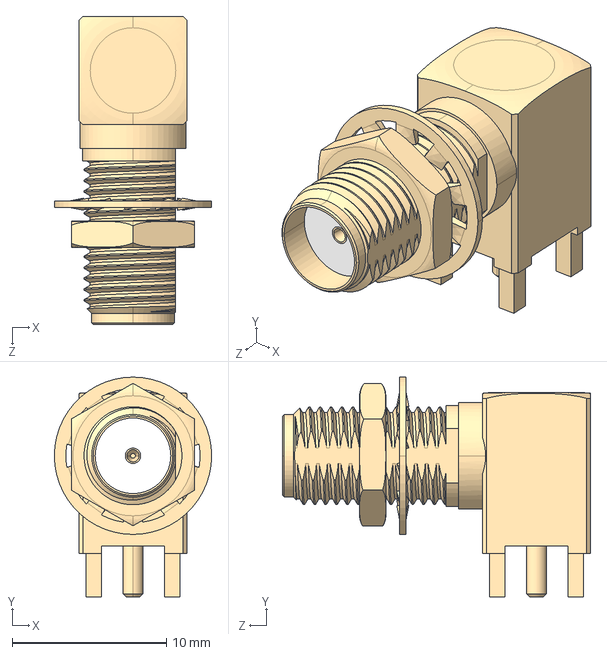
[picture p208: CAD file, 2025-10-30]
Ki-CAD8_Library_Files/ADAM_TECH/SMA_Bulkhead/3D_Model/RF2-49B-T-00-50-G-HDW--3DModel-STEP-269445(1).STEP
10.2 x 14.2 x 20.0 mm
