rjridle/GRAMS/Ki-CAD8_Library_Files/Advanced Energy/10A12-N4/10A12-N4.STEP

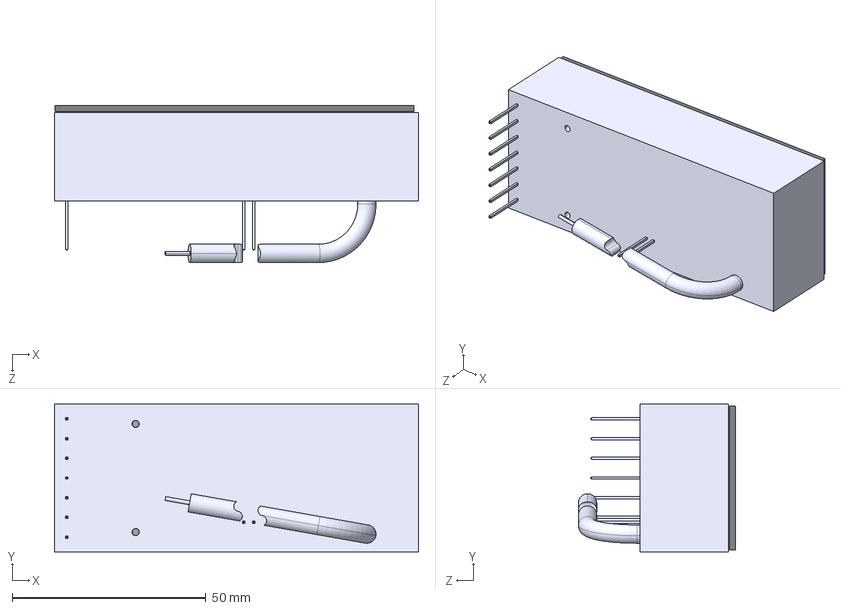
[picture p209: CAD file, 2025-10-30]
Ki-CAD8_Library_Files/Advanced Energy/10A12-N4/10A12-N4.STEP
94.0 x 38.1 x 40.6 mm
OL-014_revH_10A^10A24-N15(2)_10A12-N4.STEP
AH-001^10A24-N15(2)_10A12-N4.STEP
HS-018^10A24-N15(2)_10A12-N4.STEP
SC-F-2-56-1003^10A24-N15(2)_10A12-N4.STEP x 2
