rjridle/GRAMS/Ki-CAD8_Library_Files/Advanced Energy/VHB75W-Q24-S12/VHB75W-Q24-S12/VHB75W-Q24-S12.step

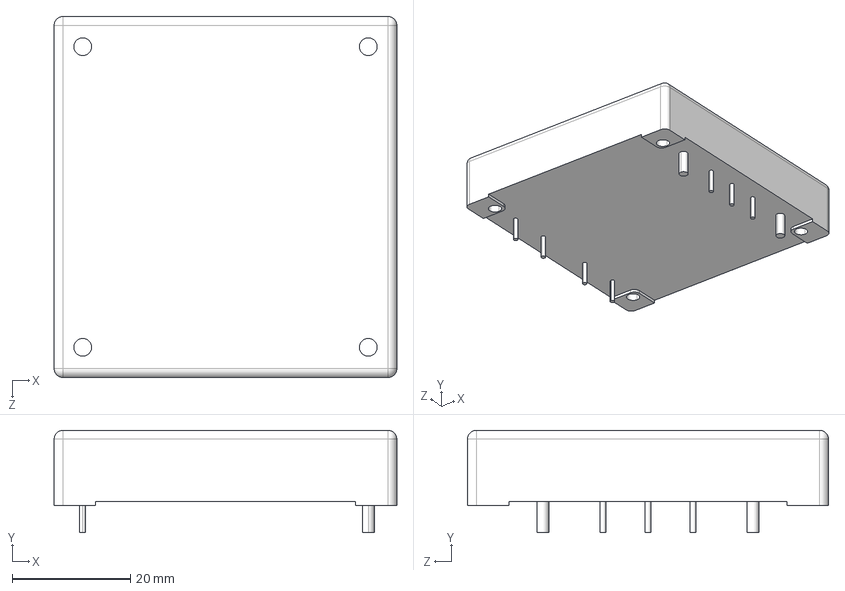
[picture p210: CAD file, 2025-10-30]
Ki-CAD8_Library_Files/Advanced Energy/VHB75W-Q24-S12/VHB75W-Q24-S12/VHB75W-Q24-S12.step
57.9 x 17.3 x 61.0 mm
