rjridle/GRAMS/Ki-CAD8_Library_Files/Amphenol/DSUB/15_FHDDSUB_VERT/15_FHDDSUB_VERT_10090929-S154VLF.step

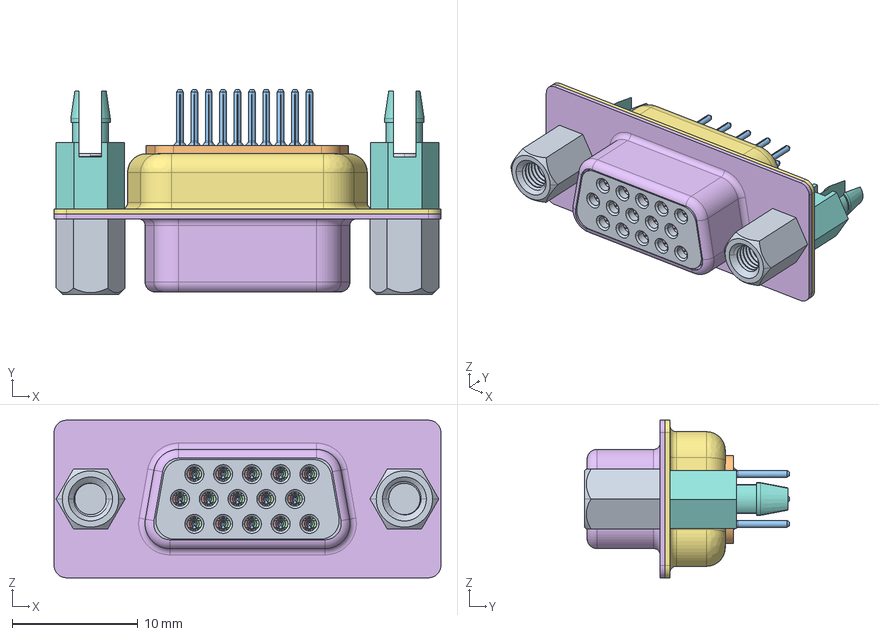
[picture p211: CAD file, 2025-11-13]
Ki-CAD8_Library_Files/Amphenol/DSUB/15_FHDDSUB_VERT/15_FHDDSUB_VERT_10090929-S154VLF.step
30.8 x 16.3 x 12.6 mm
HOUSING
COVER
FCONTACT x 15
9PF_SHELL
HDP-YUCHA x 2
LUOSI x 2
