rjridle/GRAMS/Ki-CAD8_Library_Files/Amphenol/DSUB/15_MHDDSUB_VERT/15_MHDDSUB_VERT_10090928-P154VLF.STEP

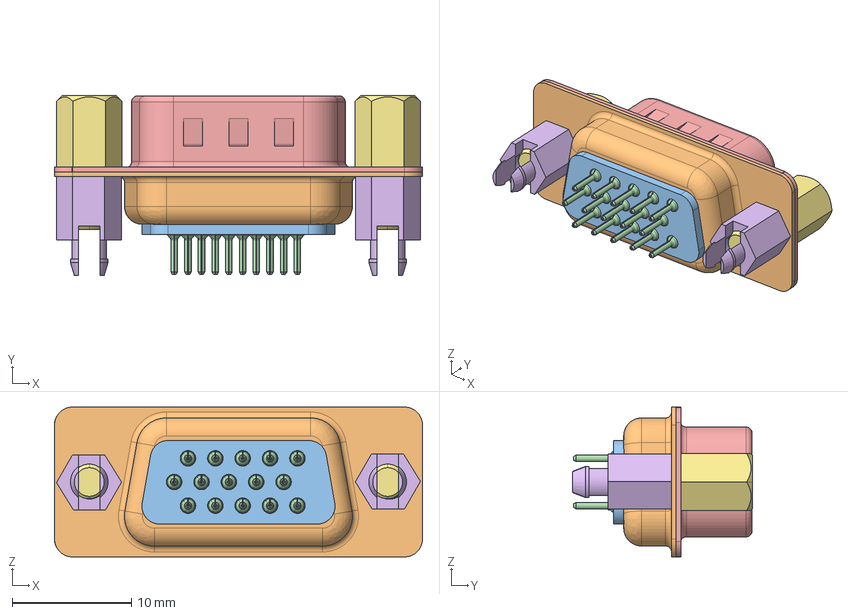
[picture p212: CAD file, 2025-11-13]
Ki-CAD8_Library_Files/Amphenol/DSUB/15_MHDDSUB_VERT/15_MHDDSUB_VERT_10090928-P154VLF.STEP
30.8 x 15.1 x 12.6 mm
HOUSING
COVER
MCONTACT x 15
D-SUB-9P-MALE-FRONTSHELL
HDP-YUCHA x 2
LUOSI x 2
