rjridle/GRAMS/Ki-CAD8_Library_Files/Amphenol/DSUB/26-POS/FEM/ICD26S13E4GX00LF/ICD26S13E4GX00LF.STEP

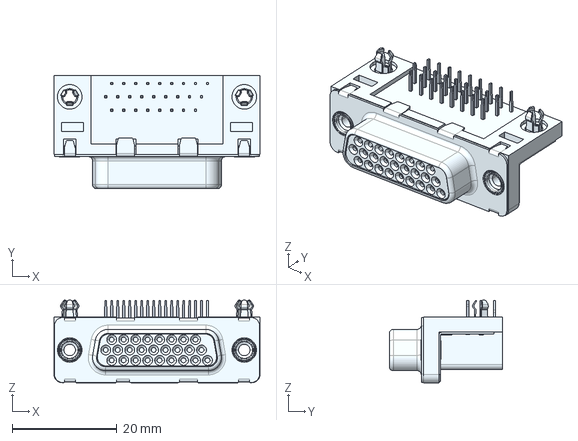
[picture p213: CAD file, 2025-10-30]
Ki-CAD8_Library_Files/Amphenol/DSUB/26-POS/FEM/ICD26S13E4GX00LF/ICD26S13E4GX00LF.STEP
39.3 x 21.6 x 15.8 mm
