rjridle/GRAMS/Ki-CAD8_Library_Files/Analog Devices/ADG1606BRUZ/RU_28_ADI.step

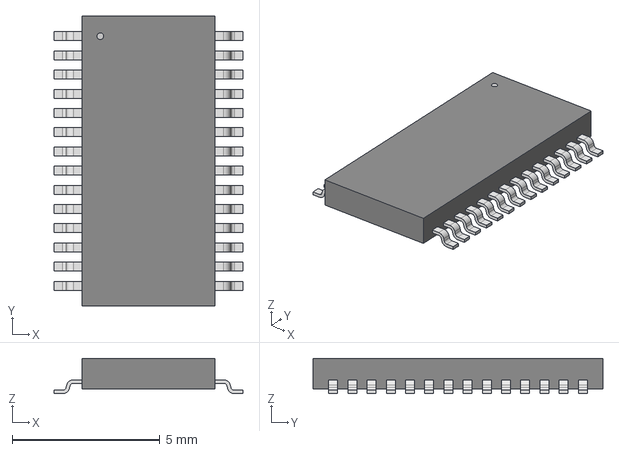
[picture p214: CAD file, 2025-10-30]
Ki-CAD8_Library_Files/Analog Devices/ADG1606BRUZ/RU_28_ADI.step
6.40 x 9.80 x 1.20 mm
