rjridle/GRAMS/Ki-CAD8_Library_Files/Analog Devices/ADG608BRUZ/RU_16_ADI.step

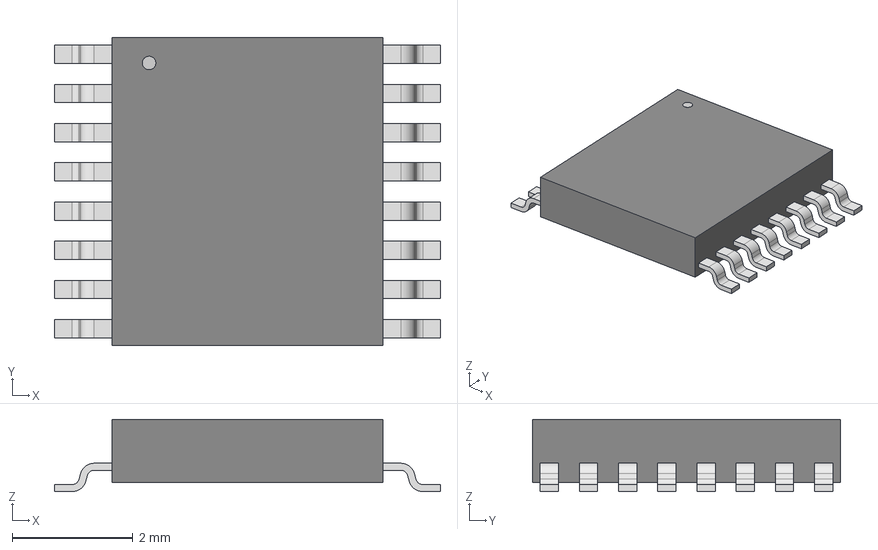
[picture p215: CAD file, 2025-10-30]
Ki-CAD8_Library_Files/Analog Devices/ADG608BRUZ/RU_16_ADI.step
6.40 x 5.11 x 1.20 mm
