rjridle/GRAMS/Ki-CAD8_Library_Files/Analog Devices/LT3015EQ#TRPBF/DDPAK-5_Q_LIT.step

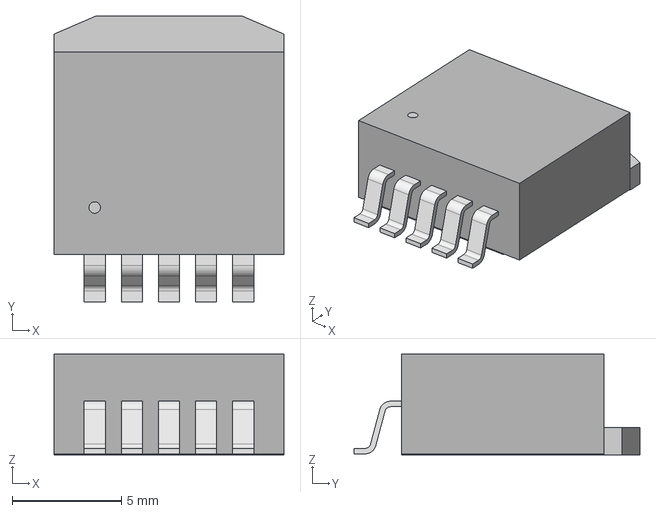
[picture p216: CAD file, 2025-10-30]
Ki-CAD8_Library_Files/Analog Devices/LT3015EQ#TRPBF/DDPAK-5_Q_LIT.step
10.5 x 13.1 x 4.63 mm
