rjridle/GRAMS/Ki-CAD8_Library_Files/Analog Devices/LTC2051HVIMS8_PBF/LTC2051HVIMS8_PBF.step

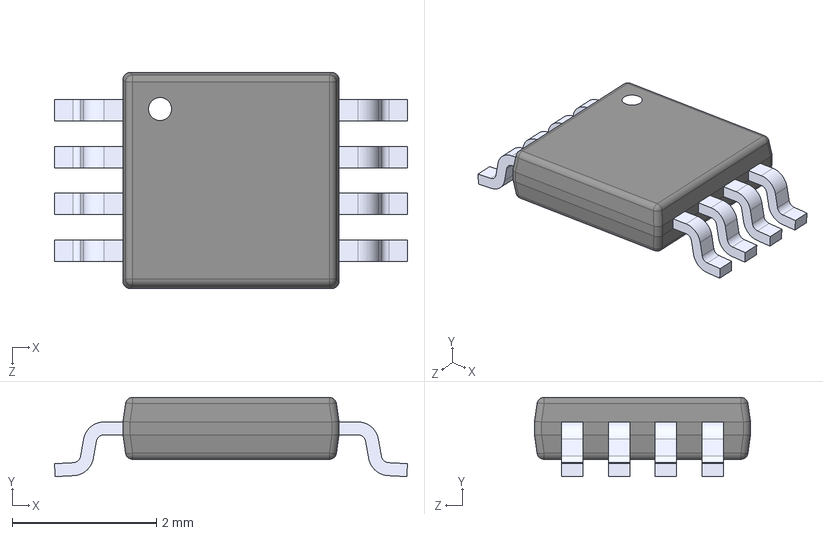
[picture p217: CAD file, 2025-10-30]
Ki-CAD8_Library_Files/Analog Devices/LTC2051HVIMS8_PBF/LTC2051HVIMS8_PBF.step
4.90 x 1.10 x 3.00 mm
