rjridle/GRAMS/Ki-CAD8_Library_Files/Analog Devices/RH1086MH/H_05-08-1330_ADI.step

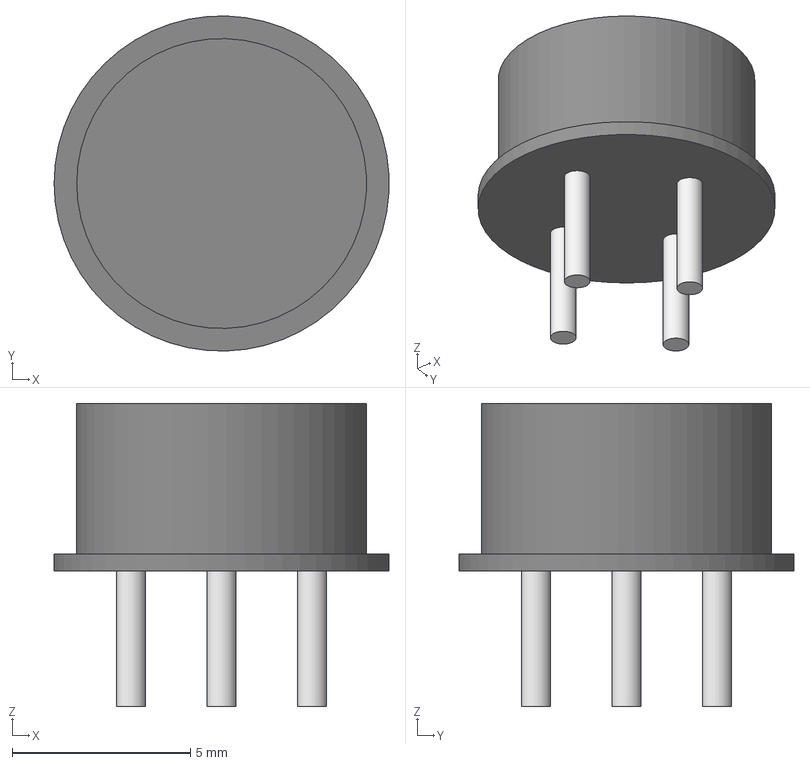
[picture p218: CAD file, 2025-10-30]
Ki-CAD8_Library_Files/Analog Devices/RH1086MH/H_05-08-1330_ADI.step
9.39 x 9.39 x 8.51 mm
