rjridle/GRAMS/Ki-CAD8_Library_Files/Bel Fuse INC/VCD40_D12_S2R5/VCD40-D12-S2R5.step

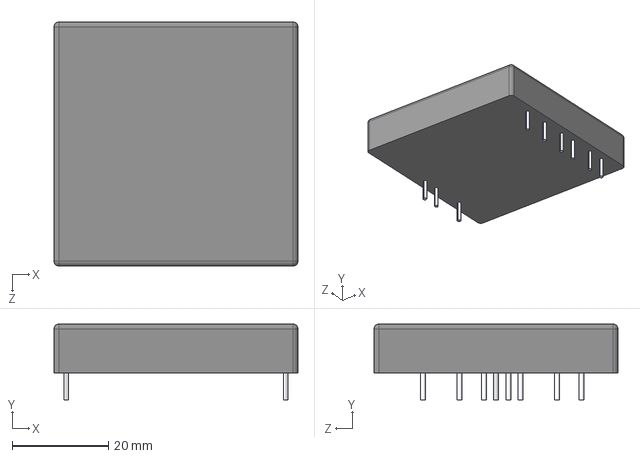
[picture p219: CAD file, 2025-10-30]
Ki-CAD8_Library_Files/Bel Fuse INC/VCD40_D12_S2R5/VCD40-D12-S2R5.step
50.8 x 15.8 x 50.8 mm
