rjridle/GRAMS/Ki-CAD8_Library_Files/CoilCraft/0603PS_/Coilcraft-0603PS/Coilcraft-0603PS.STEP

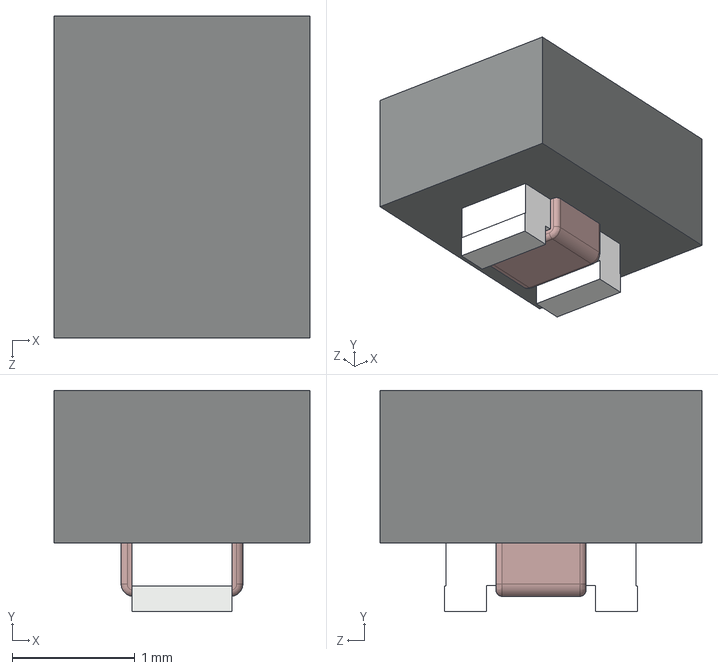
[picture p220: CAD file, 2025-10-30]
Ki-CAD8_Library_Files/CoilCraft/0603PS_/Coilcraft-0603PS/Coilcraft-0603PS.STEP
2.08 x 1.80 x 2.62 mm
