rjridle/GRAMS/Ki-CAD8_Library_Files/CoilCraft/AGM2222-192ME/Coilcraft-AGM2222-192.step

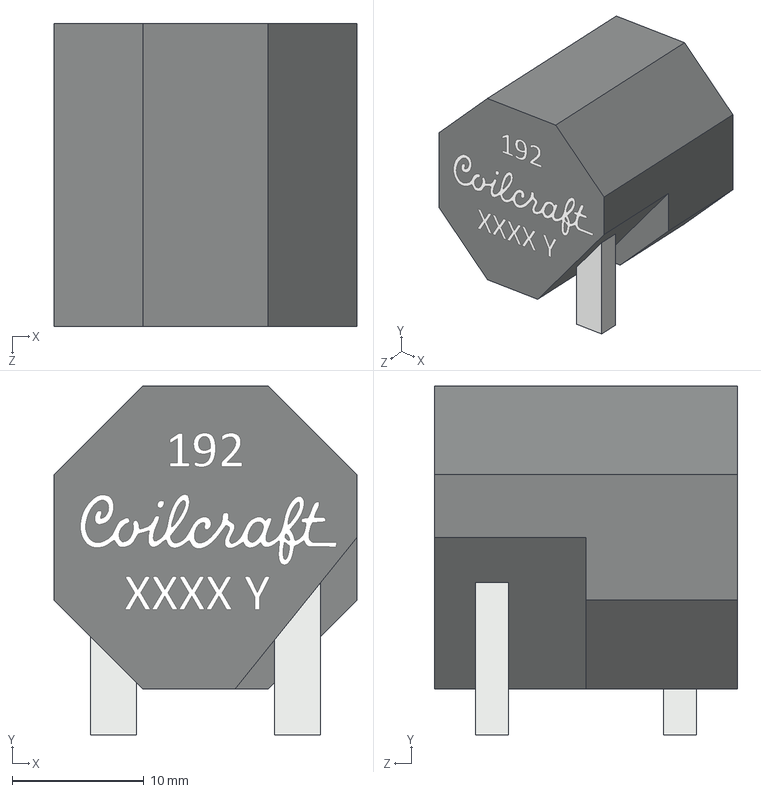
[picture p221: CAD file, 2025-10-30]
Ki-CAD8_Library_Files/CoilCraft/AGM2222-192ME/Coilcraft-AGM2222-192.step
23.0 x 26.5 x 23.0 mm
