rjridle/GRAMS/Ki-CAD8_Library_Files/CoilCraft/LP3030/Coilcraft-LPS3030/Coilcraft-LPS3030.STEP

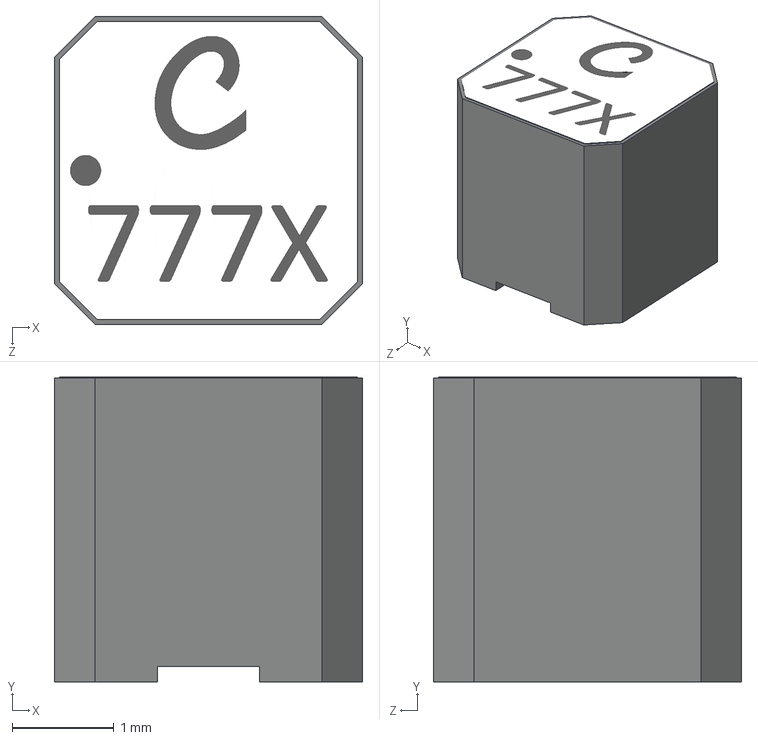
[picture p222: CAD file, 2025-10-30]
Ki-CAD8_Library_Files/CoilCraft/LP3030/Coilcraft-LPS3030/Coilcraft-LPS3030.STEP
3.03 x 3.00 x 3.03 mm
