rjridle/GRAMS/Ki-CAD8_Library_Files/CoilCraft/LPS3008/Coilcraft-LPS3008.STEP

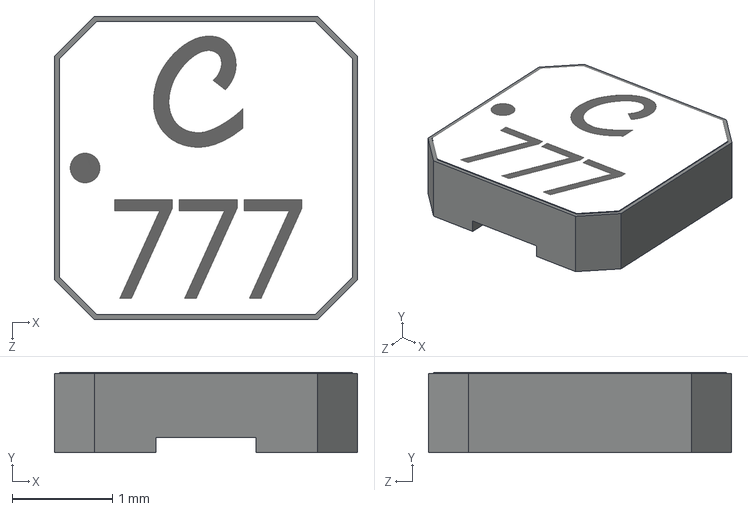
[picture p223: CAD file, 2025-10-30]
Ki-CAD8_Library_Files/CoilCraft/LPS3008/Coilcraft-LPS3008.STEP
3.03 x 0.8 x 3.03 mm
