rjridle/GRAMS/Ki-CAD8_Library_Files/CoilCraft/MLC1260/3D/Coilcraft-MLC1260.step

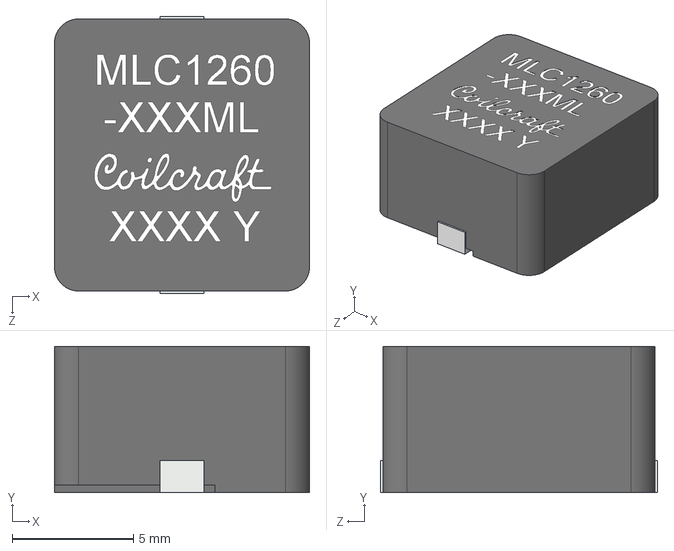
[picture p224: CAD file, 2025-10-30]
Ki-CAD8_Library_Files/CoilCraft/MLC1260/3D/Coilcraft-MLC1260.step
10.5 x 6.01 x 11.4 mm
