rjridle/GRAMS/Ki-CAD8_Library_Files/CoilCraft/MLC1538-/Coilcraft-MLC1538.STEP

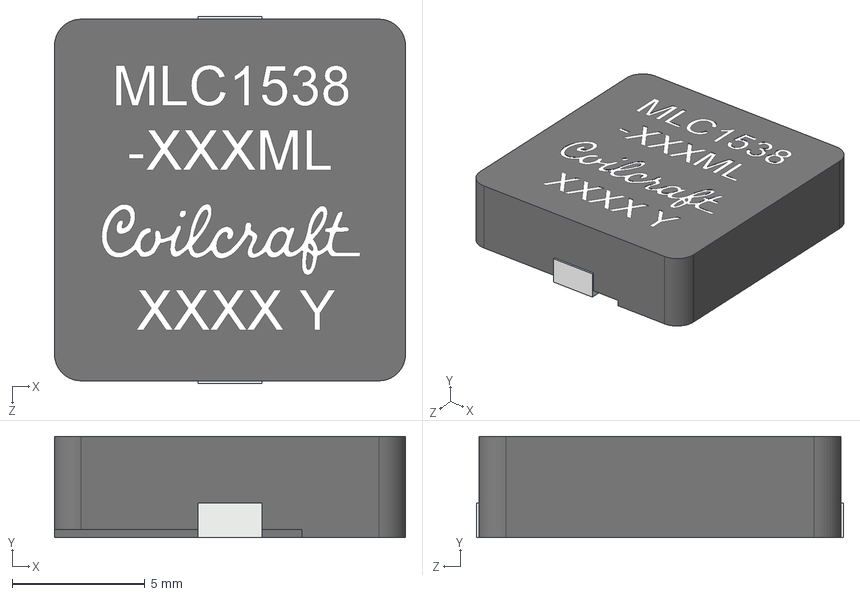
[picture p225: CAD file, 2025-10-30]
Ki-CAD8_Library_Files/CoilCraft/MLC1538-/Coilcraft-MLC1538.STEP
13.2 x 3.81 x 13.8 mm
