rjridle/GRAMS/Ki-CAD8_Library_Files/CoilCraft/MSD1048/Coilcraft-MSD1048.STEP

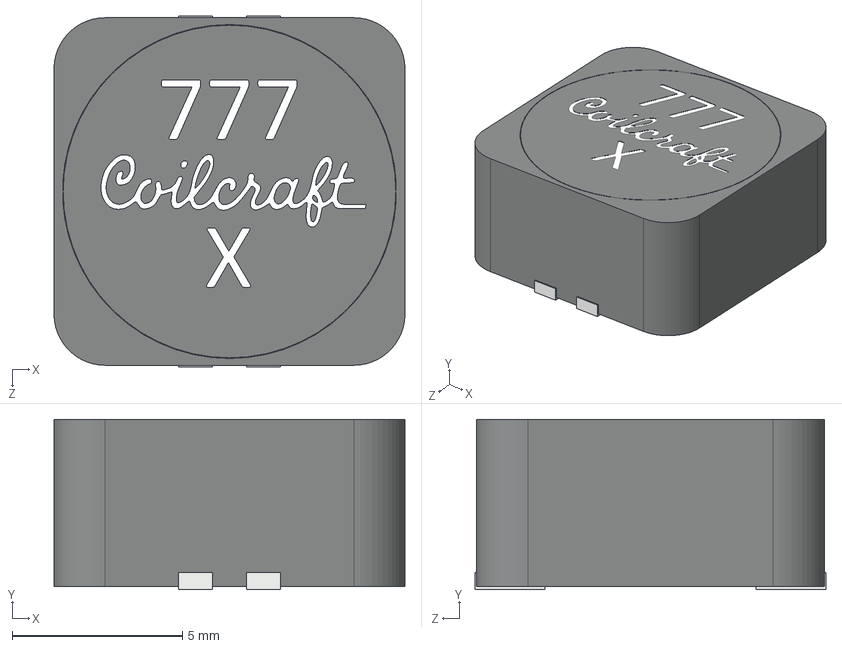
[picture p226: CAD file, 2025-10-30]
Ki-CAD8_Library_Files/CoilCraft/MSD1048/Coilcraft-MSD1048.STEP
10.3 x 5.00 x 10.3 mm
