rjridle/GRAMS/Ki-CAD8_Library_Files/CoilCraft/MSD_1583/Coilcraft-MSD1583.STEP

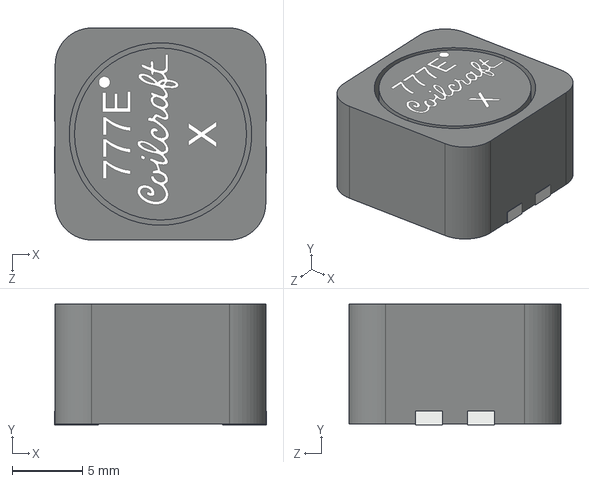
[picture p227: CAD file, 2025-10-30]
Ki-CAD8_Library_Files/CoilCraft/MSD_1583/Coilcraft-MSD1583.STEP
15.1 x 8.60 x 15.1 mm
