rjridle/GRAMS/Ki-CAD8_Library_Files/CoilCraft/P3215/Coilcraft-P3215-AL.STEP

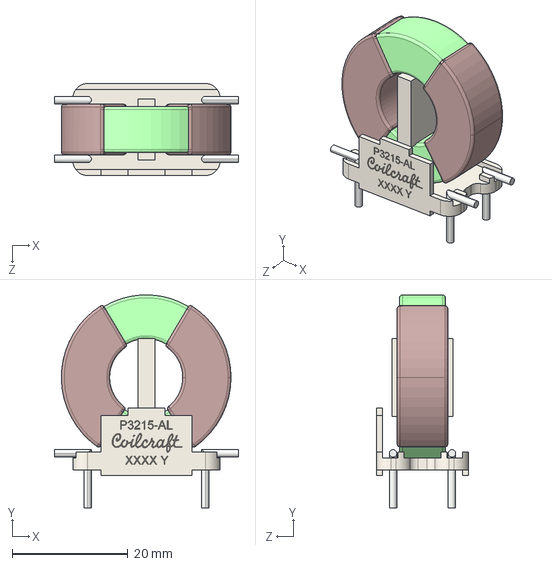
[picture p228: CAD file, 2025-10-30]
Ki-CAD8_Library_Files/CoilCraft/P3215/Coilcraft-P3215-AL.STEP
31.8 x 36.8 x 15.9 mm
