rjridle/GRAMS/Ki-CAD8_Library_Files/CoilCraft/PS6235-822MR/Coilcraft-LPS6235/Coilcraft-LPS6235.STEP

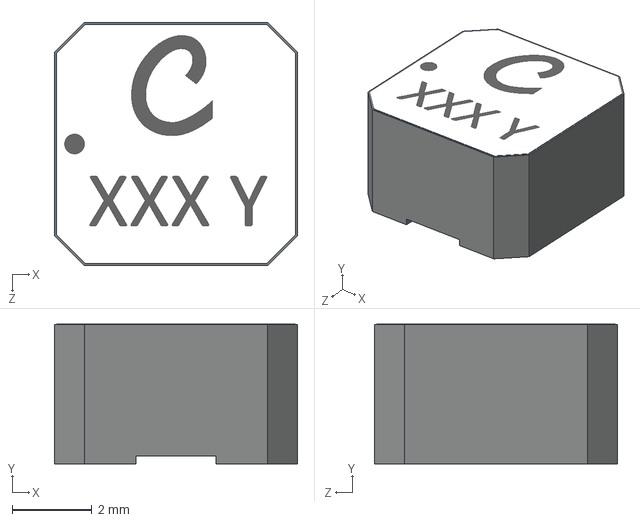
[picture p229: CAD file, 2025-10-30]
Ki-CAD8_Library_Files/CoilCraft/PS6235-822MR/Coilcraft-LPS6235/Coilcraft-LPS6235.STEP
6.08 x 3.50 x 6.08 mm
