rjridle/GRAMS/Ki-CAD8_Library_Files/CoilCraft/XAL4020/Coilcraft-XAL4020.STEP

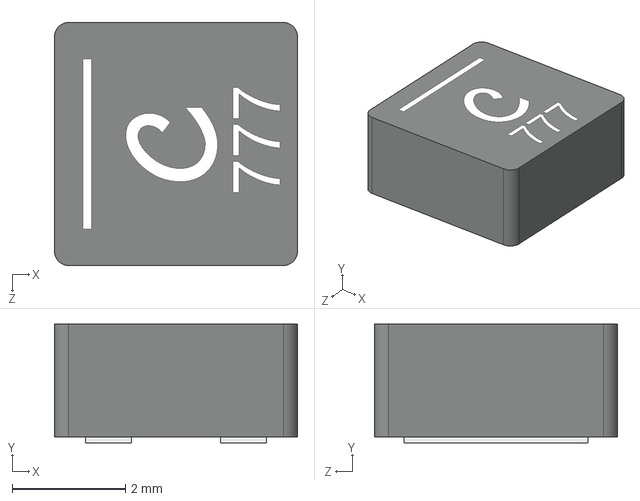
[picture p230: CAD file, 2025-10-30]
Ki-CAD8_Library_Files/CoilCraft/XAL4020/Coilcraft-XAL4020.STEP
4.30 x 2.10 x 4.30 mm
