rjridle/GRAMS/Ki-CAD8_Library_Files/CUI/PRC60-24-S12/PRC60-24-S12.step

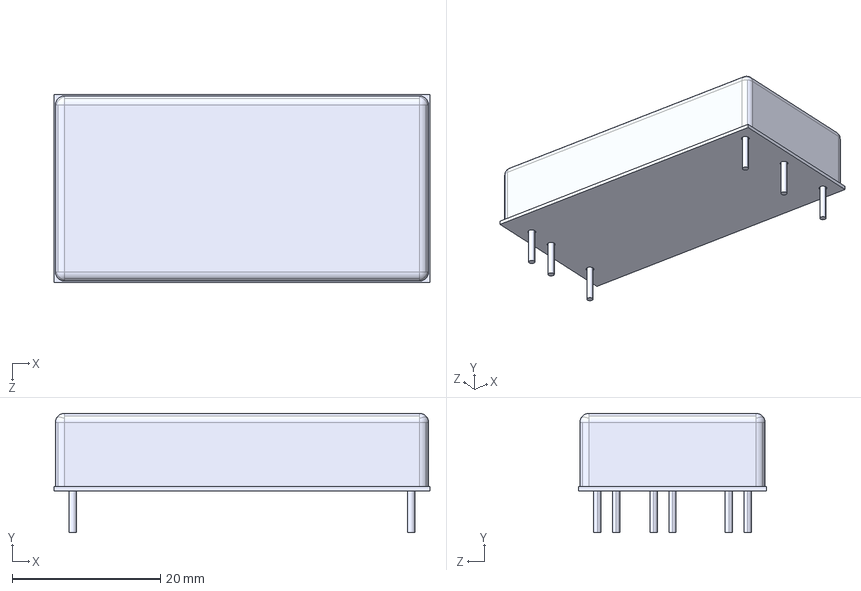
[picture p231: CAD file, 2025-10-30]
Ki-CAD8_Library_Files/CUI/PRC60-24-S12/PRC60-24-S12.step
50.8 x 16.1 x 25.4 mm
