rjridle/GRAMS/Ki-CAD8_Library_Files/CUI/PRFE20W_O72_S5_D/PRFE20W-O72-S5-D.step

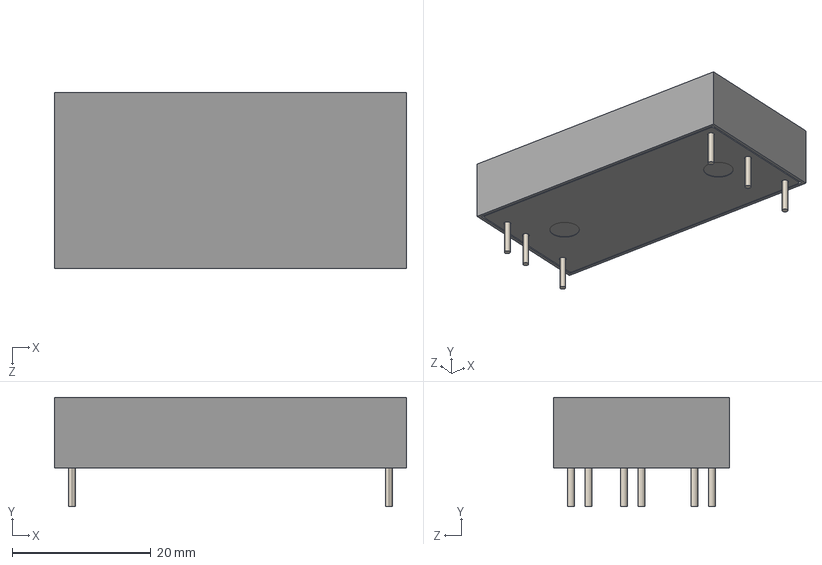
[picture p232: CAD file, 2025-10-30]
Ki-CAD8_Library_Files/CUI/PRFE20W_O72_S5_D/PRFE20W-O72-S5-D.step
50.8 x 15.8 x 25.4 mm
