rjridle/GRAMS/Ki-CAD8_Library_Files/CUI/PRQE75W_E12_S12_D/PRQE75W-E12-S12-D.step

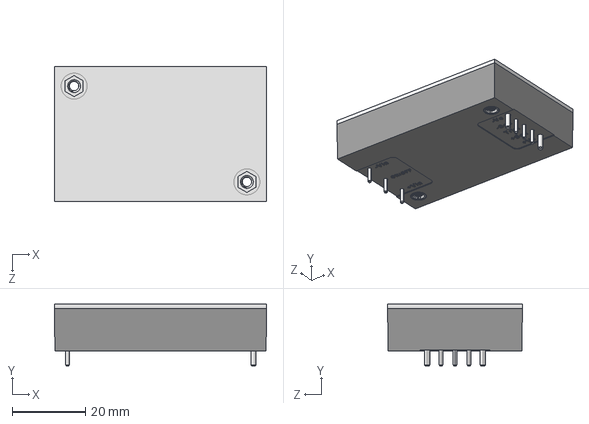
[picture p233: CAD file, 2025-10-30]
Ki-CAD8_Library_Files/CUI/PRQE75W_E12_S12_D/PRQE75W-E12-S12-D.step
57.9 x 16.9 x 36.8 mm
