rjridle/GRAMS/Ki-CAD8_Library_Files/Eaton/1245HC100_RTR/1245HC100-RTR_COB.step

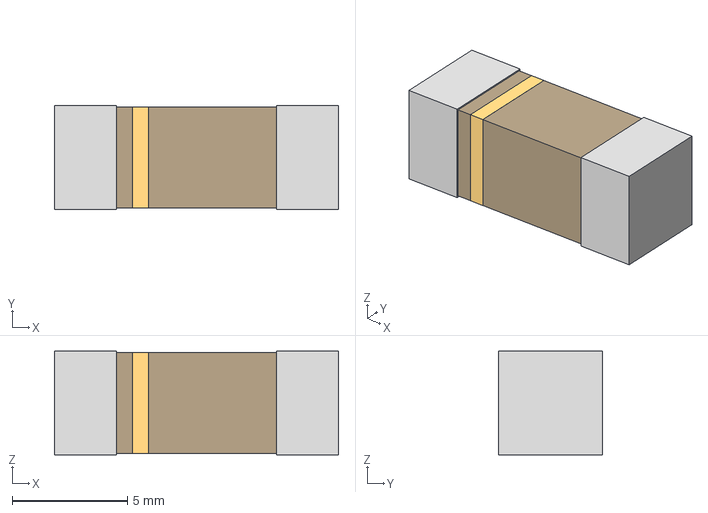
[picture p234: CAD file, 2025-10-30]
Ki-CAD8_Library_Files/Eaton/1245HC100_RTR/1245HC100-RTR_COB.step
12.3 x 4.50 x 4.50 mm
