rjridle/GRAMS/Ki-CAD8_Library_Files/Foil Resistors/Ohmite/FCSL20R010FER/RES_FCSL20_OHM.step

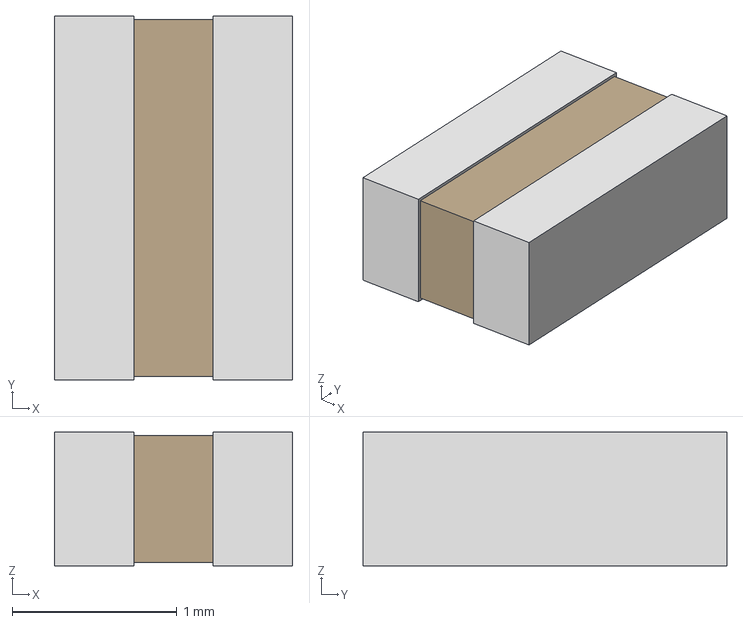
[picture p235: CAD file, 2025-10-30]
Ki-CAD8_Library_Files/Foil Resistors/Ohmite/FCSL20R010FER/RES_FCSL20_OHM.step
1.45 x 2.21 x 0.813 mm
