rjridle/GRAMS/Ki-CAD8_Library_Files/GCT/SMA_RT_TH_FEMALE/RFPC-SMA27-F.step

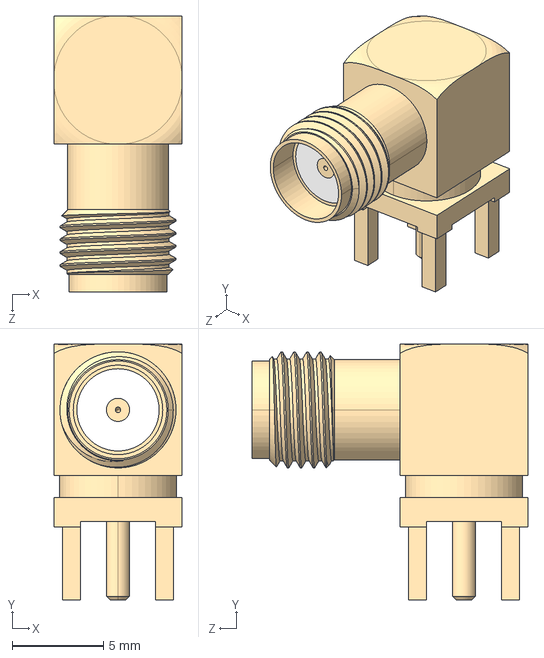
[picture p236: CAD file, 2025-10-30]
Ki-CAD8_Library_Files/GCT/SMA_RT_TH_FEMALE/RFPC-SMA27-F.step
7.00 x 14.0 x 15.1 mm
