rjridle/GRAMS/Ki-CAD8_Library_Files/KEMET/LIB_SCT25XV-280-2R1A005JV/SCT25XV-280-2R1A005JV/3D/SCT25XV-280-2R1A005JV.stp

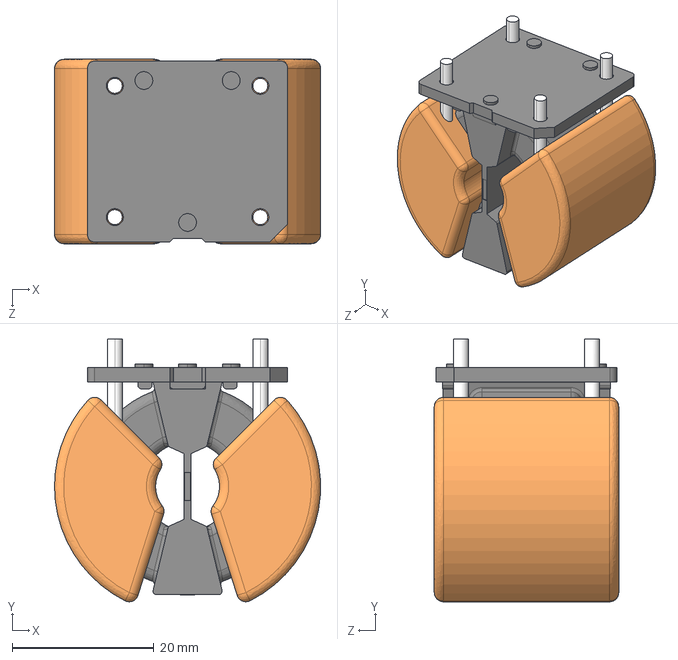
[picture p237: CAD file, 2025-10-30]
Ki-CAD8_Library_Files/KEMET/LIB_SCT25XV-280-2R1A005JV/SCT25XV-280-2R1A005JV/3D/SCT25XV-280-2R1A005JV.stp
37.5 x 37.0 x 26.0 mm
