rjridle/GRAMS/Ki-CAD8_Library_Files/KEMET/T491A106M016AT/CTSM_TCM2NK_3216_L3.4W1.8H1.8T0.13S0.8F1.3A1.2B0.55E1.3G1.1P0.4R0.4X0.2.step

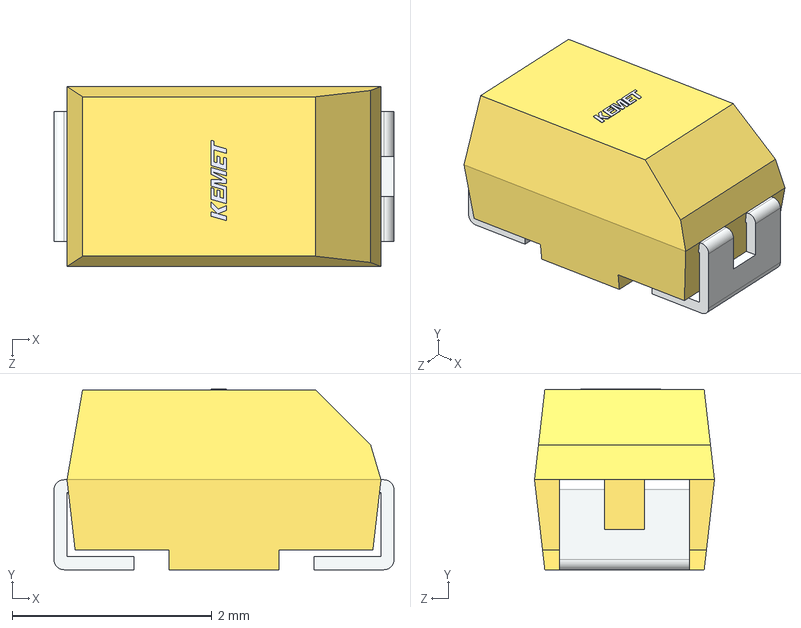
[picture p238: CAD file, 2025-10-30]
Ki-CAD8_Library_Files/KEMET/T491A106M016AT/CTSM_TCM2NK_3216_L3.4W1.8H1.8T0.13S0.8F1.3A1.2B0.55E1.3G1.1P0.4R0.4X0.2.step
3.40 x 1.81 x 1.80 mm
