rjridle/GRAMS/Ki-CAD8_Library_Files/KEMET/T495E107K025ATE100/T495E107K025ATE100.STEP

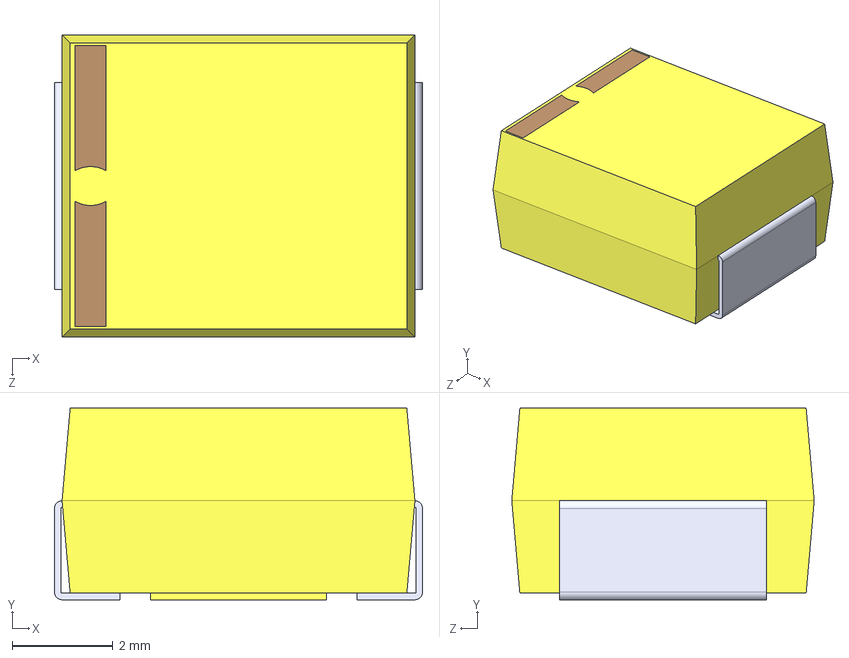
[picture p239: CAD file, 2025-10-30]
Ki-CAD8_Library_Files/KEMET/T495E107K025ATE100/T495E107K025ATE100.STEP
7.30 x 3.80 x 6.00 mm
