rjridle/GRAMS/Ki-CAD8_Library_Files/KEMET/T495E157K020ATE080/CTSM_TCM2NKRP_7360_L7.6W6.3H3.8T0.13S1.3F4.2A3.6B0.65E3.5G3.5X0.2.step

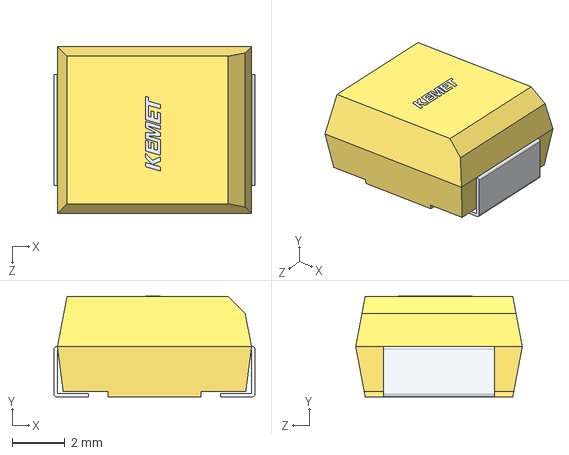
[picture p240: CAD file, 2025-10-30]
Ki-CAD8_Library_Files/KEMET/T495E157K020ATE080/CTSM_TCM2NKRP_7360_L7.6W6.3H3.8T0.13S1.3F4.2A3.6B0.65E3.5G3.5X0.2.step
7.60 x 3.81 x 6.30 mm
