rjridle/GRAMS/Ki-CAD8_Library_Files/Keystone/5002/5002.step

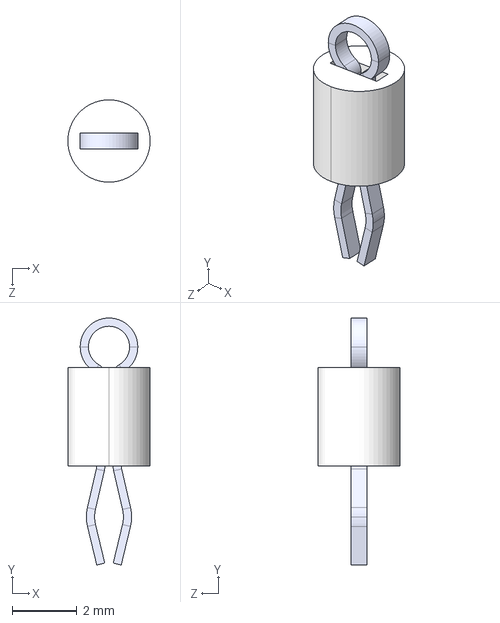
[picture p241: CAD file, 2025-10-30]
Ki-CAD8_Library_Files/Keystone/5002/5002.step
2.54 x 7.62 x 2.54 mm
