rjridle/GRAMS/Ki-CAD8_Library_Files/Keystone/5003/5003.step

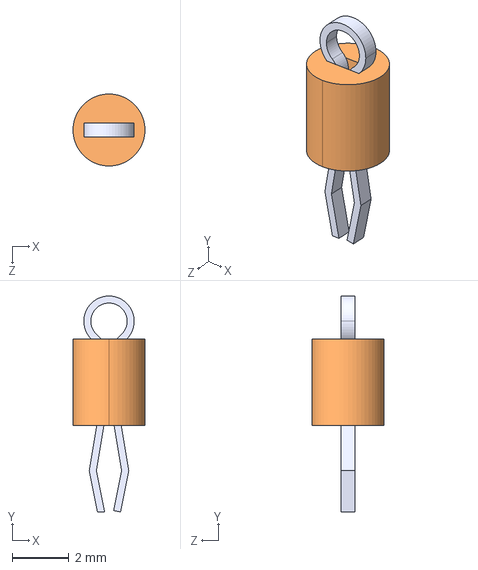
[picture p242: CAD file, 2025-10-30]
Ki-CAD8_Library_Files/Keystone/5003/5003.step
2.54 x 7.62 x 2.54 mm
