rjridle/GRAMS/Ki-CAD8_Library_Files/Keystone/5005/5005.step

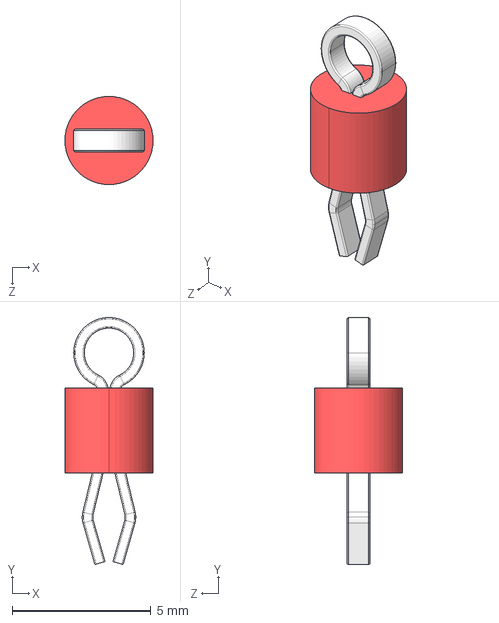
[picture p243: CAD file, 2025-10-30]
Ki-CAD8_Library_Files/Keystone/5005/5005.step
3.17 x 8.89 x 3.17 mm
