rjridle/GRAMS/Ki-CAD8_Library_Files/Keystone/5015/5015.step

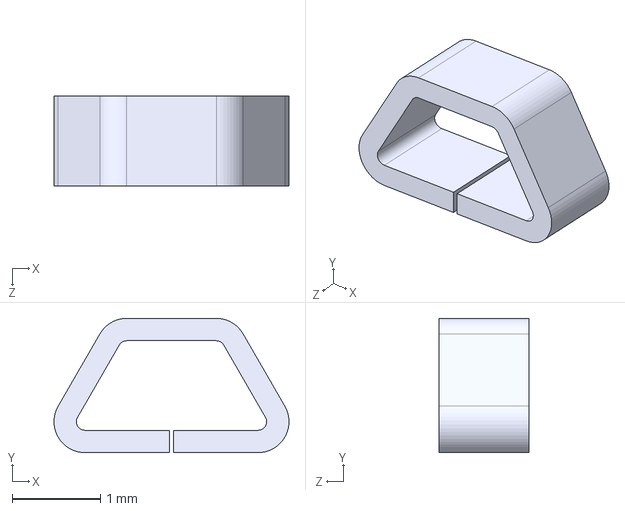
[picture p244: CAD file, 2025-10-30]
Ki-CAD8_Library_Files/Keystone/5015/5015.step
2.67 x 1.52 x 1.02 mm
