rjridle/GRAMS/Ki-CAD8_Library_Files/Keystone/5016/5016.step

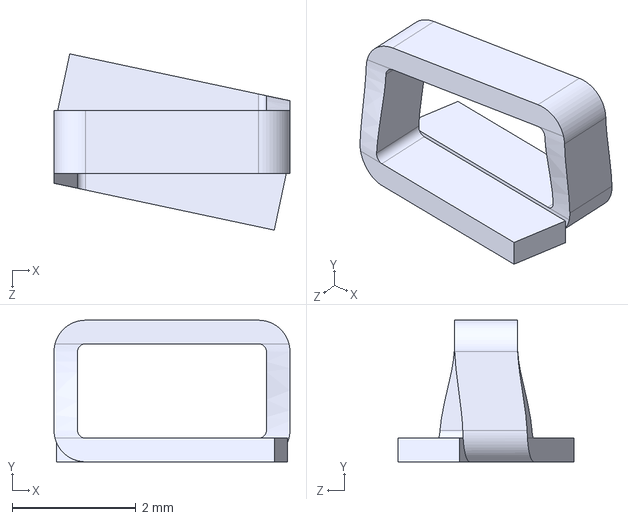
[picture p245: CAD file, 2025-10-30]
Ki-CAD8_Library_Files/Keystone/5016/5016.step
3.81 x 2.29 x 2.84 mm
