rjridle/GRAMS/Ki-CAD8_Library_Files/Keystone/5019/5019.step

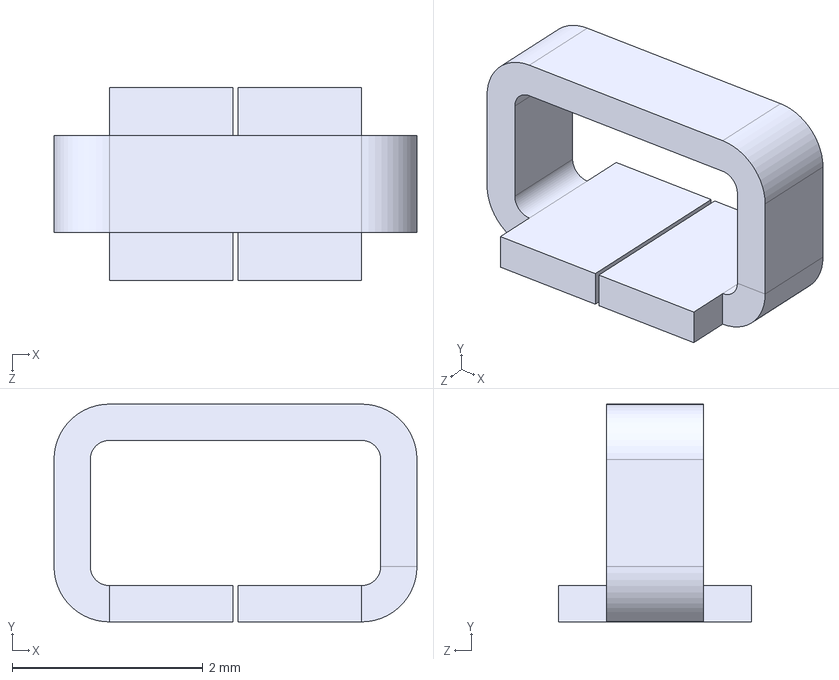
[picture p246: CAD file, 2025-10-30]
Ki-CAD8_Library_Files/Keystone/5019/5019.step
3.81 x 2.29 x 2.03 mm
