rjridle/GRAMS/Ki-CAD8_Library_Files/Little_Fuse/0451004_MRL/0451Series_LTF.step

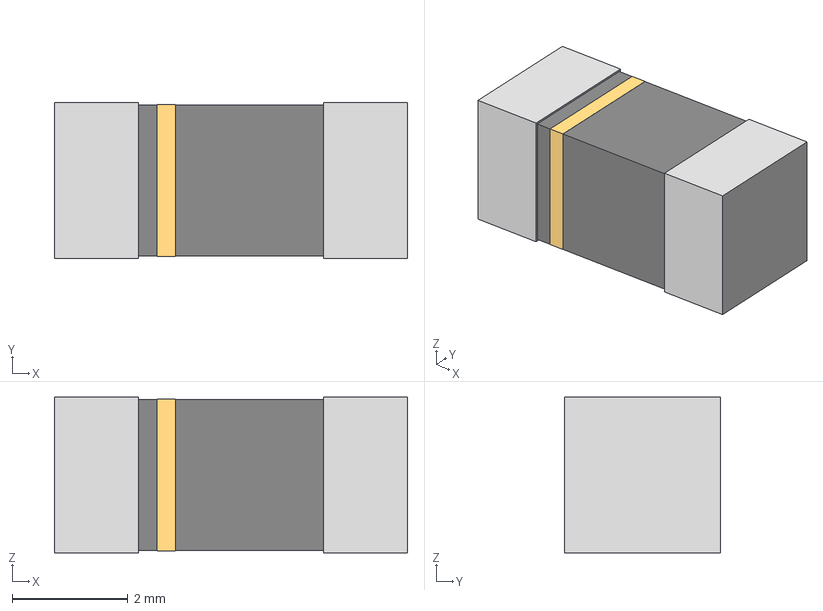
[picture p247: CAD file, 2025-10-30]
Ki-CAD8_Library_Files/Little_Fuse/0451004_MRL/0451Series_LTF.step
6.10 x 2.69 x 2.69 mm
