rjridle/GRAMS/Ki-CAD8_Library_Files/Little_Fuse/36913150000/FUSE_36913150000_LTF.step

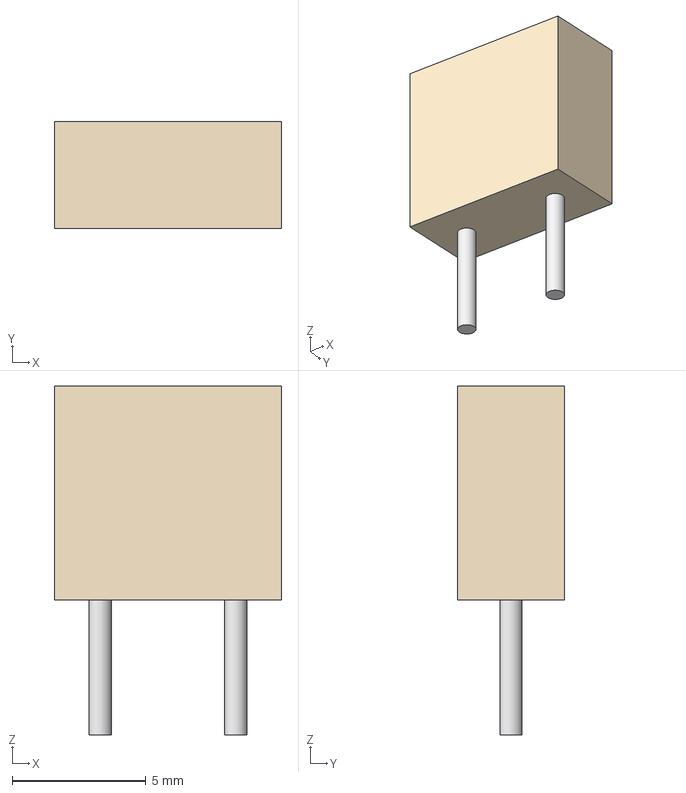
[picture p248: CAD file, 2025-10-30]
Ki-CAD8_Library_Files/Little_Fuse/36913150000/FUSE_36913150000_LTF.step
8.51 x 3.99 x 13.1 mm
