rjridle/GRAMS/Ki-CAD8_Library_Files/Little_Fuse/SP3205_01ETG/SDO_SOD882_LTF.step

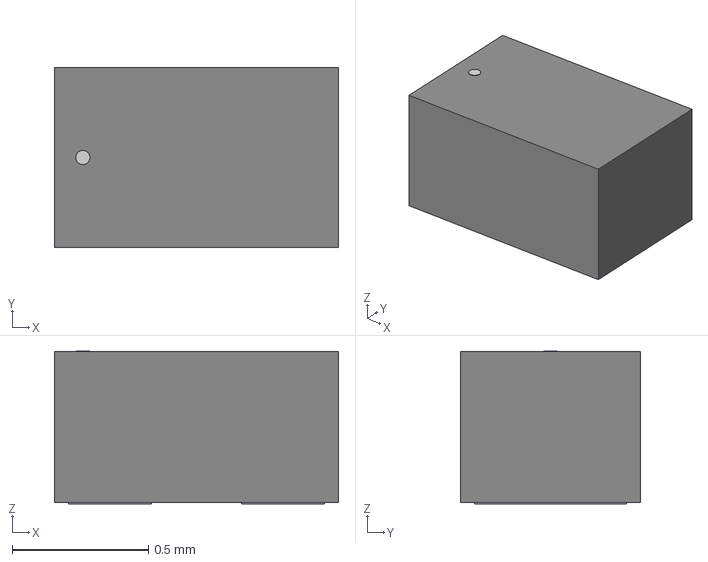
[picture p249: CAD file, 2025-10-30]
Ki-CAD8_Library_Files/Little_Fuse/SP3205_01ETG/SDO_SOD882_LTF.step
1.04 x 0.66 x 0.561 mm
