rjridle/GRAMS/Ki-CAD8_Library_Files/Molex/1731130182/2311775_1/c-2311775-1-a-3d.stp

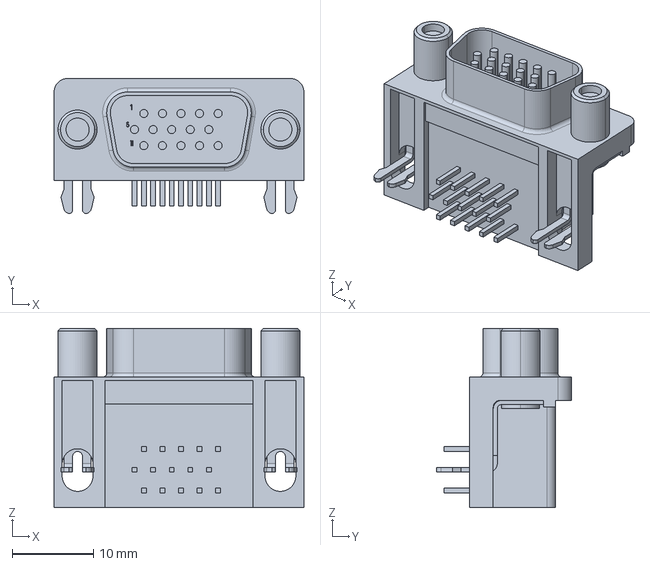
[picture p250: CAD file, 2025-10-30]
Ki-CAD8_Library_Files/Molex/1731130182/2311775_1/c-2311775-1-a-3d.stp
30.8 x 16.6 x 22.1 mm
