rjridle/GRAMS/Ki-CAD8_Library_Files/Murata_Electronics/Safety_Capacitors/GA342QR7GD681KW01L/GA342QR7GD681KW01L.step

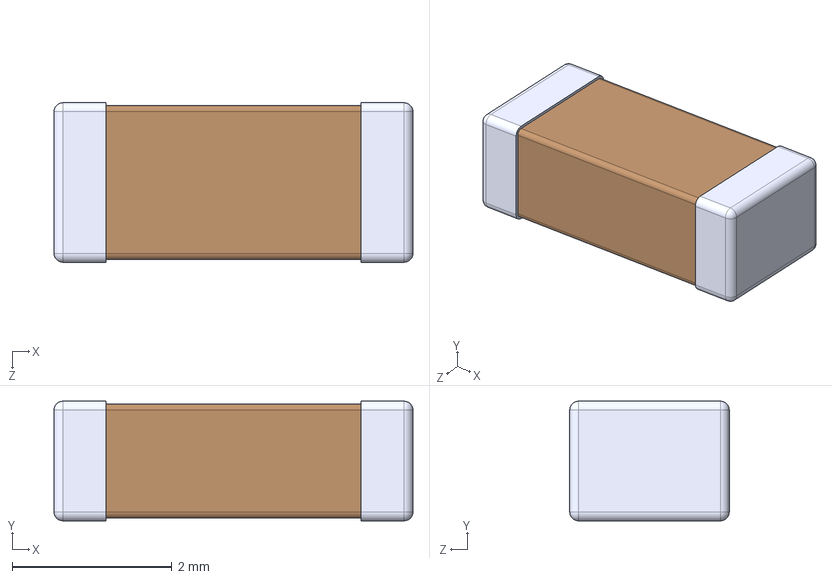
[picture p251: CAD file, 2025-10-30]
Ki-CAD8_Library_Files/Murata_Electronics/Safety_Capacitors/GA342QR7GD681KW01L/GA342QR7GD681KW01L.step
4.50 x 1.50 x 2.00 mm
