rjridle/GRAMS/Ki-CAD8_Library_Files/Murata_Electronics/Safety_Capacitors/GA355QR7GF222KW01L.STEP

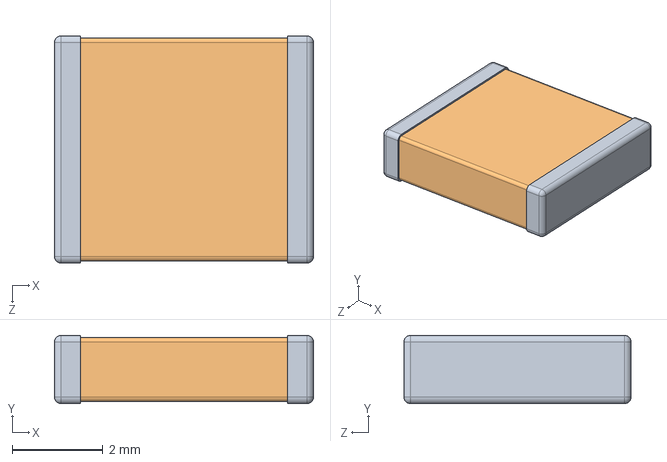
[picture p252: CAD file, 2025-10-30]
Ki-CAD8_Library_Files/Murata_Electronics/Safety_Capacitors/GA355QR7GF222KW01L.STEP
5.70 x 1.50 x 5.00 mm
