rjridle/GRAMS/Ki-CAD8_Library_Files/Nexperia/PED5V5C1ULYL/SOD962-2_NEX.step

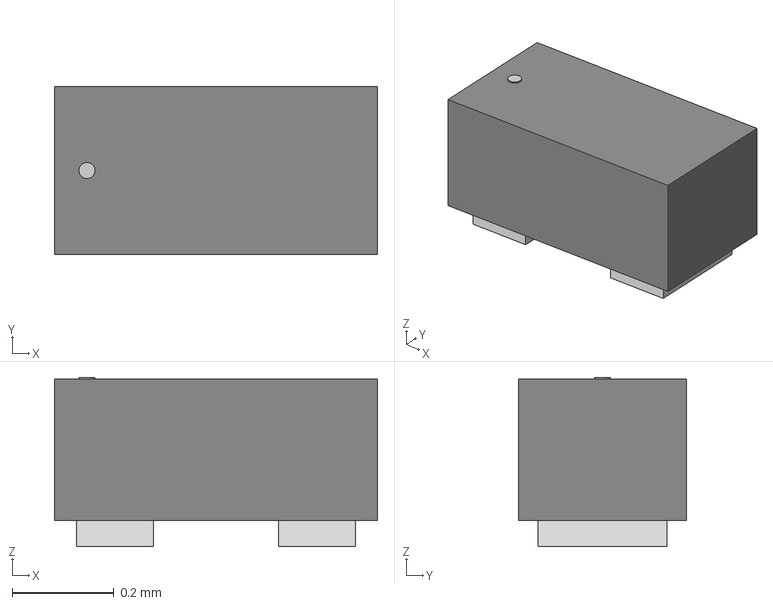
[picture p253: CAD file, 2025-10-30]
Ki-CAD8_Library_Files/Nexperia/PED5V5C1ULYL/SOD962-2_NEX.step
0.636 x 0.33 x 0.333 mm
