rjridle/GRAMS/Ki-CAD8_Library_Files/Nexperia/PLVA653A_215/PLVA653A_215.step

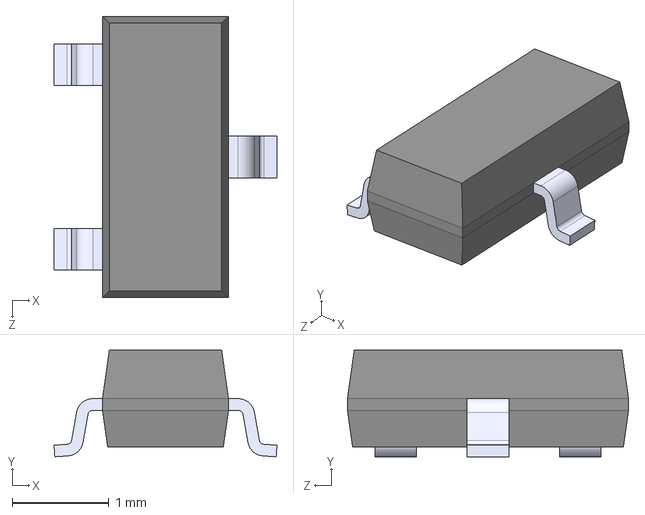
[picture p254: CAD file, 2025-10-30]
Ki-CAD8_Library_Files/Nexperia/PLVA653A_215/PLVA653A_215.step
2.30 x 1.10 x 2.90 mm
