rjridle/GRAMS/Ki-CAD8_Library_Files/Nexperia/ul_PLVA650A-215/PLVA650A_215_NEX.step

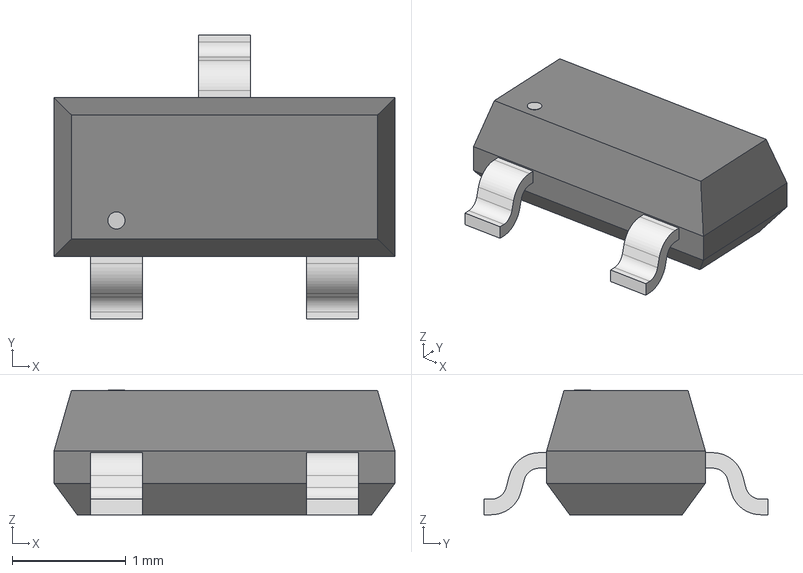
[picture p255: CAD file, 2025-10-30]
Ki-CAD8_Library_Files/Nexperia/ul_PLVA650A-215/PLVA650A_215_NEX.step
3.00 x 2.50 x 1.09 mm
