rjridle/GRAMS/Ki-CAD8_Library_Files/ONSEMI/1N4004/1N4004.step

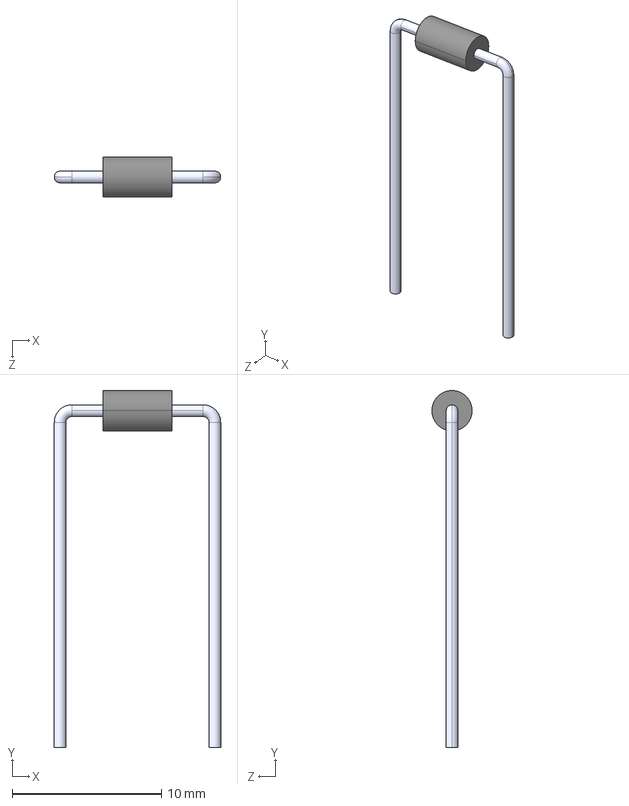
[picture p256: CAD file, 2025-10-30]
Ki-CAD8_Library_Files/ONSEMI/1N4004/1N4004.step
11.1 x 23.9 x 2.70 mm
