rjridle/GRAMS/Ki-CAD8_Library_Files/ONSEMI/FIN1002M5X/SOT-23-5_ONS.step

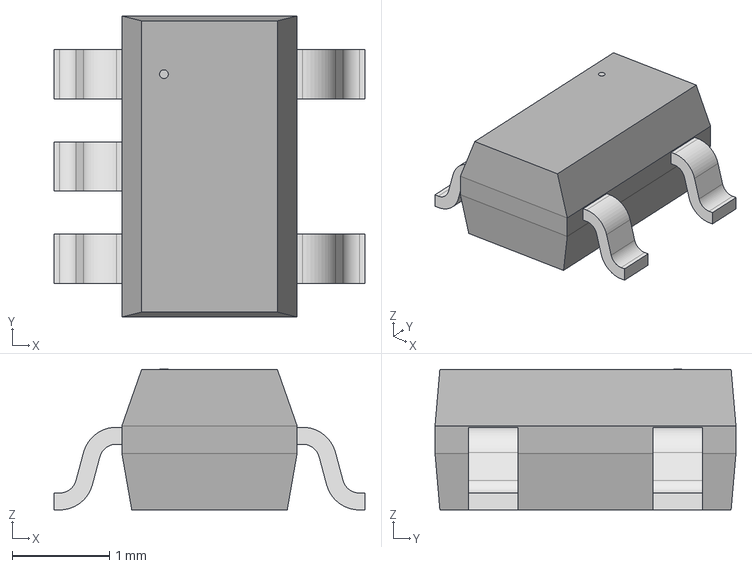
[picture p257: CAD file, 2025-10-30]
Ki-CAD8_Library_Files/ONSEMI/FIN1002M5X/SOT-23-5_ONS.step
3.20 x 3.10 x 1.45 mm
