rjridle/GRAMS/Ki-CAD8_Library_Files/ONSEMI/MMSZ13T1G/SOD-123_ONS.step

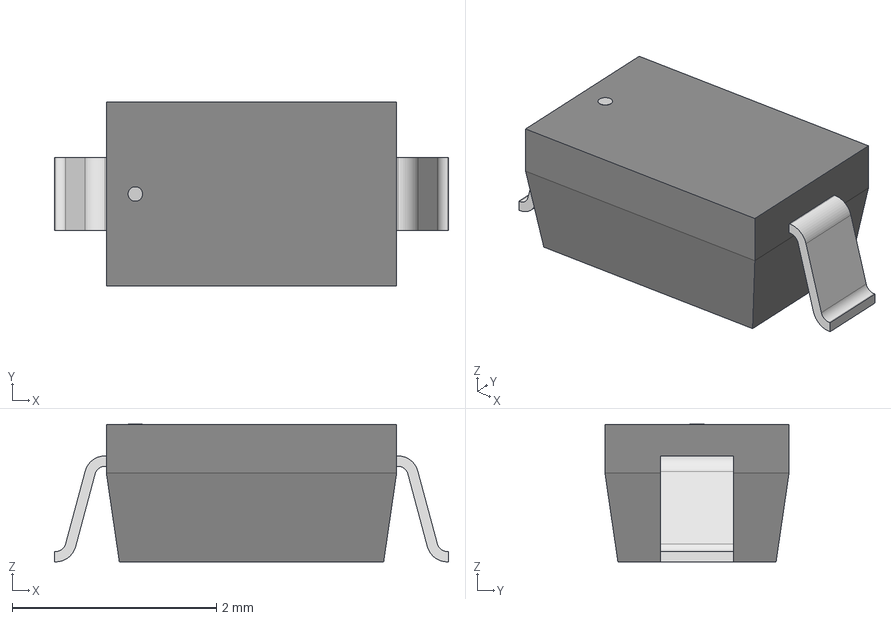
[picture p258: CAD file, 2025-10-30]
Ki-CAD8_Library_Files/ONSEMI/MMSZ13T1G/SOD-123_ONS.step
3.86 x 1.80 x 1.35 mm
