rjridle/GRAMS/Ki-CAD8_Library_Files/ONSEMI/ZENER/3p9V_3W/1SMB5915BT3G/1SMB5915BT3G.step

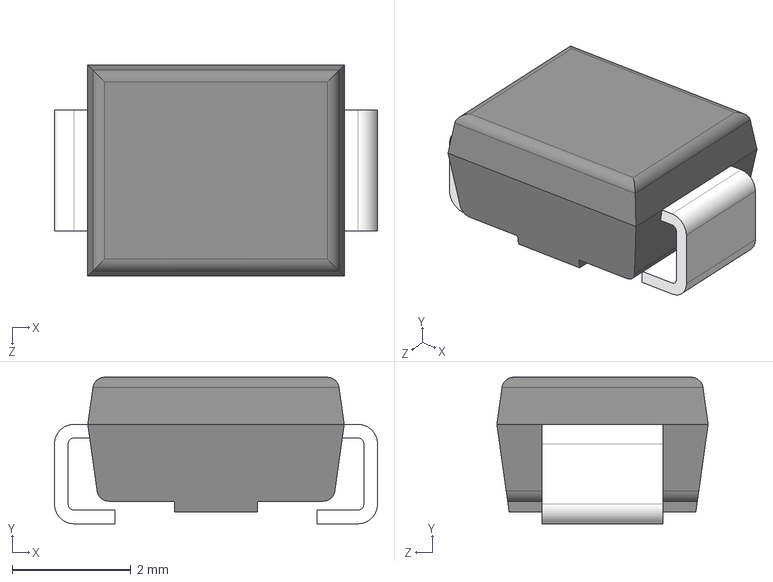
[picture p259: CAD file, 2025-10-30]
Ki-CAD8_Library_Files/ONSEMI/ZENER/3p9V_3W/1SMB5915BT3G/1SMB5915BT3G.step
5.44 x 2.47 x 3.56 mm
