rjridle/GRAMS/Ki-CAD8_Library_Files/SAMTEC/TFML-107-01-L-D-LC/TFML-107-01-L-D-LC/TFML-107-01-L-D-LC.step

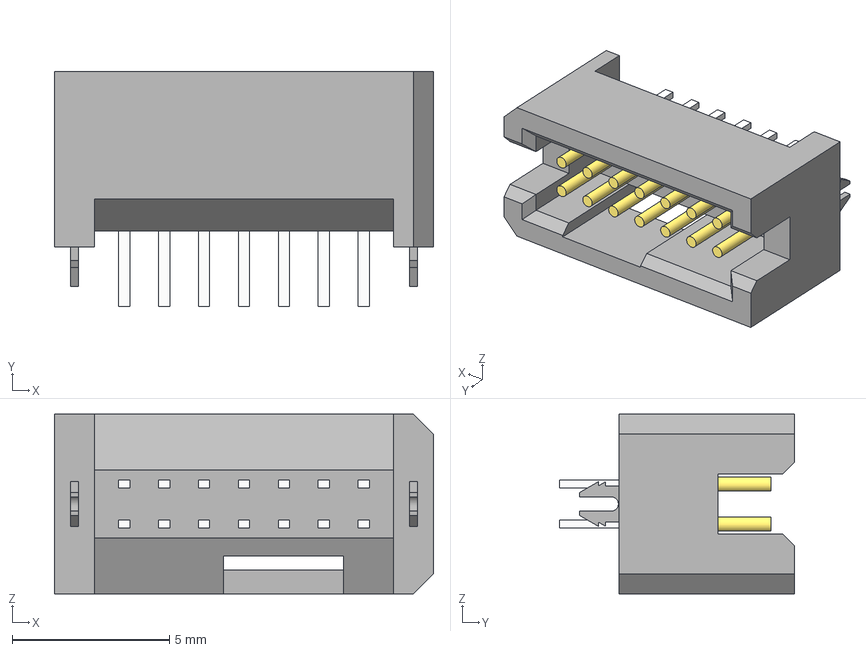
[picture p260: CAD file, 2025-10-30]
Ki-CAD8_Library_Files/SAMTEC/TFML-107-01-L-D-LC/TFML-107-01-L-D-LC/TFML-107-01-L-D-LC.step
12.1 x 7.49 x 5.71 mm
TFML-107-01-L-D-LC_terminal
TFML-107-01-L-D-L_pins
TFML-107-01-L-D-L-2_pins
