rjridle/GRAMS/Ki-CAD8_Library_Files/STMicroelectronics/ESDA7P120_1U1M/DIODE_ESDA7P120-1U1M_STM.step

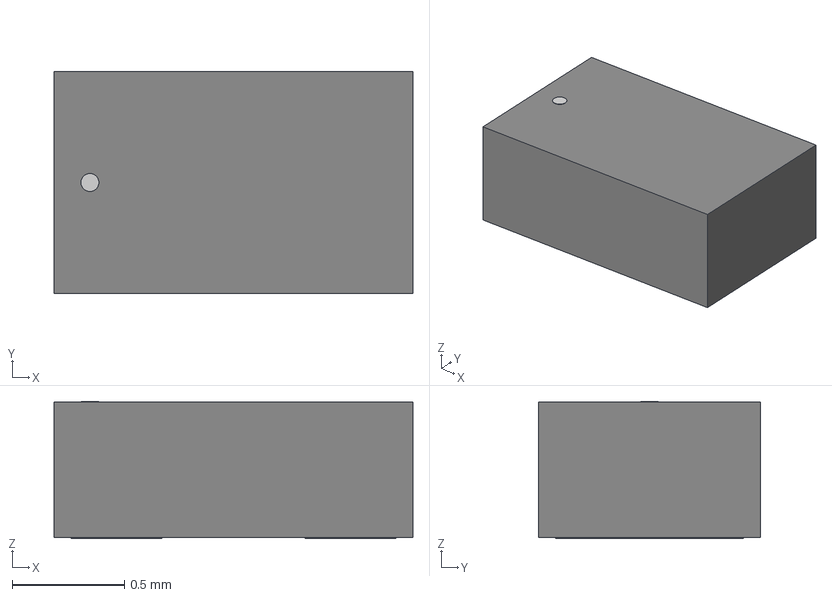
[picture p261: CAD file, 2025-10-30]
Ki-CAD8_Library_Files/STMicroelectronics/ESDA7P120_1U1M/DIODE_ESDA7P120-1U1M_STM.step
1.60 x 0.99 x 0.612 mm
