rjridle/GRAMS/Ki-CAD8_Library_Files/STMicroelectronics/LM158DT/SO_158DT_STM.step

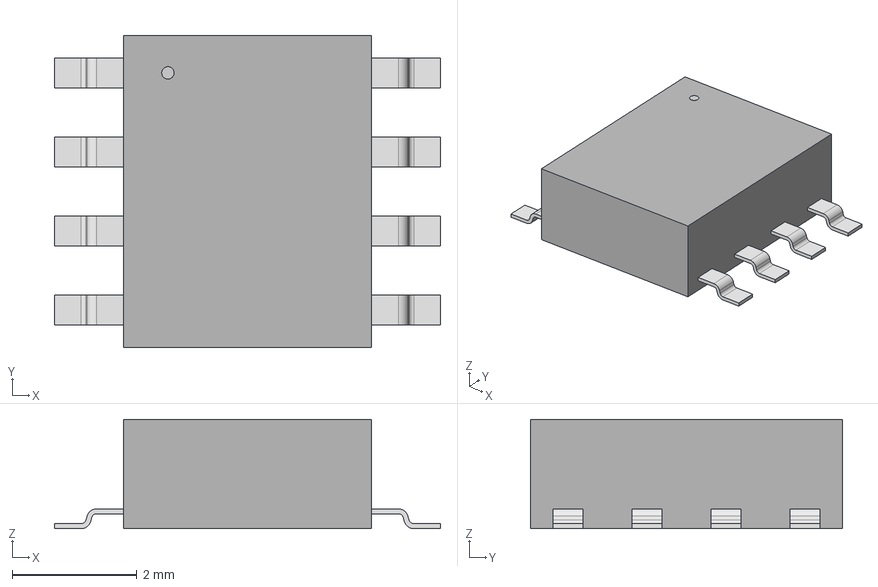
[picture p262: CAD file, 2025-10-30]
Ki-CAD8_Library_Files/STMicroelectronics/LM158DT/SO_158DT_STM.step
6.20 x 5.00 x 1.75 mm
