rjridle/GRAMS/Ki-CAD8_Library_Files/Sullins Connector Solutions/Headers(FEM)/PPTC241LFBN_RC/PPTC241LFBN-RC.step

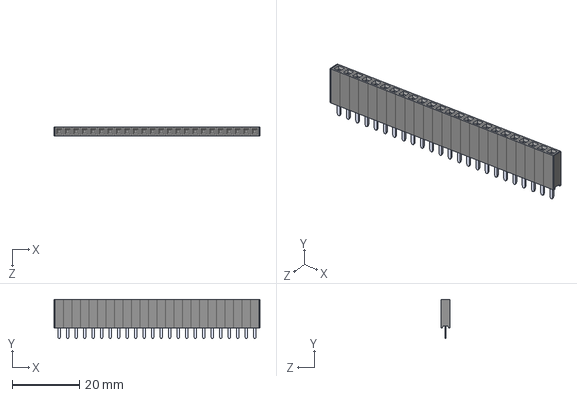
[picture p263: CAD file, 2025-10-30]
Ki-CAD8_Library_Files/Sullins Connector Solutions/Headers(FEM)/PPTC241LFBN_RC/PPTC241LFBN-RC.step
61.5 x 11.7 x 2.54 mm
PPPC021LFBN-RC_C24
Pin - Tin x 24
