rjridle/GRAMS/Ki-CAD8_Library_Files/TE-Connectivity/1_1123824_1/c-1-1123824-1-b-3d.stp

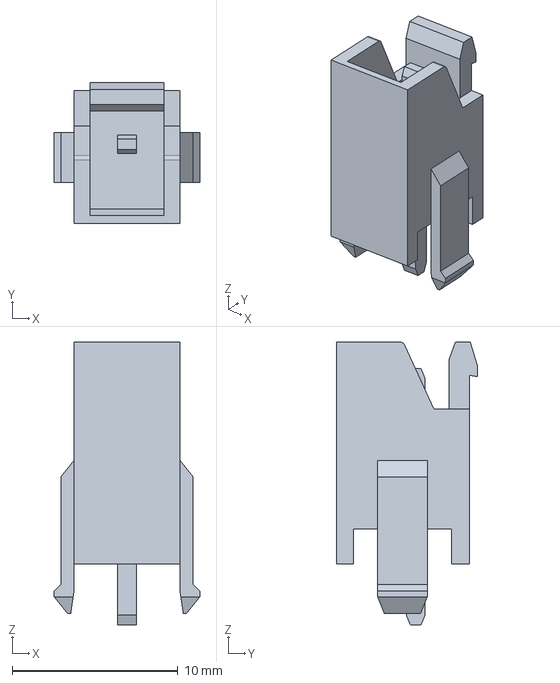
[picture p264: CAD file, 2025-10-30]
Ki-CAD8_Library_Files/TE-Connectivity/1_1123824_1/c-1-1123824-1-b-3d.stp
8.80 x 8.55 x 17.1 mm
