rjridle/GRAMS/Ki-CAD8_Library_Files/Texas Instruments/ADC/RAD-Hard/ADC128S102PWTSEP.step

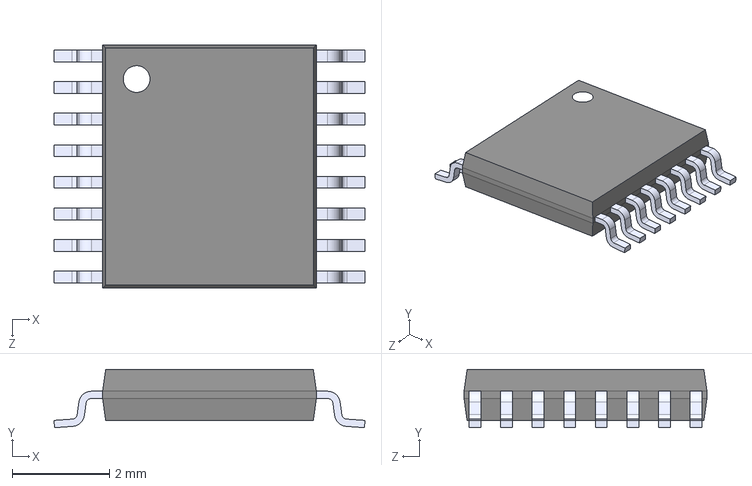
[picture p265: CAD file, 2025-10-30]
Ki-CAD8_Library_Files/Texas Instruments/ADC/RAD-Hard/ADC128S102PWTSEP.step
6.40 x 1.20 x 5.00 mm
