rjridle/GRAMS/Ki-CAD8_Library_Files/Texas Instruments/CD74HC154M96/DW0024A.stp

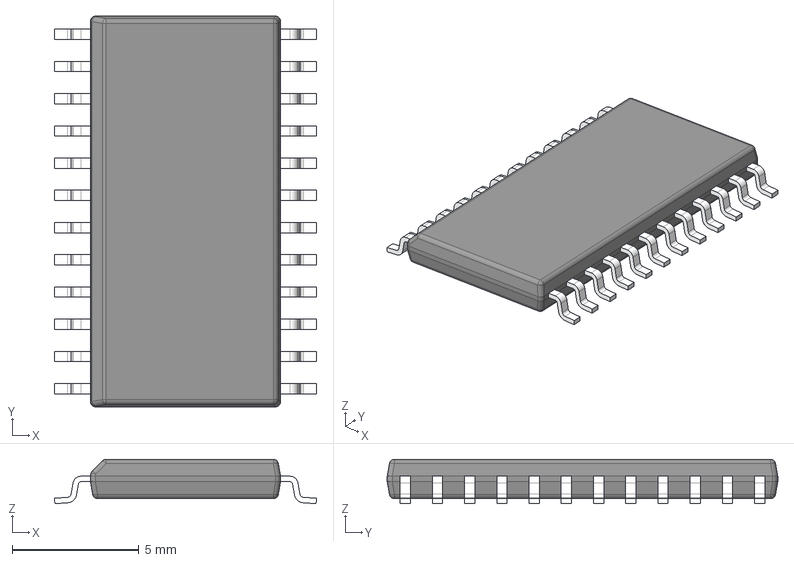
[picture p266: CAD file, 2025-10-30]
Ki-CAD8_Library_Files/Texas Instruments/CD74HC154M96/DW0024A.stp
10.3 x 15.4 x 1.75 mm
BODY-SO
LEAD-SO x 24
PIN1-ID
