rjridle/GRAMS/Ki-CAD8_Library_Files/Texas Instruments/DAC/DAC121S101CIMKX_NOPB/DDC0006A.stp

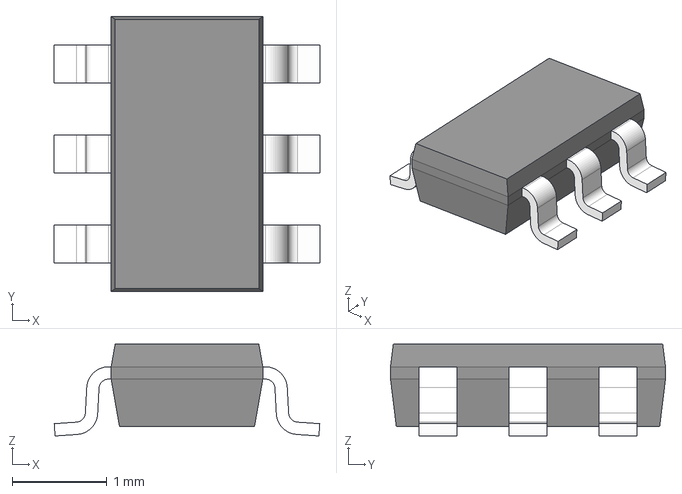
[picture p267: CAD file, 2025-10-30]
Ki-CAD8_Library_Files/Texas Instruments/DAC/DAC121S101CIMKX_NOPB/DDC0006A.stp
2.80 x 2.90 x 0.97 mm
BODY-SOT
LEAD-SOT x 6
