rjridle/GRAMS/Ki-CAD8_Library_Files/Texas Instruments/Decoder/CD74AC138M96/D0016A.stp

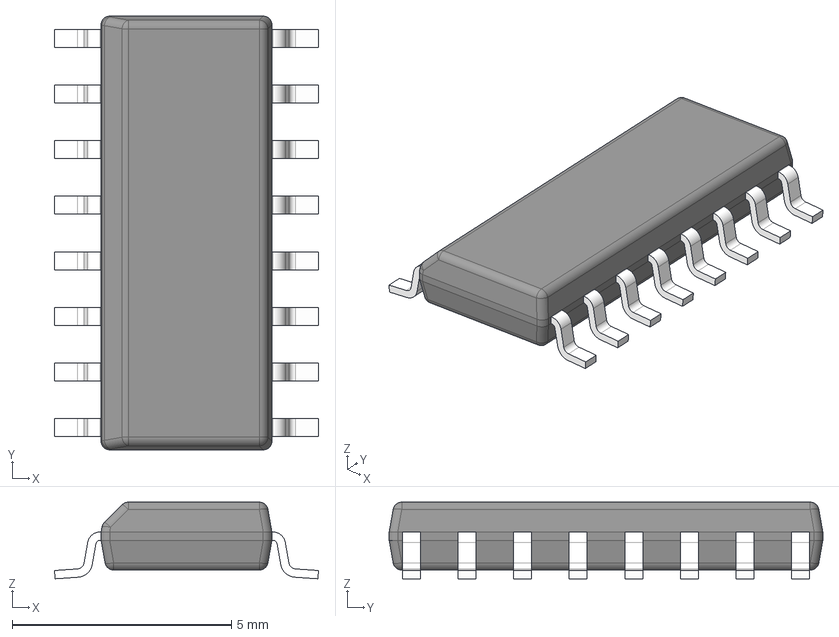
[picture p268: CAD file, 2025-10-30]
Ki-CAD8_Library_Files/Texas Instruments/Decoder/CD74AC138M96/D0016A.stp
6.03 x 9.90 x 1.75 mm
BODY-SO
LEAD-SO x 16
PIN1-ID
