rjridle/GRAMS/Ki-CAD8_Library_Files/Texas Instruments/INA28X/INA28X/INA28x_8SOIC.step

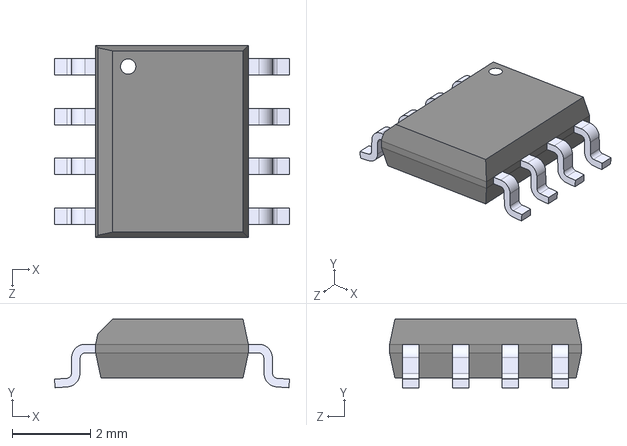
[picture p269: CAD file, 2025-10-30]
Ki-CAD8_Library_Files/Texas Instruments/INA28X/INA28X/INA28x_8SOIC.step
6.00 x 1.75 x 4.90 mm
