rjridle/GRAMS/Ki-CAD8_Library_Files/Texas Instruments/LM337IMPX_NOPB/DCY0004A.stp

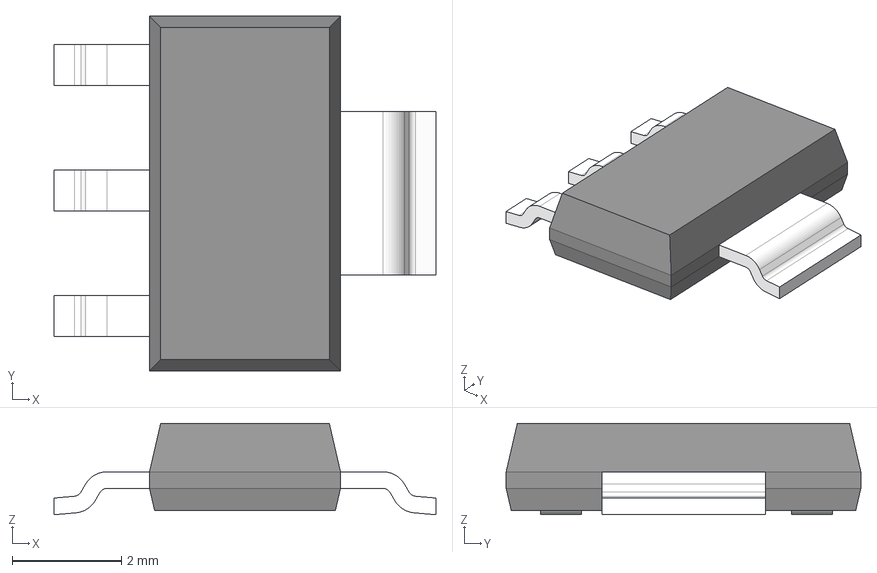
[picture p270: CAD file, 2025-10-30]
Ki-CAD8_Library_Files/Texas Instruments/LM337IMPX_NOPB/DCY0004A.stp
7.00 x 6.50 x 1.68 mm
BODY-SOT
LEAD-SOT x 3
LEAD-SOT-WIDE
PIN1-ID
