rjridle/GRAMS/Ki-CAD8_Library_Files/Texas Instruments/LMH6702-SP/NAC0010A.stp

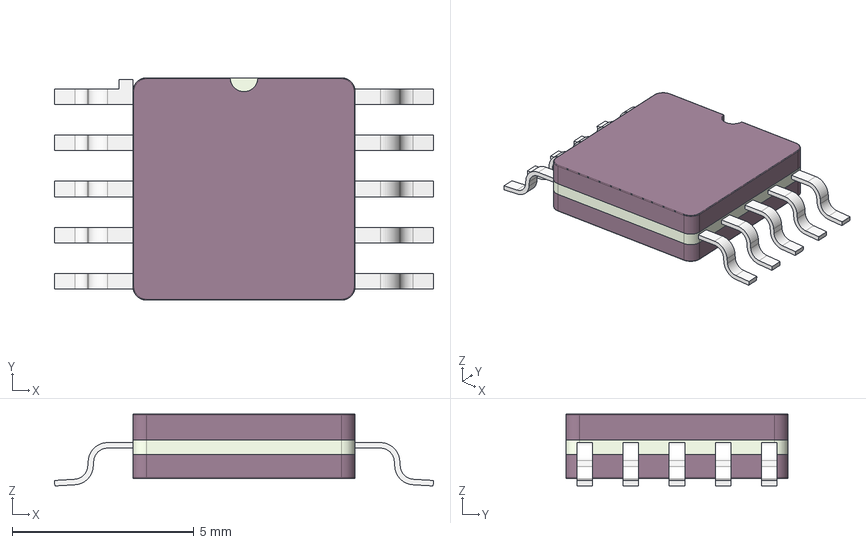
[picture p271: CAD file, 2025-10-30]
Ki-CAD8_Library_Files/Texas Instruments/LMH6702-SP/NAC0010A.stp
10.4 x 6.12 x 1.98 mm
BASE_NAC0010A
LID_NAC0010A
GLASS_NAC0010A
LEAD_NAC0010A x 9
LEAD1_NAC0010A
