rjridle/GRAMS/Ki-CAD8_Library_Files/Texas Instruments/LVDS/Receivers/DS90LV048ATM/DS90LV048ATM.step

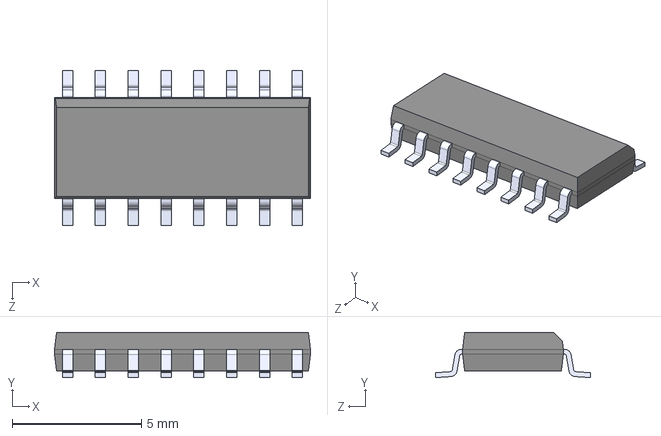
[picture p272: CAD file, 2025-10-30]
Ki-CAD8_Library_Files/Texas Instruments/LVDS/Receivers/DS90LV048ATM/DS90LV048ATM.step
9.90 x 1.75 x 6.00 mm
