rjridle/GRAMS/Ki-CAD8_Library_Files/Texas Instruments/LVDS/Receivers/SN65LVDS2DBVR/DBV0005A.stp

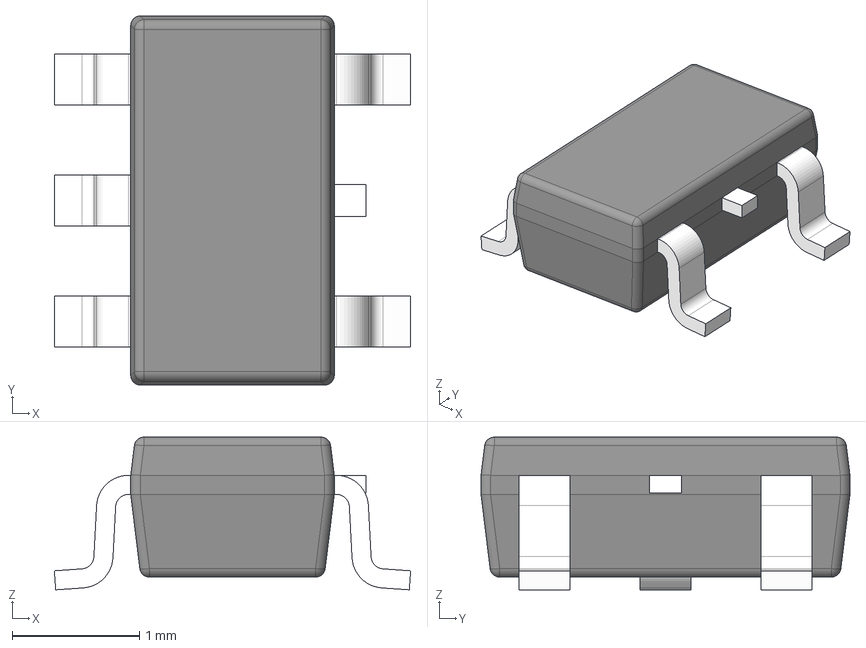
[picture p273: CAD file, 2025-10-30]
Ki-CAD8_Library_Files/Texas Instruments/LVDS/Receivers/SN65LVDS2DBVR/DBV0005A.stp
2.80 x 2.90 x 1.20 mm
BODY-SOT
LEAD-SOT x 5
LEAD-DUMMY
