rjridle/GRAMS/Ki-CAD8_Library_Files/Texas Instruments/LVDS/Transmitters/16/SN65LVDS387DGG/DGG0064A.stp

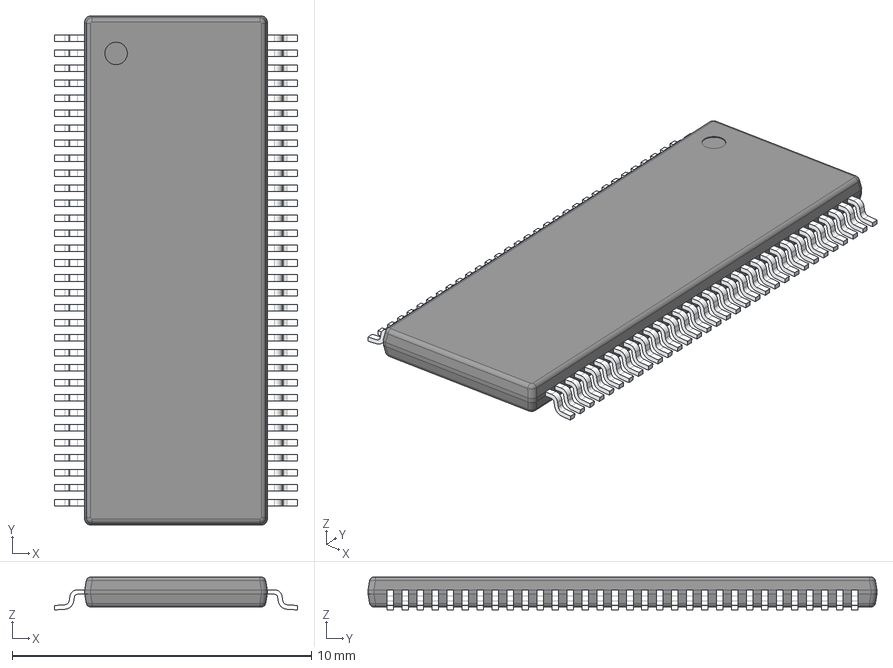
[picture p274: CAD file, 2025-10-30]
Ki-CAD8_Library_Files/Texas Instruments/LVDS/Transmitters/16/SN65LVDS387DGG/DGG0064A.stp
8.12 x 17.0 x 1.10 mm
BODY-SO
LEAD-SO x 64
PIN1-ID
