rjridle/GRAMS/Ki-CAD8_Library_Files/Texas Instruments/LVDS/Transmitters/Single/DS90LV011ATMFX_NOPB/DS90LV011ATMFX_NOPB.step

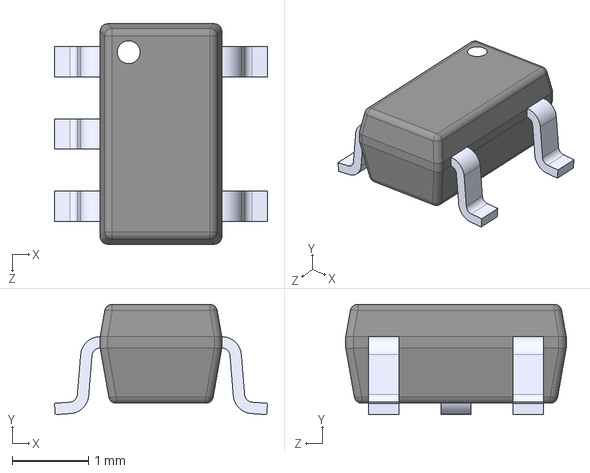
[picture p275: CAD file, 2025-10-30]
Ki-CAD8_Library_Files/Texas Instruments/LVDS/Transmitters/Single/DS90LV011ATMFX_NOPB/DS90LV011ATMFX_NOPB.step
2.80 x 1.45 x 2.90 mm
