rjridle/GRAMS/Ki-CAD8_Library_Files/Texas Instruments/Regulators/LP3964EMPX-ADJ_NOPB.STEP

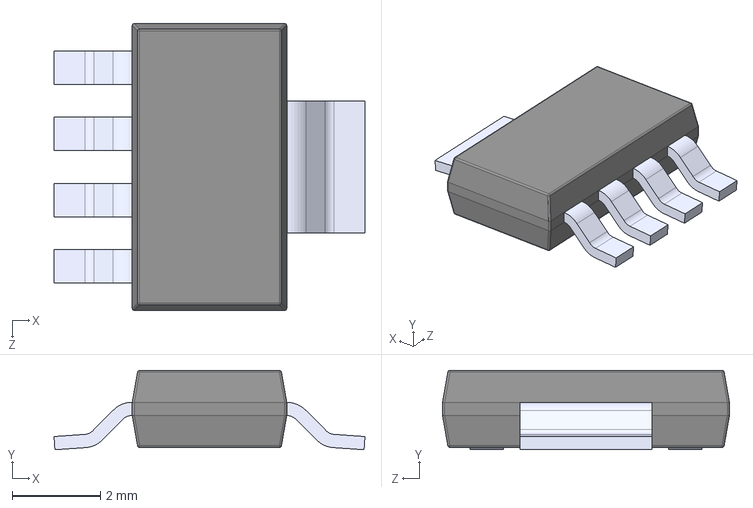
[picture p276: CAD file, 2025-10-30]
Ki-CAD8_Library_Files/Texas Instruments/Regulators/LP3964EMPX-ADJ_NOPB.STEP
7.04 x 1.80 x 6.50 mm
