rjridle/GRAMS/Ki-CAD8_Library_Files/Texas Instruments/SN65LVDS33PWR/PW0016A.stp

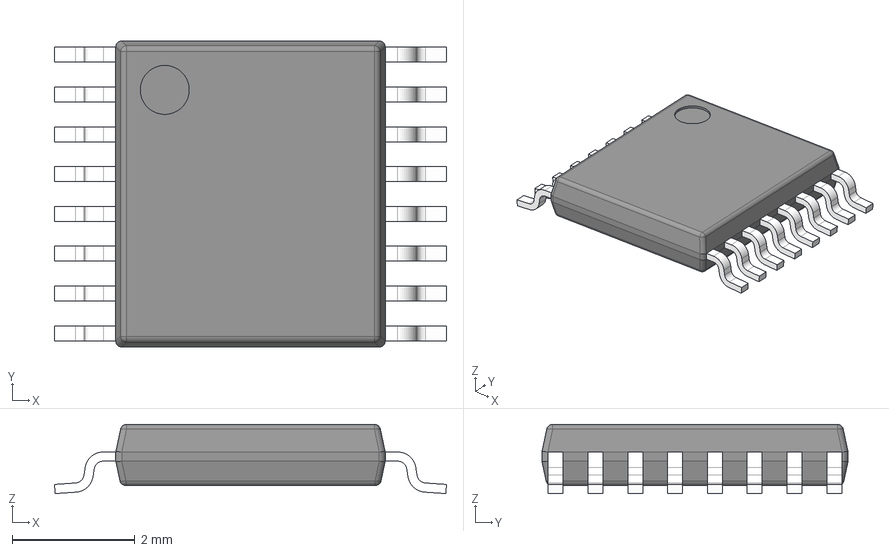
[picture p277: CAD file, 2025-10-30]
Ki-CAD8_Library_Files/Texas Instruments/SN65LVDS33PWR/PW0016A.stp
6.40 x 5.00 x 1.13 mm
BODY-TSSOP
LEAD-TSSOP x 16
PIN1
