rjridle/GRAMS/Ki-CAD8_Library_Files/Texas Instruments/SN74LVC1G04DCKR/DCK0005A.stp

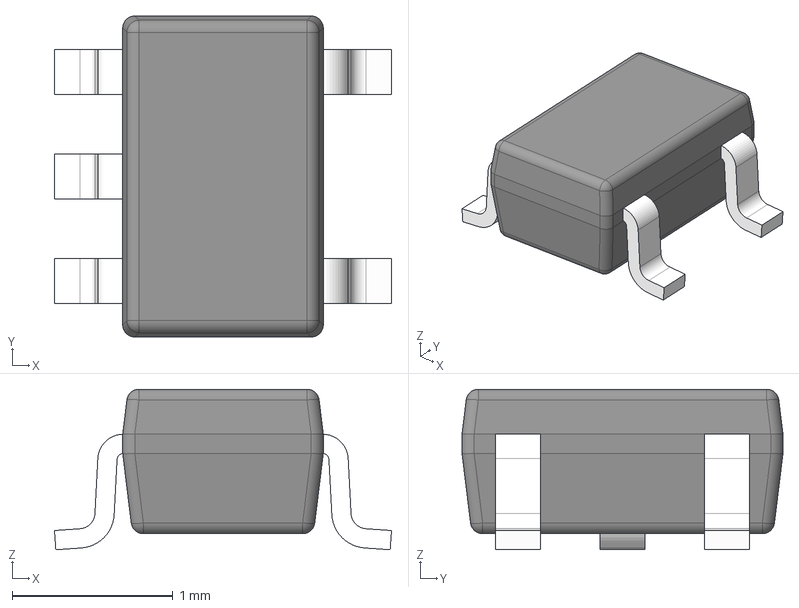
[picture p278: CAD file, 2025-10-30]
Ki-CAD8_Library_Files/Texas Instruments/SN74LVC1G04DCKR/DCK0005A.stp
2.10 x 2.00 x 1.00 mm
BODY-SOT
LEAD-SOT x 5
PIN1-ID
