rjridle/GRAMS/Ki-CAD8_Library_Files/Texas Instruments/TLV9002SIDGSR/DGS0010A.stp

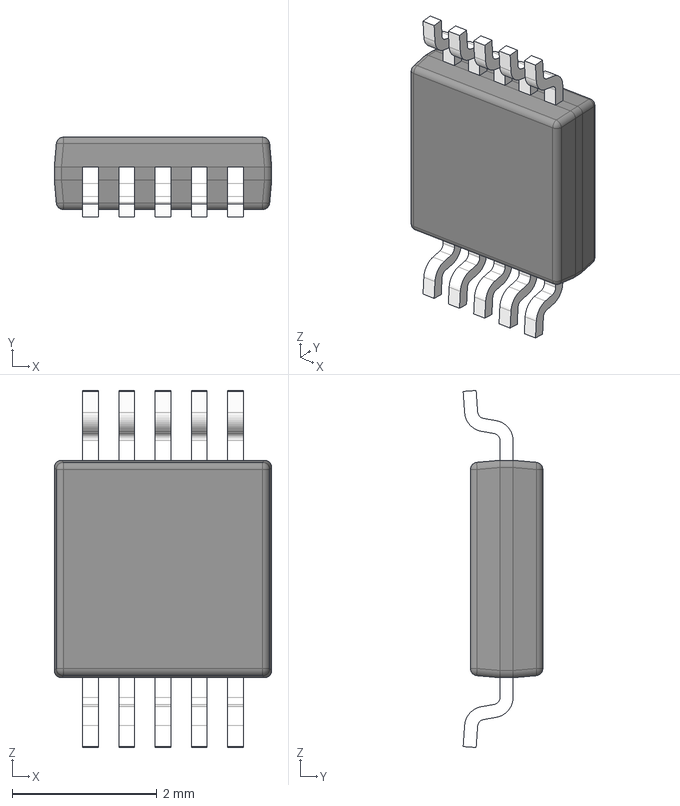
[picture p279: CAD file, 2025-10-30]
Ki-CAD8_Library_Files/Texas Instruments/TLV9002SIDGSR/DGS0010A.stp
3.00 x 1.10 x 4.93 mm
BODY-SO
LEAD-SO x 10
PIN1-ID
