rjridle/GRAMS/(list of files, cad)

Other CAD files:
Ki-CAD6_Library_Files/Parts/Analog Devices/LTC2050HV/AllegroPCBFootprint/S_5_ADI.step
Ki-CAD6_Library_Files/Parts/CUI/PDQ30-Q24-S5-D/PDQ30-Q24-S5-D.step
Ki-CAD8_Library_Files/Analog Devices/AD590JRZ-RL/R_8_ADI.step
Ki-CAD8_Library_Files/Analog Devices/AD8138ARZ_R7/R_8_ADI.step
Ki-CAD8_Library_Files/Analog Devices/LT3080EST-PBF/SOT-3_ST_LIT.step
Ki-CAD8_Library_Files/Analog Devices/LTC2050HVCS5_TRMPBF/S_5_ADI.step
Ki-CAD8_Library_Files/Analog Devices/LTC2051HVIMS8_PBF/3D/LTC2051HVCS8_TRPBF/SO-8_S_LIT.step
Ki-CAD8_Library_Files/Analog Devices/LTC2052HVCS_PBF/SO-14_S_LIT.step
Ki-CAD8_Library_Files/CUI/PDQ10_Q24_D5_D/PDQ10-Q24-D5-D.step
Ki-CAD8_Library_Files/CUI/PDQ30_Q24_S12_D/PDQ30-Q24-S12-D.step
Ki-CAD8_Library_Files/CUI/PDQ30_Q24_S5_D/PDQ30-Q24-S5-D.step
Ki-CAD8_Library_Files/CUI/VHB50W_Q24_S3R3/VHB50W-Q24-S3R3.step
Ki-CAD8_Library_Files/CUI/VHB75W_Q24_S5/VHB75W-Q24-S5.step
Ki-CAD8_Library_Files/GRAMS.3D/VHB50W-Q24-S3R3.step
Ki-CAD8_Library_Files/ISOCOM/ISP281D/ISP281D_ISO.step
Ki-CAD8_Library_Files/Keystone/5006/5006.step
Ki-CAD8_Library_Files/Little_Fuse/SMDJ6_0A/SMDJSeries_LTF.step
Ki-CAD8_Library_Files/ONSEMI/MMSZ4683T1G/SOD-123_ONS.step
Ki-CAD6_Library_Files/Parts/Analog Devices/LTC2050HV/AllegroPCBFootprint/s_5_adi.psm
Ki-CAD6_Library_Files/Parts/Hirose/DF14A-2P-1.25H_56/DF14A-2P-1.25H_56_/Allegro/df14a2p125h56.psm
Ki-CAD6_Library_Files/Parts/Hirose/DF14A-2P-1.25H_56/DF14A-2P-1.25H_56_/DEHDL/df14a_2p_1.25h_56_/chips/chips.prt
Ki-CAD6_Library_Files/Parts/MEDER_Elec/Reed_Relays/SIL03-1A72-71D/3D_Model/SIL03-1A72-71D/Allegro/sil031a7271d.psm
Ki-CAD6_Library_Files/Parts/MEDER_Elec/Reed_Relays/SIL03-1A72-71D/3D_Model/SIL03-1A72-71D/DEHDL/sil03_1a72_71d/chips/chips.prt
Ki-CAD6_Library_Files/Parts/Panasonic/AYF530365T/ayf530365t-closed.step
Ki-CAD6_Library_Files/Parts/Panasonic/AYF530465T/3D/AYF530465T.stp
Ki-CAD6_Library_Files/Parts/Panasonic/AYF530465T/3D/ayf530465t-closed.step
Ki-CAD6_Library_Files/Parts/Panasonic/AYF530465T/Allegro/ayf530465t.psm
Ki-CAD6_Library_Files/Parts/Panasonic/AYF530465T/DEHDL/ayf530465t/chips/chips.prt
Ki-CAD6_Library_Files/Parts/Panasonic/AYF531035/ayf531035-closed.step
Ki-CAD6_Library_Files/Parts/Pheonix_Contacts/2-Pos/3D/1935776.stp
Ki-CAD6_Library_Files/Parts/Pheonix_Contacts/2-Pos_Plug/1803277.step
Ki-CAD6_Library_Files/Parts/Samtec/T1M-06-F-SH-L/3D Model/T1M-06-F-SH-L-K.stp
Ki-CAD8_Library_Files/Amphenol/10090926_P264VLF/10090926-P264VLF.STEP
Ki-CAD8_Library_Files/Bel Fuse INC/0685T6000_01/0685T6000-01.step
Ki-CAD8_Library_Files/Cinch_Connectivity/M83513_13_E01NP_FEMALE/M83513_13-E01NP_FEMALE.stp
Ki-CAD8_Library_Files/Foil Resistors/Y14870R01000B9R/Y14870R01000B9R.step
Ki-CAD8_Library_Files/GRAMS.3D/0154002.DRT.step
Ki-CAD8_Library_Files/GRAMS.3D/0154010.DRL.step
Ki-CAD8_Library_Files/GRAMS.3D/0685T6000-01.step
Ki-CAD8_Library_Files/GRAMS.3D/5006.step
Ki-CAD8_Library_Files/GRAMS.3D/6130XX11121_61300311121.step
Ki-CAD8_Library_Files/GRAMS.3D/6180XX231121_618009231121.step
Ki-CAD8_Library_Files/GRAMS.3D/6180XX231221_618009231221.step
Ki-CAD8_Library_Files/GRAMS.3D/6180XX231221_618015231221.step
Ki-CAD8_Library_Files/GRAMS.3D/6180XX231221_618025231221.step
Ki-CAD8_Library_Files/GRAMS.3D/691321300004.step
Ki-CAD8_Library_Files/GRAMS.3D/691322110004.step
Ki-CAD8_Library_Files/GRAMS.3D/691322310002.step
Ki-CAD8_Library_Files/GRAMS.3D/691322310003.step
Ki-CAD8_Library_Files/GRAMS.3D/691322310008.step
Ki-CAD8_Library_Files/GRAMS.3D/CAP_134D_T6_CLR7981_T3_S_VIS.step
Ki-CAD8_Library_Files/GRAMS.3D/ISP281D_ISO.step
Ki-CAD8_Library_Files/GRAMS.3D/LED_0AS75000_WRE.step
Ki-CAD8_Library_Files/GRAMS.3D/M83513_10-E01CP.step
Ki-CAD8_Library_Files/GRAMS.3D/PDQ10-Q24-D5-D.step
Ki-CAD8_Library_Files/GRAMS.3D/PDQ30-Q24-S12-D.step
Ki-CAD8_Library_Files/GRAMS.3D/PDQ30-Q24-S5-D.step
Ki-CAD8_Library_Files/GRAMS.3D/RCWE0805.step
Ki-CAD8_Library_Files/GRAMS.3D/R_8_ADI.step
Ki-CAD8_Library_Files/GRAMS.3D/SMDJSeries_LTF.step
Ki-CAD8_Library_Files/GRAMS.3D/SO-14_S_LIT.step
Ki-CAD8_Library_Files/GRAMS.3D/SO-8_S_LIT.step
Ki-CAD8_Library_Files/GRAMS.3D/SOT-3_ST_LIT.step
Ki-CAD8_Library_Files/GRAMS.3D/S_5_ADI.step
Ki-CAD8_Library_Files/GRAMS.3D/VHB75W-Q24-S5.step
Ki-CAD8_Library_Files/GRAMS.3D/WL-SMCW_0603.step
Ki-CAD8_Library_Files/GRAMS.3D/Y14870R01000B9R.step
Ki-CAD8_Library_Files/Little_Fuse/0154010_DRL/0154010.DRL.step
Ki-CAD8_Library_Files/Little_Fuse/Fuse_w_Holder/2A/0154002_DR/0154002_DR/0154002.DRT.step
Ki-CAD8_Library_Files/Little_Fuse/Fuse_w_Holder/2A/Slow_Blow/0154002_DRT/3D Model/0154002.DRT.step
Ki-CAD8_Library_Files/Molex/5015680907/5015680907.stp
Ki-CAD8_Library_Files/Molex/Male Header/4-Pin/877580416/877580416.stp
Ki-CAD8_Library_Files/Molex/SMA/ThroughHole_Straight/733910070/733910070.stp
Ki-CAD8_Library_Files/Traco Power/ul_THN-30-2411WI/thn30wi_3d_drawing.stp
Ki-CAD8_Library_Files/VPG_Foil_Resistors/Y14870R01000B9R/Y14870R01000B9R.step
Ki-CAD8_Library_Files/Vishay_Dale/RCWE0805R510FKEA/RCWE0805.step
Ki-CAD8_Library_Files/Vishay_Sprague/134D107X9125T6/CAP_134D_T6_CLR7981_T3_S_VIS.step
Ki-CAD8_Library_Files/Wurth Elektronik/D-Sub Connectors/15-POS/SD/MALE/6180XX231221_618015231221.step
Ki-CAD8_Library_Files/Wurth Elektronik/D-Sub Connectors/15_FDSUB_VERT/15_FDSUB_VERT_61801525123.stp
Ki-CAD8_Library_Files/Wurth Elektronik/D-Sub Connectors/15_MDSUB_VERT/15_MDSUB_VERT_61801525023.step
Ki-CAD8_Library_Files/Wurth Elektronik/D-Sub Connectors/25-POS/MALE/SD/6180XX231221_618025231221.step
Ki-CAD8_Library_Files/Wurth Elektronik/D-Sub Connectors/25_FDSUB_VERT/25_FDSUB_VERT_61802525123.step
Ki-CAD8_Library_Files/Wurth Elektronik/D-Sub Connectors/25_MDSUB_VERT/25_MDSUB_VERT_61802525023.stp
Ki-CAD8_Library_Files/Wurth Elektronik/D-Sub Connectors/37-POS/Female/6180XX231321_618037231321/Download_STP_618037231321_rev1.stp
Ki-CAD8_Library_Files/Wurth Elektronik/D-Sub Connectors/44-POS/FEMALE/6180XX325223_618044325223/Download_STP_618044325223_rev1.stp
Ki-CAD8_Library_Files/Wurth Elektronik/D-Sub Connectors/62-POS/FEMALE/618062325223/Download_STP_618062325223_rev1.stp
Ki-CAD8_Library_Files/Wurth Elektronik/D-Sub Connectors/9-POS/6180XX231121_618009231121/6180XX231121_618009231121.step
Ki-CAD8_Library_Files/Wurth Elektronik/D-Sub Connectors/9-POS/MALE/6180XX231221_618009231221.step
Ki-CAD8_Library_Files/Wurth Elektronik/D-Sub Connectors/9_FDSUB_VERT/9_FDSUB_VERT_61800929321.step
Ki-CAD8_Library_Files/Wurth Elektronik/D-Sub Connectors/9_MDSUB_VERT/9_MDSUB_VERT_61800929221.step
Ki-CAD8_Library_Files/Wurth Elektronik/Ferrite-Bead/Download_STP_WE-PF-1280_rev1.stp
Ki-CAD8_Library_Files/Wurth Elektronik/Headers/3-Pos/61300311121/6130XX11121_61300311121.step
Ki-CAD8_Library_Files/Wurth Elektronik/LED/0603/Amber/LED_0AS75000_WRE.step
Ki-CAD8_Library_Files/Wurth Elektronik/LED/0603/Green/WL-SMCW_0603/STP_150060xS75000_rev1.stp
Ki-CAD8_Library_Files/Wurth Elektronik/LED/0603/Green/WL-SMCW_0603/WL-SMCW_0603.step
