rjridle/GRAMS/3_Documentation/0_Assembly_Work/COLD_TPC/P5V_Telem_Board/Power_Cable_for_Prototype.docx

Assembly / Re-Assembly Work Log

Project: GRAMS Board: COLD TPC +5V Telem Board Date: 27-FEB-2025

# Information:

1. I need a power cable for the telemetry power board. The prototype houses a 9-position female d-sub connector.

Description of needed assembly work:

- Please make the following cable:

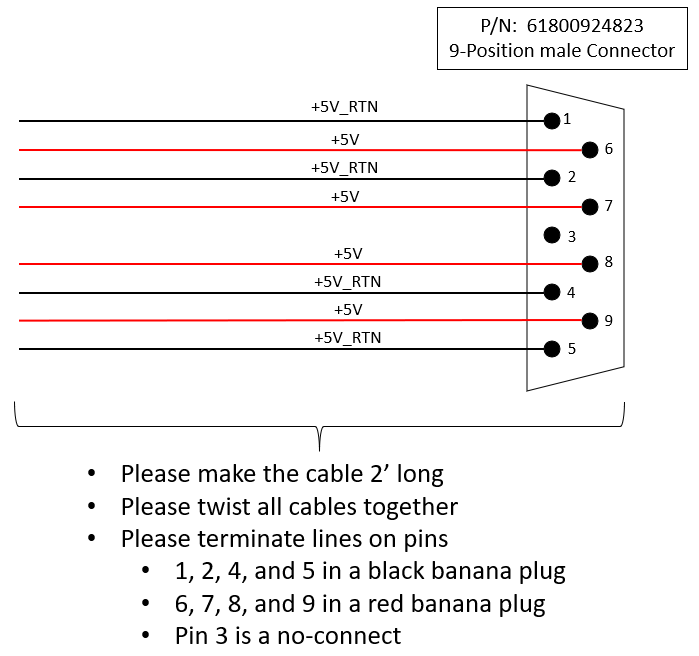
[picture p281: figure]

Date: _____ / ______ / _______
