rjridle/GRAMS/3_Documentation/0_Assembly_Work/COLD_TPC/P5V_Telem_Board/Tables and Figures.pptx

P/N: 61800924823
9-Position male Connector

+5V_RTN

1

+5V_RTN

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
+5V_RTN

+5V

4

9

+5V_RTN

5

- Please make the cable 2’ long
- Please twist all cables together
- Please terminate lines on pins
  - 1, 2, 4, and 5 in a black banana plug
  - 6, 7, 8, and 9 in a red banana plug
  - Pin 3 is a no-connect
