rjridle/GRAMS/3_Documentation/0_Assembly_Work/COLD_TPC/SiPM_Bias_Board/Presentation1.pptx

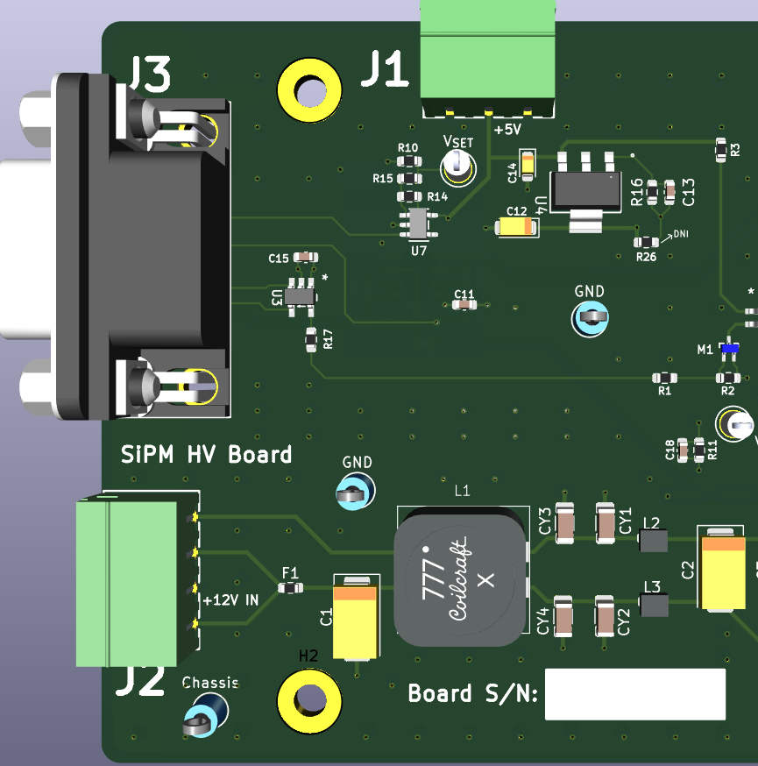
[picture p282: figure]
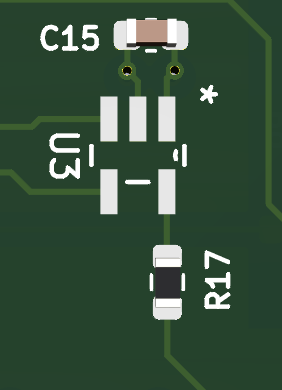
[picture p283: figure]

U3

## Slide 2

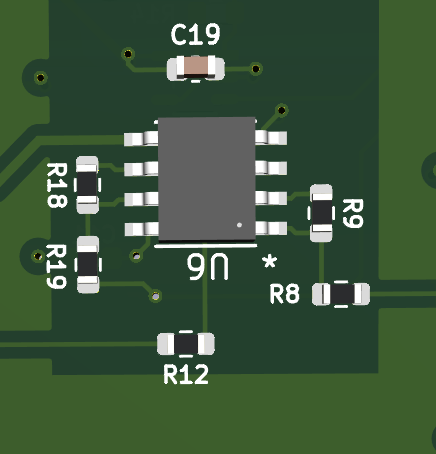
[picture p284: figure]

R12

## Slide 3

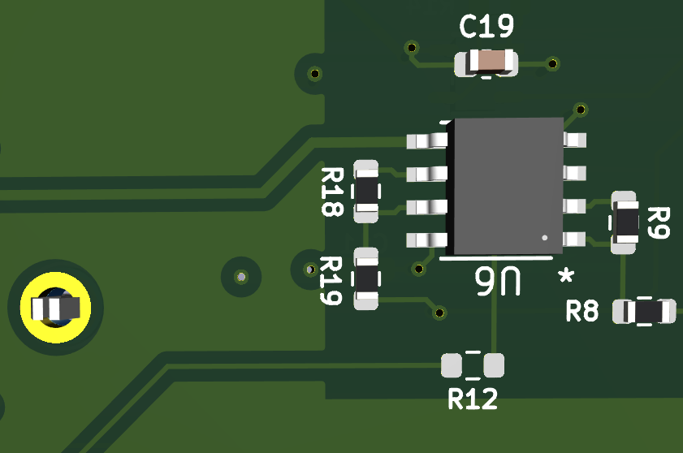
[picture p285: figure]

## Slide 4

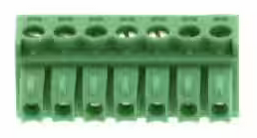
[picture p286: figure]

277-1166-ND

732-2753-ND

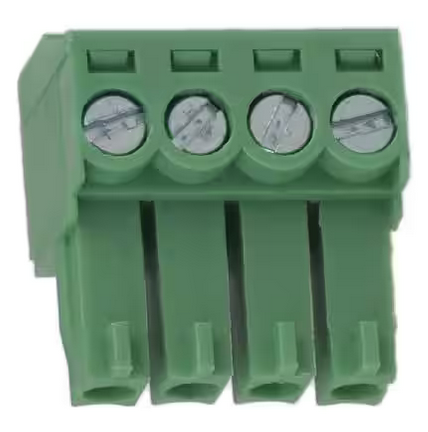
[picture p287: figure]

732-2077-ND

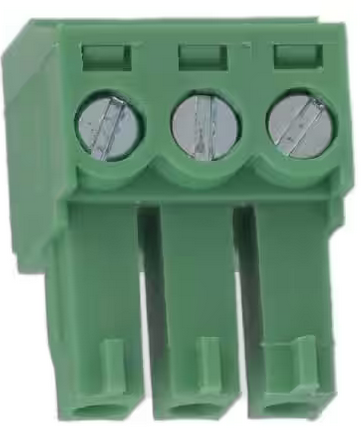
[picture p288: figure]

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
732-2753-ND

277-1166-ND

TP

1
2
3

732-2077-ND

Please make this harness 1.5’ in length
