rjridle/GRAMS/2_Schematics_and_Layout/6_WIRING_DIAGRAM/Images/7TBLK_Phoenix_Contact_1803471.png

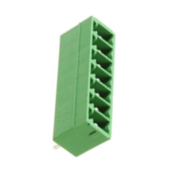
2_Schematics_and_Layout/6_WIRING_DIAGRAM/Images/7TBLK_Phoenix_Contact_1803471.png
