rjridle/GRAMS/3_Documentation/0_Assembly_Work/COLD_TPC/SiPM_Bias_Board/SiPM_Bias_Board_Testing_Config.docx

Assembly / Re-Assembly Work Log

Project: GRAMS Board: COLD TPC SiPM Bias Board Date: 25-March-2025

# Information:

1. I do not have an LVDS driver to be able to turn the device on the board on and off. These instructions will remove U3 (LVDS Receiver) and tie the output directly to an external pin.

Description of needed assembly work:

- Please remove U3 (See diagram)

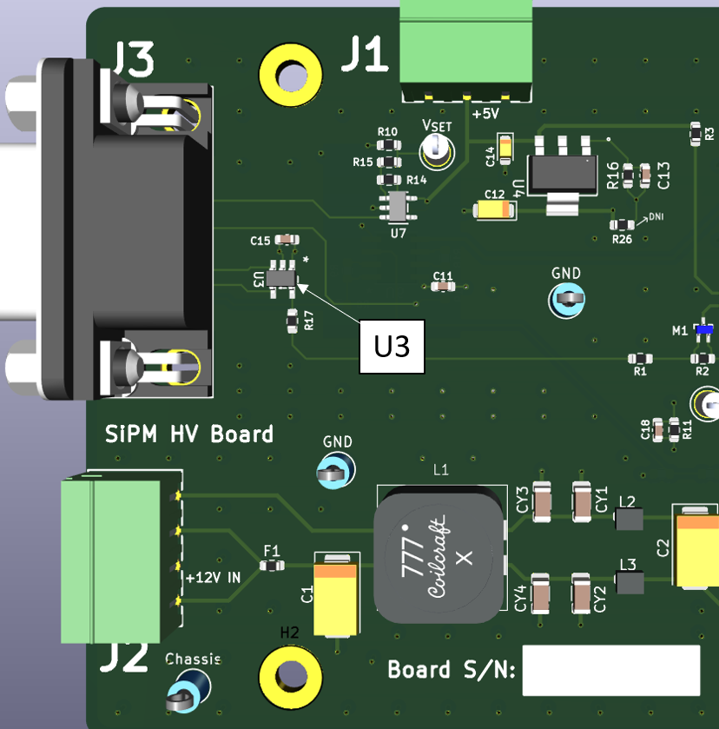
[picture p290: figure]

- Short Pins 4 and 5 together:

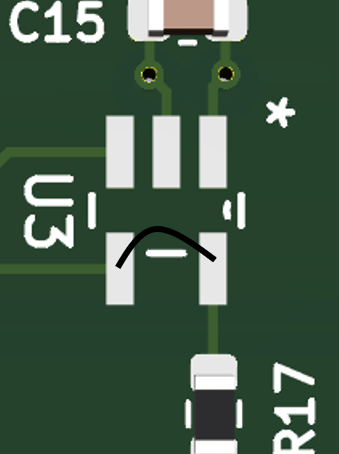
[picture p291: figure]

- Turn the board over, please remove R12:

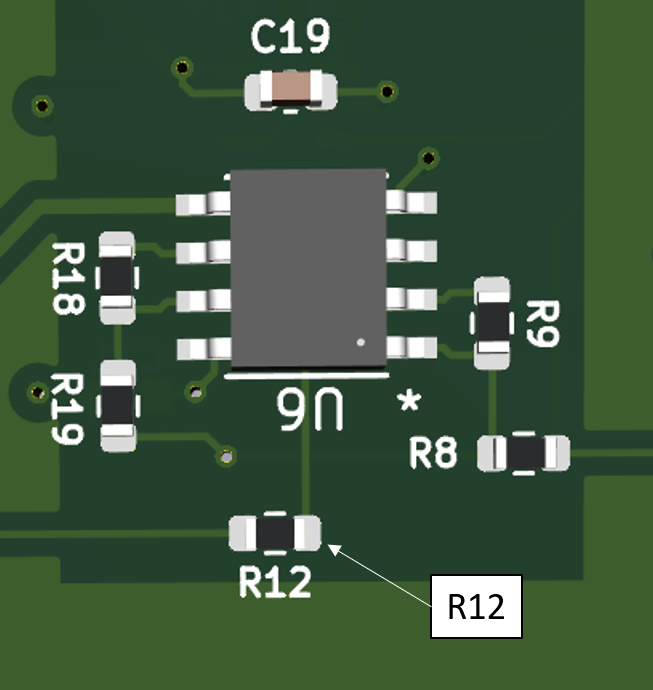
[picture p292: figure]

- Connect the pad shown from R12 to the nearest ground:

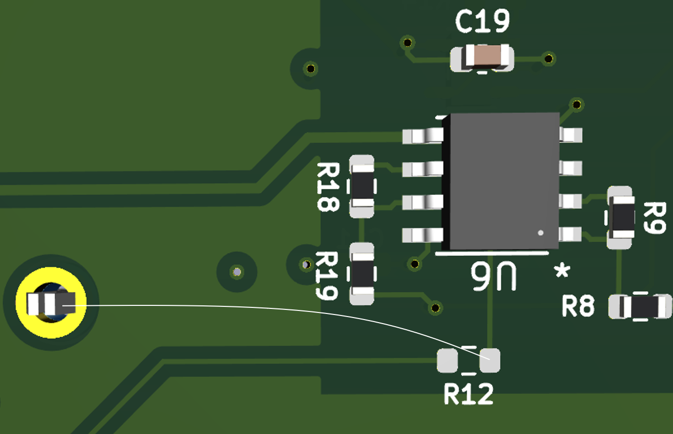
[picture p293: figure]

Date: _____ / ______ / _______
