rjridle/GRAMS/3_Documentation/0_Assembly_Work/COLD_TPC/SiPM_Bias_Board/SiPM_Bias_Board_Testing_Harnesses.docx

Assembly / Re-Assembly Work Log

Project: GRAMS Board: COLD TPC Harnessing Date: 25-March-2025

# Information:

1. Need a couple harnesses to go from the SiPM Telemetry Power Board to the SiPM Bias Boards. These are the Phoenix connectors.

Description of needed assembly work:

- Please make 2 of the harnesses described below:

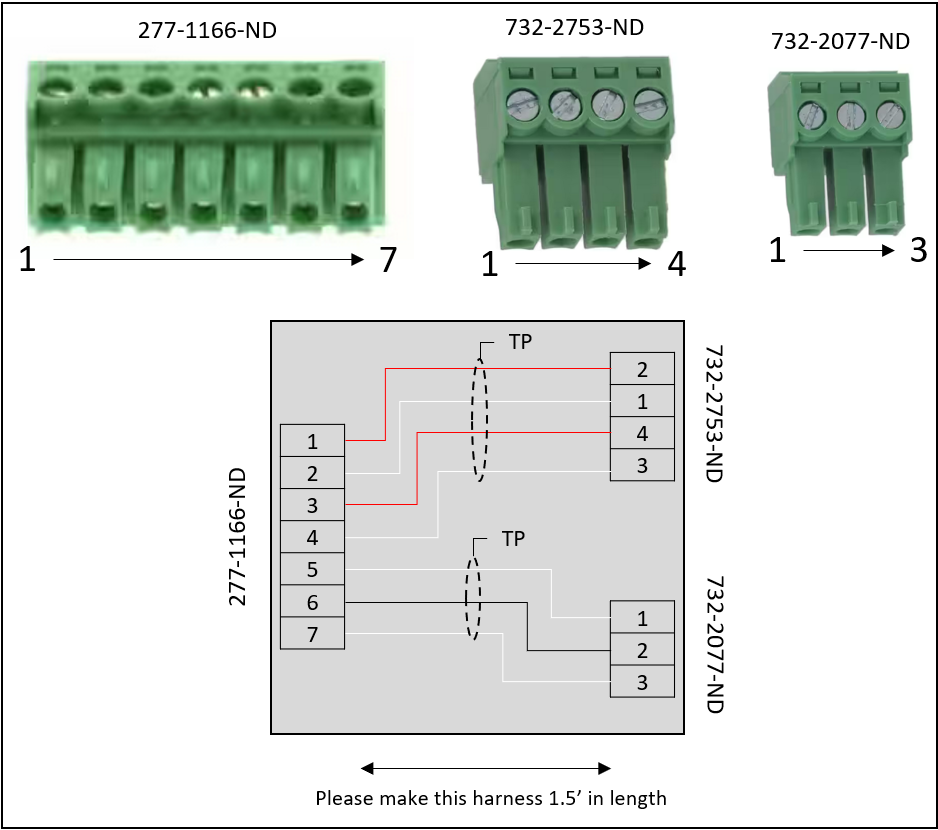
[picture p294: figure]

Date: _____ / ______ / _______
