rjridle/GRAMS/2_Schematics_and_Layout/6_WIRING_DIAGRAM/6_WIRING_DIAGRAM.pdf

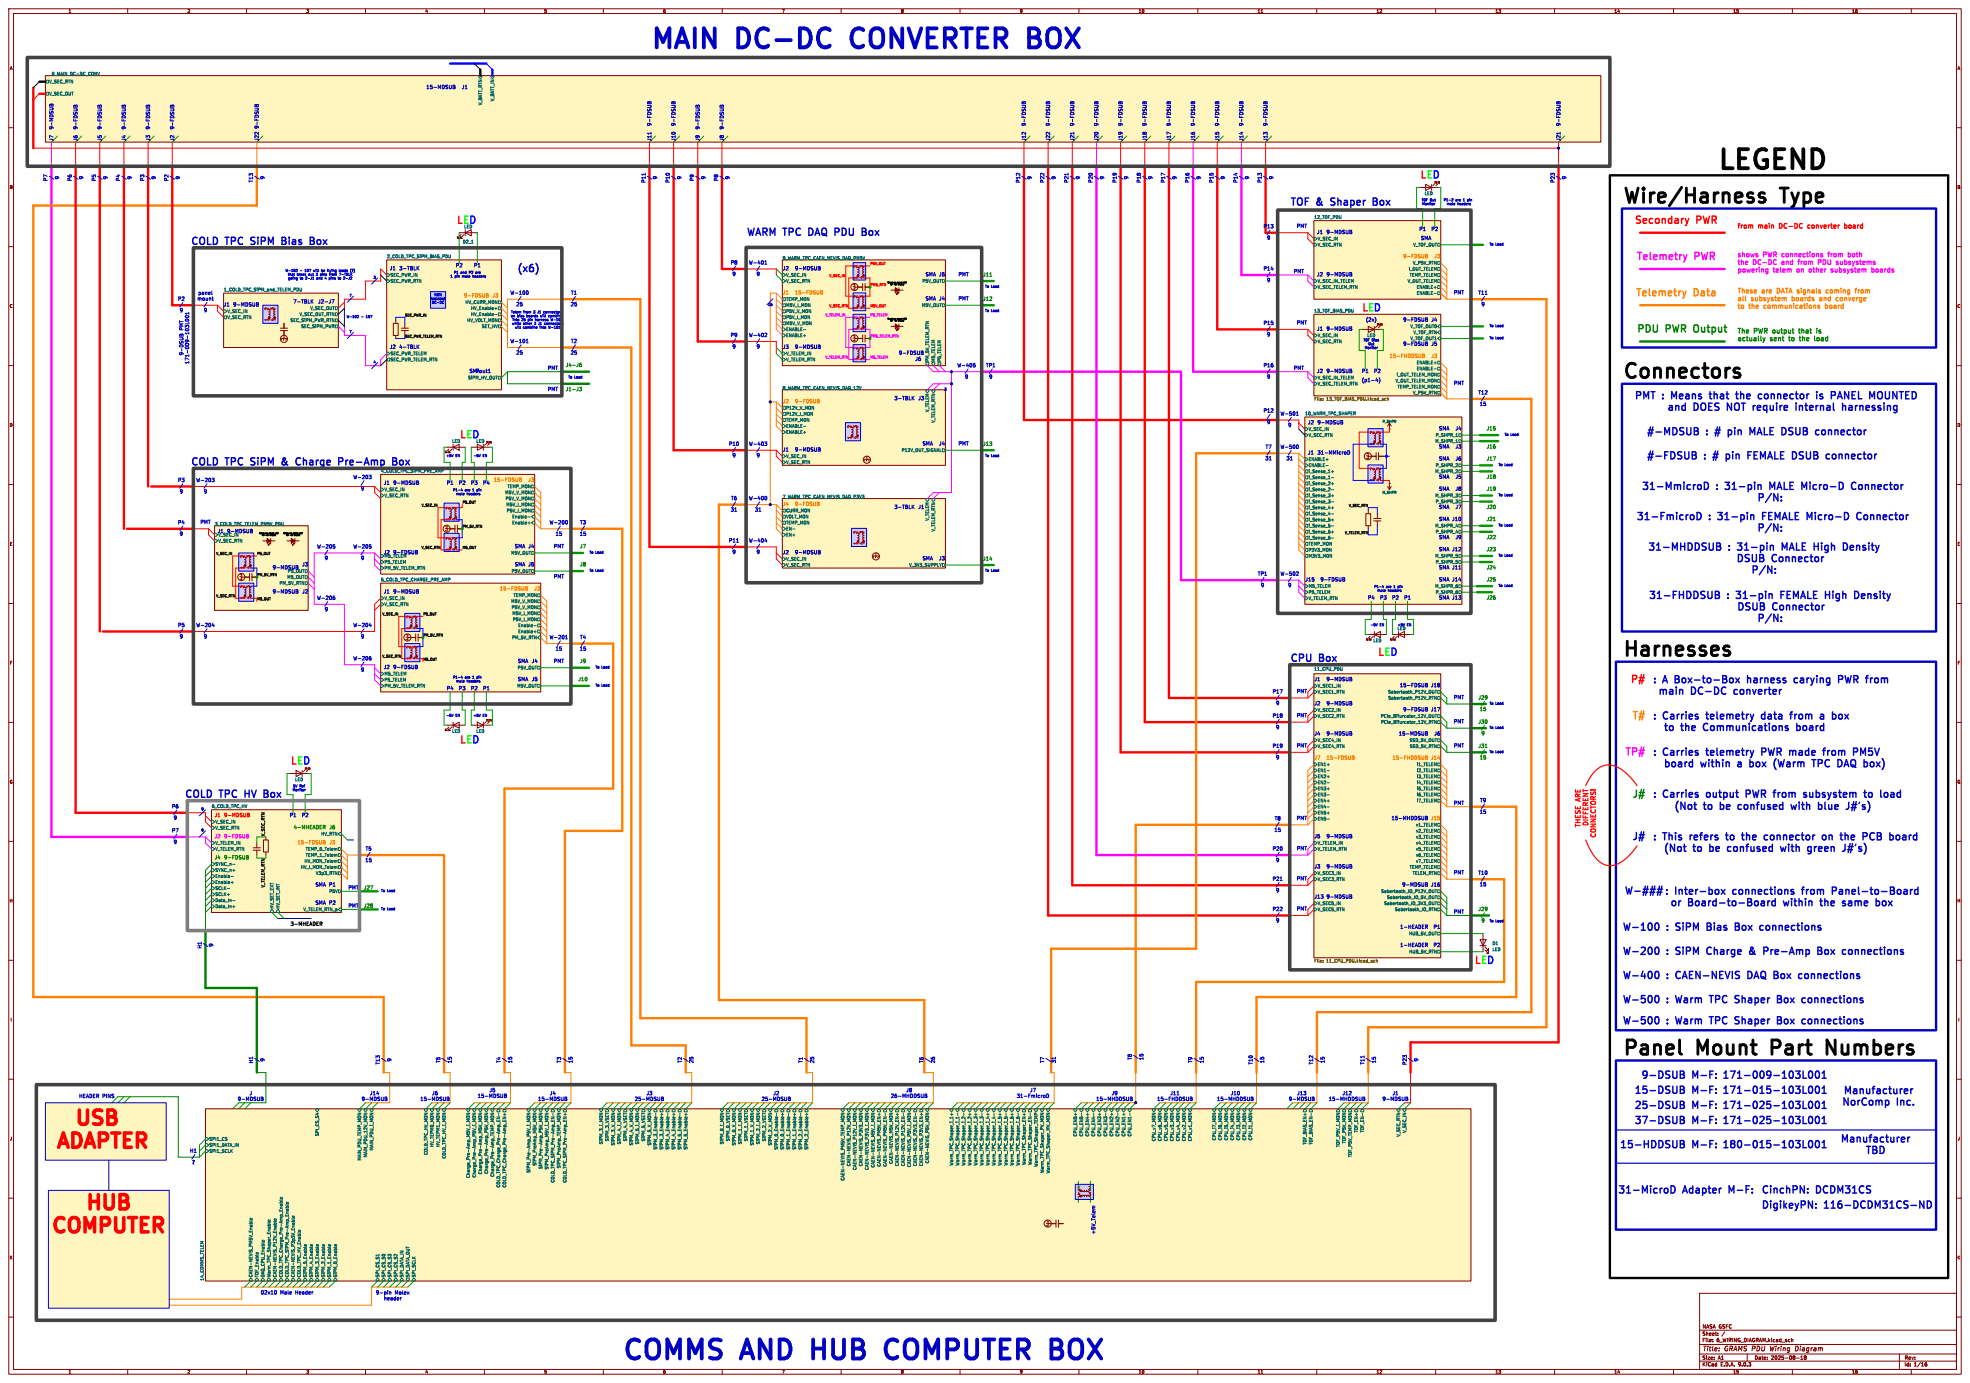
[picture p295: page 1]

SMA MAIN DC-DC CONVERTER BOX

board within a box (Warm TPC DAQ box) J18 9-FDSUB

/9 J13 9-FDSUB J14 9-FDSUB J21 9-FDSUB J16 9-FDSUB J15 9-FDSUB J17 9-FDSUB P15

TOF Out Monitor SMA

(Not to be confused with blue J#'s) P19

/9 Panel Mount Part Numbers

/9 W-200 : SiPM Charge & Pre-Amp Box connections

J14 WARM TPC DAQ PDU Box

powering telem on other subsystem boards

that break out 3 pins from 7-TBLK

These are DATA signals coming from
all subsystem boards and converge

Telem from 3 J1 connectors on bias boards will combine

into 25 pin harness W-100 while other 3 J1 connectors will combine into W-101

The PWR output that is

PMT : Means that the connector is PANEL MOUNTED

and DOES NOT require internal harnessing

main DC-DC converter

: Carries telemetry data from a box

: Carries telemetry PWR made from PM5V

: Carries output PWR from subsystem to load

: This refers to the connector on the PCB board
(Not to be confused with green J#'s)

File: 6_WIRING_DIAGRAM.kicad_sch Sheet: / NASA GSFC

Id: 1/16 Title: GRAMS PDU Wiring Diagram
