rjridle/GRAMS/2_Schematics_and_Layout/1_COLD_TPC/2_COLD_TPC_SiPM_Bias_PDU/2_COLD_TPC_SiPM_Bias_PDU.pdf

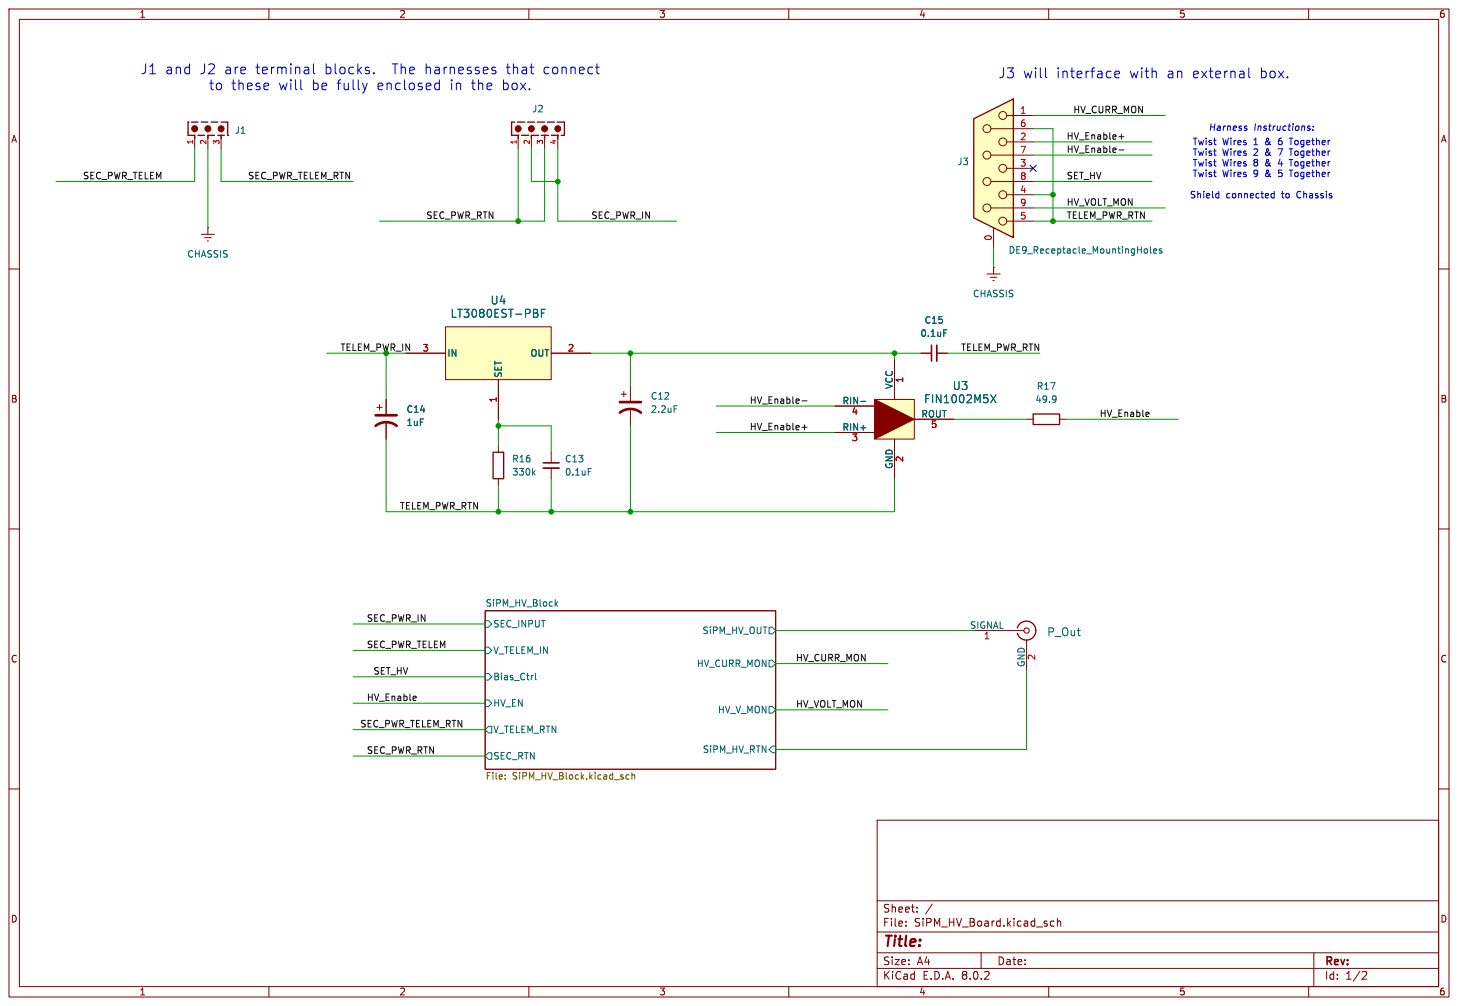
[picture p296: page 1]

Id: 1/2 Title: File: SiPM_HV_Board.kicad_sch Sheet: / SEC_RTN

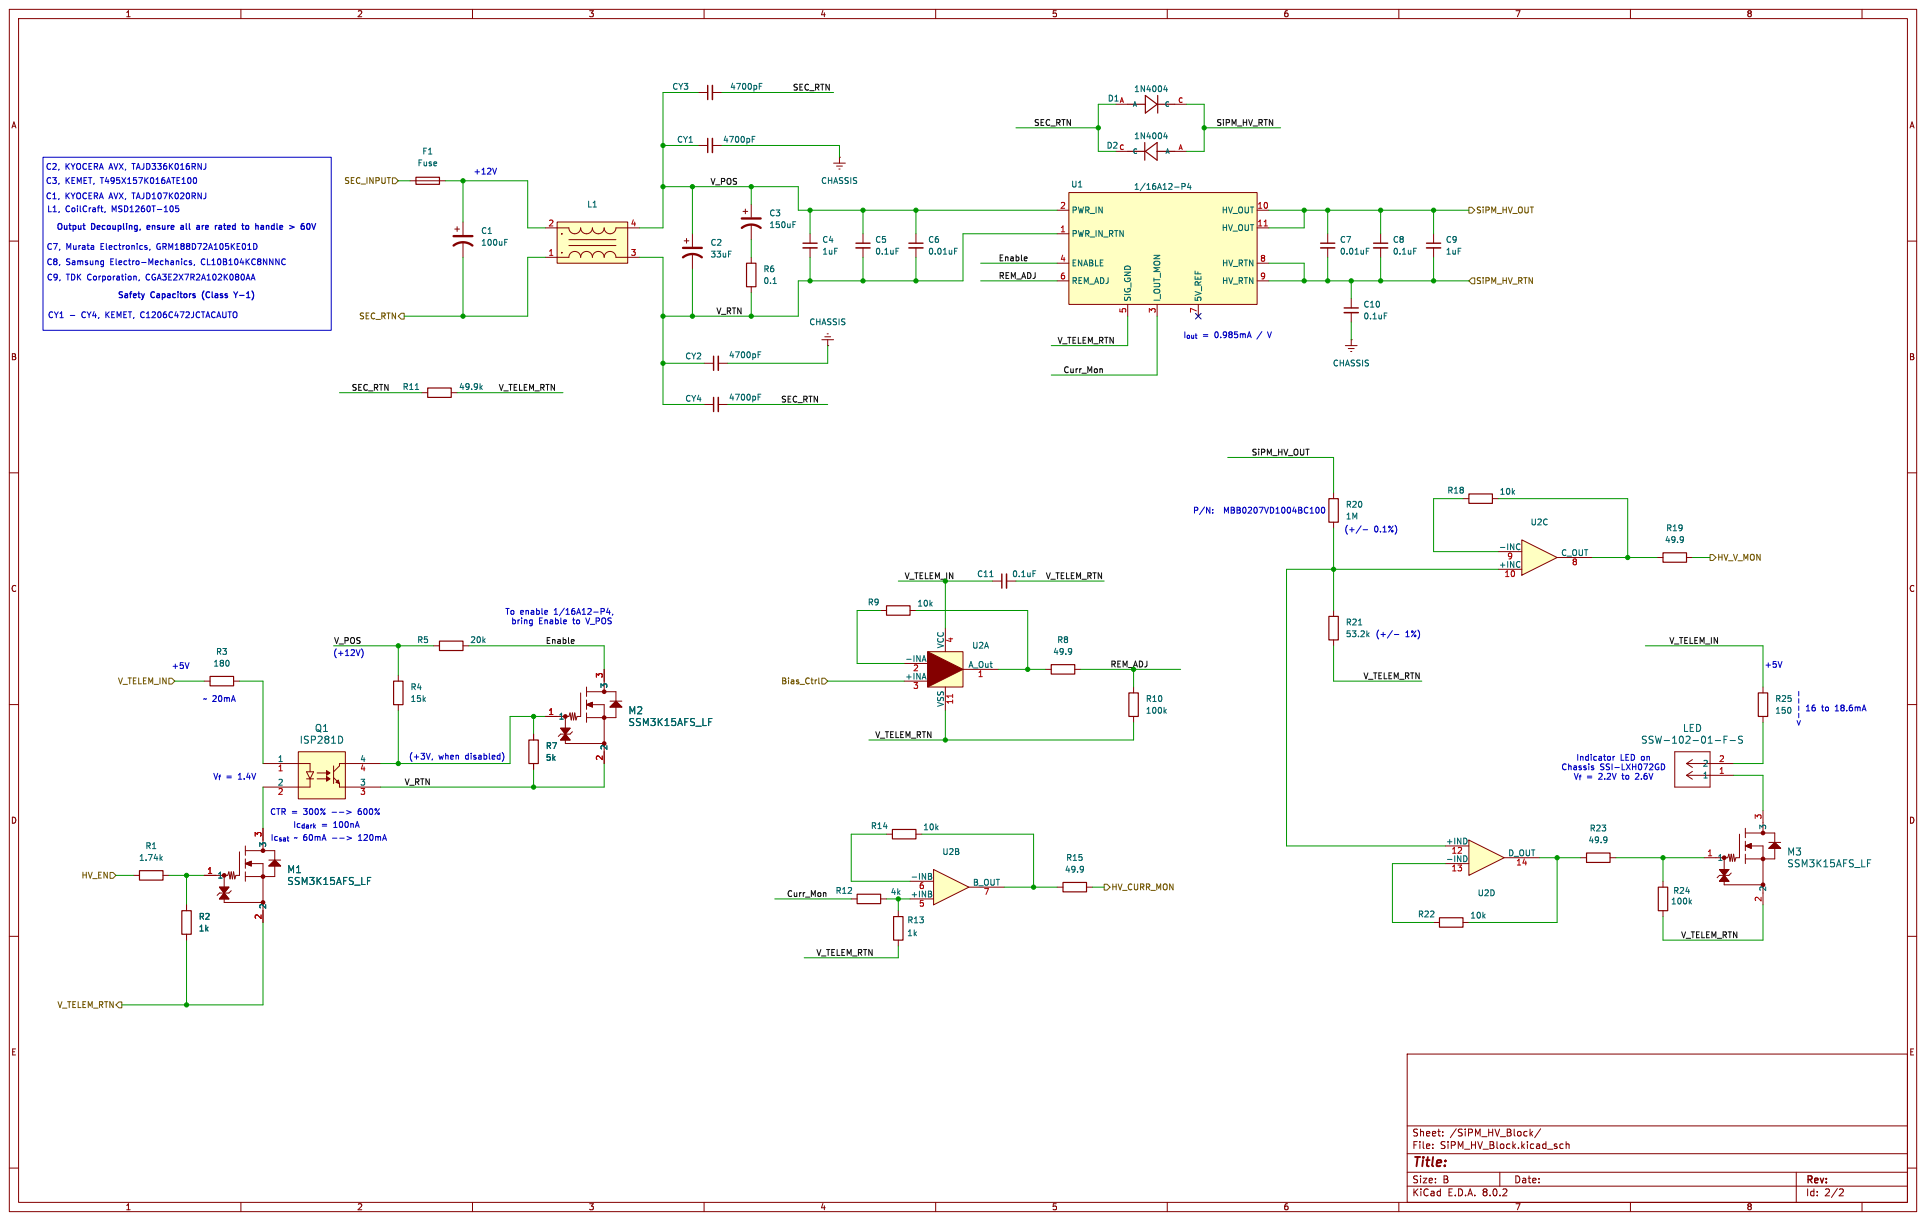
[picture p297: page 2]

To enable 1/16A12-P4, bring Enable to V_POS

Id: 2/2 Title: File: SiPM_HV_Block.kicad_sch Sheet: /SiPM_HV_Block/ 1
