rjridle/GRAMS/2_Schematics_and_Layout/1_COLD_TPC/4_COLD_TPC_SiPM_Pre_Amp/4_COLD_TPC_SiPM_Pre_Amp.pdf

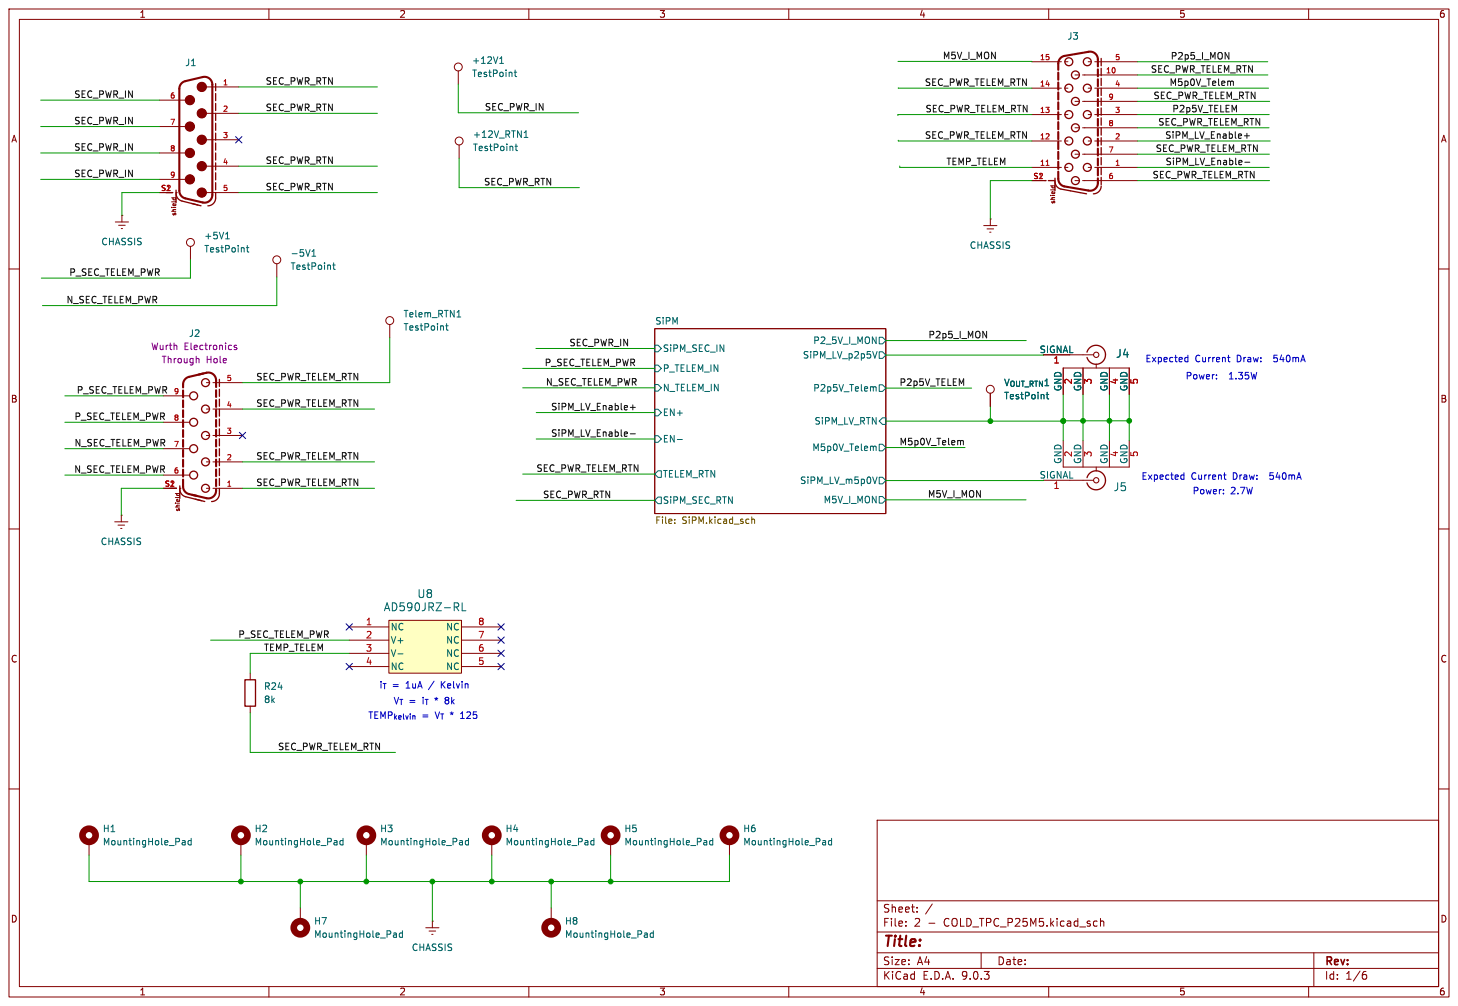
[picture p298: page 1]

Id: 1/6 Title: File: 2 - COLD_TPC_P25M5.kicad_sch Sheet: /

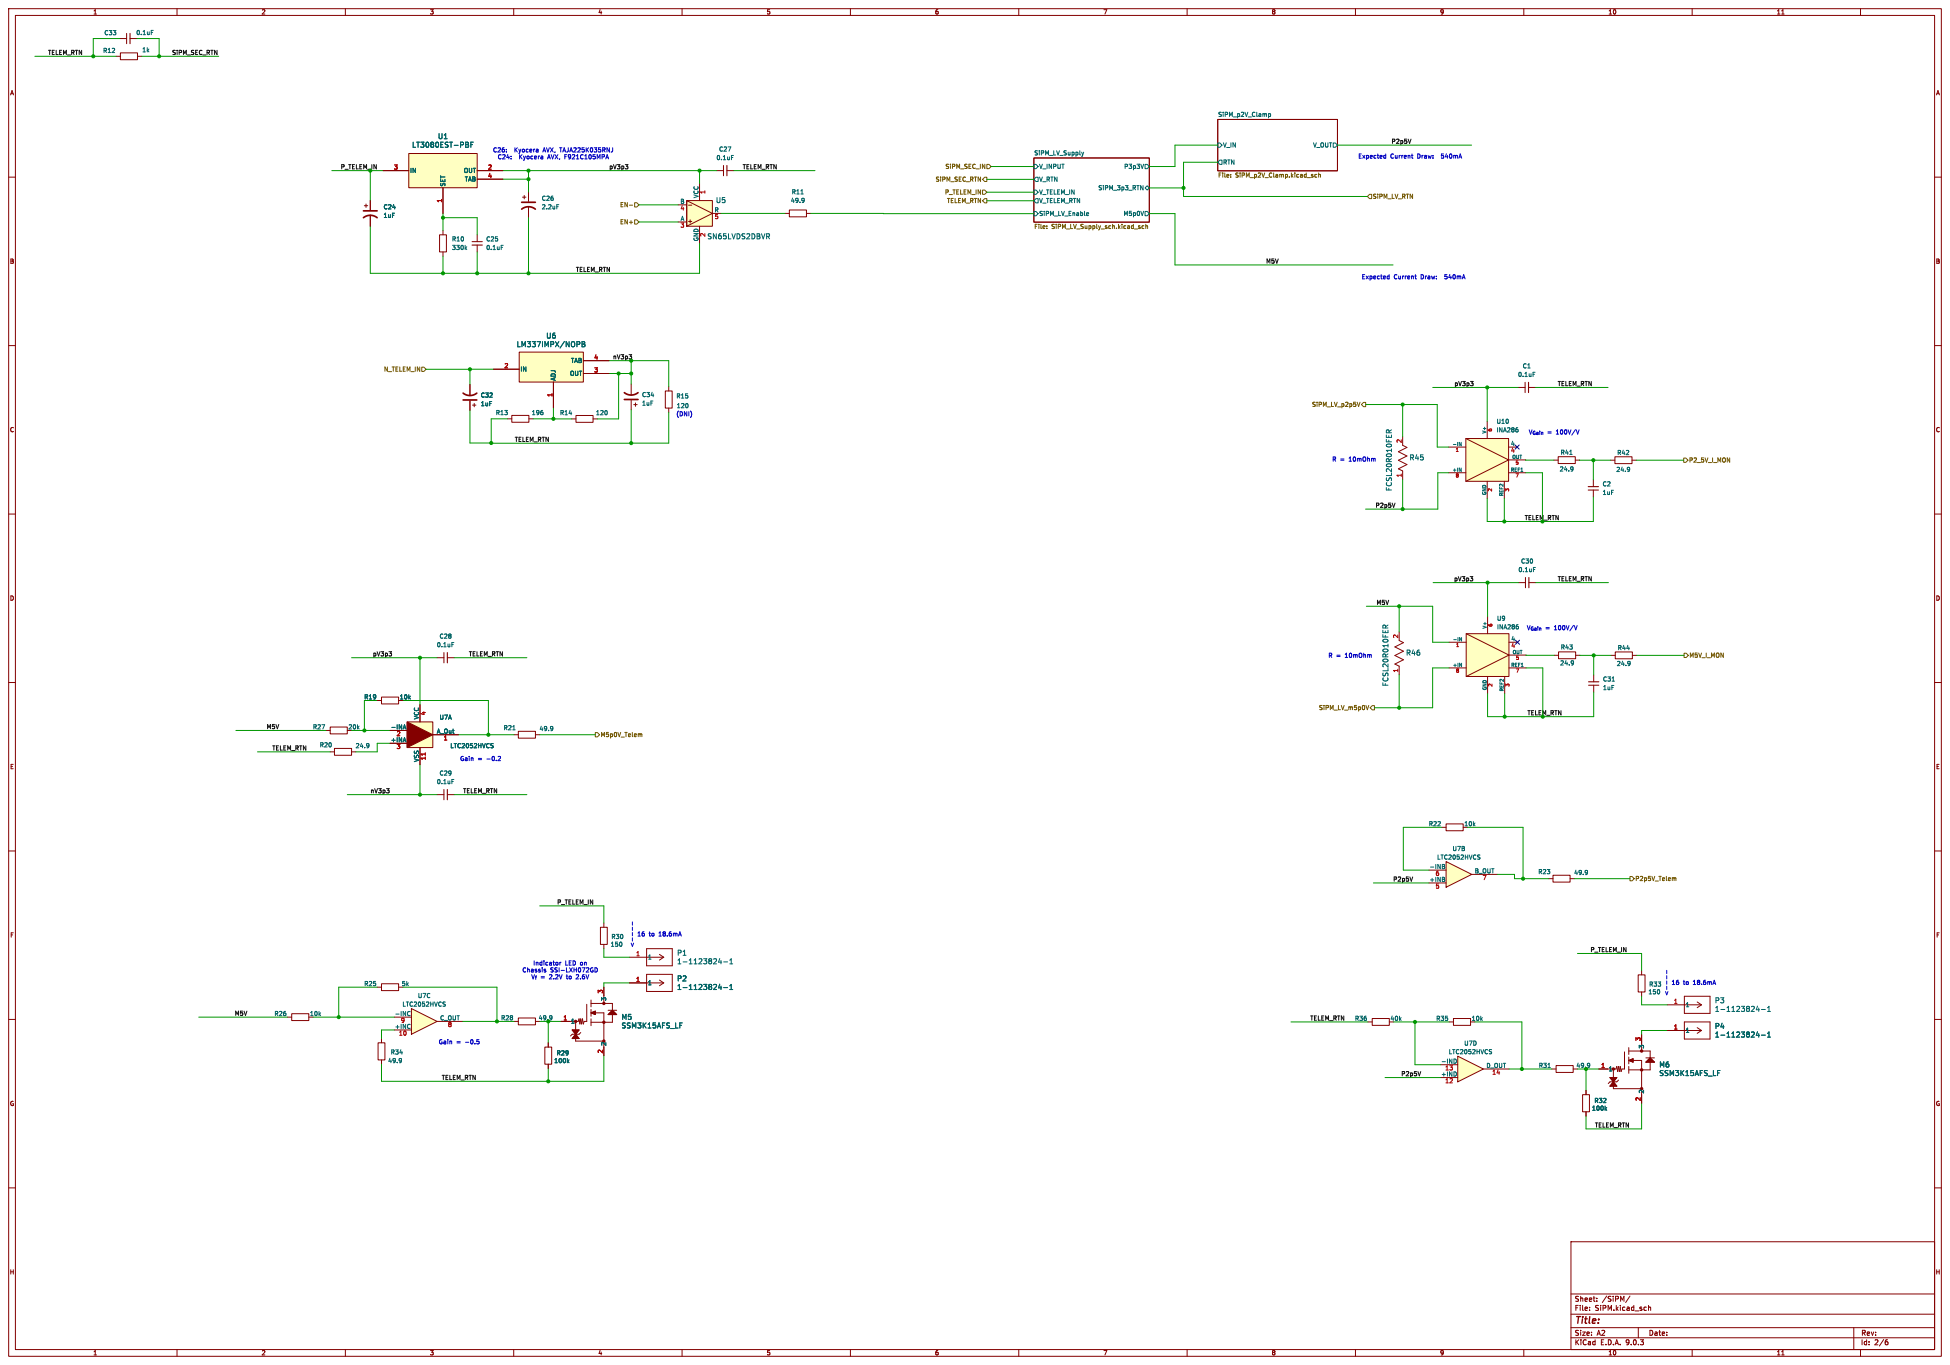
[picture p299: page 2]

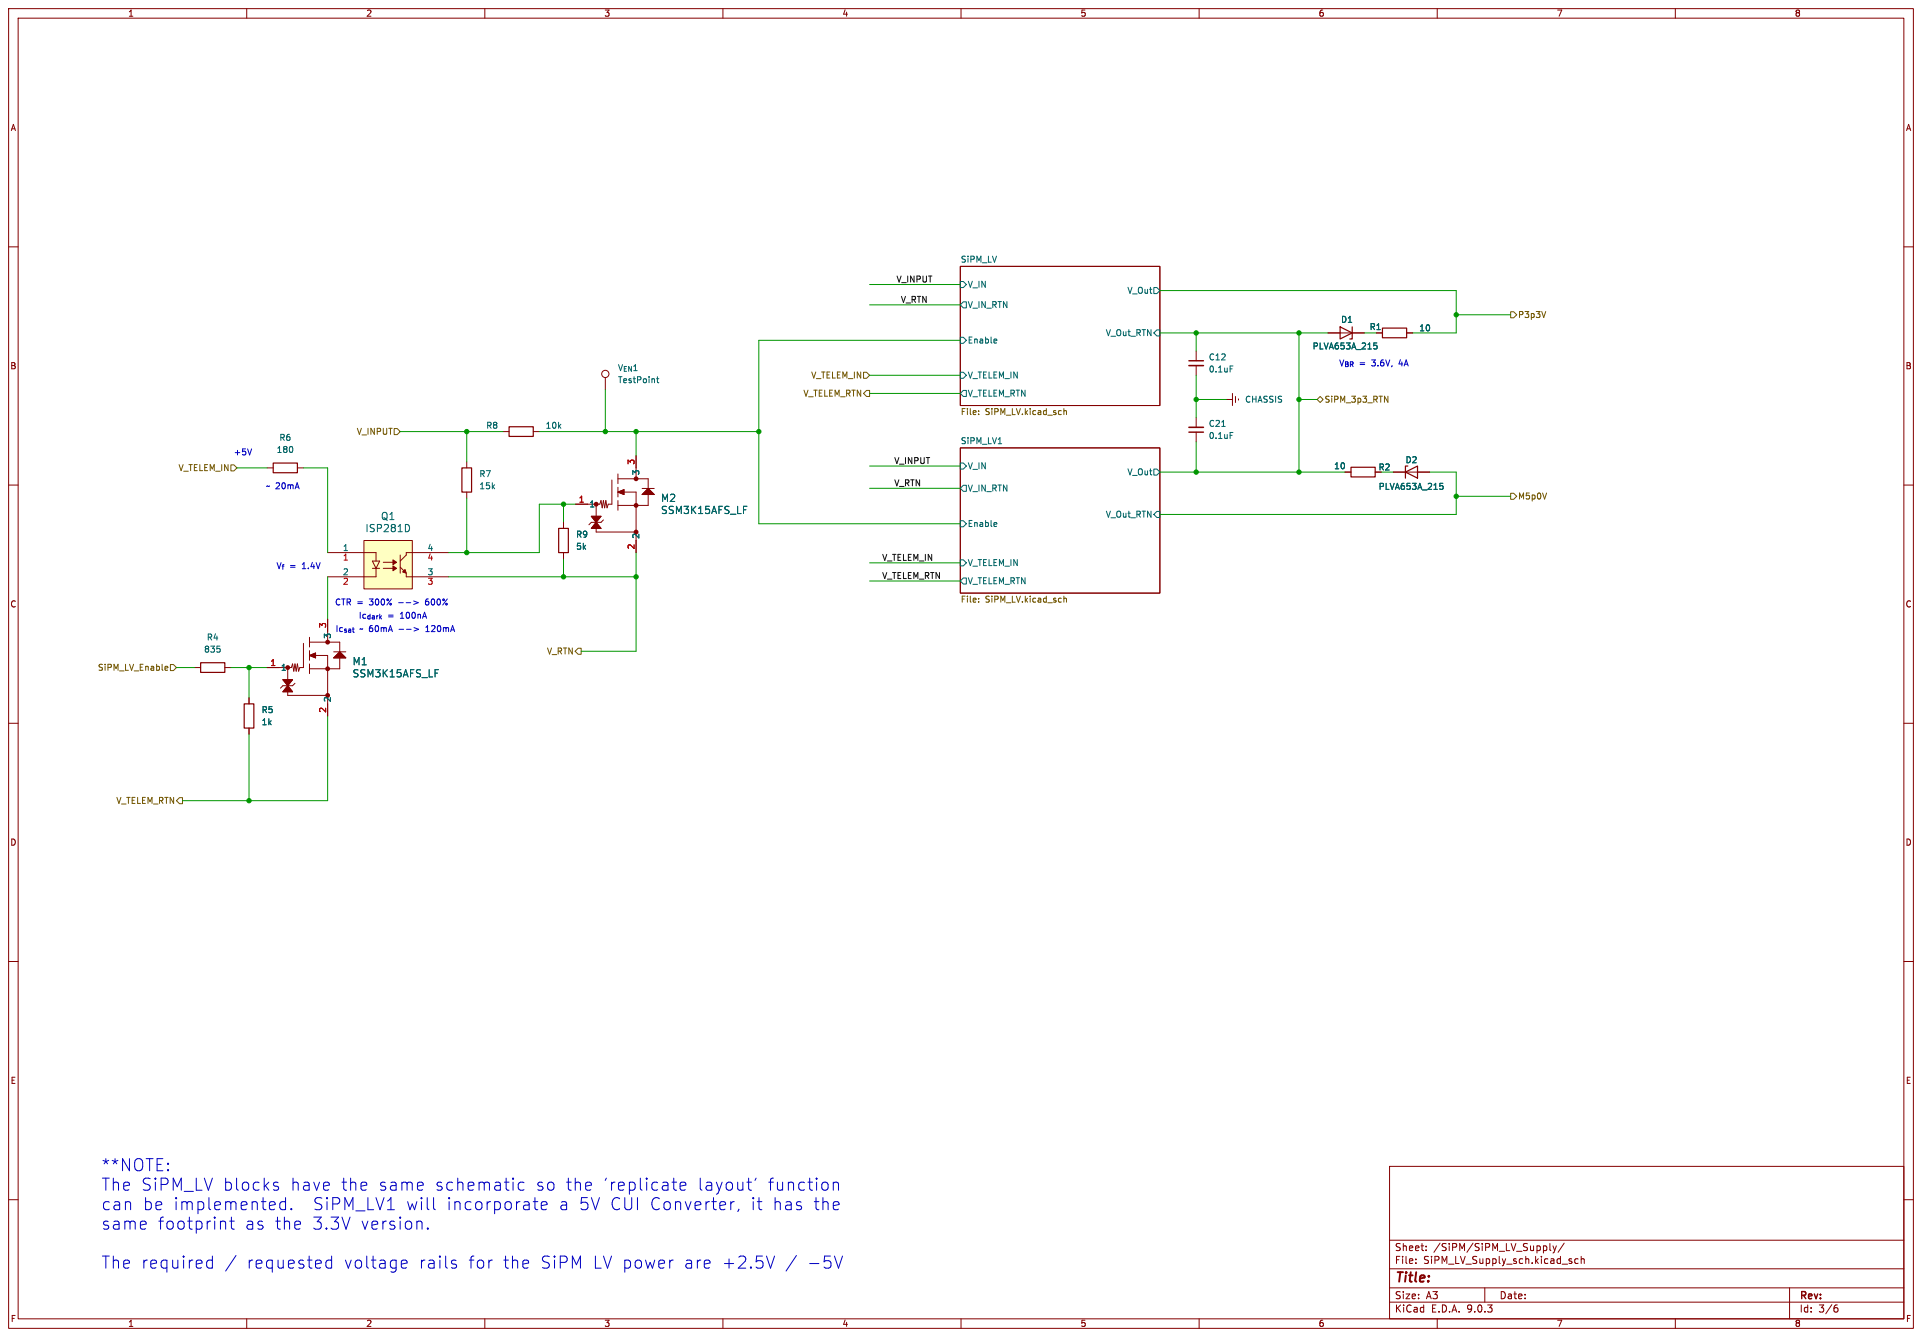
[picture p300: page 3]

Id: 3/6 Title: File: SiPM_LV_Supply_sch.kicad_sch Sheet: /SiPM/SiPM_LV_Supply/

The required / requested voltage rails for the SiPM LV power are +2.5V / -5V

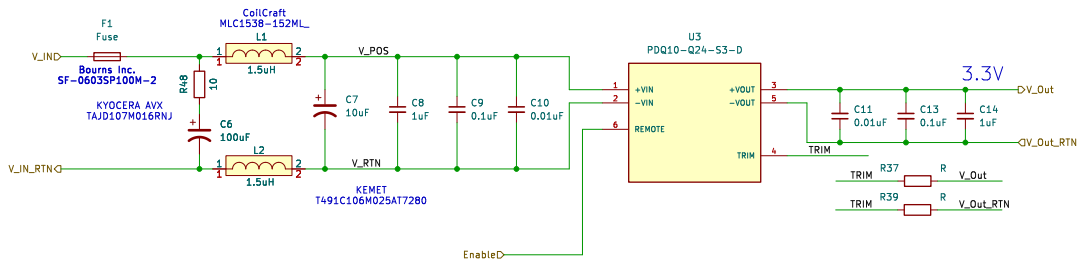
[picture p301: page 4]

Id: 4/6 Title: File: SiPM_LV.kicad_sch Sheet: /SiPM/SiPM_LV_Supply/SiPM_LV/

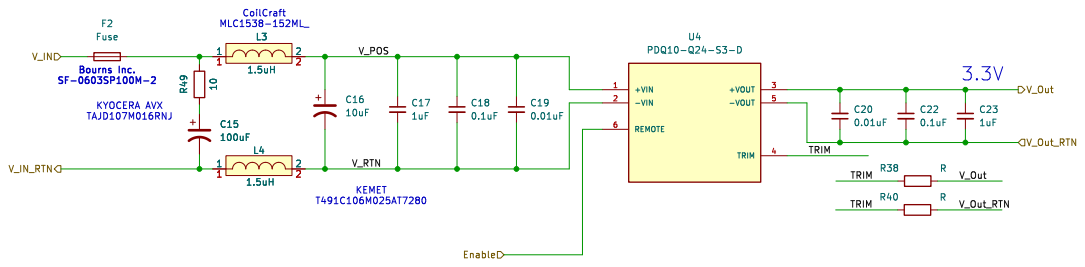
[picture p302: page 5]

Id: 5/6 Title: File: SiPM_LV.kicad_sch Sheet: /SiPM/SiPM_LV_Supply/SiPM_LV1/

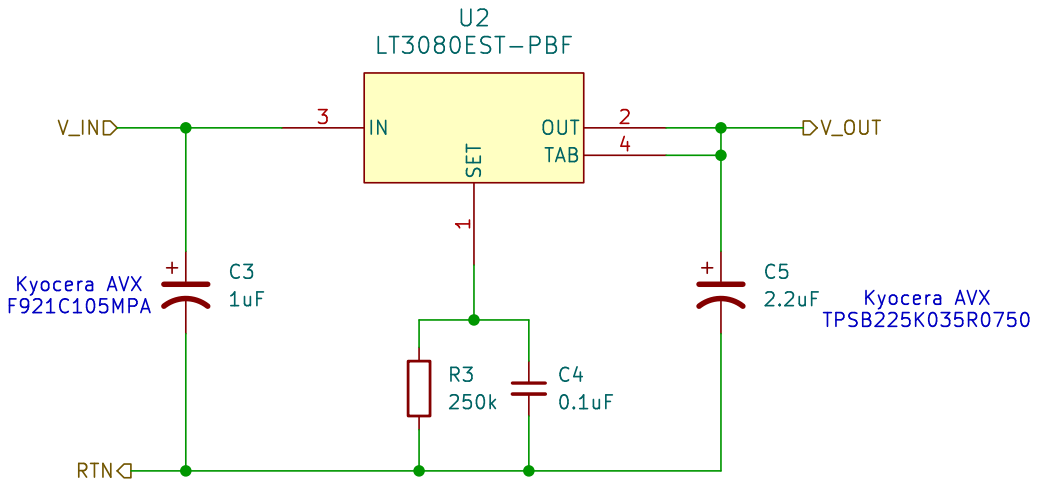
[picture p303: page 6]

Id: 7/6 Title: File: SiPM_p2V_Clamp.kicad_sch Sheet: /SiPM/SiPM_p2V_Clamp/ C4
