rjridle/GRAMS/2_Schematics_and_Layout/2_WARM_TPC/10_WARM_TPC_Shaper/WARM_TPC_Shaper.pdf

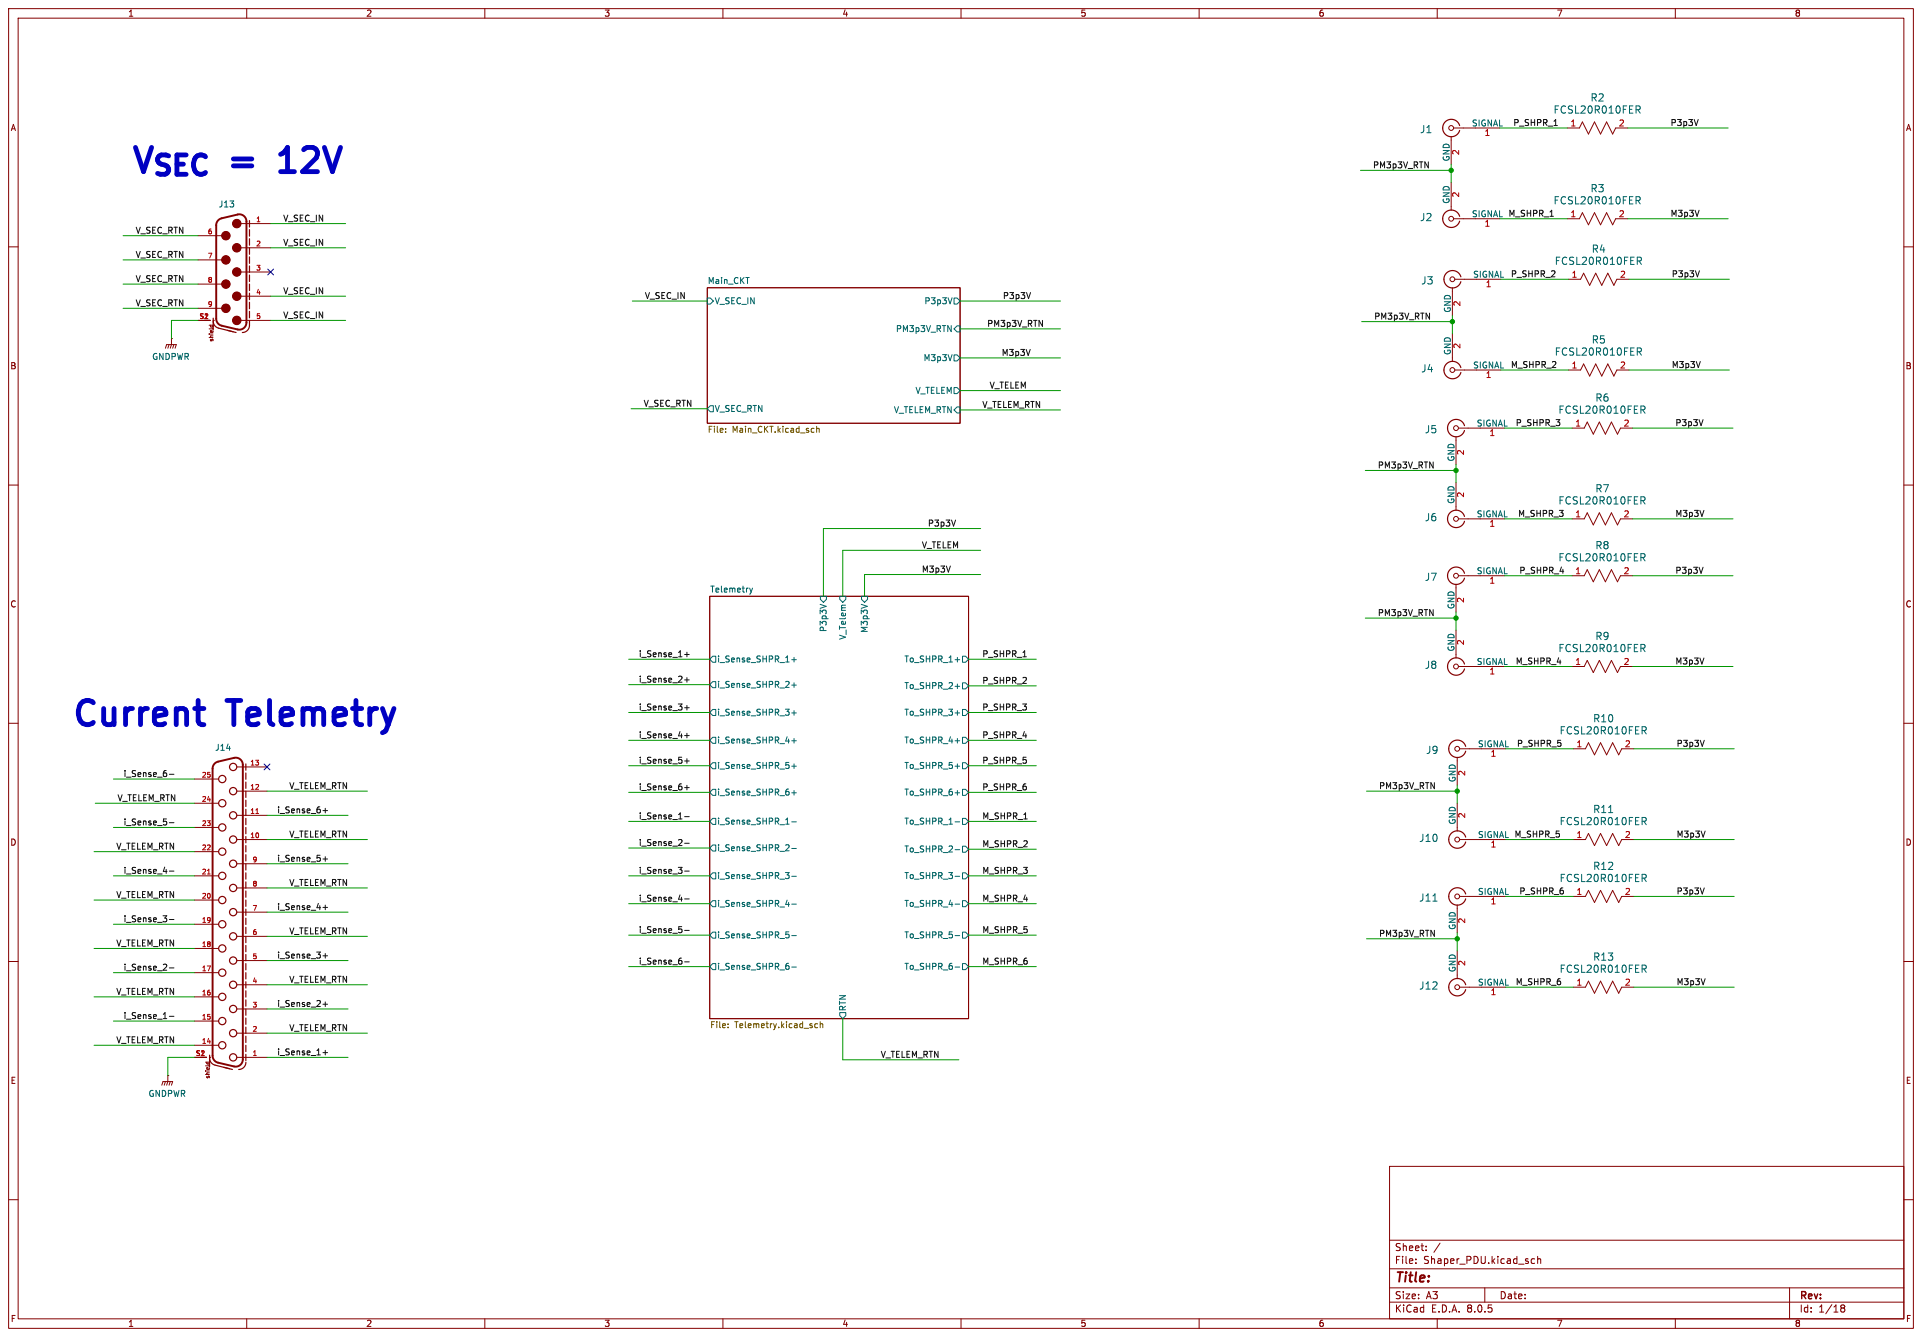
[picture p304: page 1]

Id: 1/18 Title: File: Shaper_PDU.kicad_sch Sheet: / To_SHPR_4- To_SHPR_6-

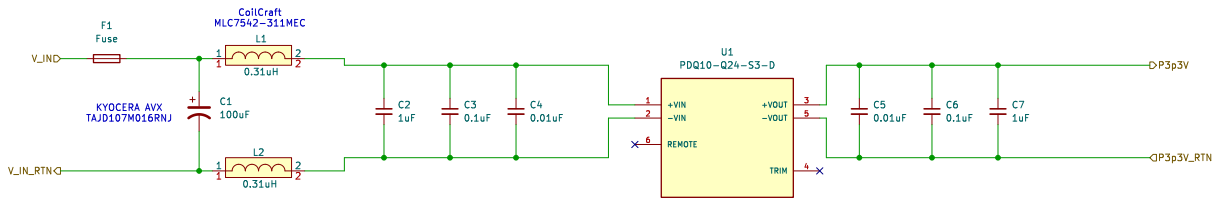
[picture p305: page 2]

Id: 2/18 Title: File: Shaper_PUD.kicad_sch Sheet: /Main_CKT/Shaper_PDU/

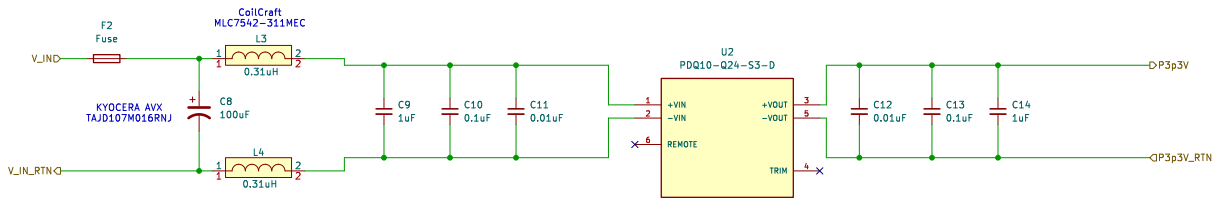
[picture p306: page 3]

Id: 3/18 Title: File: Shaper_PUD.kicad_sch Sheet: /Main_CKT/Shaper_PDU1/

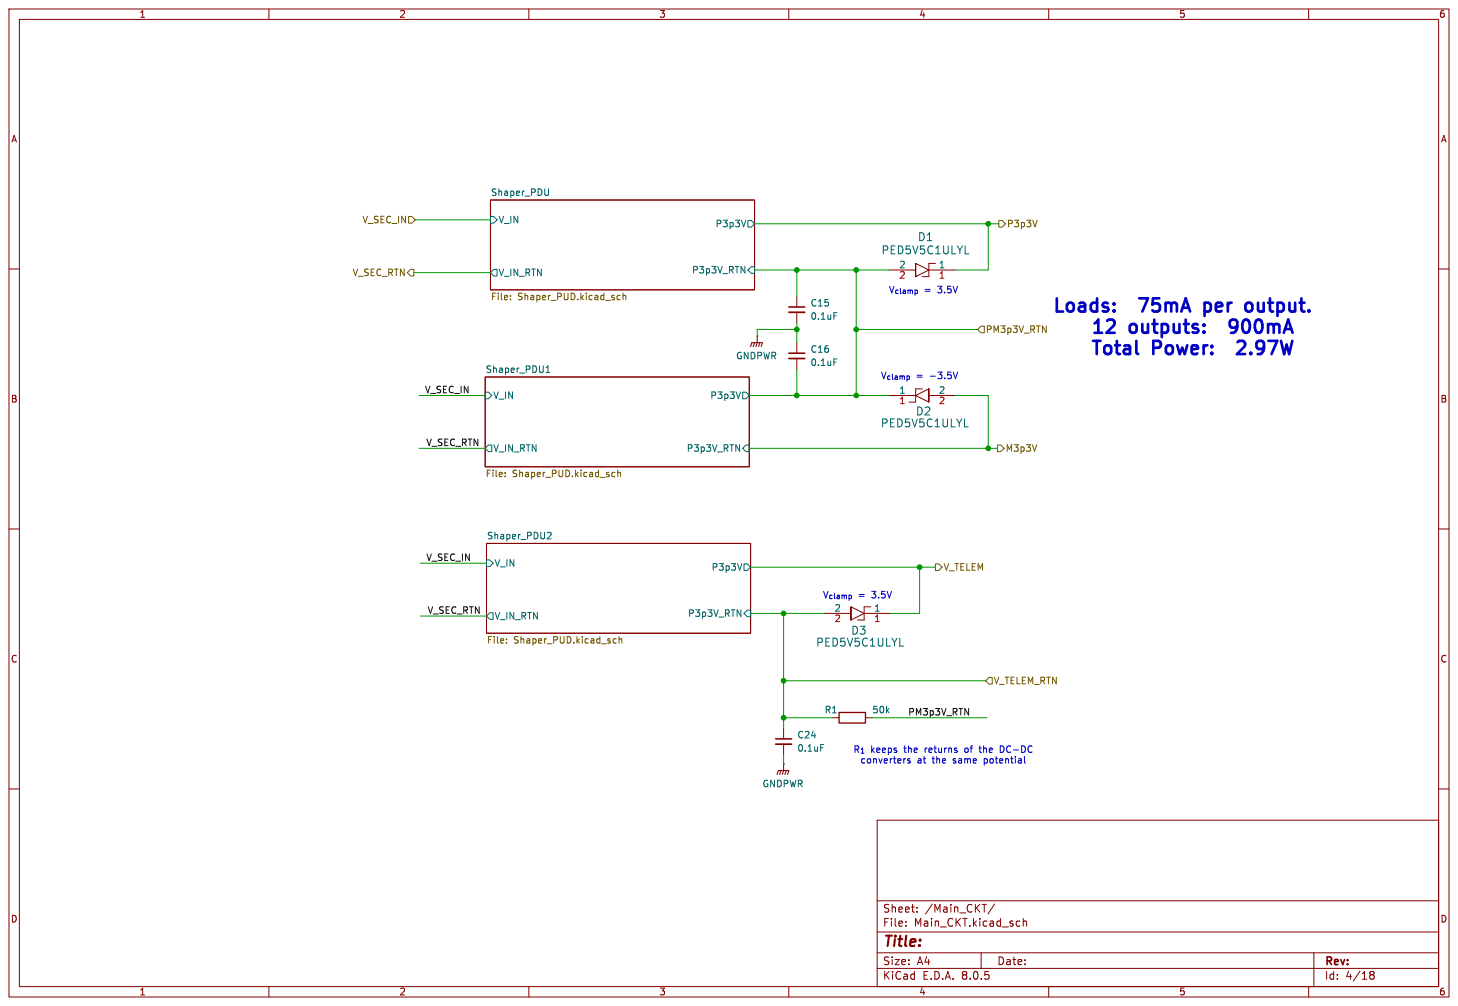
[picture p307: page 4]

Shaper_PDU
V_{clamp}= -3.5V R_{1}keeps the returns of the DC-DC

Id: 4/18 Title: File: Main_CKT.kicad_sch Sheet: /Main_CKT/

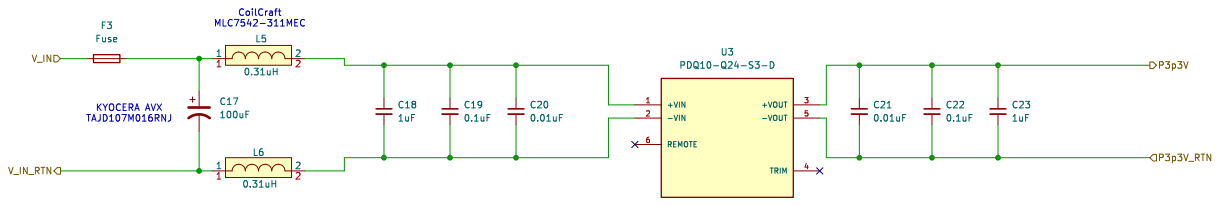
[picture p308: page 5]

Id: 5/18 Title: File: Shaper_PUD.kicad_sch Sheet: /Main_CKT/Shaper_PDU2/

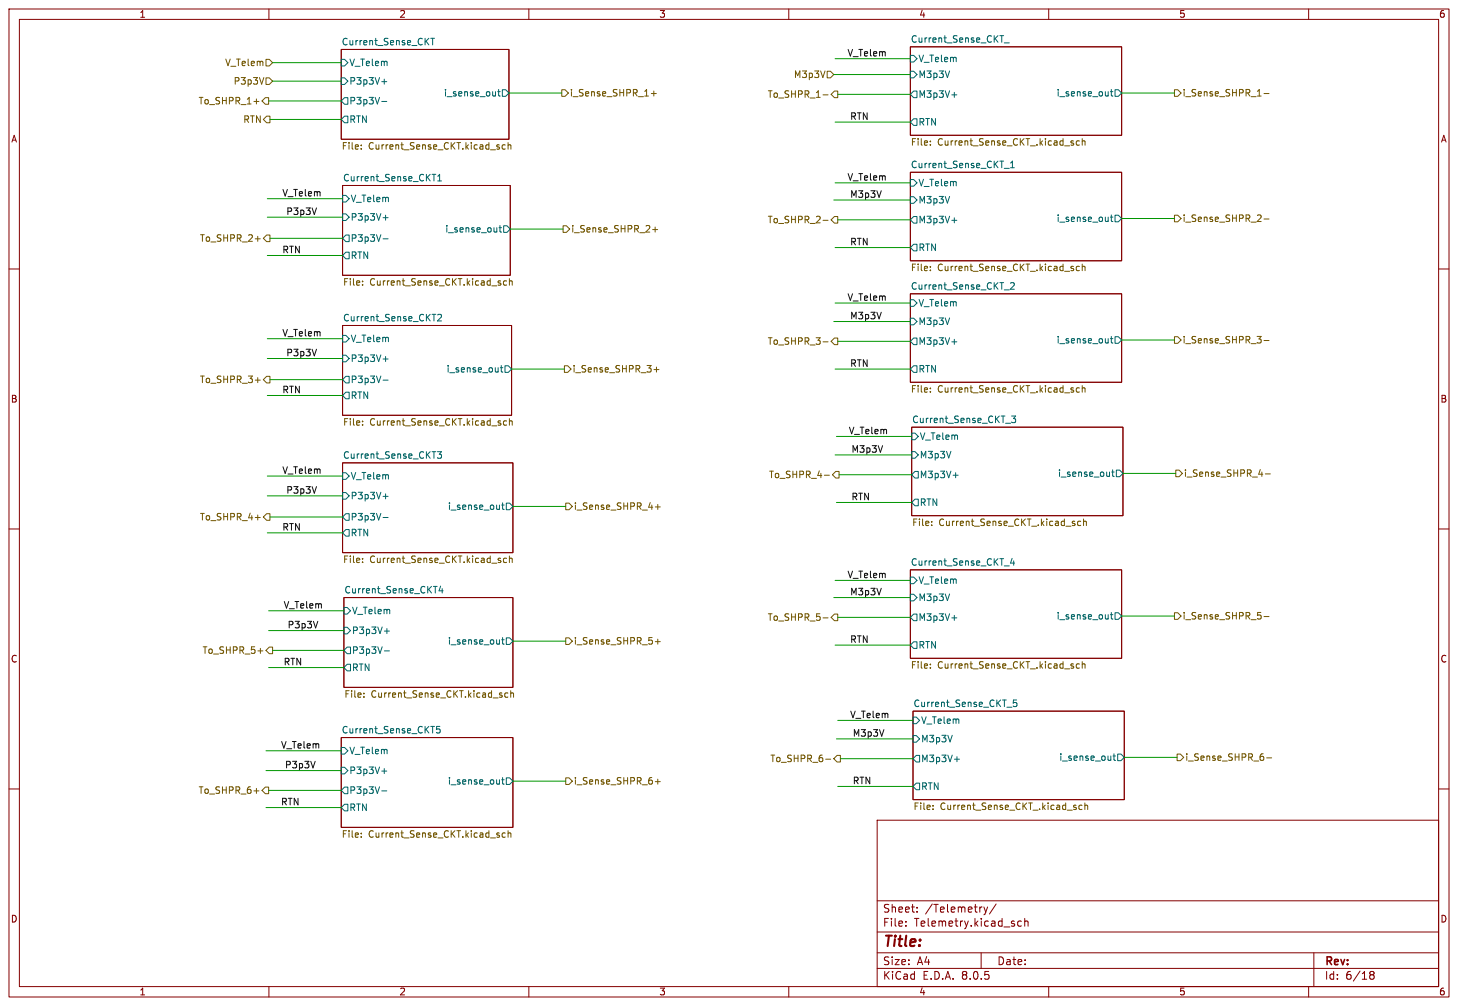
[picture p309: page 6]

Id: 6/18 Title: File: Telemetry.kicad_sch Sheet: /Telemetry/

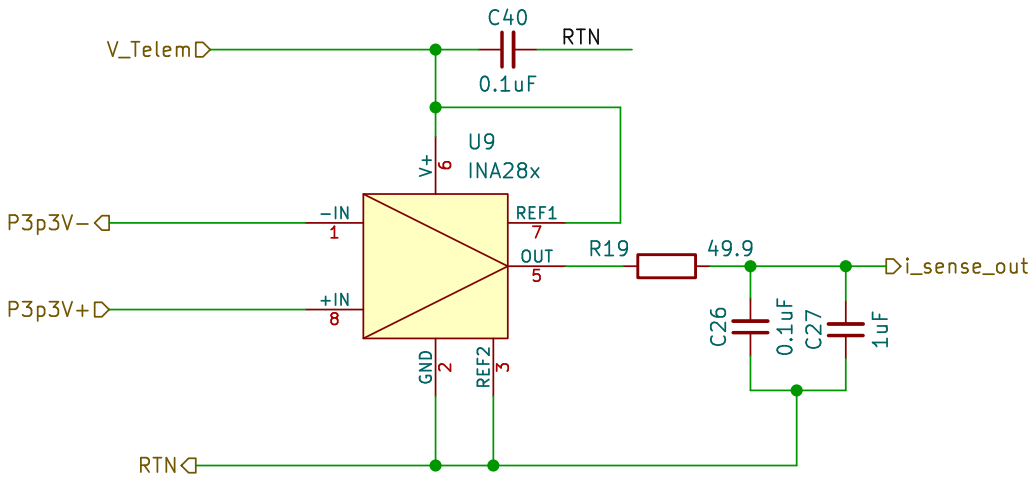
[picture p310: page 7]

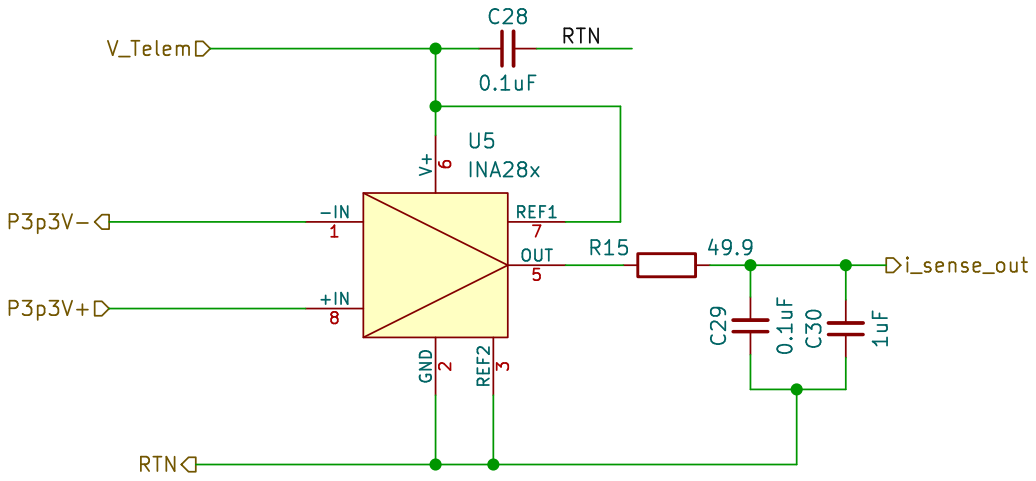
[picture p311: page 8]

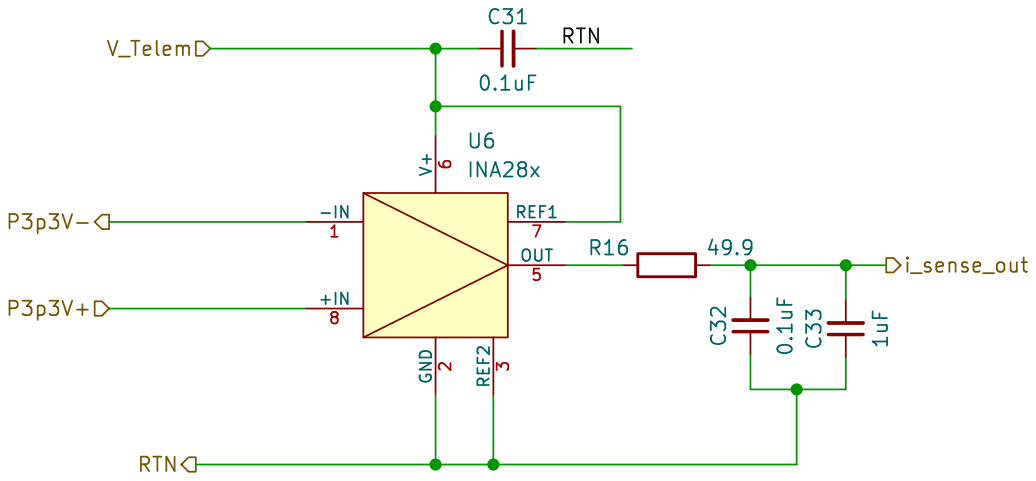
[picture p312: page 9]

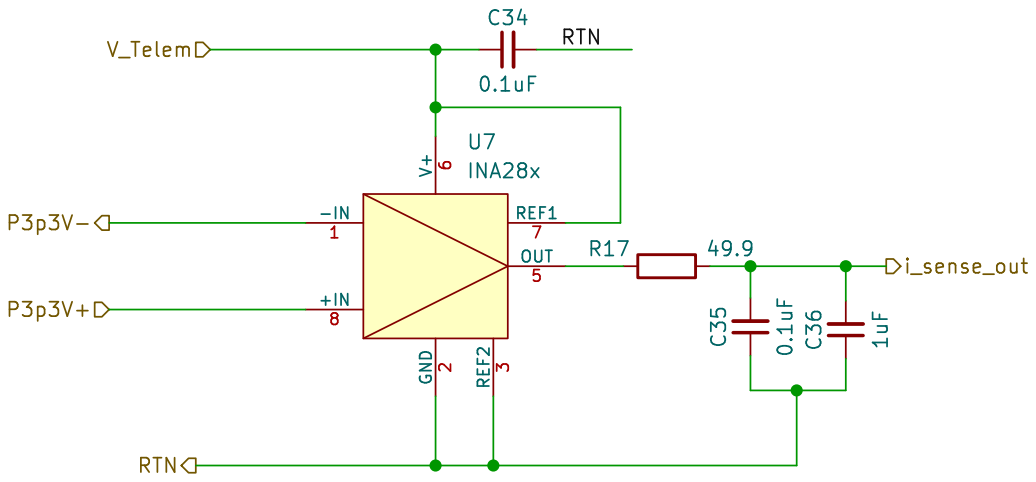
[picture p313: page 10]

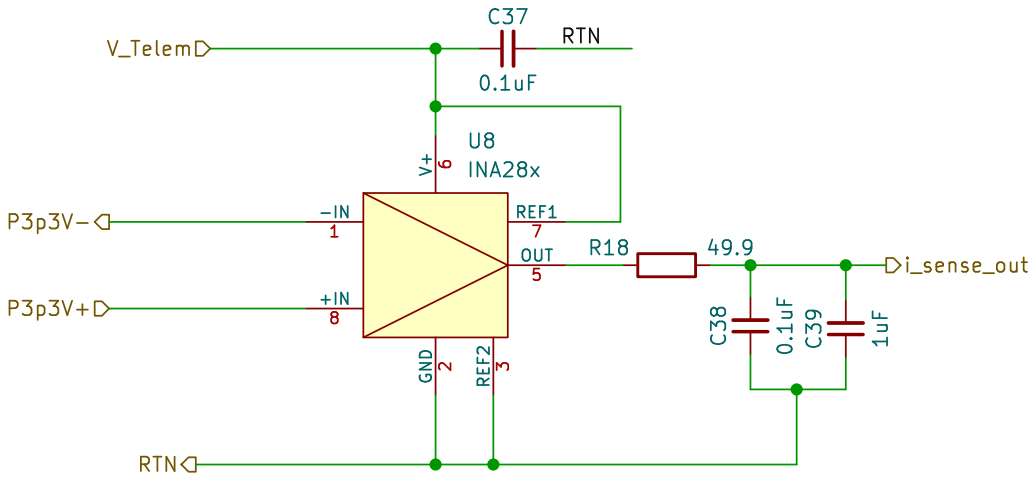
[picture p314: page 11]

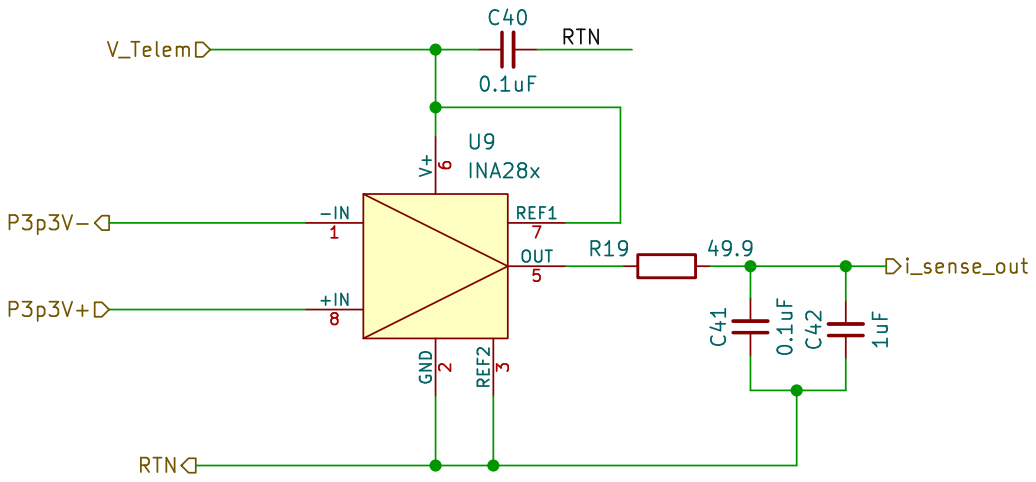
[picture p315: page 12]

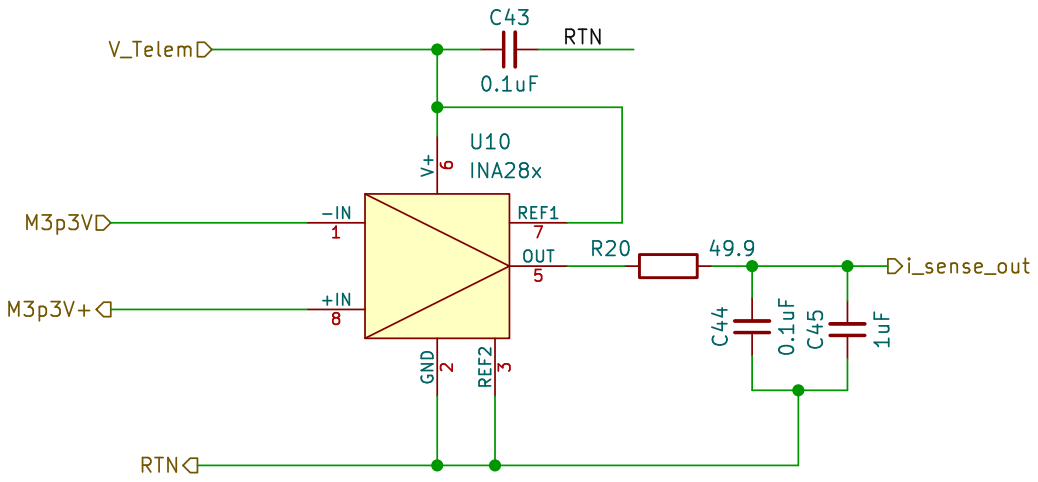
[picture p316: page 13]

Id: 13/18 Title: File: Current_Sense_CKT_.kicad_sch Sheet: /Telemetry/Current_Sense_CKT_/

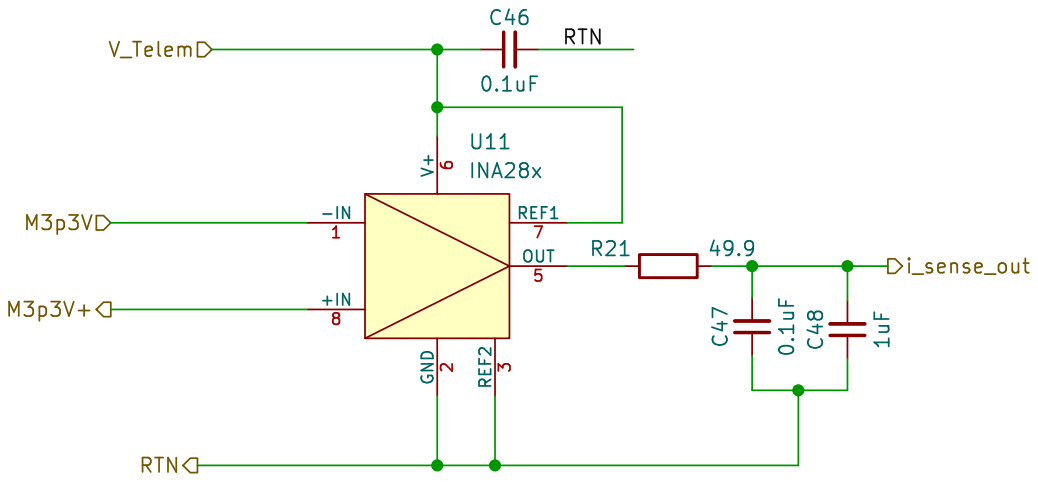
[picture p317: page 14]

Id: 14/18 Title: File: Current_Sense_CKT_.kicad_sch Sheet: /Telemetry/Current_Sense_CKT_1/

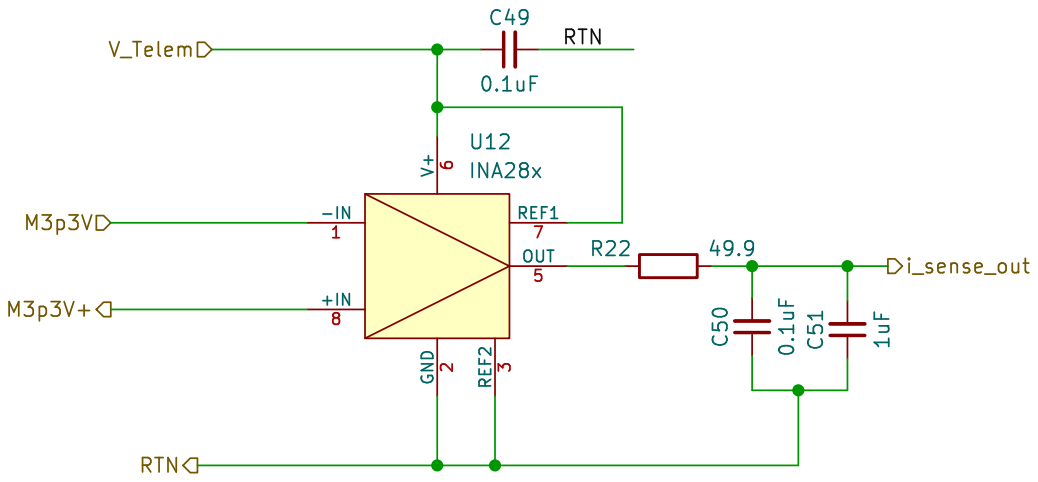
[picture p318: page 15]

Id: 15/18 Title: File: Current_Sense_CKT_.kicad_sch Sheet: /Telemetry/Current_Sense_CKT_2/

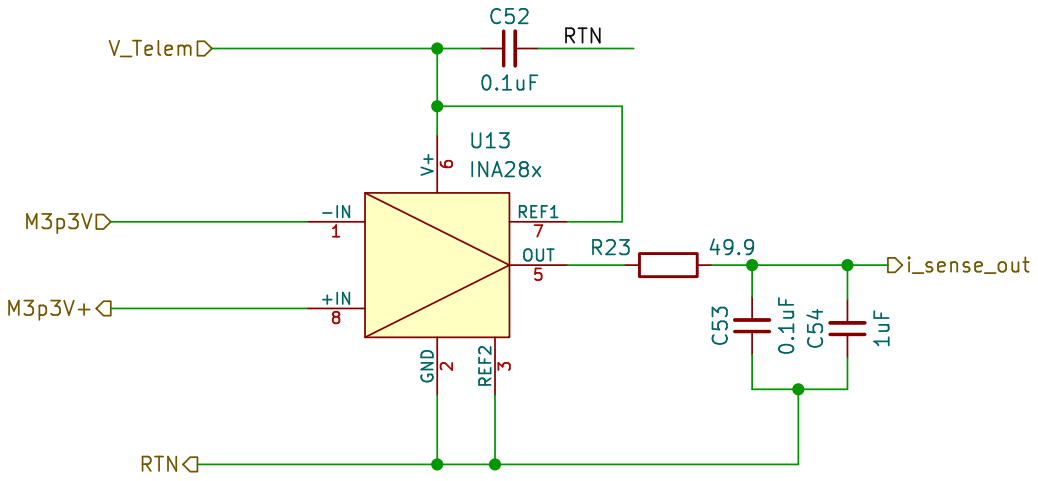
[picture p319: page 16]

Id: 16/18 Title: File: Current_Sense_CKT_.kicad_sch Sheet: /Telemetry/Current_Sense_CKT_3/

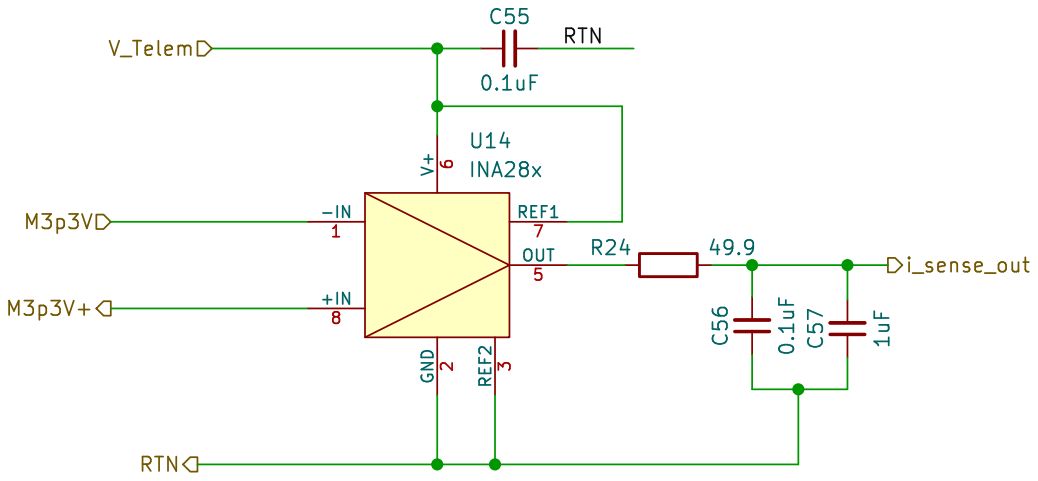
[picture p320: page 17]

Id: 17/18 Title: File: Current_Sense_CKT_.kicad_sch Sheet: /Telemetry/Current_Sense_CKT_4/

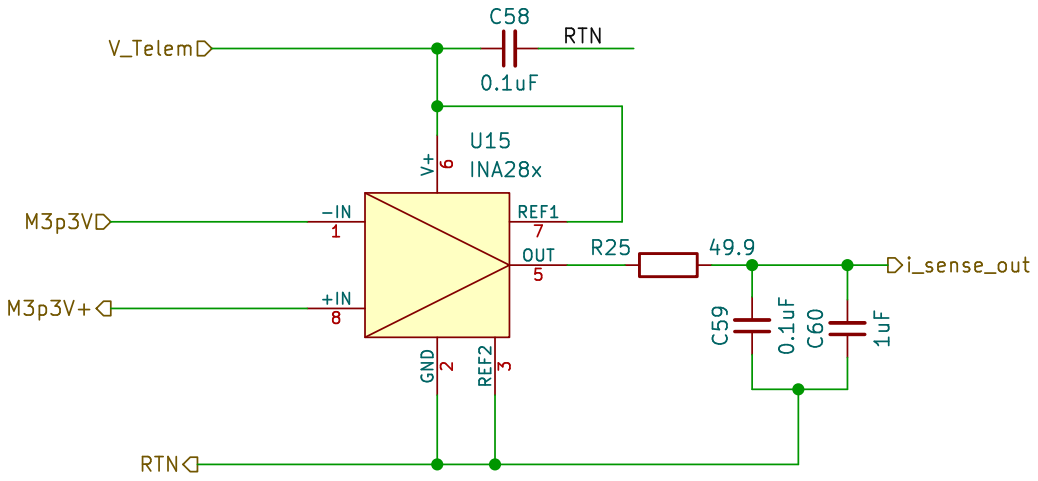
[picture p321: page 18]

Id: 18/18 Title: File: Current_Sense_CKT_.kicad_sch Sheet: /Telemetry/Current_Sense_CKT_5/
