rjridle/GRAMS/2_Schematics_and_Layout/4_TOF_PDU/12_TOF_PDU/9_TOF_PDU.pdf

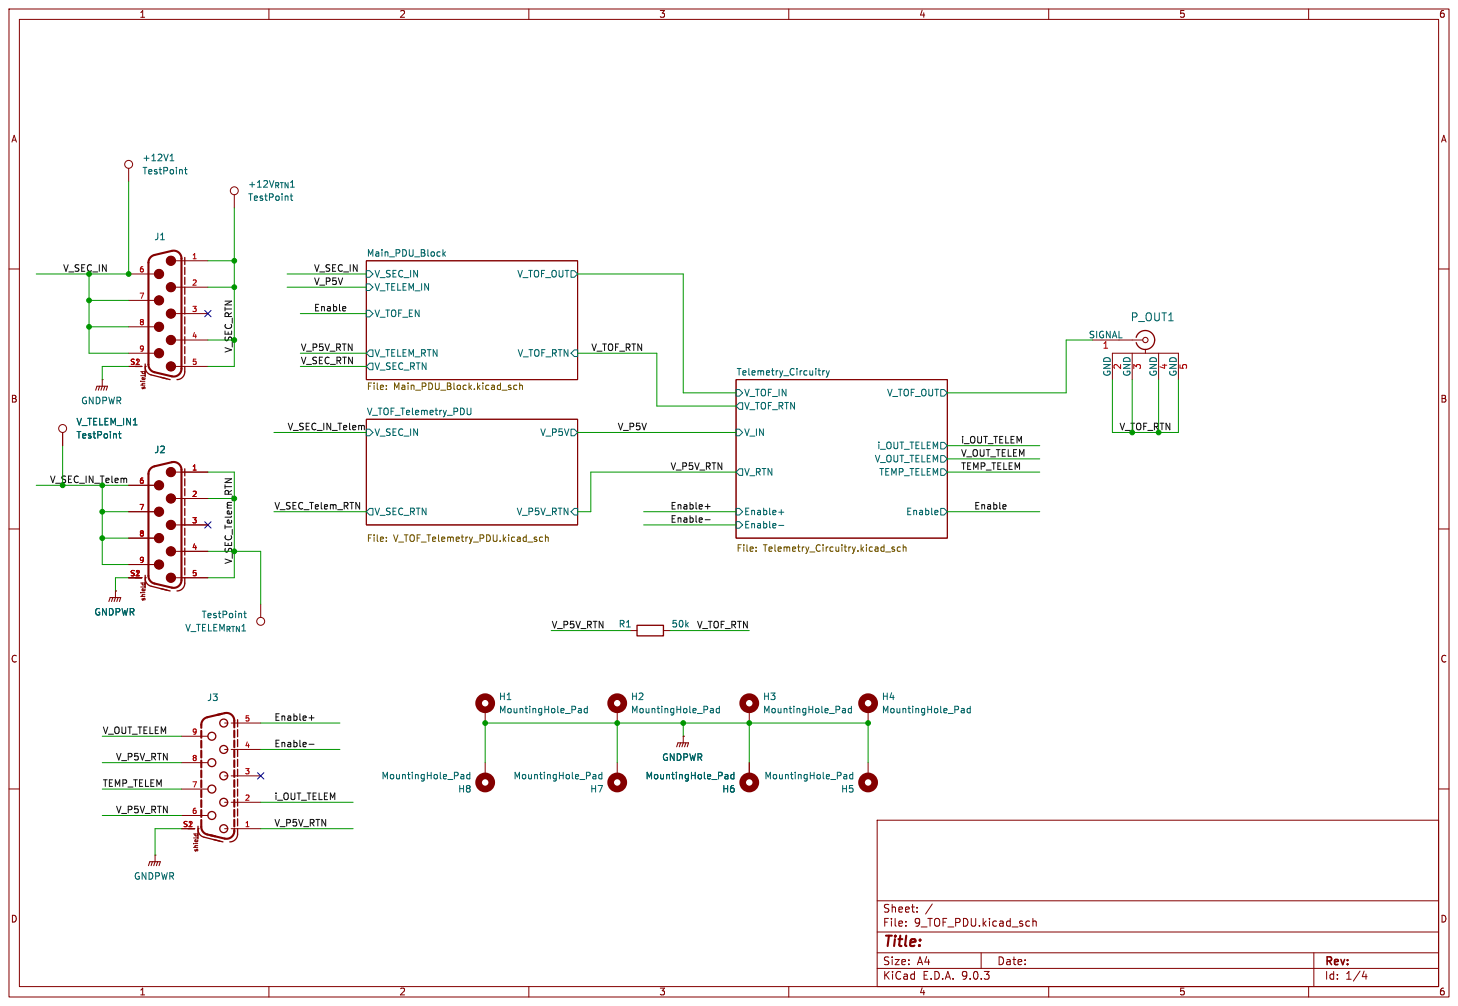
[picture p322: page 1]

Id: 1/4 Title: File: 9_TOF_PDU.kicad_sch Sheet: /

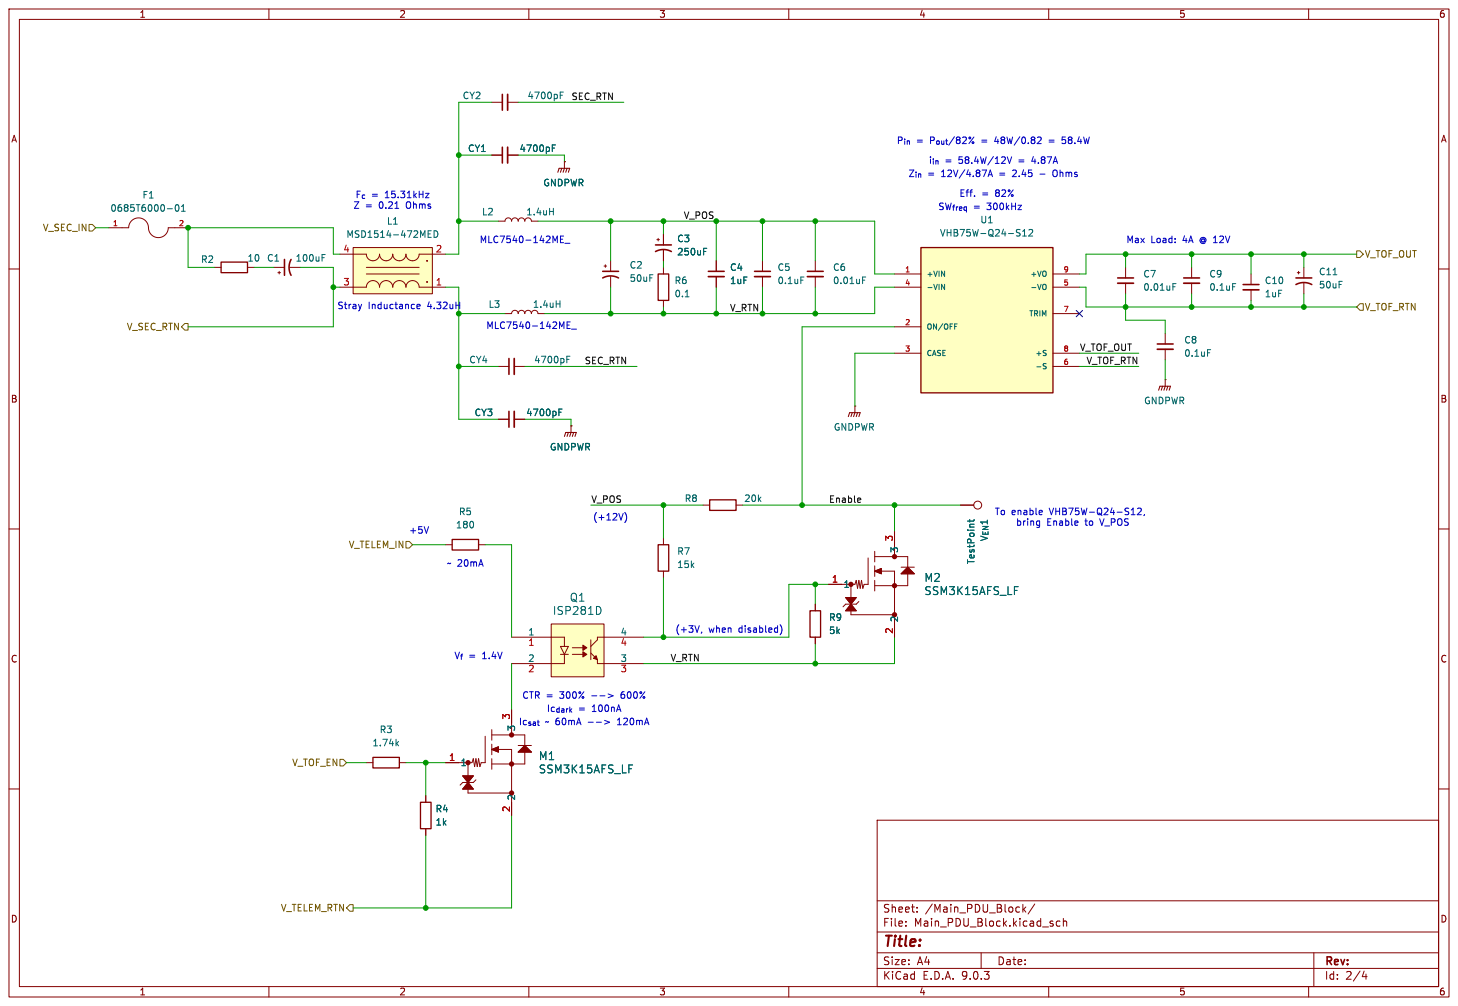
[picture p323: page 2]

Id: 2/4 Title: File: Main_PDU_Block.kicad_sch Sheet: /Main_PDU_Block/ R4

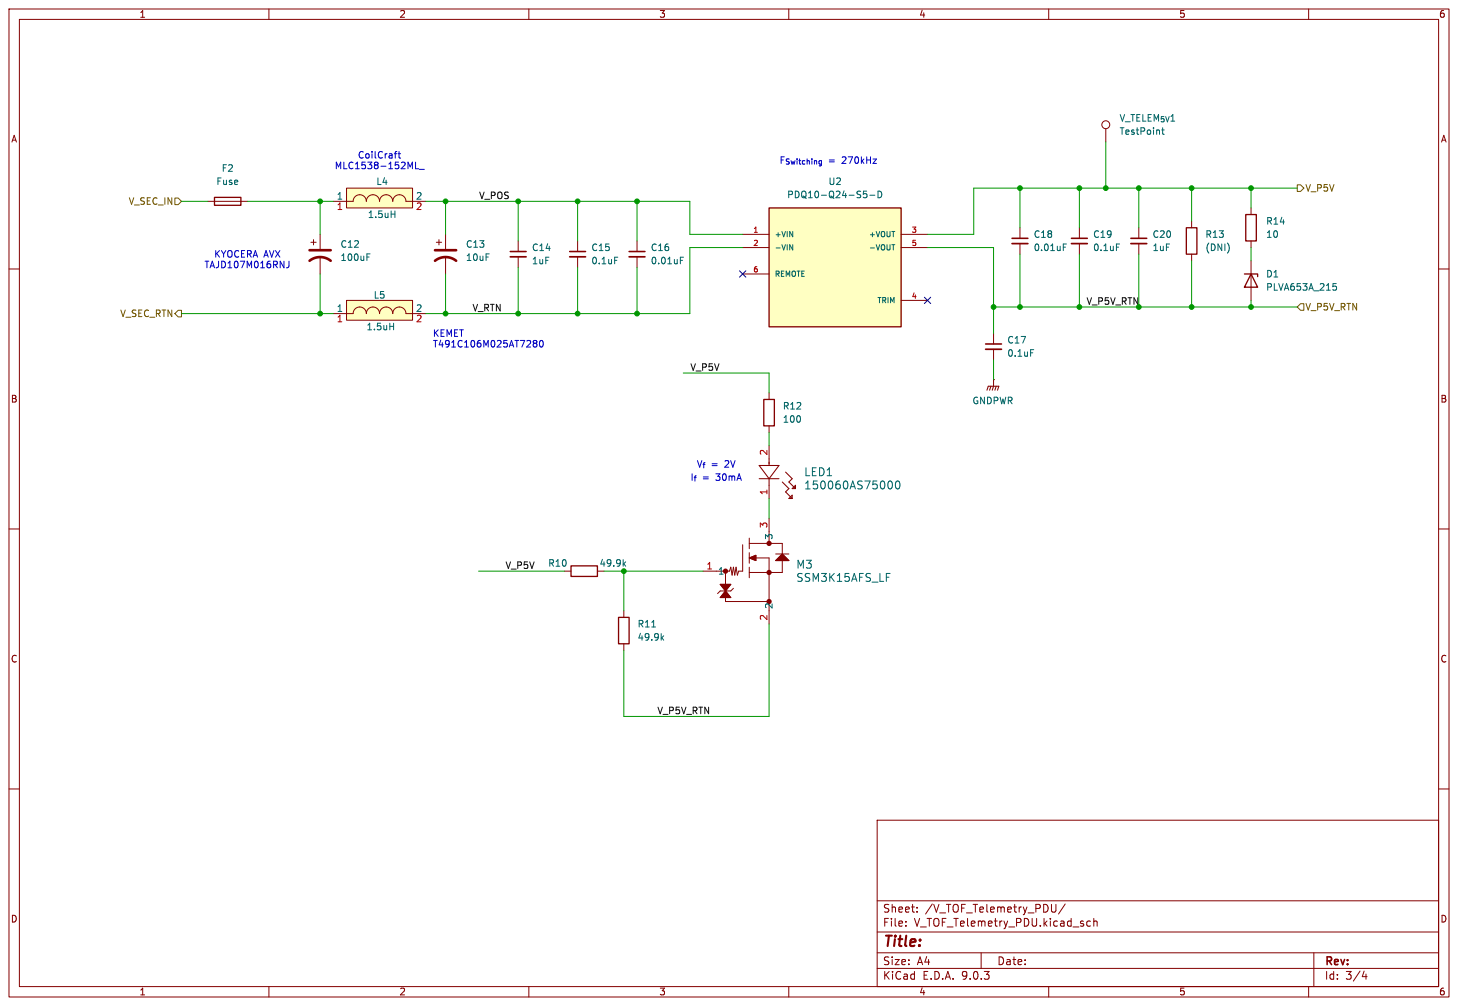
[picture p324: page 3]

Id: 3/4 Title: File: V_TOF_Telemetry_PDU.kicad_sch Sheet: /V_TOF_Telemetry_PDU/

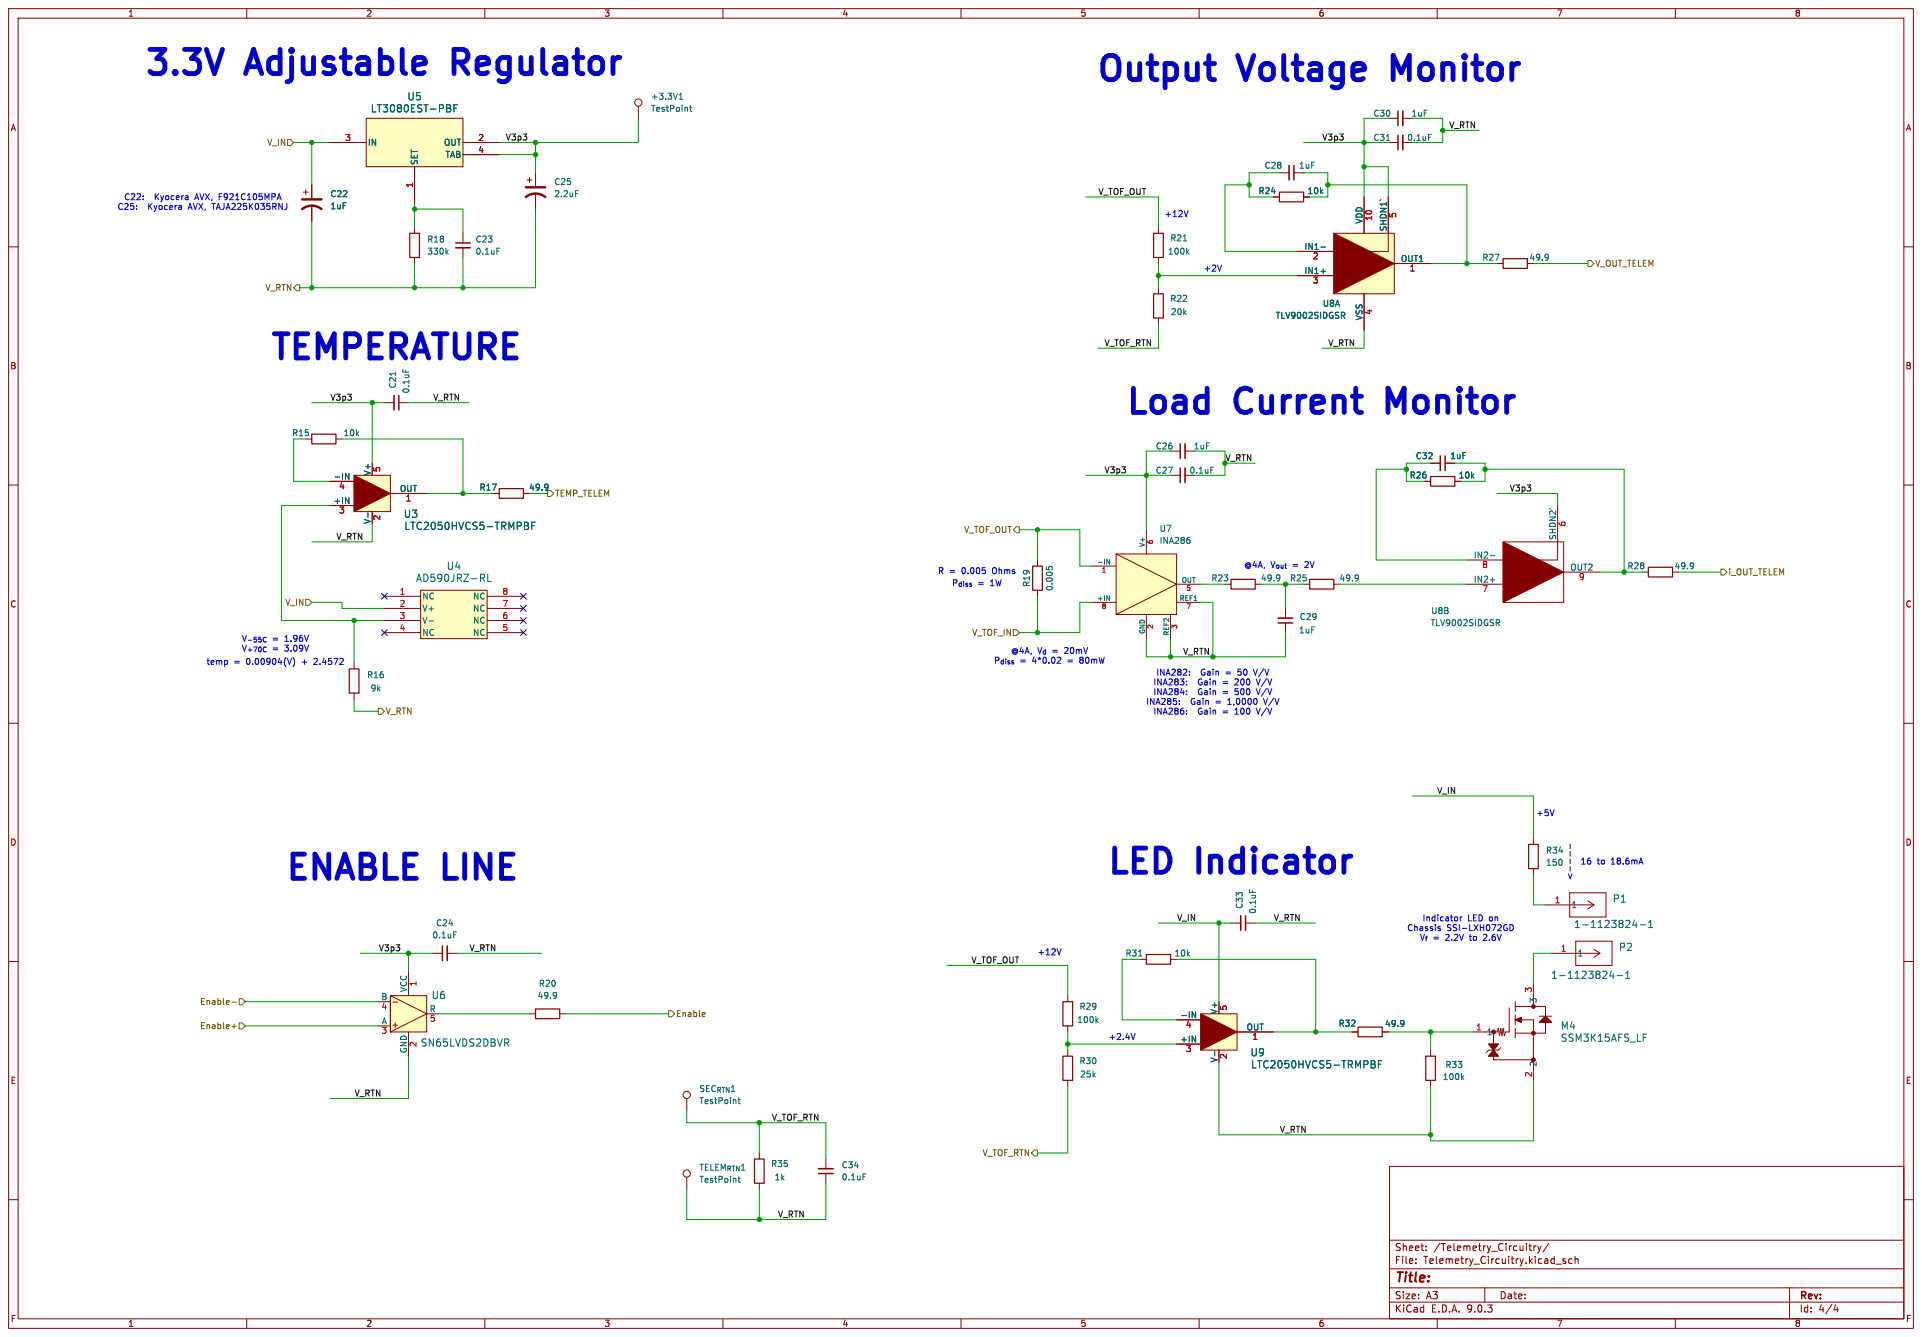
[picture p325: page 4]

V_TOF_RTN
V_{f}= 2.2V to 2.6V Load Current Monitor
