rjridle/GRAMS/2_Schematics_and_Layout/1_COLD_TPC/1_COLD_TPC_SiPM_and_Telem_PDU/Schematics_PDFs/Telem_Sec_PWR_Board.pdf

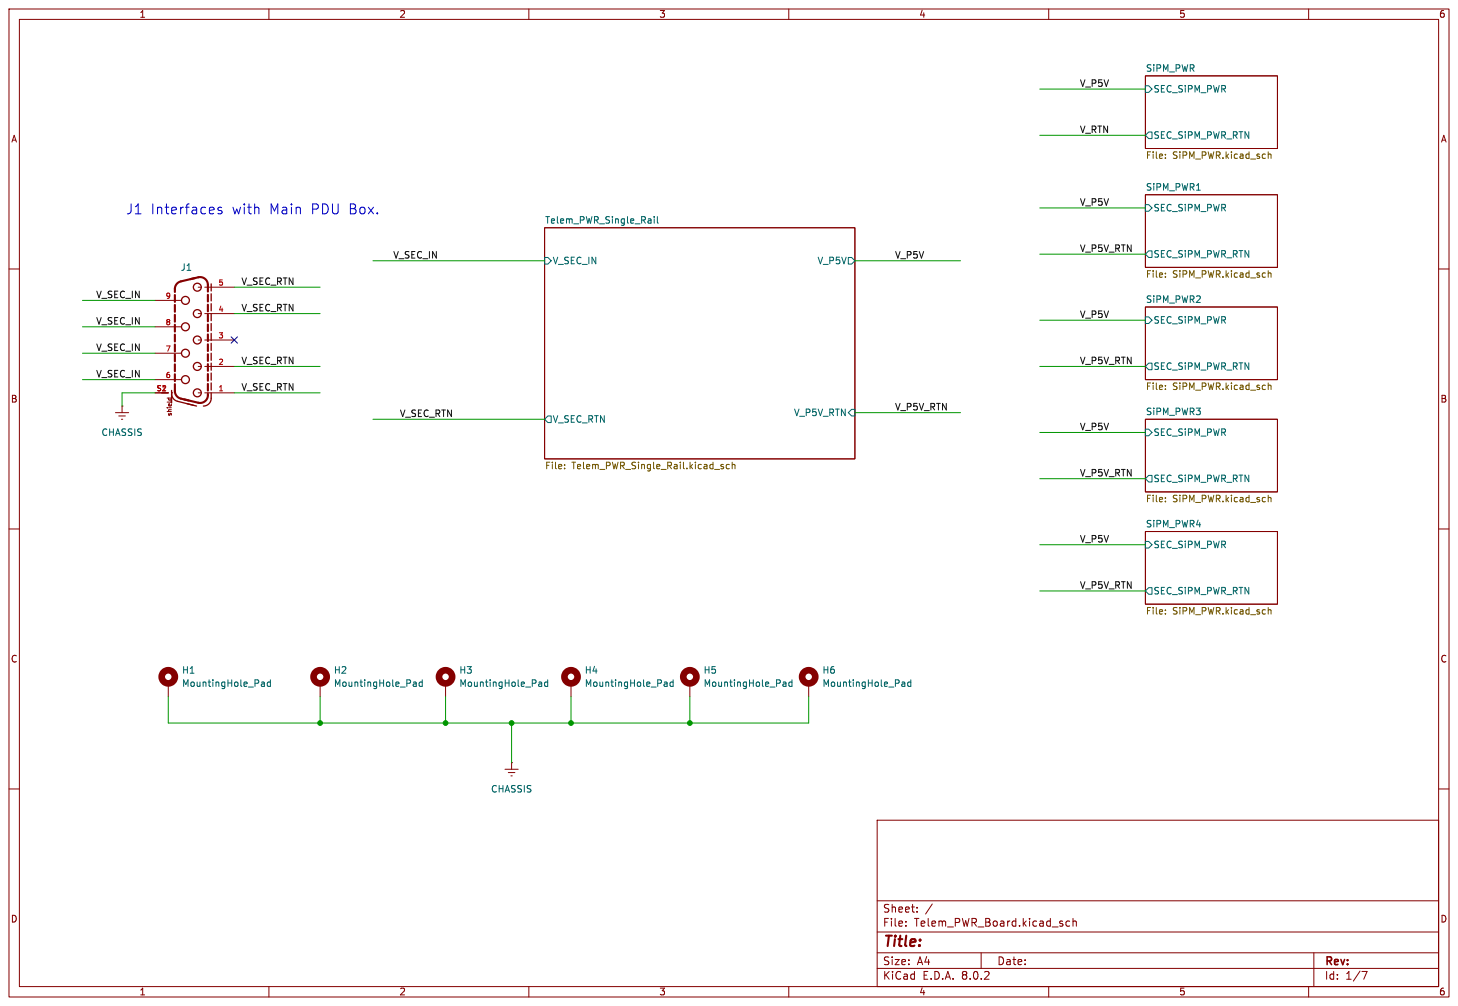
[picture p326: page 1]

Id: 1/7 Title: File: Telem_PWR_Board.kicad_sch Sheet: /

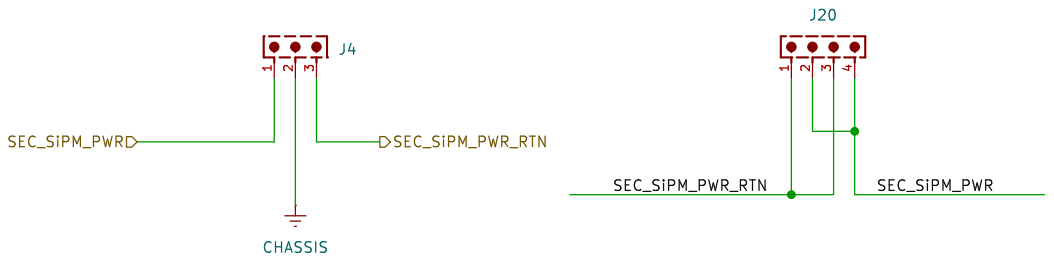
[picture p327: page 2]

Id: 2/7 Title: File: SiPM_PWR.kicad_sch Sheet: /SiPM_PWR1/

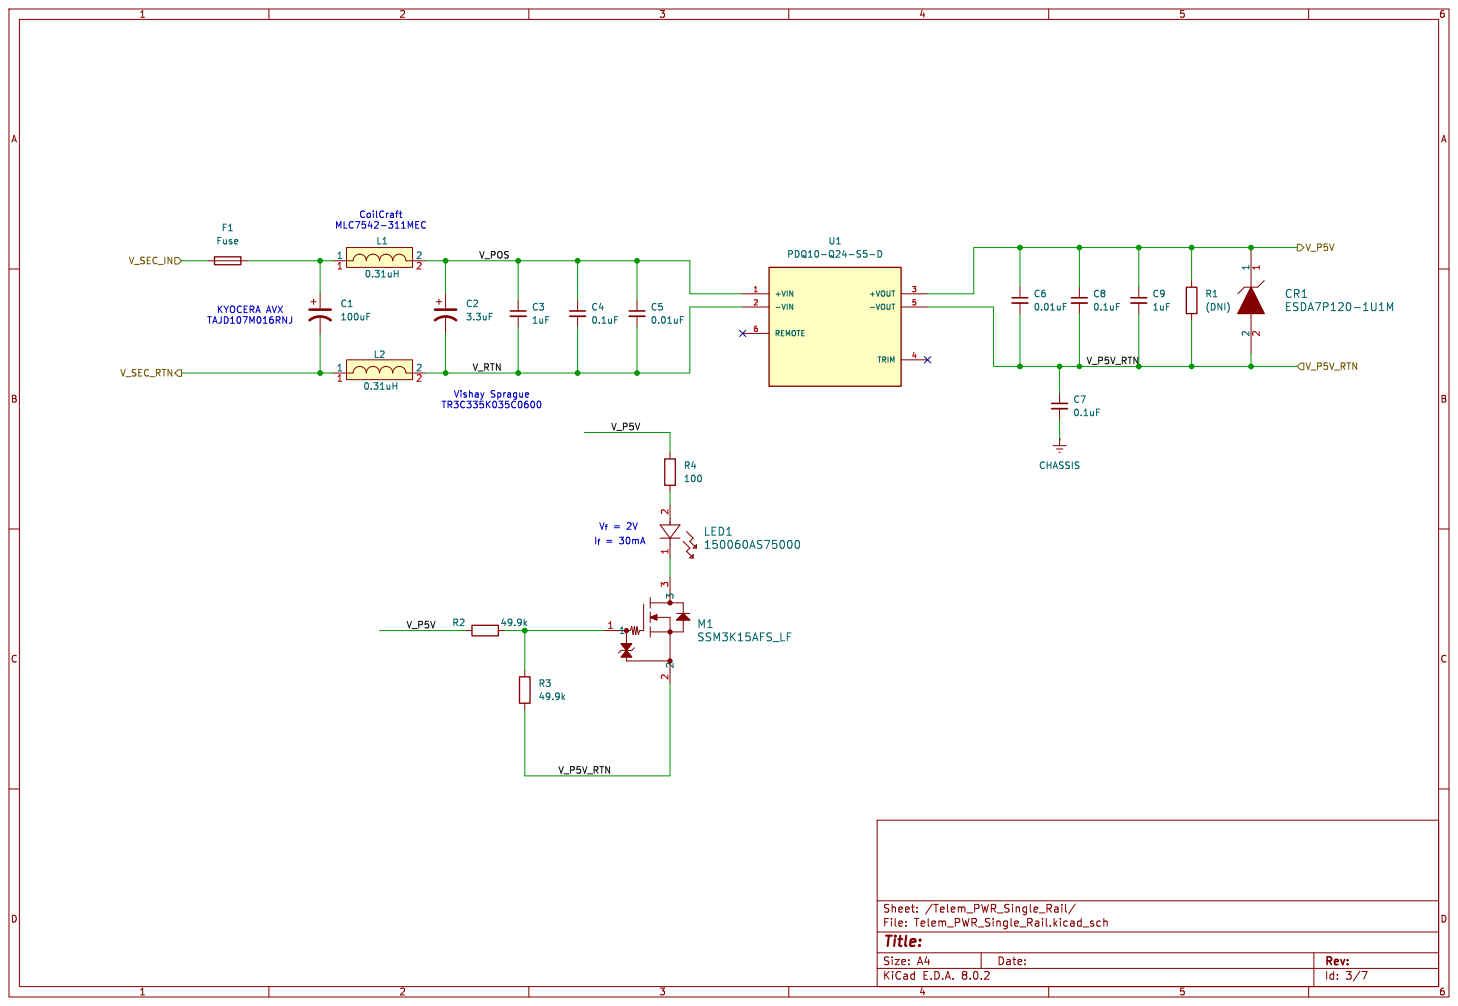
[picture p328: page 3]

Id: 3/7 Title: File: Telem_PWR_Single_Rail.kicad_sch Sheet: /Telem_PWR_Single_Rail/

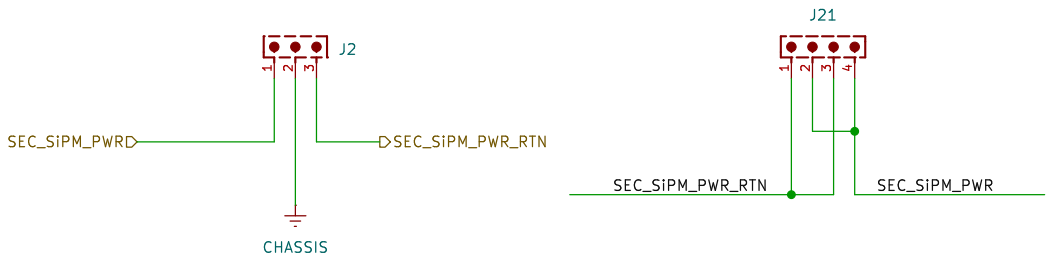
[picture p329: page 4]

Id: 3/7 Title: File: SiPM_PWR.kicad_sch Sheet: /SiPM_PWR/

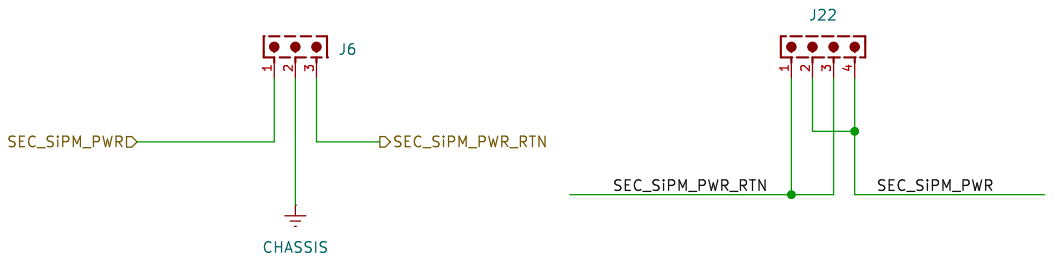
[picture p330: page 5]

Id: 4/7 Title: File: SiPM_PWR.kicad_sch Sheet: /SiPM_PWR2/

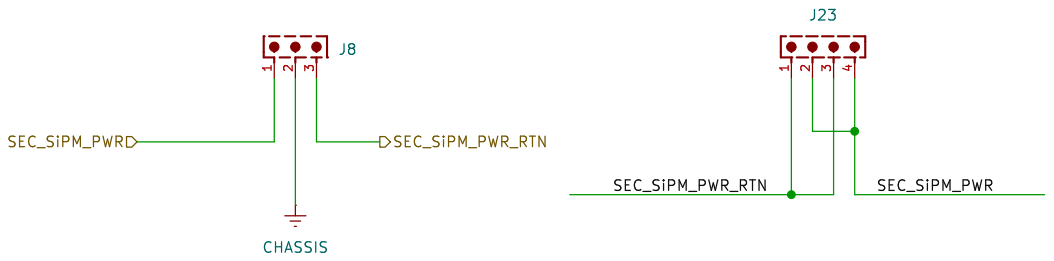
[picture p331: page 6]

Id: 5/7 Title: File: SiPM_PWR.kicad_sch Sheet: /SiPM_PWR3/

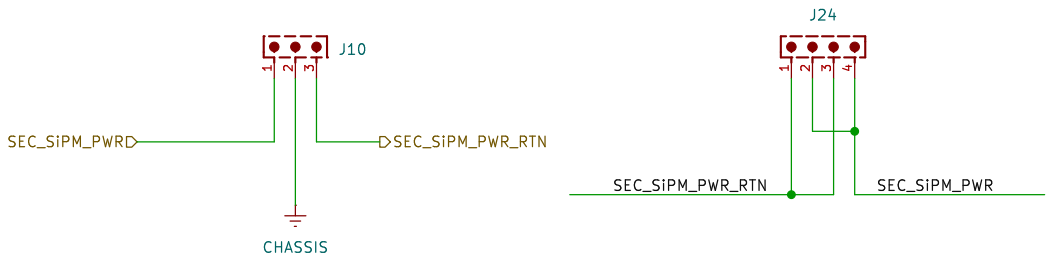
[picture p332: page 7]

Id: 6/7 Title: File: SiPM_PWR.kicad_sch Sheet: /SiPM_PWR4/
