rjridle/GRAMS/2_Schematics_and_Layout/1_COLD_TPC/2_COLD_TPC_SiPM_Bias_PDU/Schematic_PDFs/2_COLD_TPC_SiPM_Bias_PDU.pdf

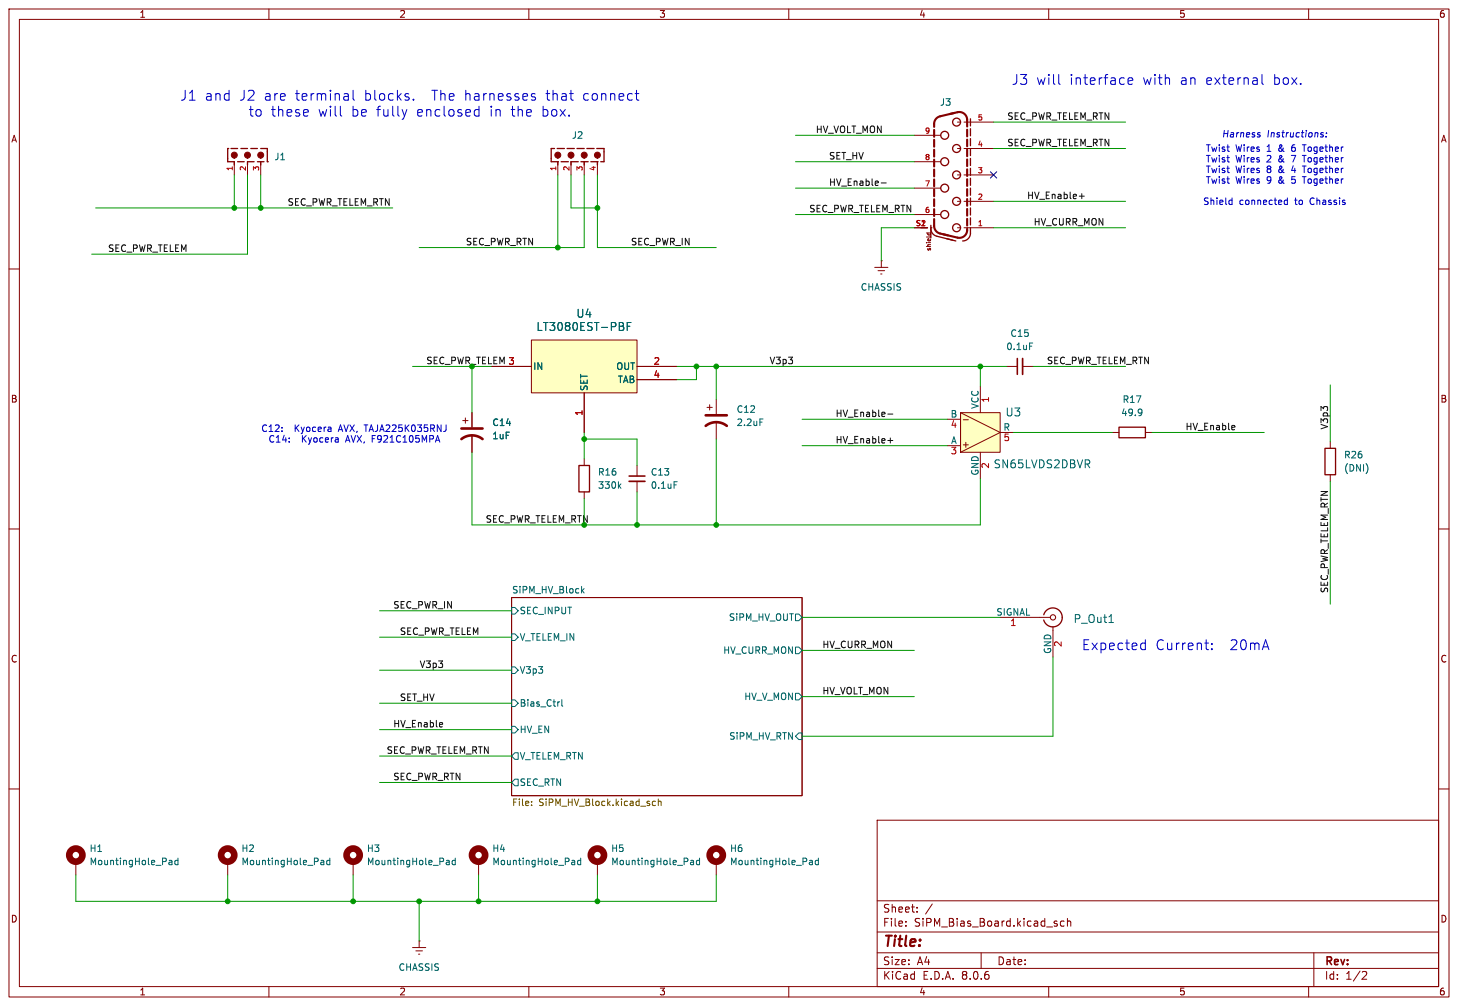
[picture p333: page 1]

Id: 1/2 Title: File: SiPM_Bias_Board.kicad_sch Sheet: / SEC_RTN

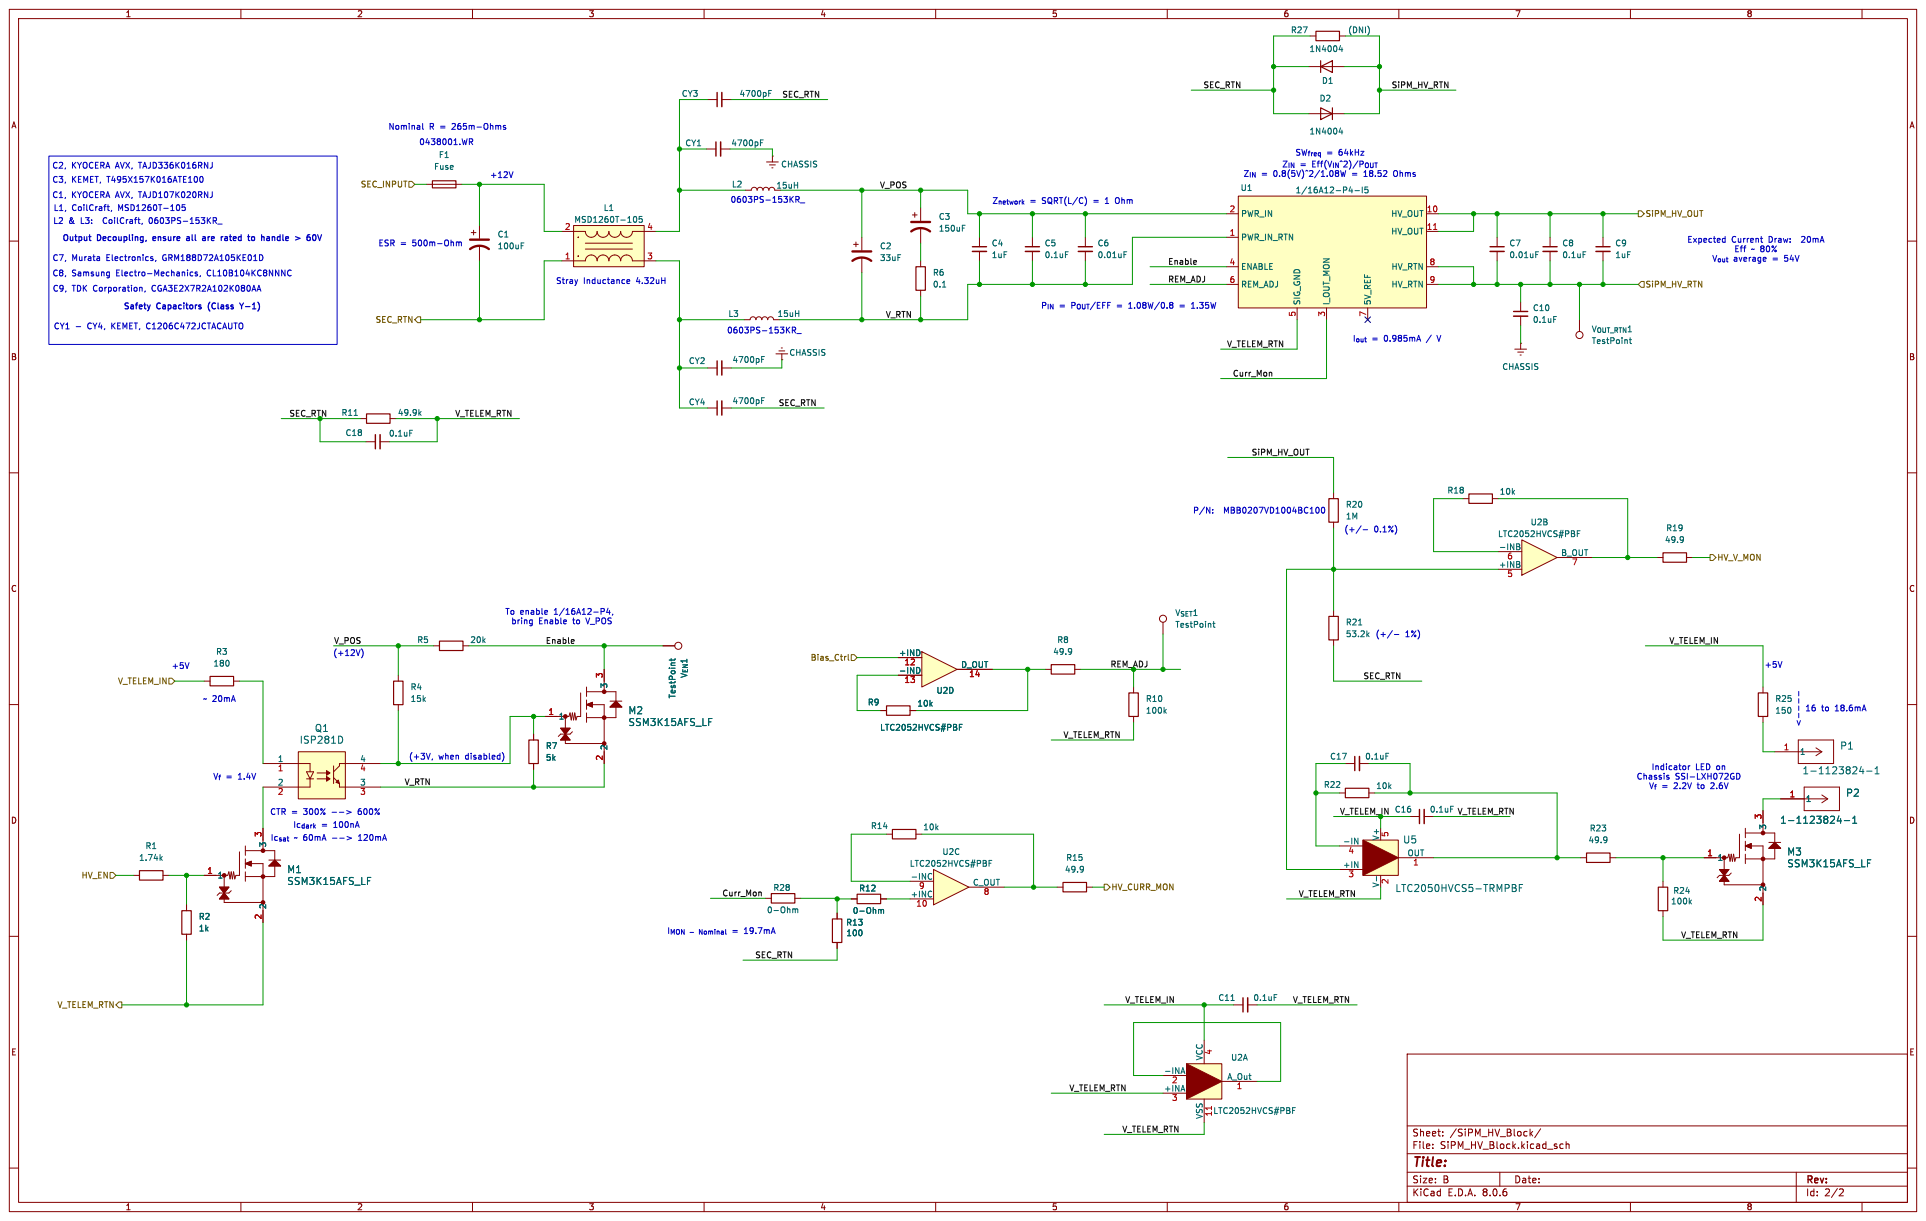
[picture p334: page 2]

Z_{IN}= Eff(V_{IN}^2)/P_{OUT}

Output Decoupling, ensure all are rated to handle > 60V

To enable 1/16A12-P4, bring Enable to V_POS

Id: 2/2 Title: File: SiPM_HV_Block.kicad_sch Sheet: /SiPM_HV_Block/ R7
