rjridle/GRAMS/2_Schematics_and_Layout/1_COLD_TPC/4_COLD_TPC_SiPM_Pre_Amp/Schematics_PDFs/4_COLD_TPC_SiPM_Pre_Amp.pdf

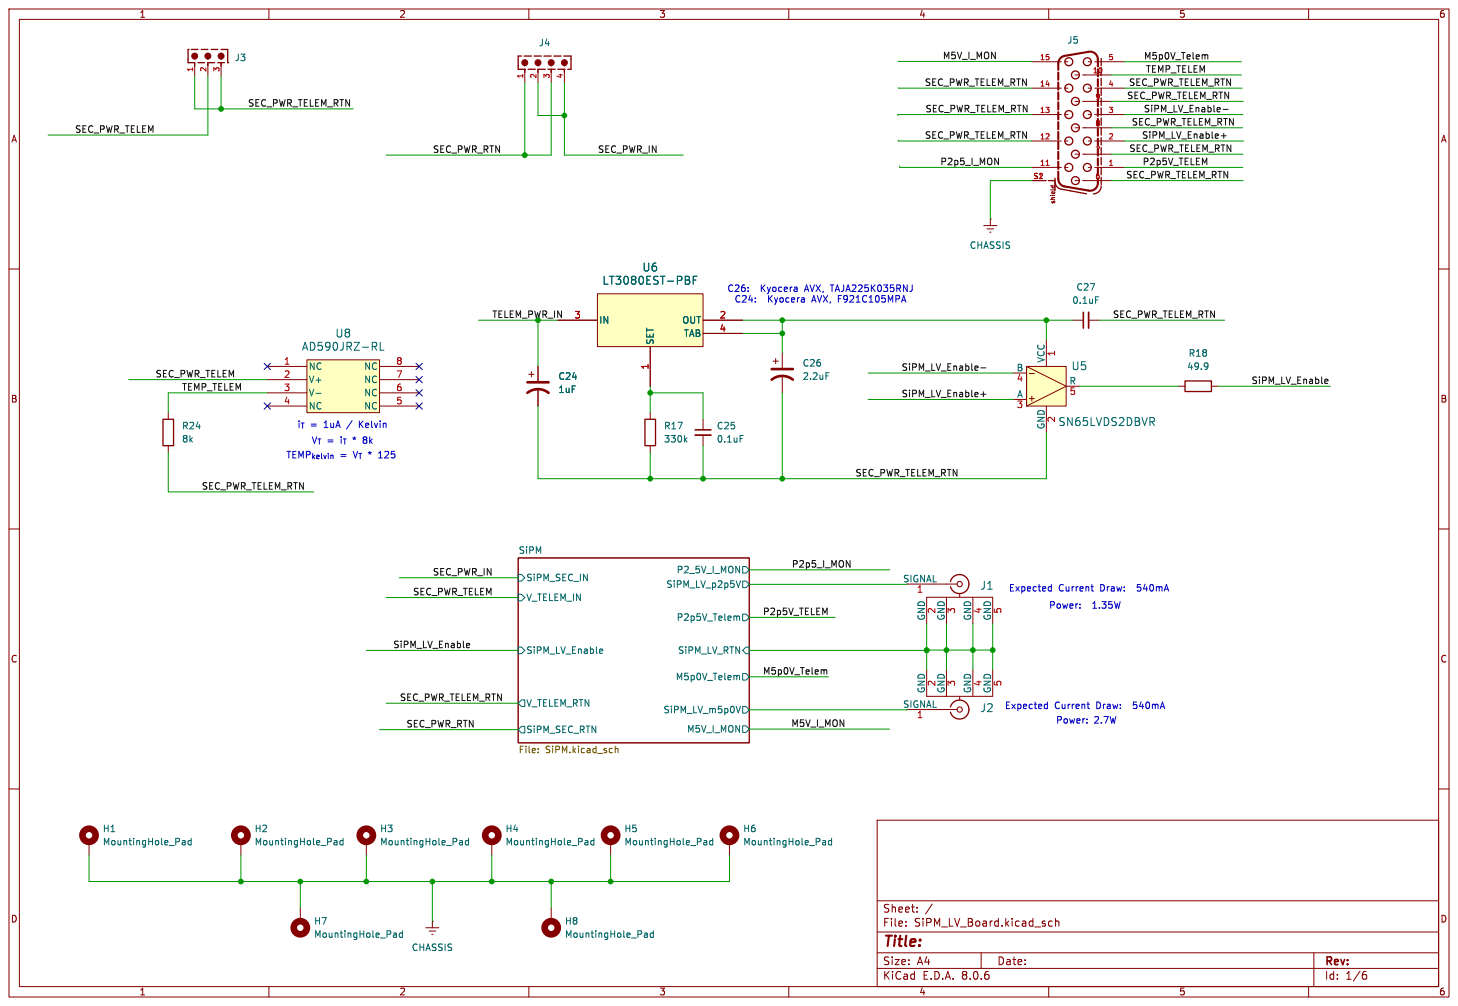
[picture p335: page 1]

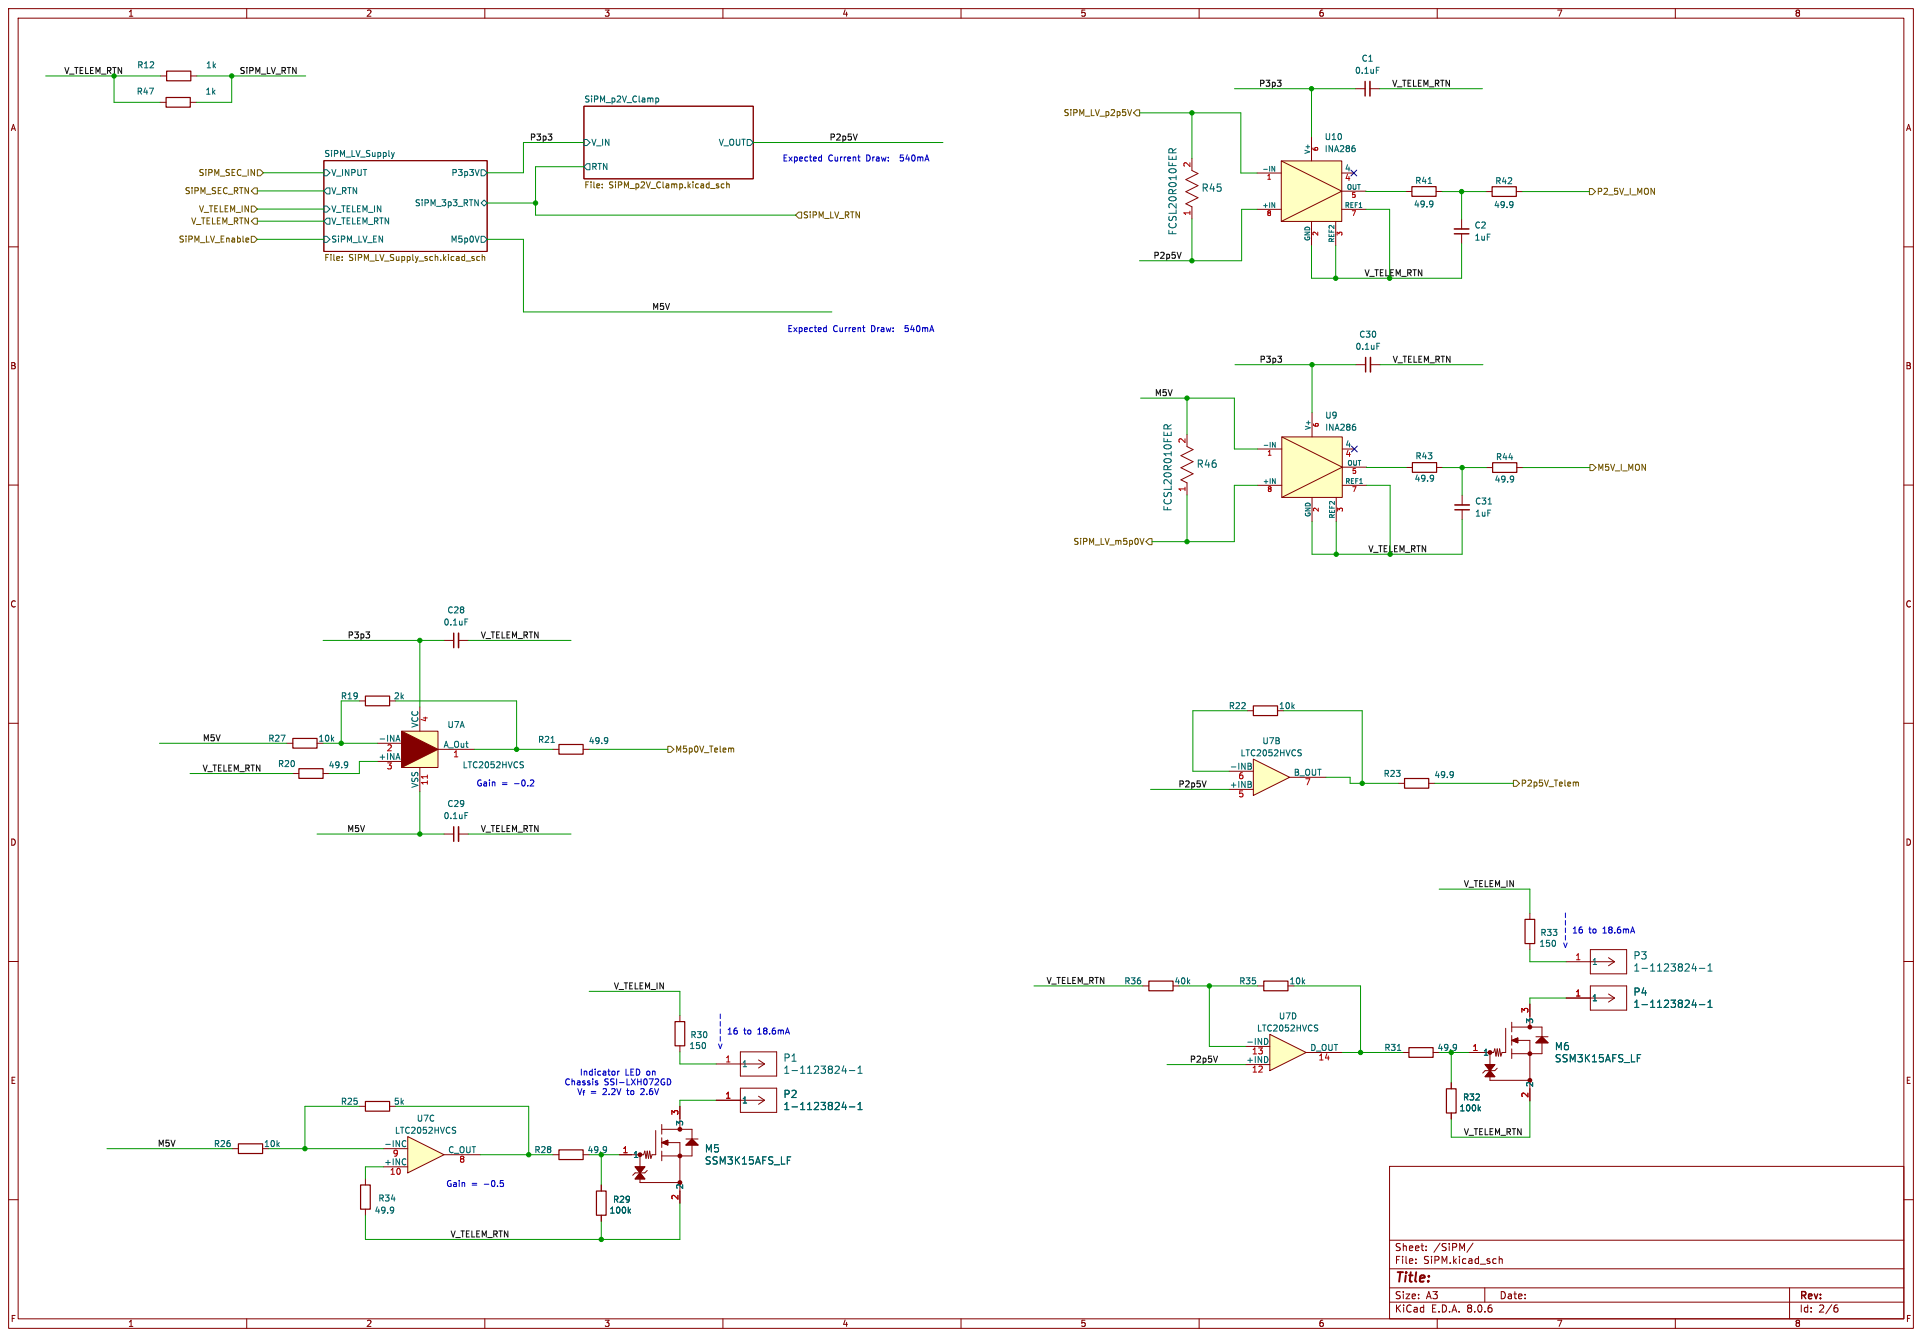
[picture p336: page 2]

Id: 2/6 Title: File: SiPM.kicad_sch Sheet: /SiPM/

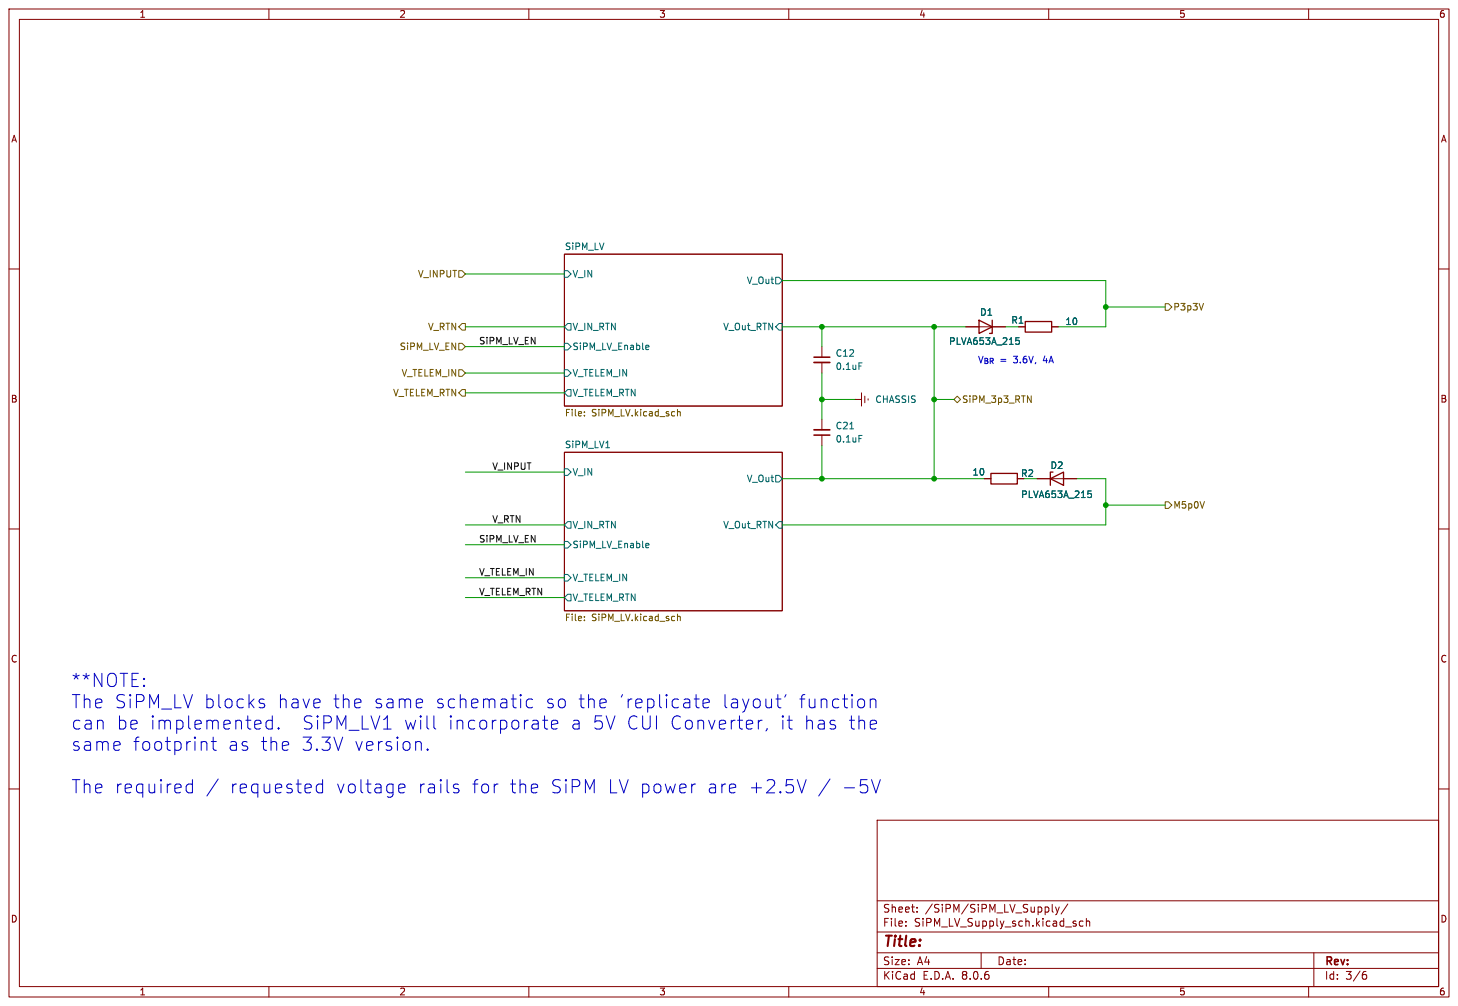
[picture p337: page 3]

Id: 3/6 Title: File: SiPM_LV_Supply_sch.kicad_sch Sheet: /SiPM/SiPM_LV_Supply/

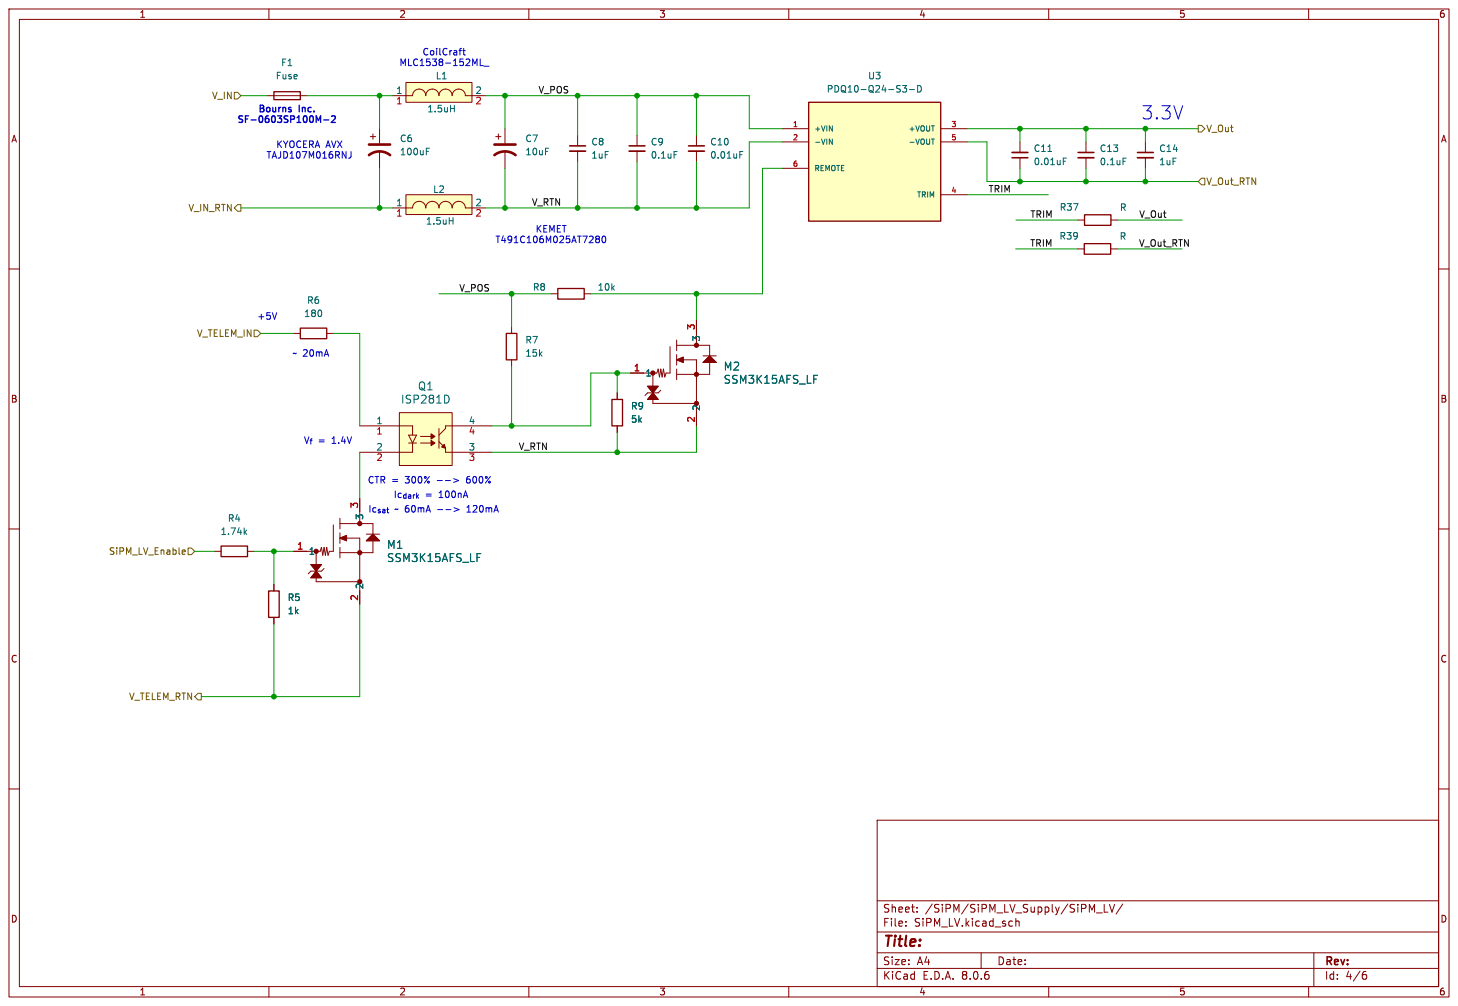
[picture p338: page 4]

Id: 4/6 Title: File: SiPM_LV.kicad_sch Sheet: /SiPM/SiPM_LV_Supply/SiPM_LV/

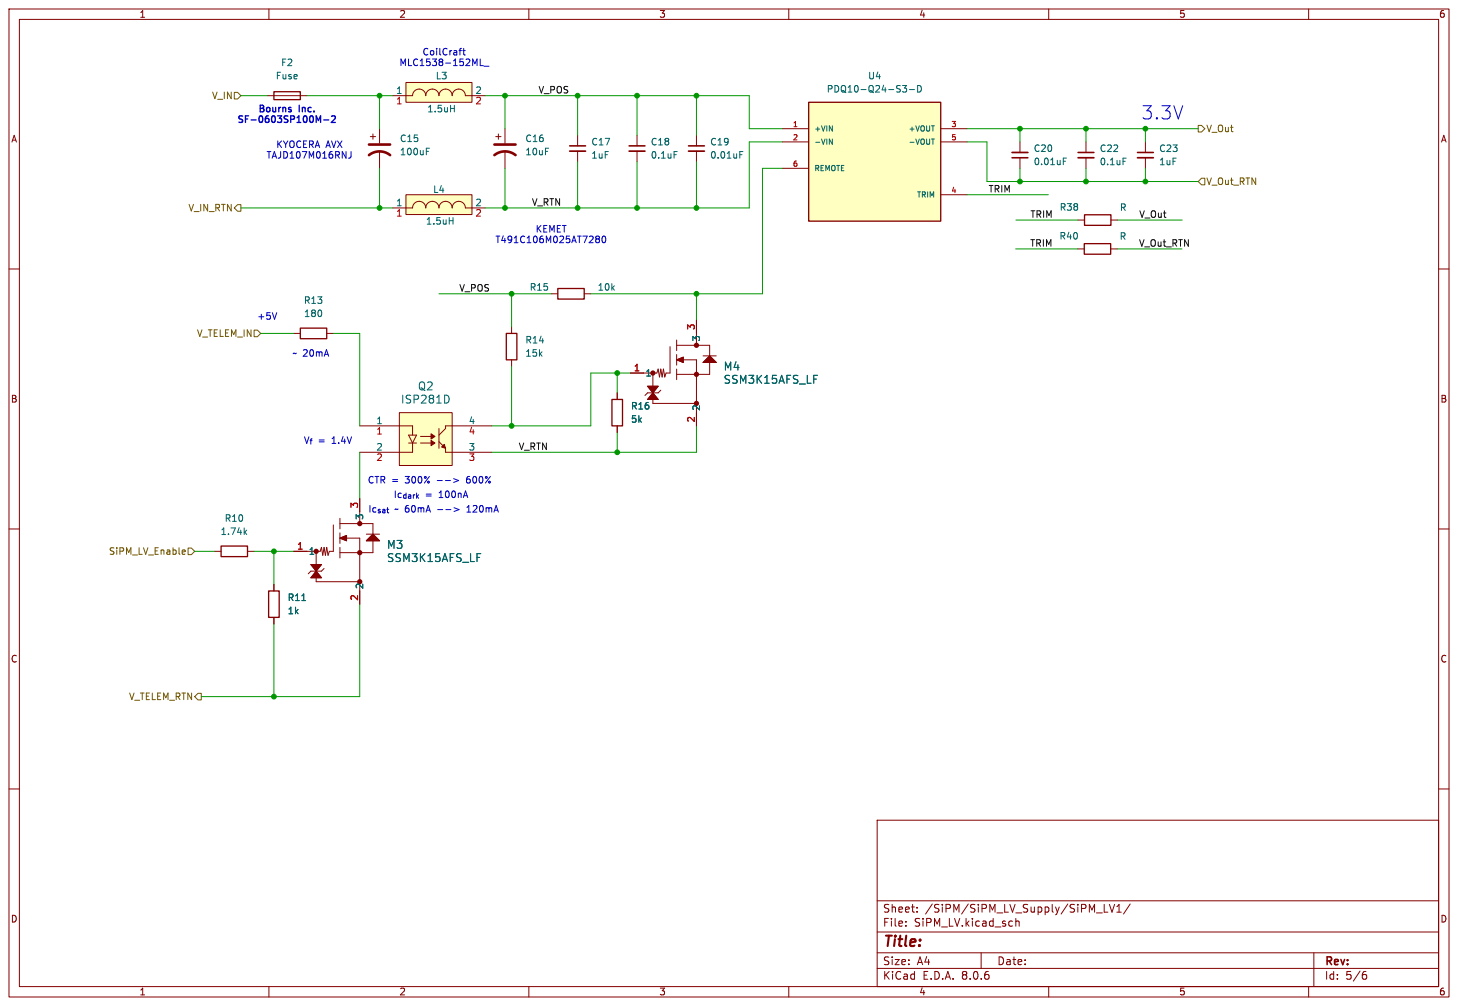
[picture p339: page 5]

Id: 5/6 Title: File: SiPM_LV.kicad_sch Sheet: /SiPM/SiPM_LV_Supply/SiPM_LV1/

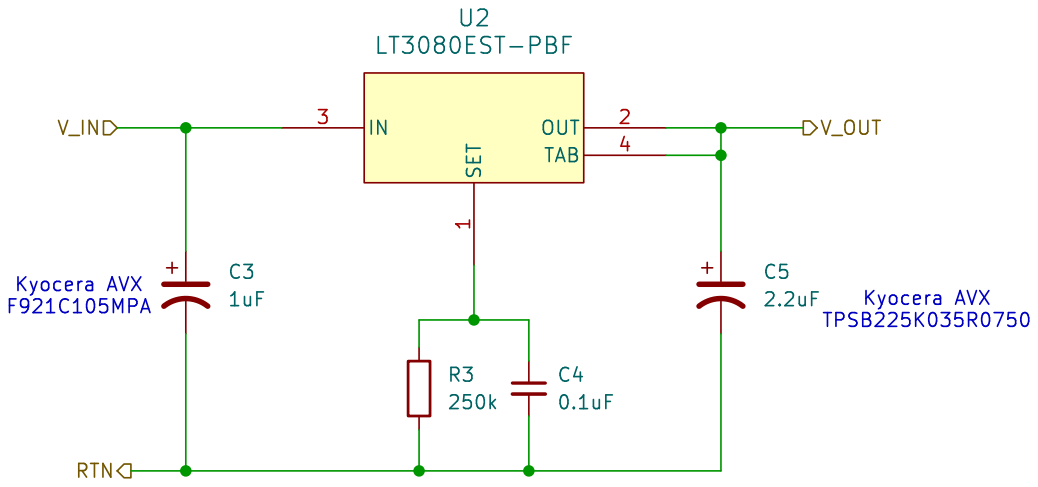
[picture p340: page 6]

1 OUT 2
Id: 7/6 Title: File: SiPM_p2V_Clamp.kicad_sch Sheet: /SiPM/SiPM_p2V_Clamp/ SET
