rjridle/GRAMS/2_Schematics_and_Layout/100_GSE/GRAMS-GSE-BRD/GRAMS-GSE-BRD/Schematic_PDF/GRAMS-GSE-BRD_11-FEB-25.pdf

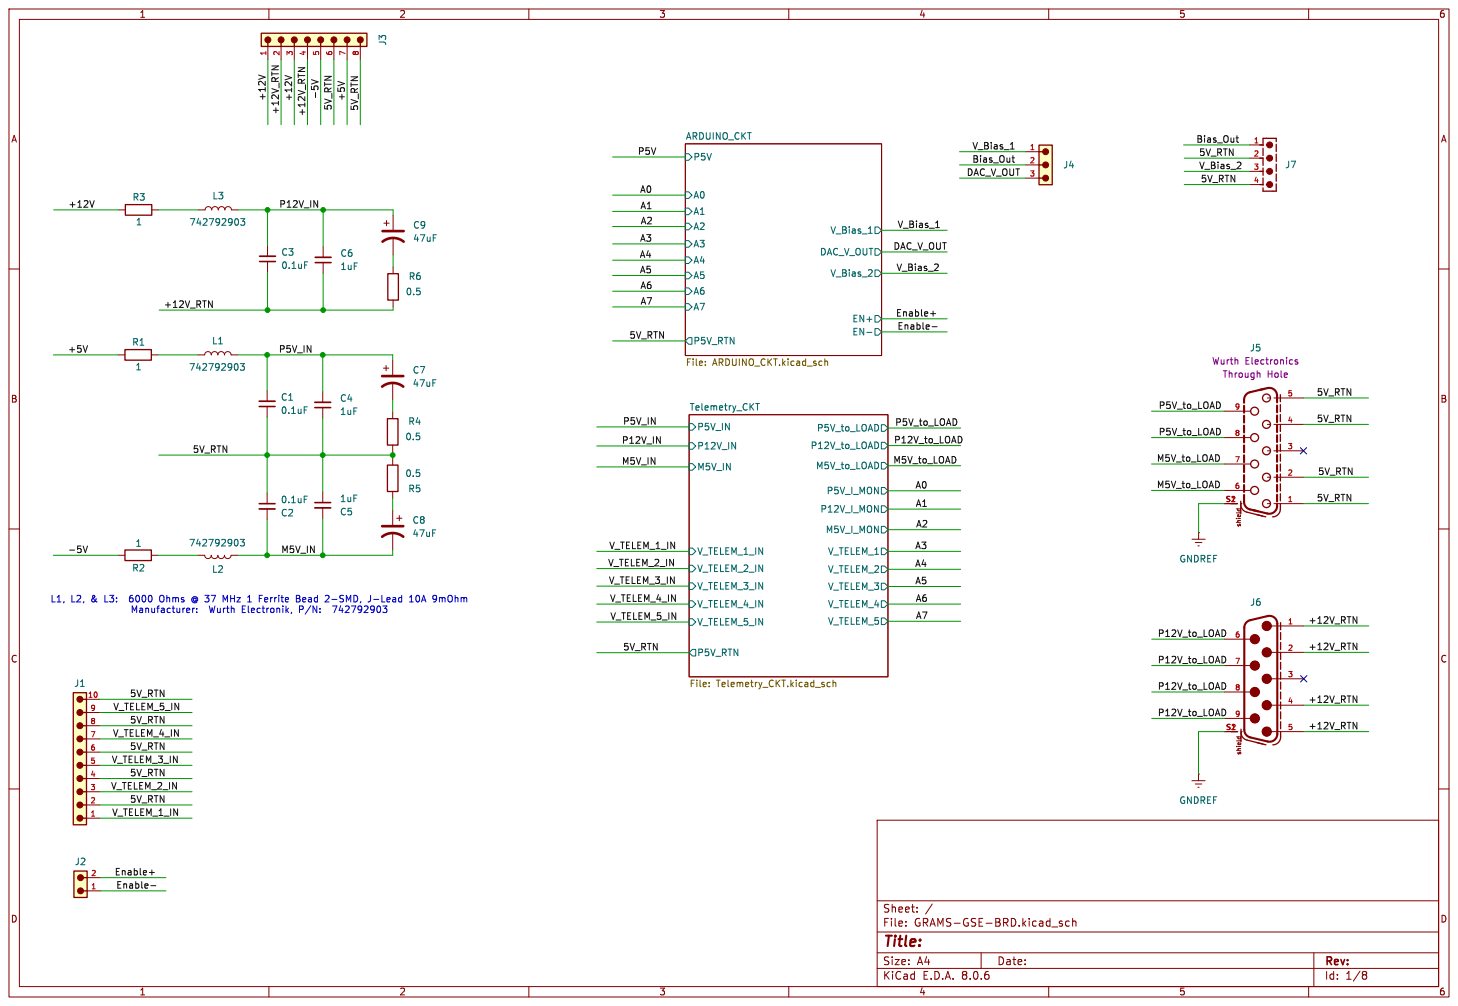
[picture p341: page 1]

Id: 1/8 Title: File: GRAMS-GSE-BRD.kicad_sch Sheet: /

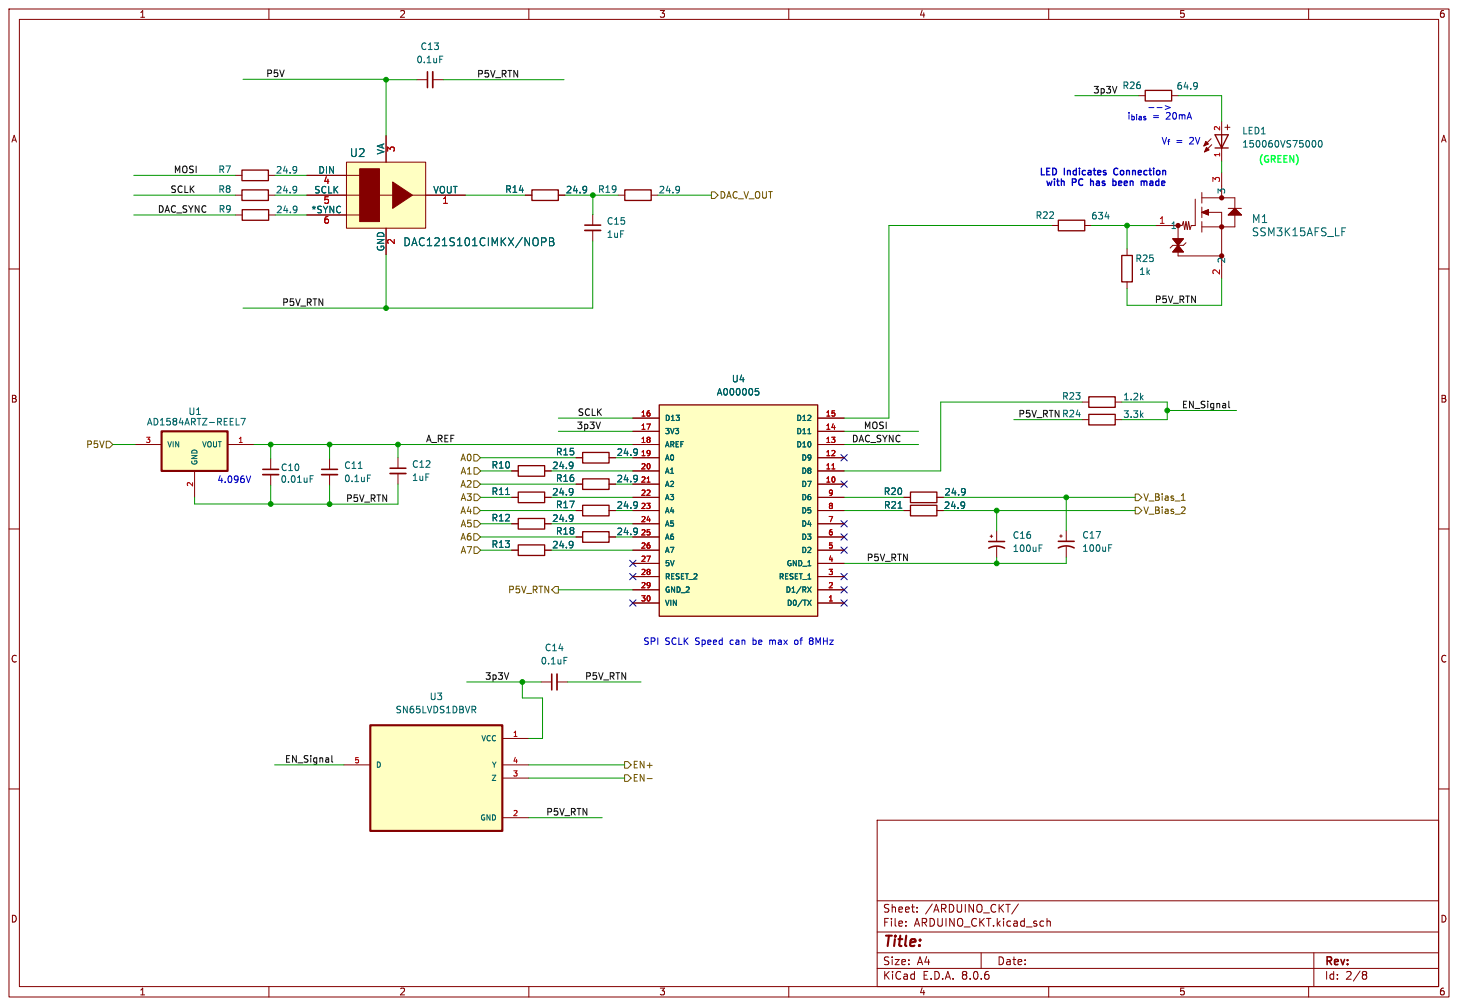
[picture p342: page 2]

SPI SCLK Speed can be max of 8MHz

Id: 2/8 Title: File: ARDUINO_CKT.kicad_sch Sheet: /ARDUINO_CKT/

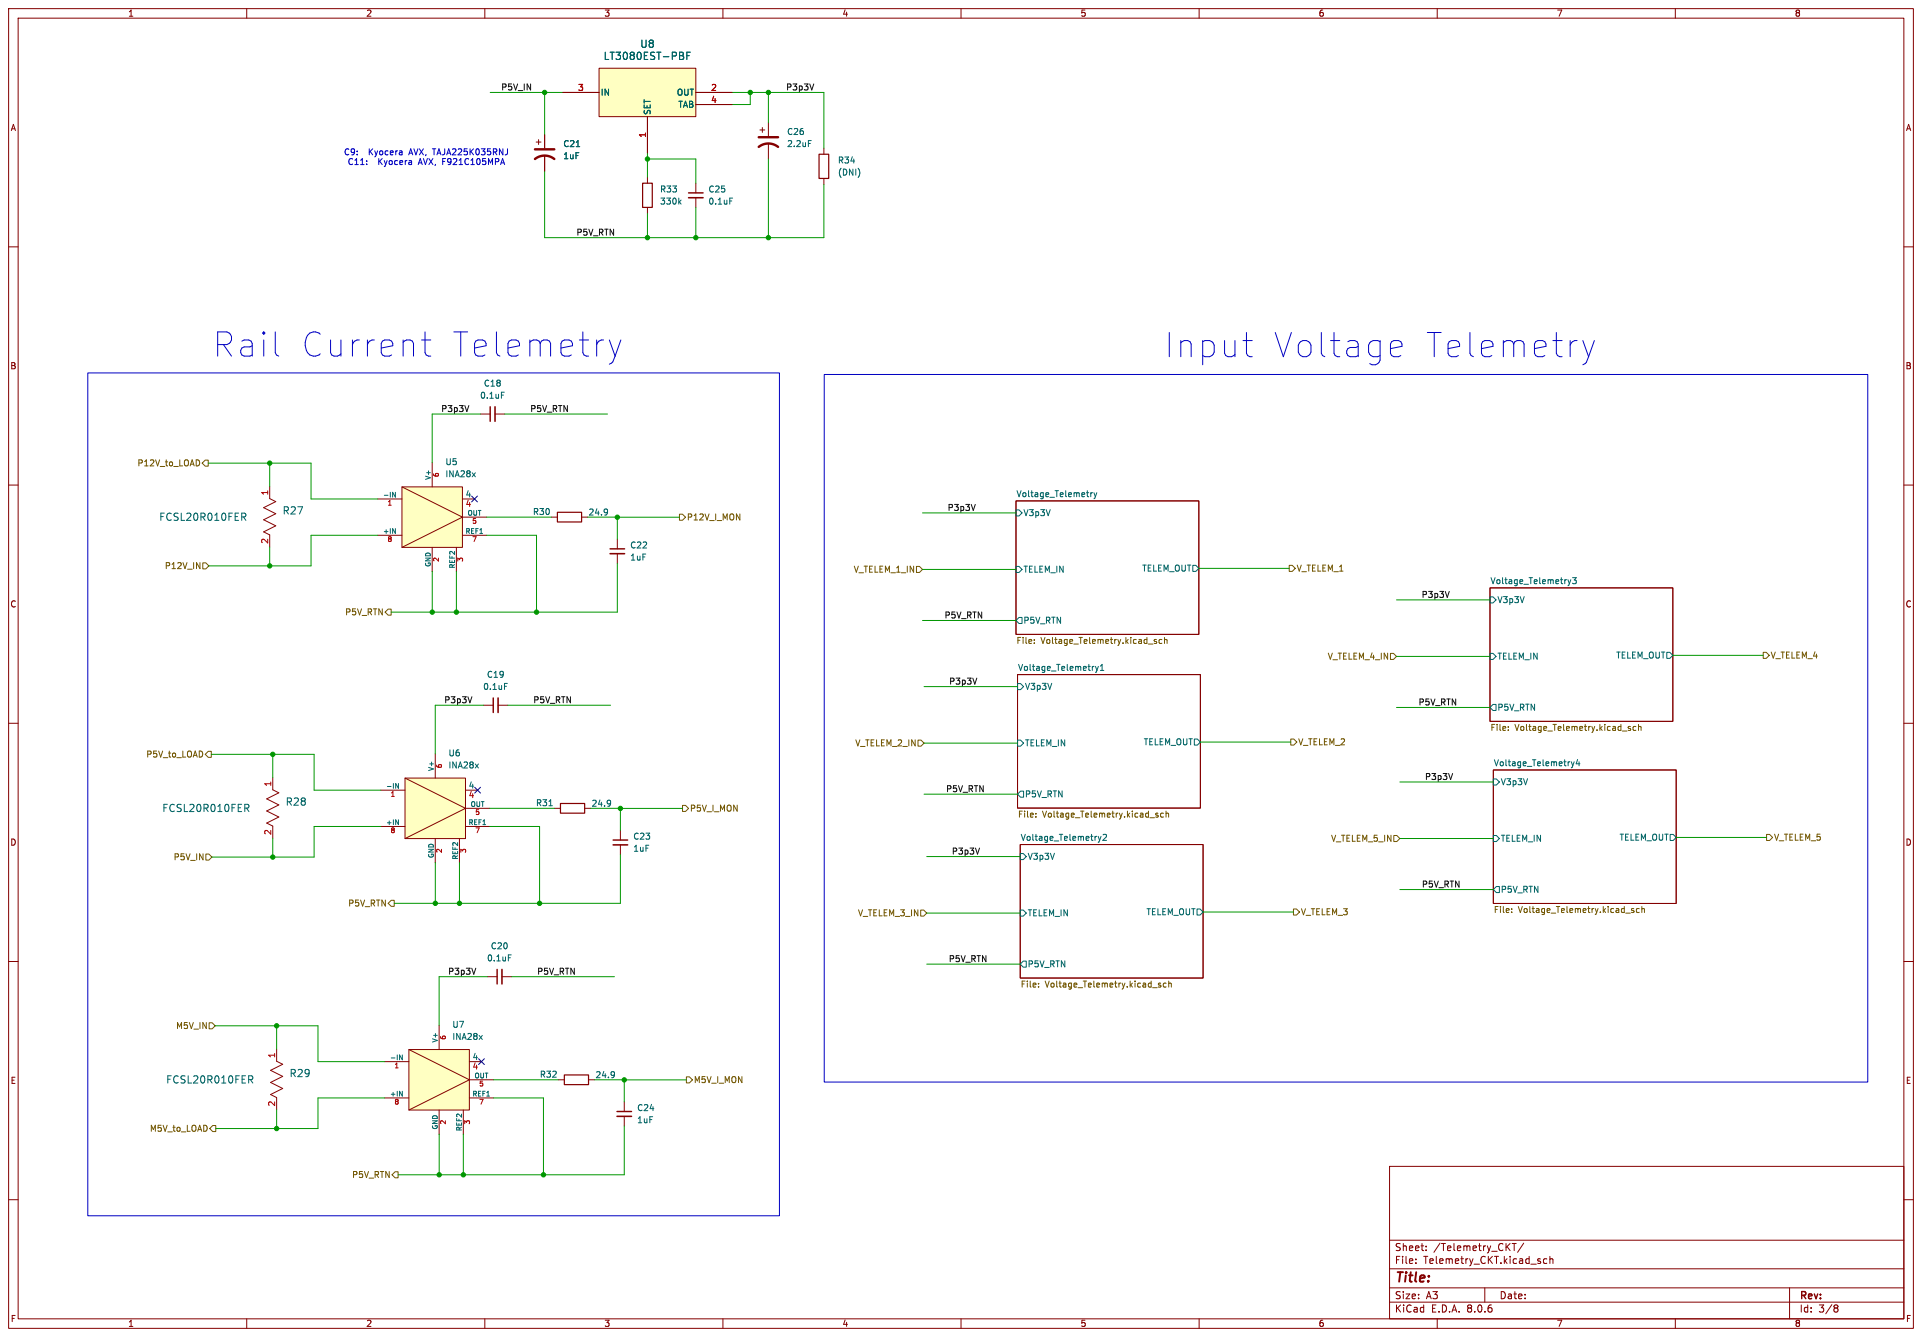
[picture p343: page 3]

Id: 3/8 Title: File: Telemetry_CKT.kicad_sch Sheet: /Telemetry_CKT/

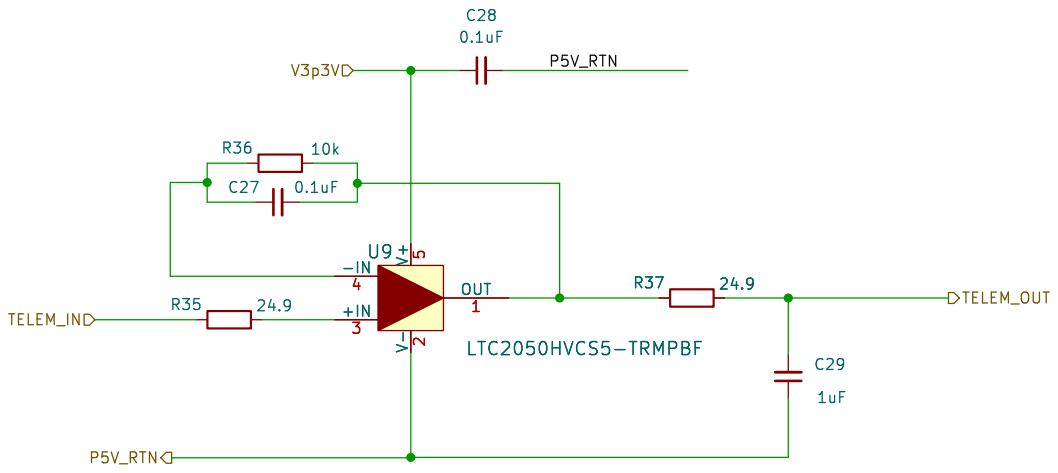
[picture p344: page 4]

Id: 4/8 Title: File: Voltage_Telemetry.kicad_sch Sheet: /Telemetry_CKT/Voltage_Telemetry/

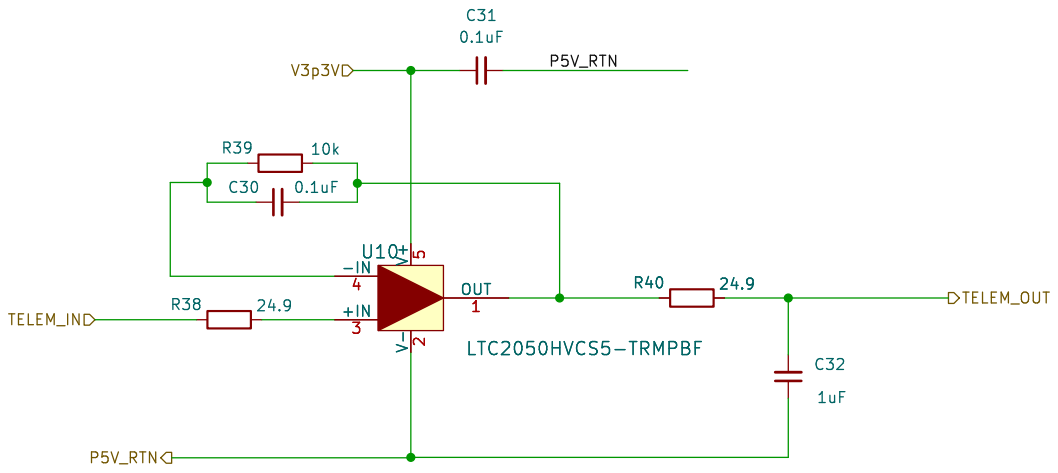
[picture p345: page 5]

Id: 5/8 Title: File: Voltage_Telemetry.kicad_sch Sheet: /Telemetry_CKT/Voltage_Telemetry1/

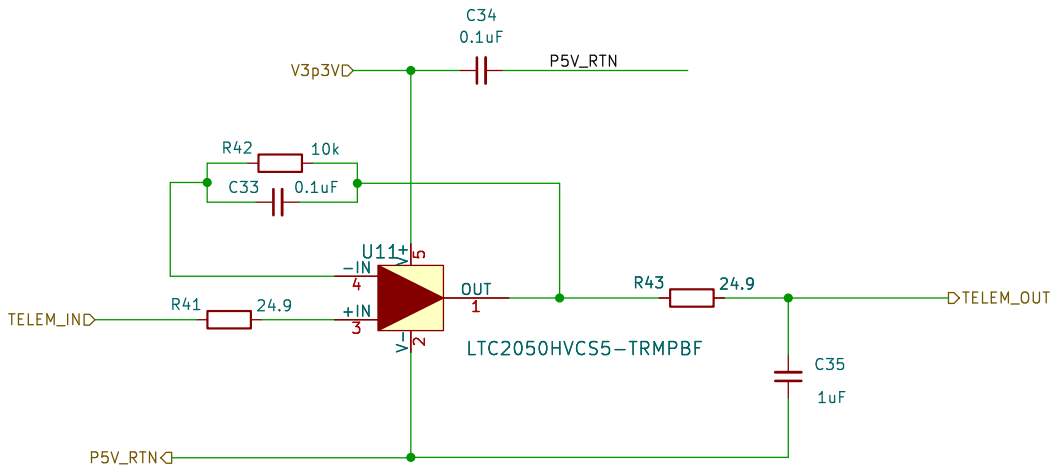
[picture p346: page 6]

Id: 6/8 Title: File: Voltage_Telemetry.kicad_sch Sheet: /Telemetry_CKT/Voltage_Telemetry2/

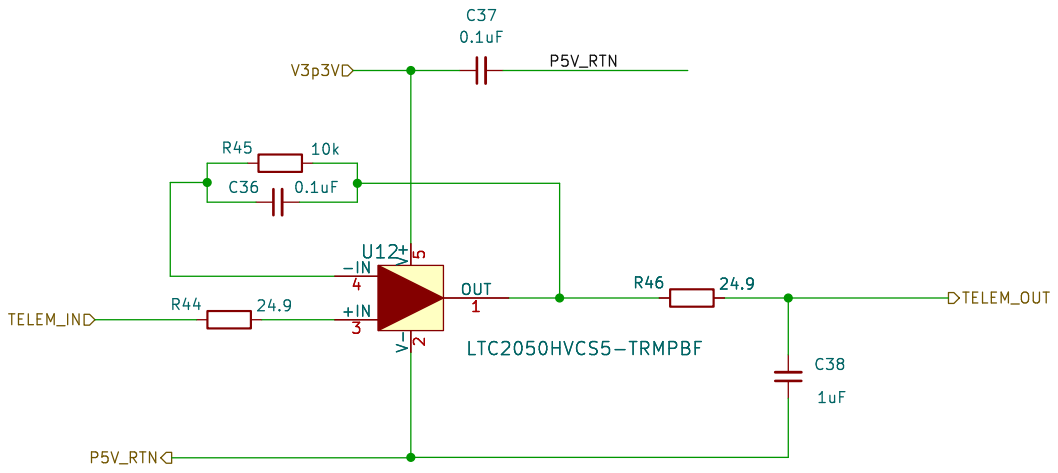
[picture p347: page 7]

Id: 7/8 Title: File: Voltage_Telemetry.kicad_sch Sheet: /Telemetry_CKT/Voltage_Telemetry3/

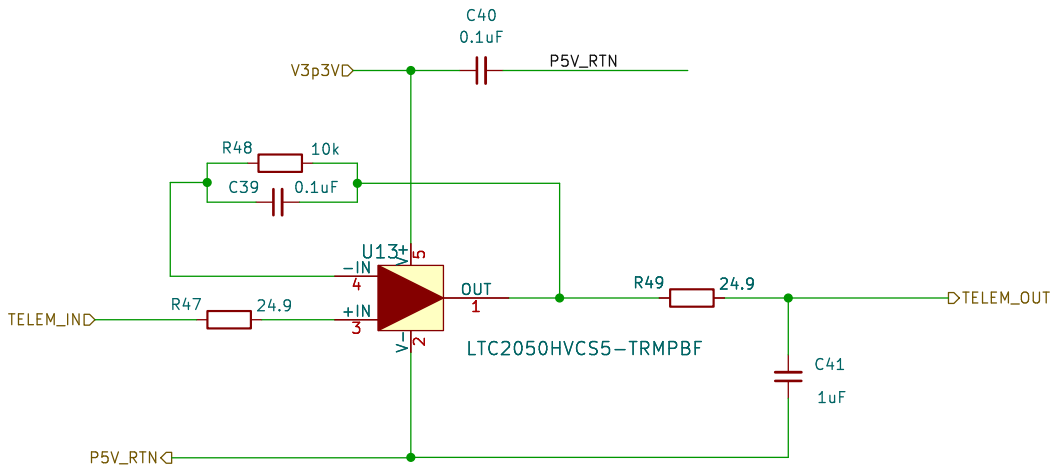
[picture p348: page 8]

Id: 8/8 Title: File: Voltage_Telemetry.kicad_sch Sheet: /Telemetry_CKT/Voltage_Telemetry4/
