rjridle/GRAMS/2_Schematics_and_Layout/1_COLD_TPC/1_COLD_TPC_SiPM_and_Telem_PDU/Schematics_PDFs/Version -/1_COLD_TPC_SiPM_and_Telem_PDU.pdf

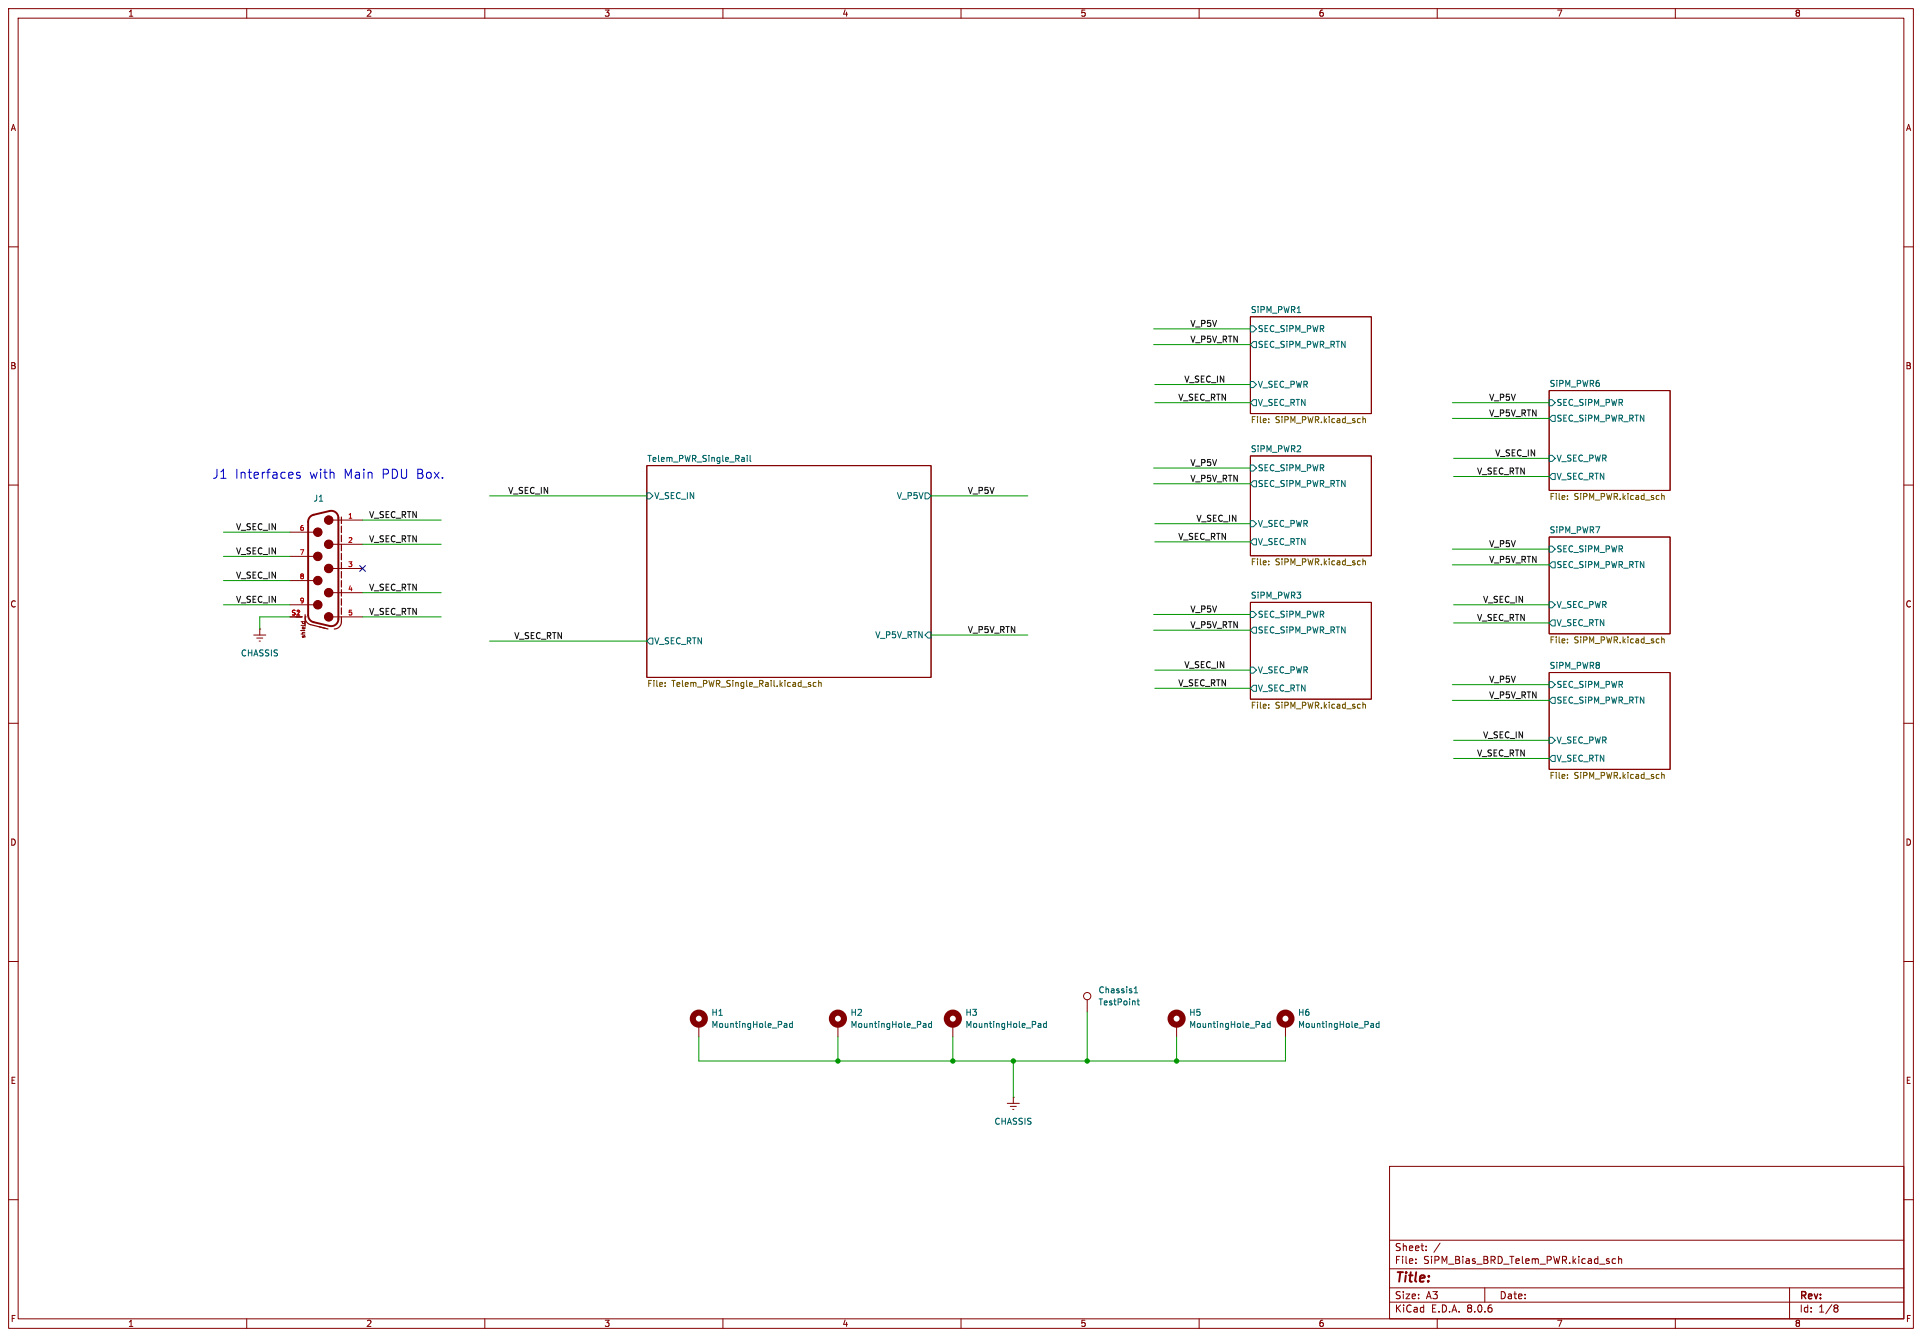
[picture p349: page 1]

Id: 1/8 Title: File: SiPM_Bias_BRD_Telem_PWR.kicad_sch Sheet: /

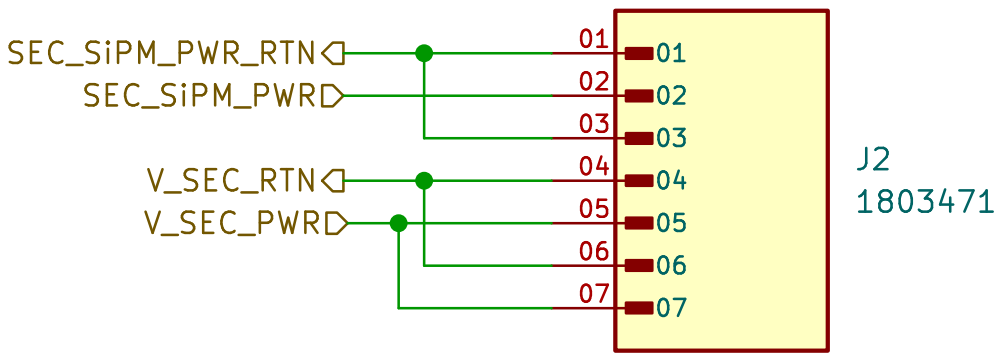
[picture p350: page 2]

Id: 2/8 Title: File: SiPM_PWR.kicad_sch Sheet: /SiPM_PWR1/

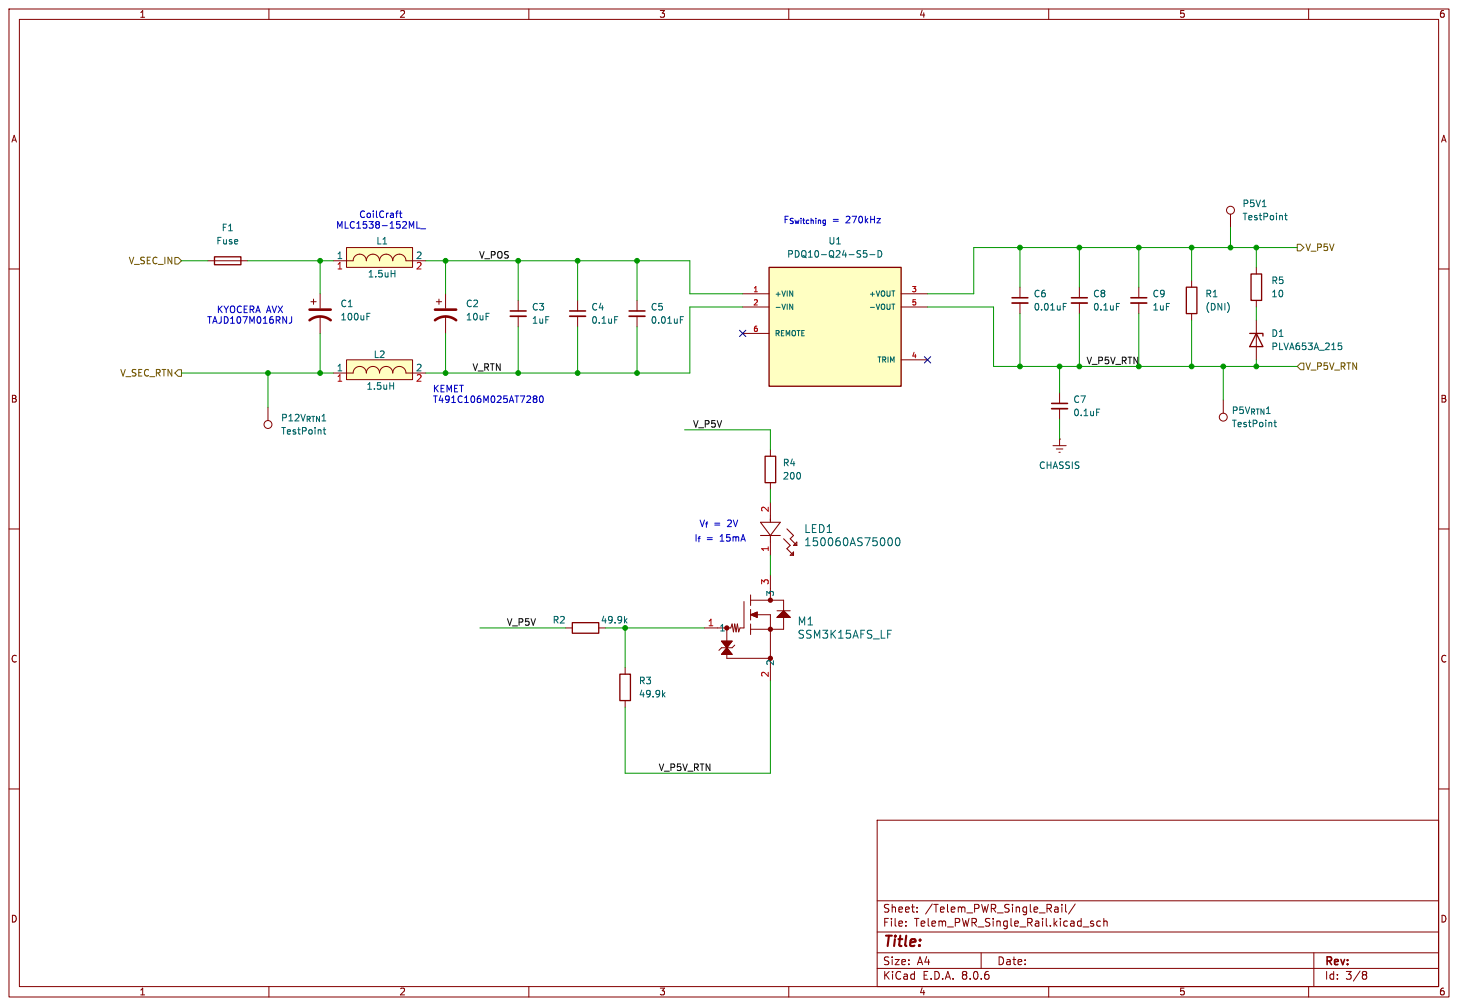
[picture p351: page 3]

Id: 3/8 Title: File: Telem_PWR_Single_Rail.kicad_sch Sheet: /Telem_PWR_Single_Rail/ R3

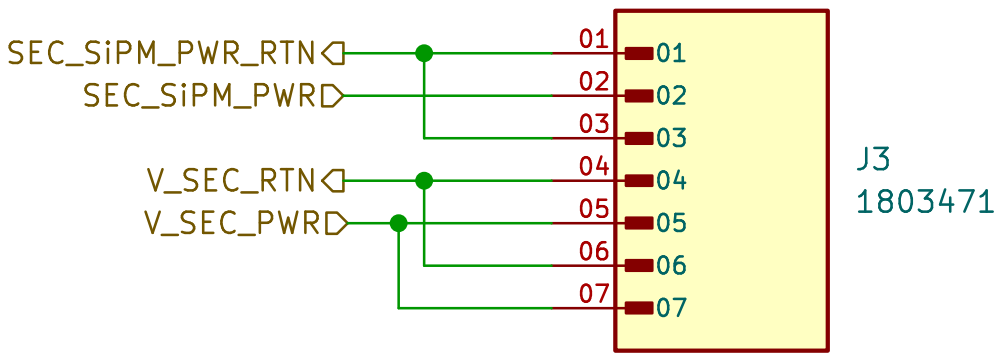
[picture p352: page 4]

Id: 4/8 Title: File: SiPM_PWR.kicad_sch Sheet: /SiPM_PWR2/

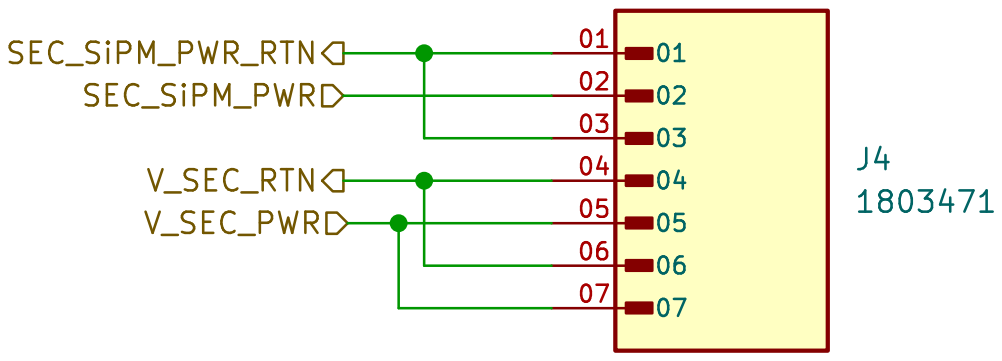
[picture p353: page 5]

Id: 5/8 Title: File: SiPM_PWR.kicad_sch Sheet: /SiPM_PWR3/

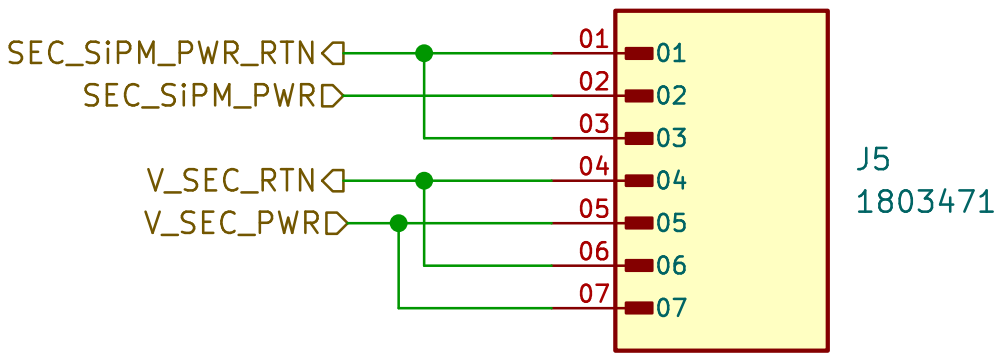
[picture p354: page 6]

Id: 8/8 Title: File: SiPM_PWR.kicad_sch Sheet: /SiPM_PWR6/

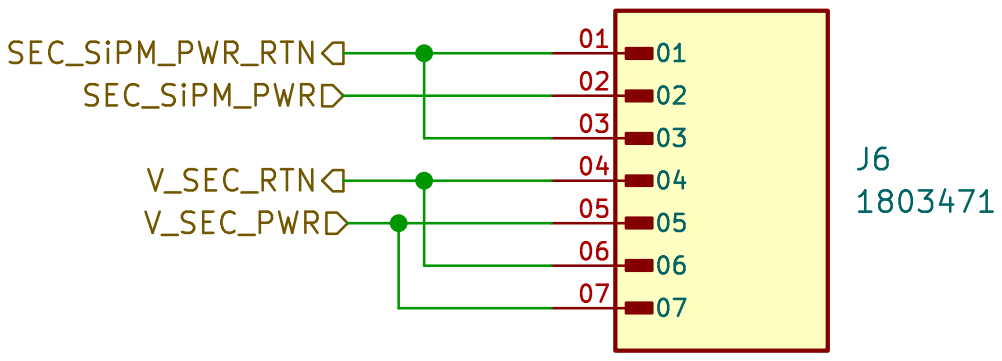
[picture p355: page 7]

Id: 9/8 Title: File: SiPM_PWR.kicad_sch Sheet: /SiPM_PWR7/

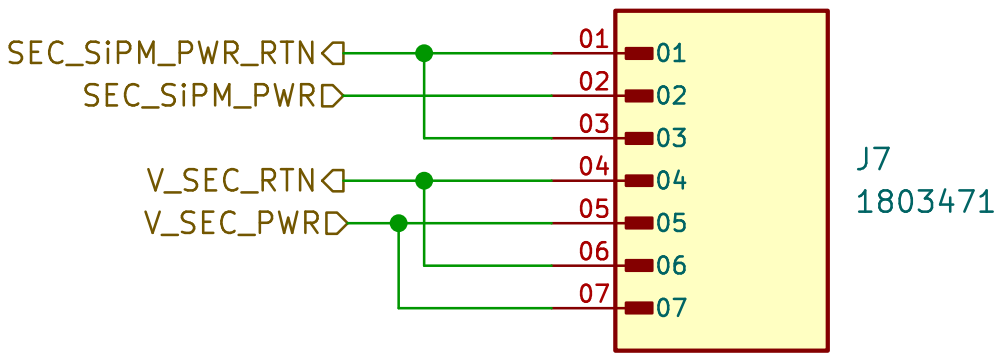
[picture p356: page 8]

Id: 10/8 Title: File: SiPM_PWR.kicad_sch Sheet: /SiPM_PWR8/
