rjridle/GRAMS/2_Schematics_and_Layout/1_COLD_TPC/2_COLD_TPC_SiPM_Bias_PDU/Schematic_PDFs/Version -/2_COLD_TPC_SiPM_Bias_PDU.pdf

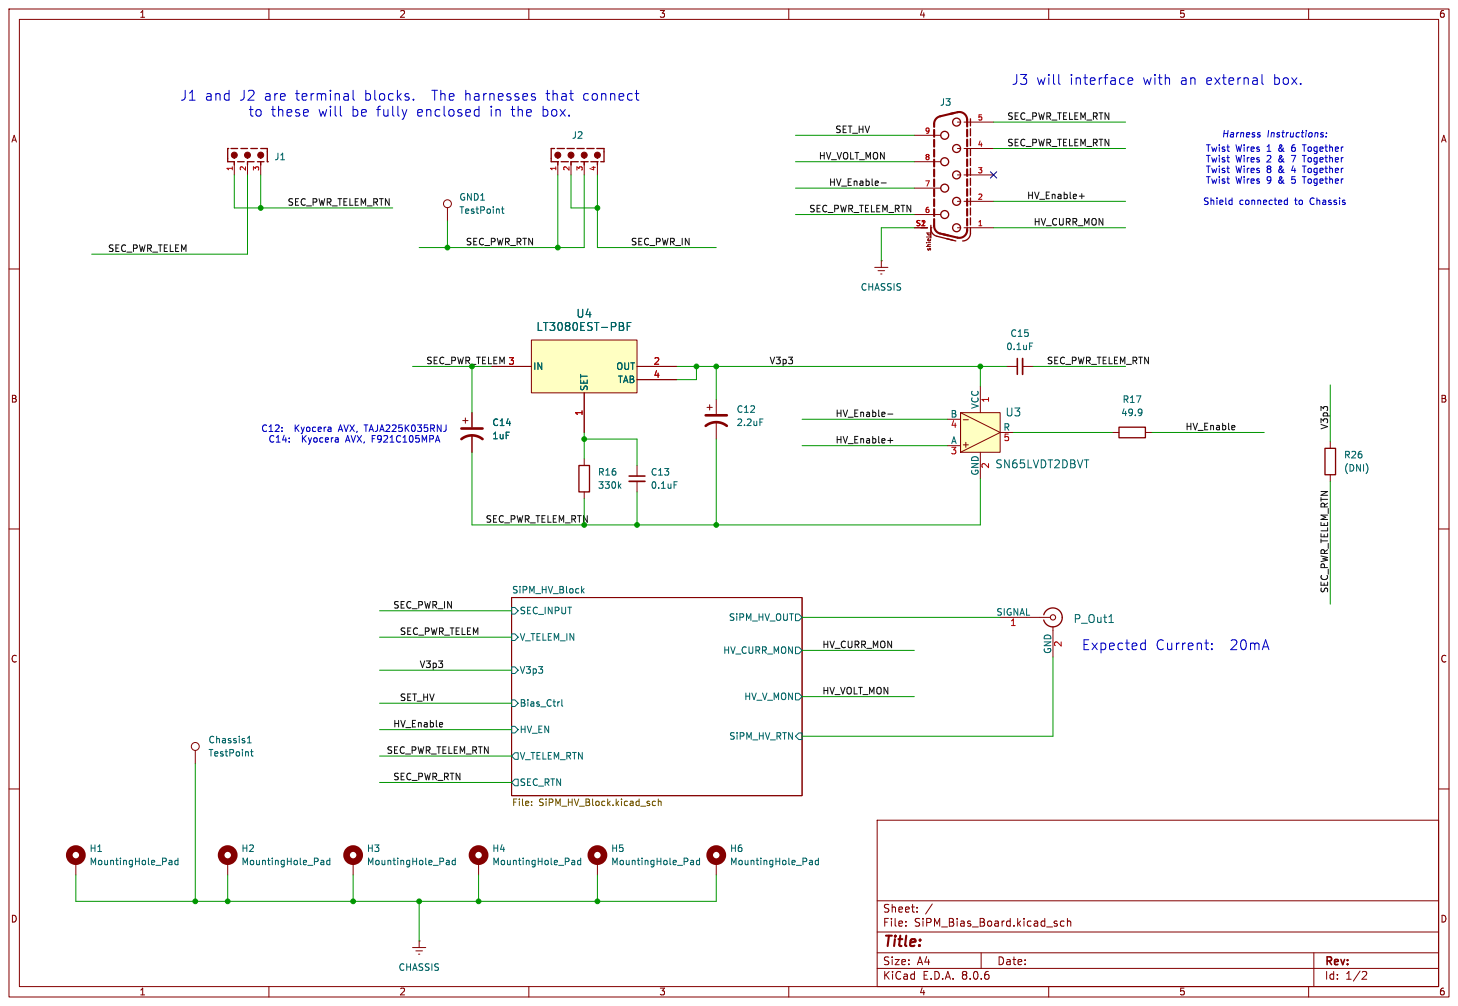
[picture p357: page 1]

Id: 1/2 Title: File: SiPM_Bias_Board.kicad_sch Sheet: / SEC_RTN

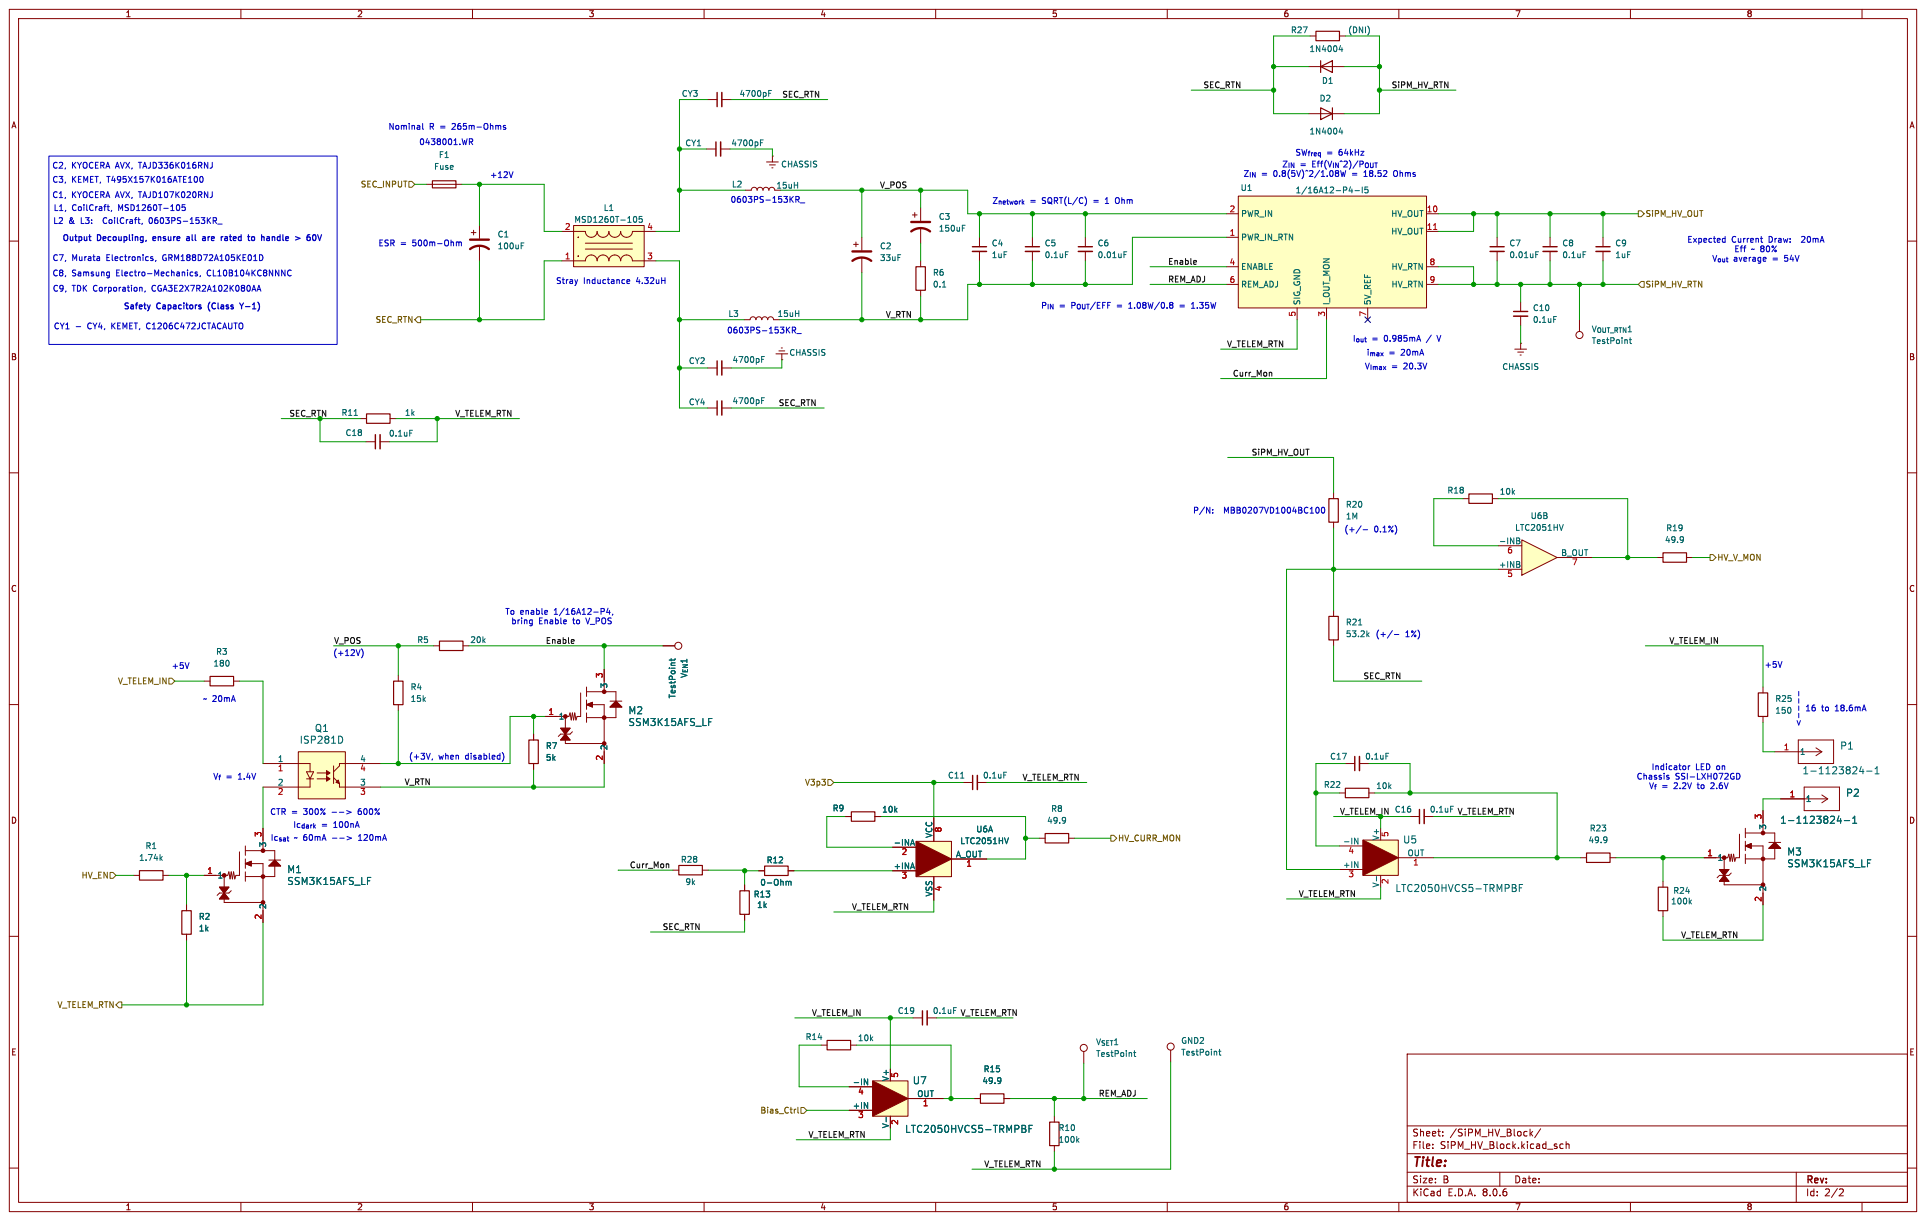
[picture p358: page 2]

Id: 2/2 Title: File: SiPM_HV_Block.kicad_sch Sheet: /SiPM_HV_Block/ R1
