rjridle/GRAMS/2_Schematics_and_Layout/1_COLD_TPC/6_COLD_TPC_HV/Schematic_PDF/January_2025/6_COLD_TPC_HV.pdf

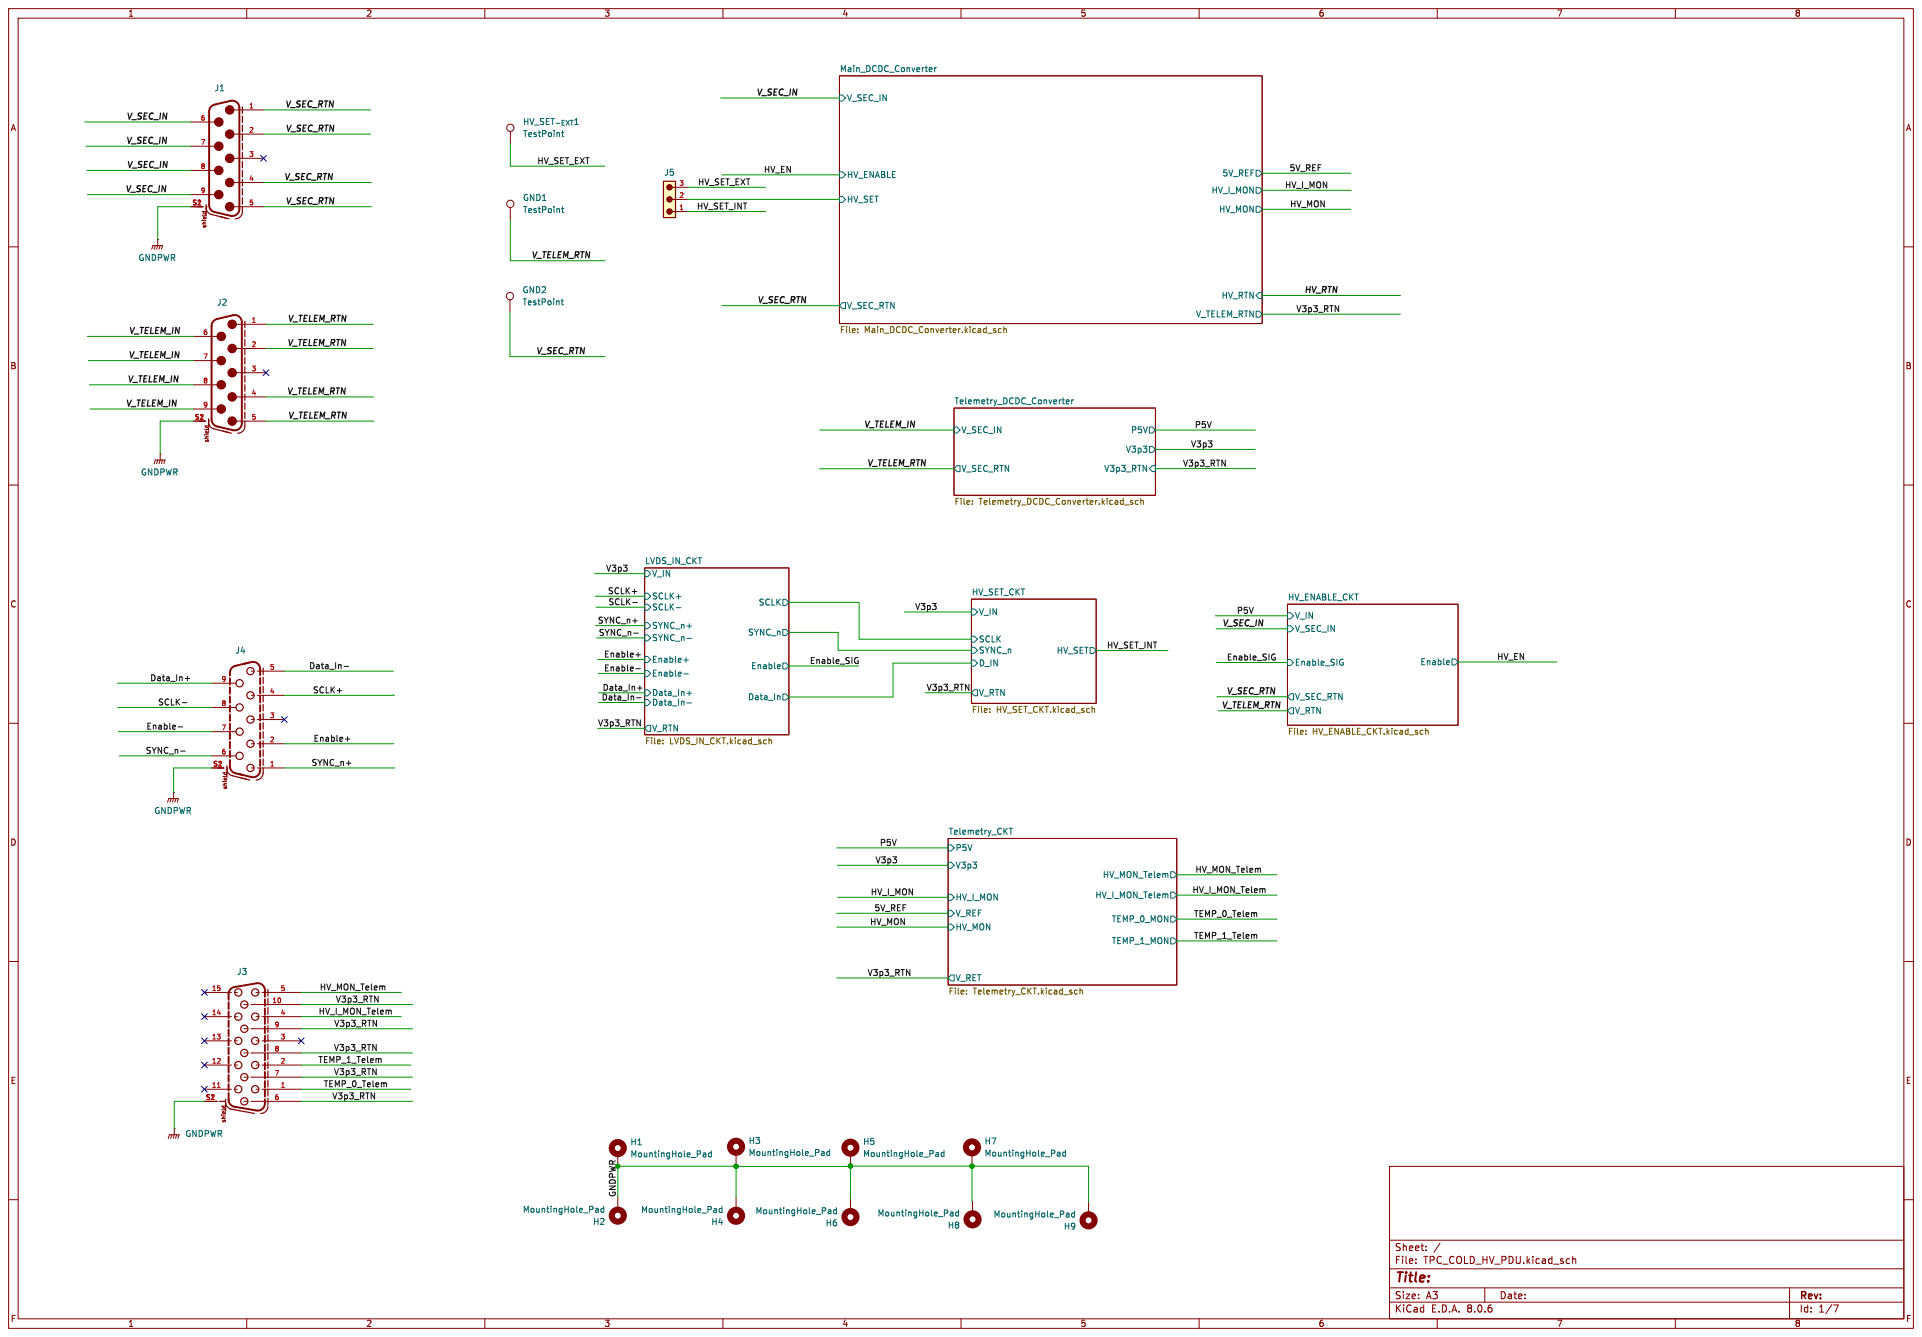
[picture p359: page 1]

SCLK- LVDS_IN_CKT
SCLK Data_In SYNC_n- Enable+ Enable- SYNC_n+ Data_In- Data_In+ SCLK+ V_IN

Id: 1/7 Title: File: TPC_COLD_HV_PDU.kicad_sch Sheet: /

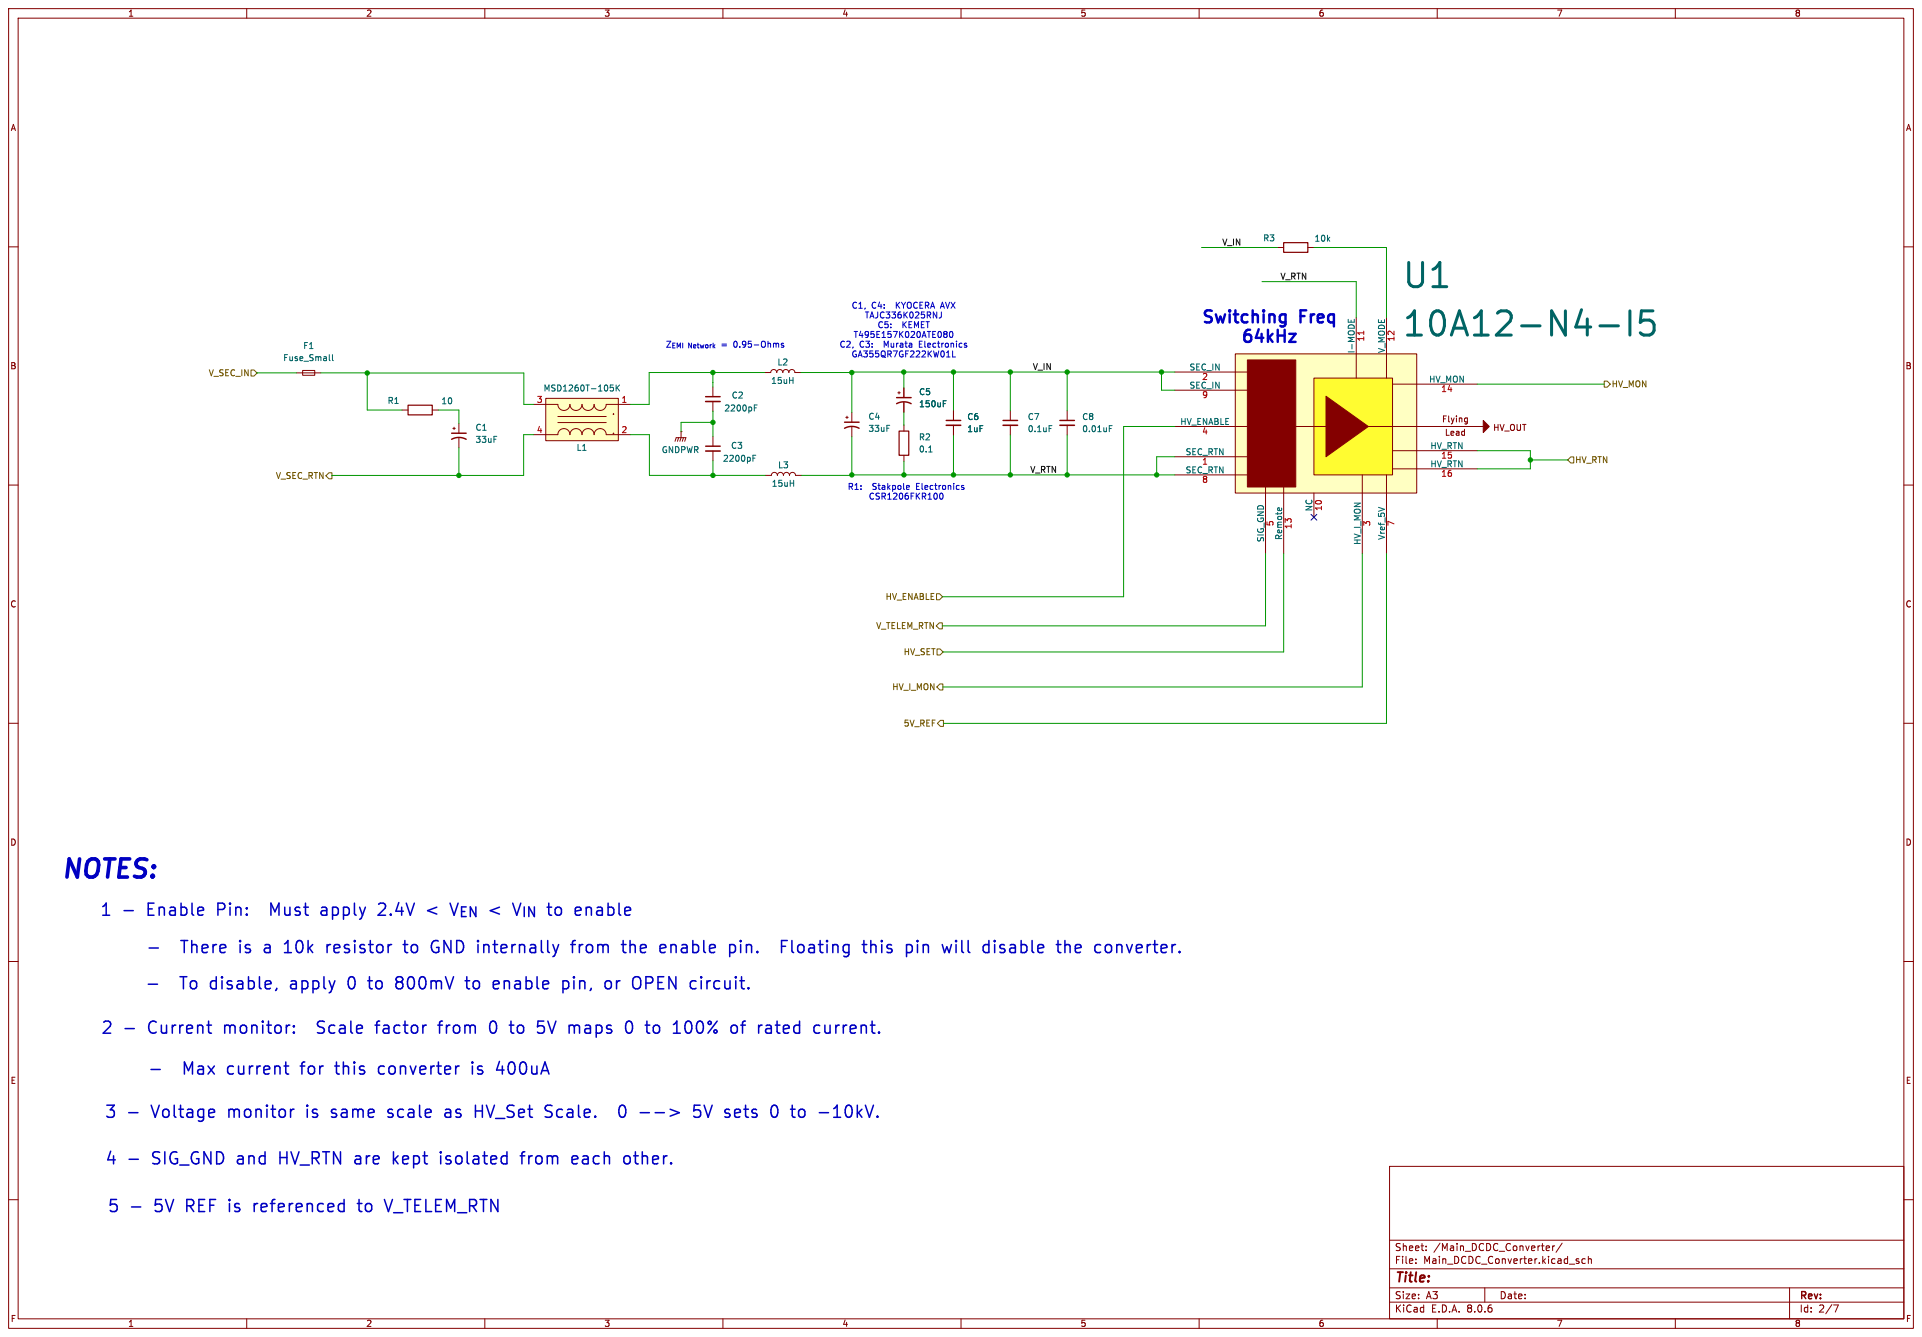
[picture p360: page 2]

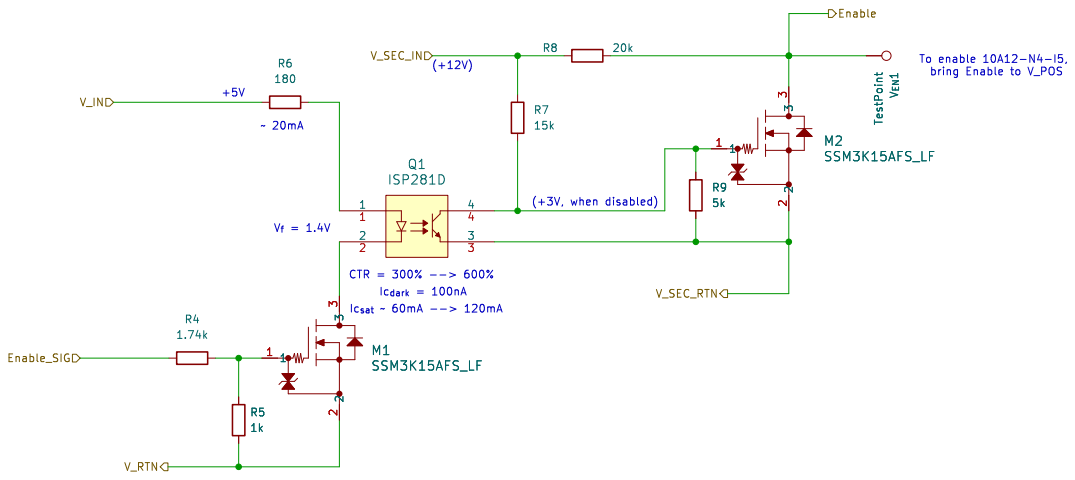
[picture p361: page 3]

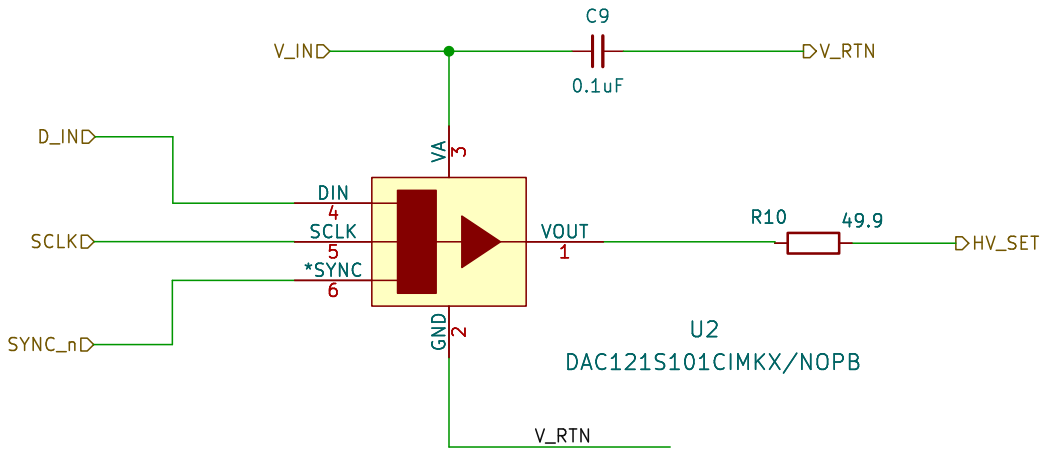
[picture p362: page 4]

Id: 4/7 Title: File: HV_SET_CKT.kicad_sch Sheet: /HV_SET_CKT/

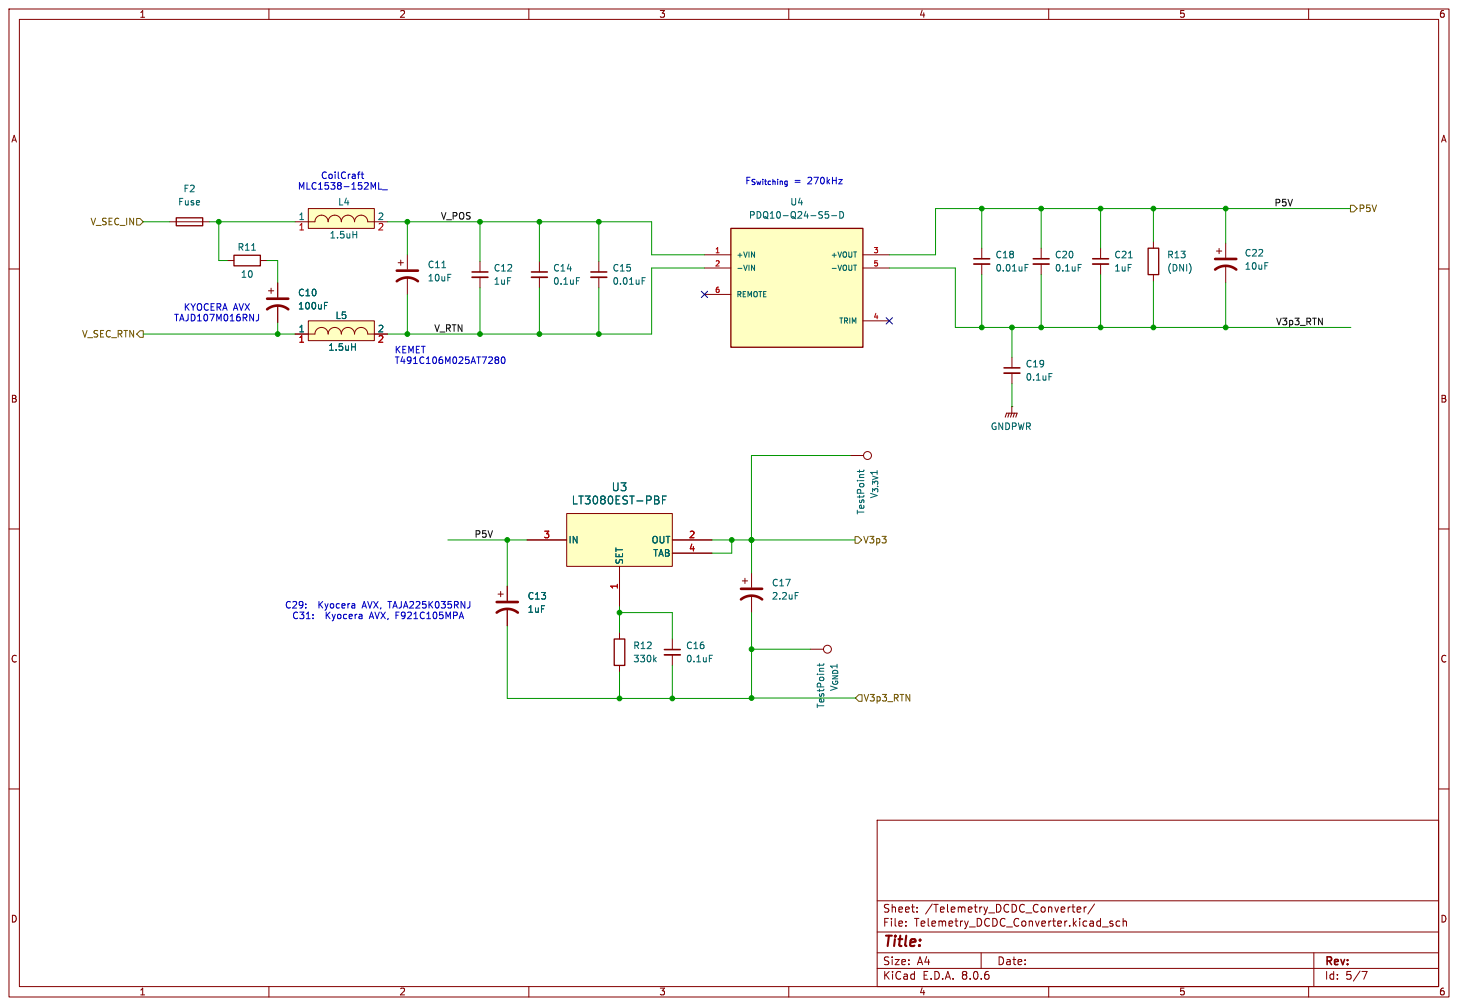
[picture p363: page 5]

Id: 5/7 Title: File: Telemetry_DCDC_Converter.kicad_sch Sheet: /Telemetry_DCDC_Converter/ R12

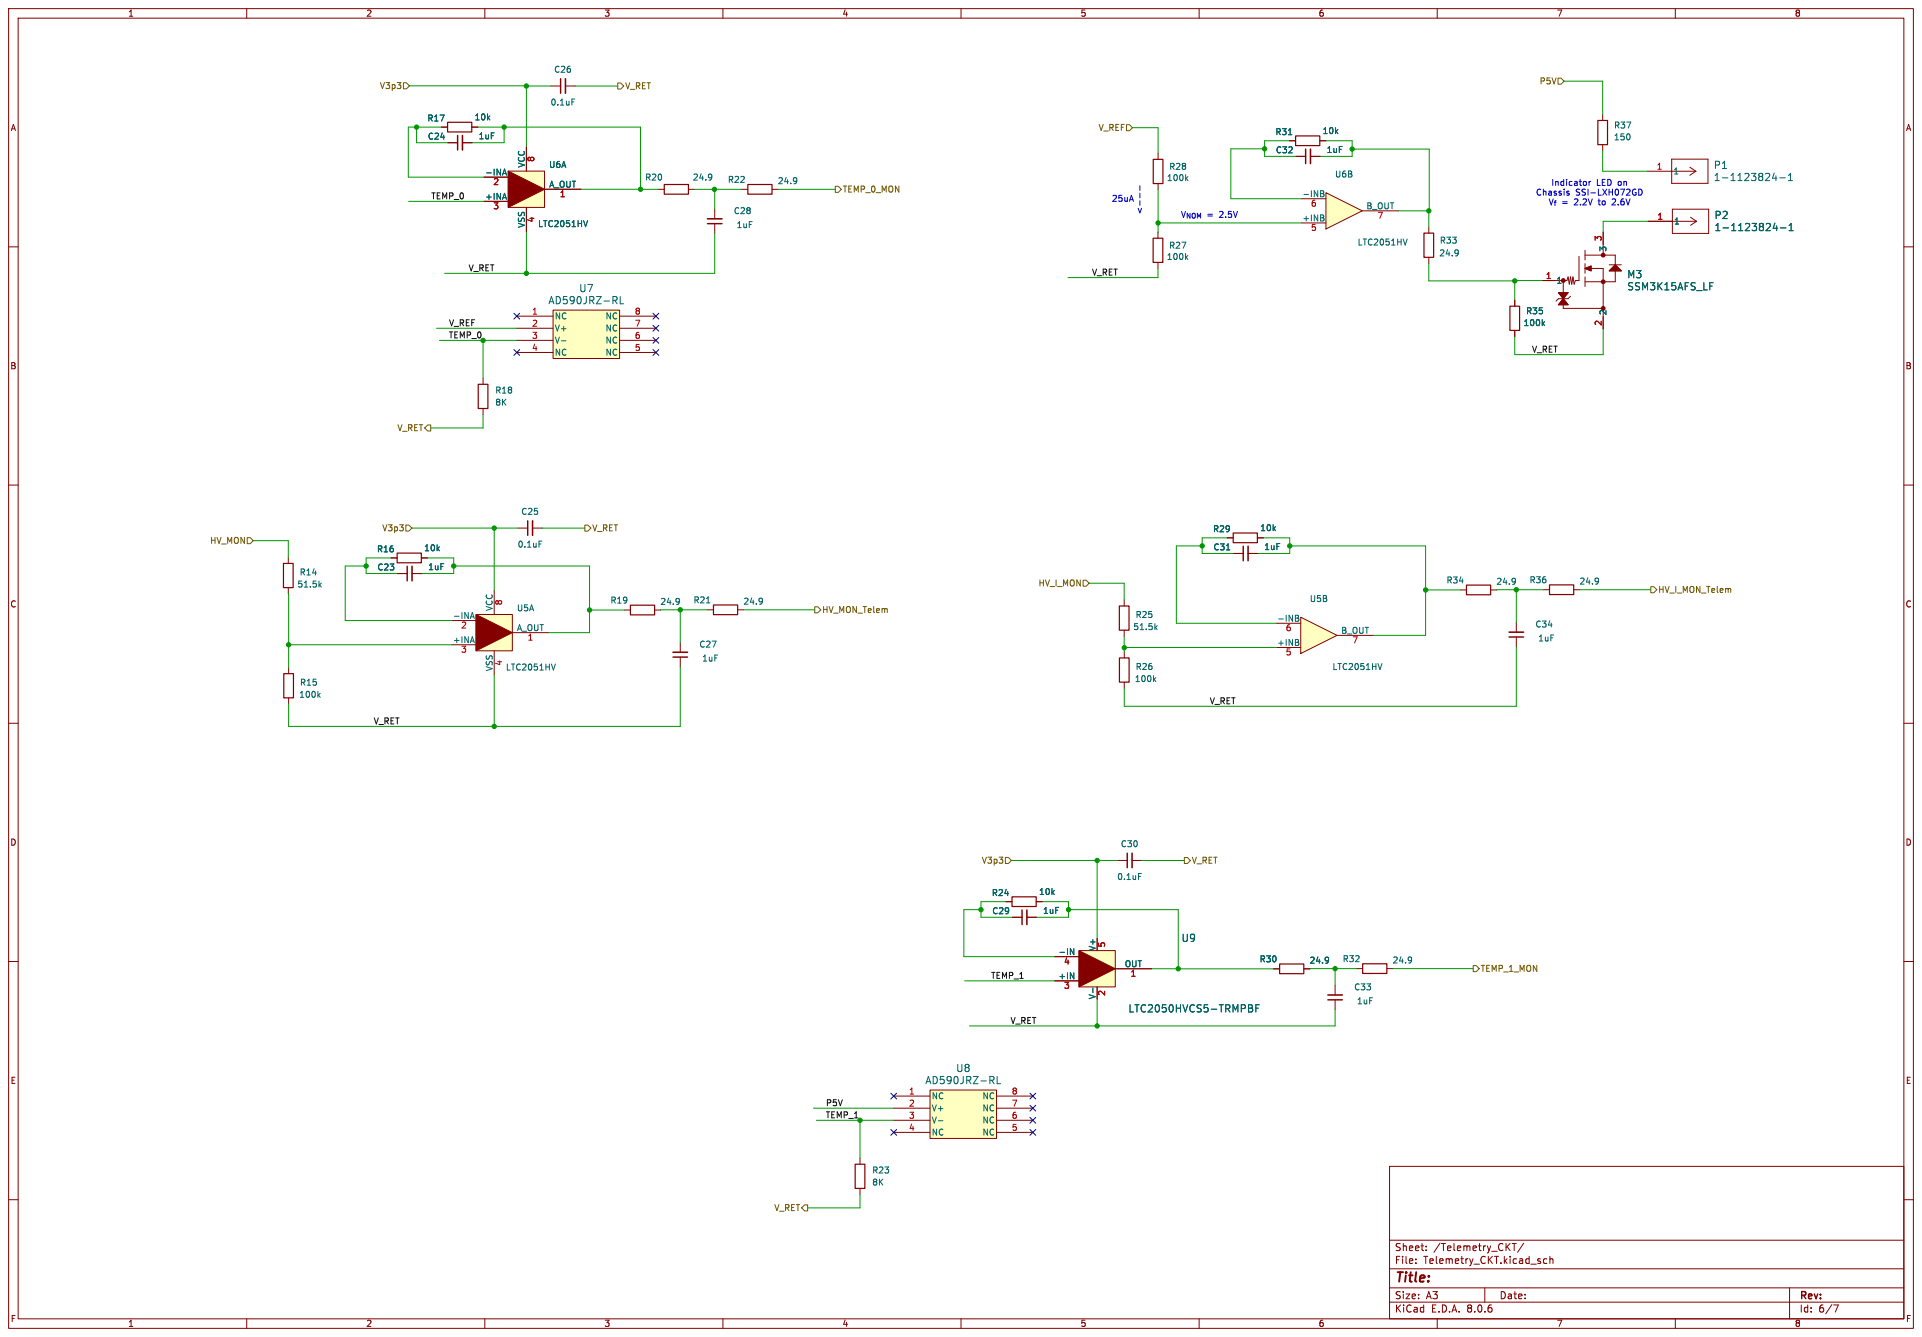
[picture p364: page 6]

Id: 6/7 Title: File: Telemetry_CKT.kicad_sch Sheet: /Telemetry_CKT/

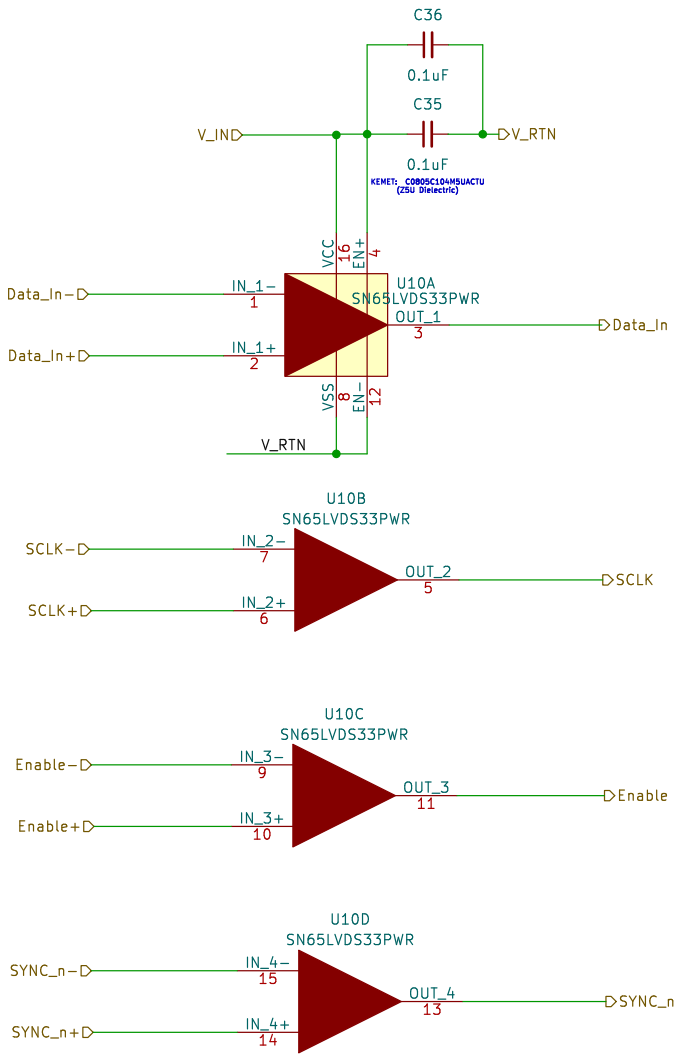
[picture p365: page 7]

Id: 7/7 Title: File: LVDS_IN_CKT.kicad_sch Sheet: /LVDS_IN_CKT/
