rjridle/GRAMS/3_Documentation/5_Reviews/TPC-COLD/SiPM Box/SiPM_HV_Board.pdf

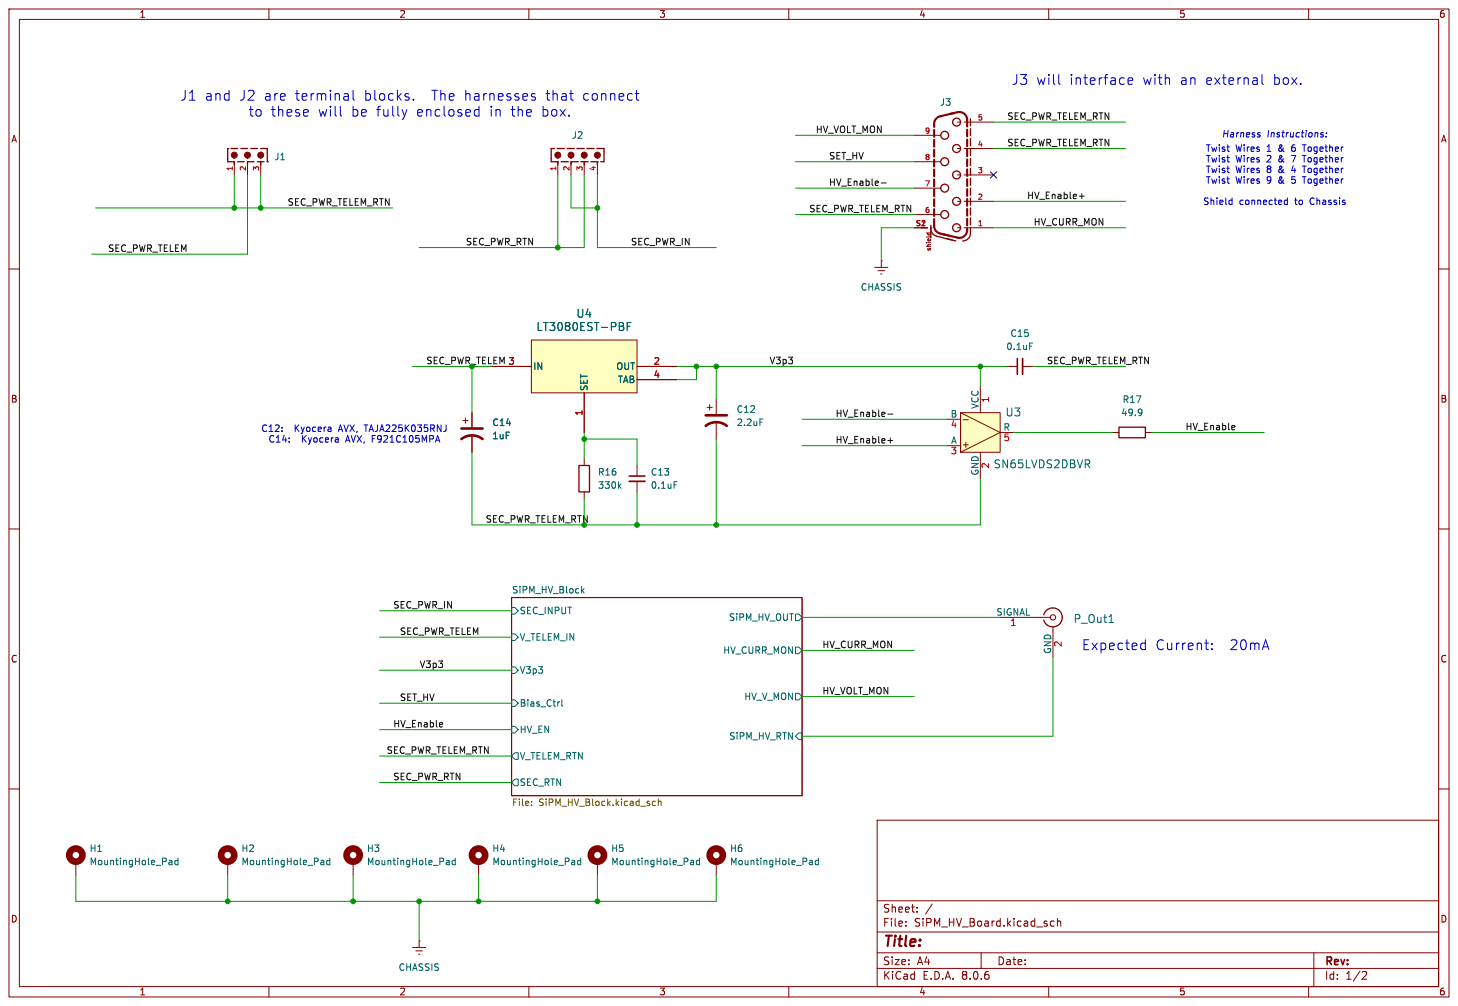
[picture p366: page 1]

Id: 1/2 Title: File: SiPM_HV_Board.kicad_sch Sheet: / SEC_RTN

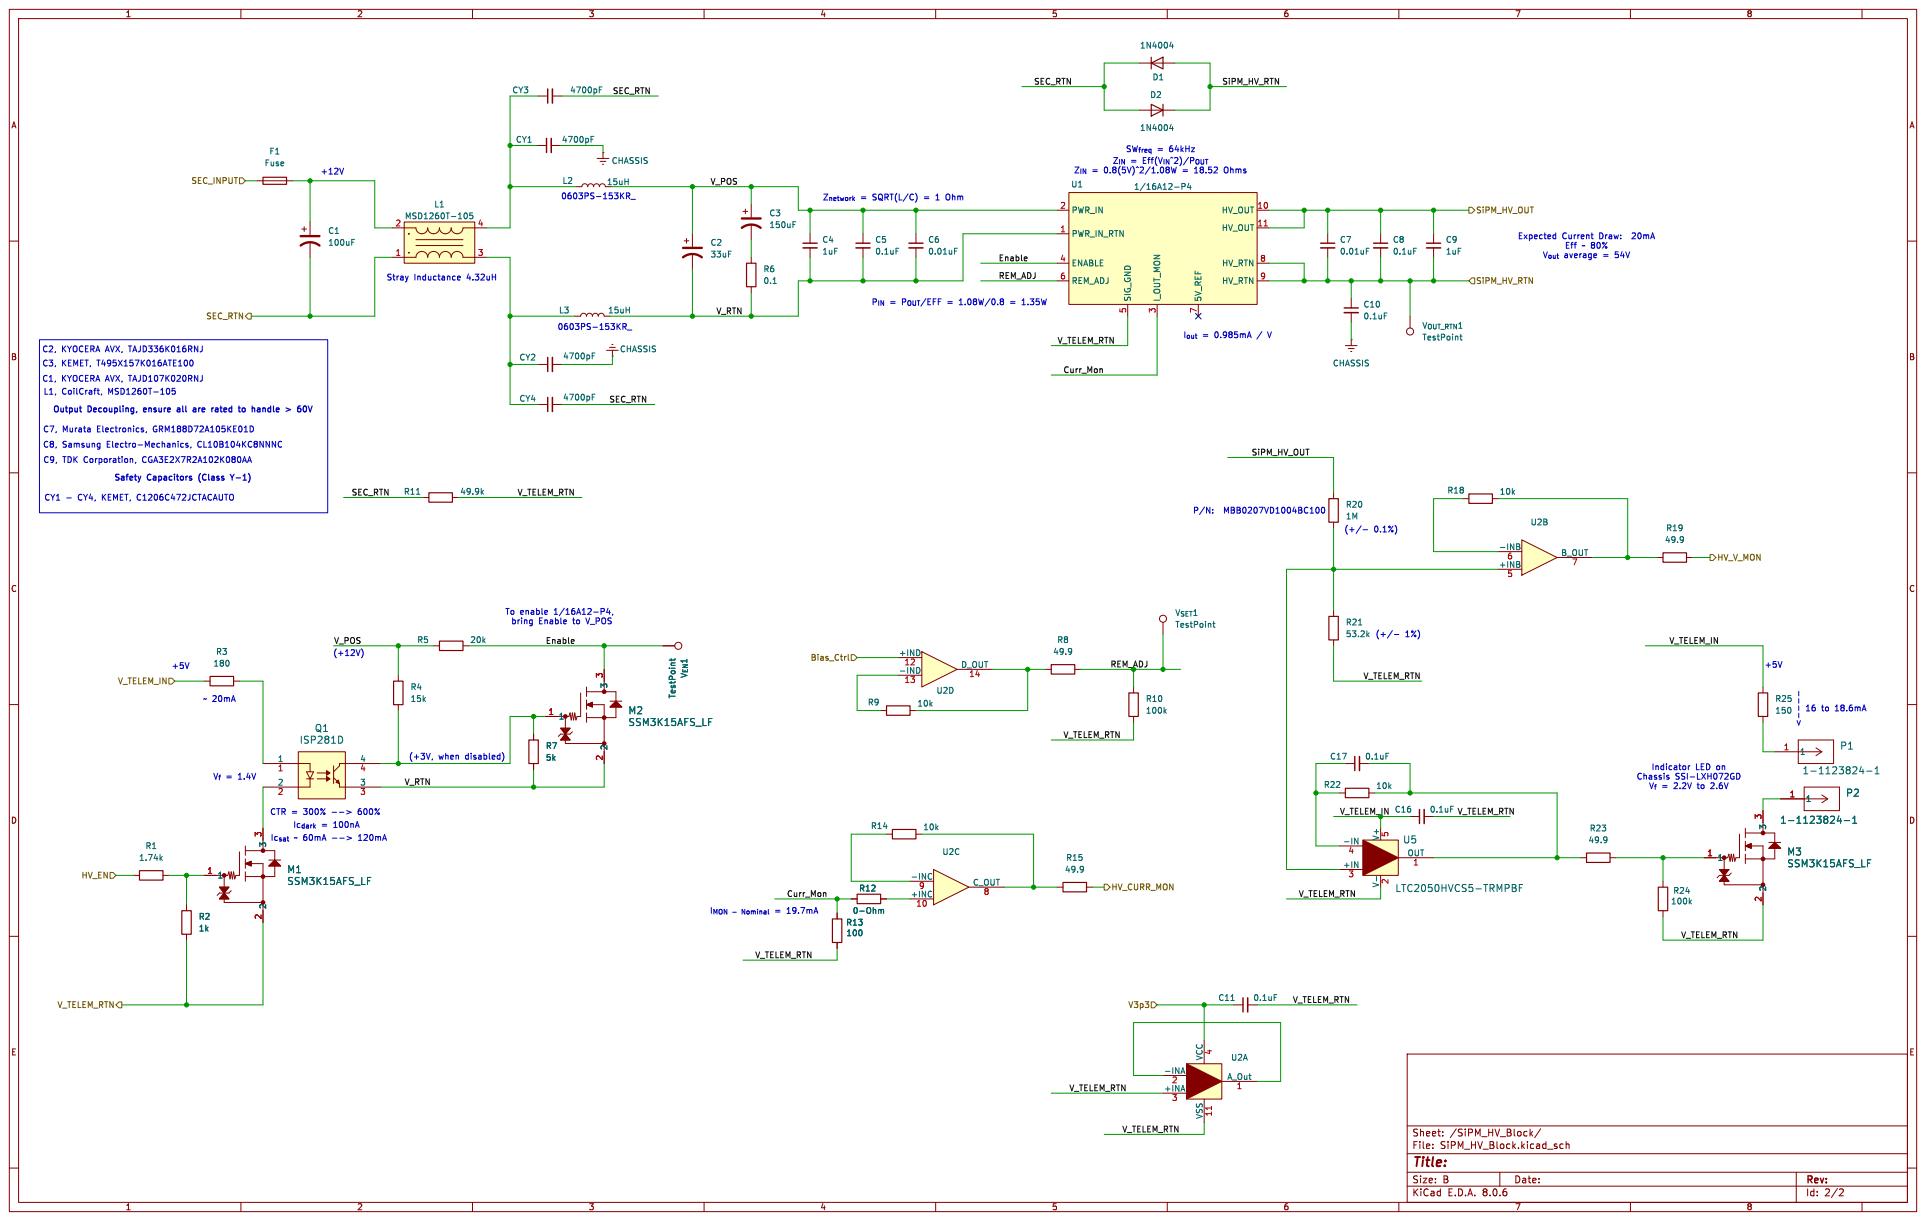
[picture p367: page 2]

CHASSIS R7
0603PS-153KR_ To enable 1/16A12-P4, bring Enable to V_POS

SW_{freq}= 64kHz
Z_{IN}= Eff(V_{IN}^2)/P_{OUT}

Id: 2/2 Title: File: SiPM_HV_Block.kicad_sch Sheet: /SiPM_HV_Block/
