rjridle/GRAMS/3_Documentation/5_Reviews/TPC-COLD/SiPM Box/Telem_PWR_Board.pdf

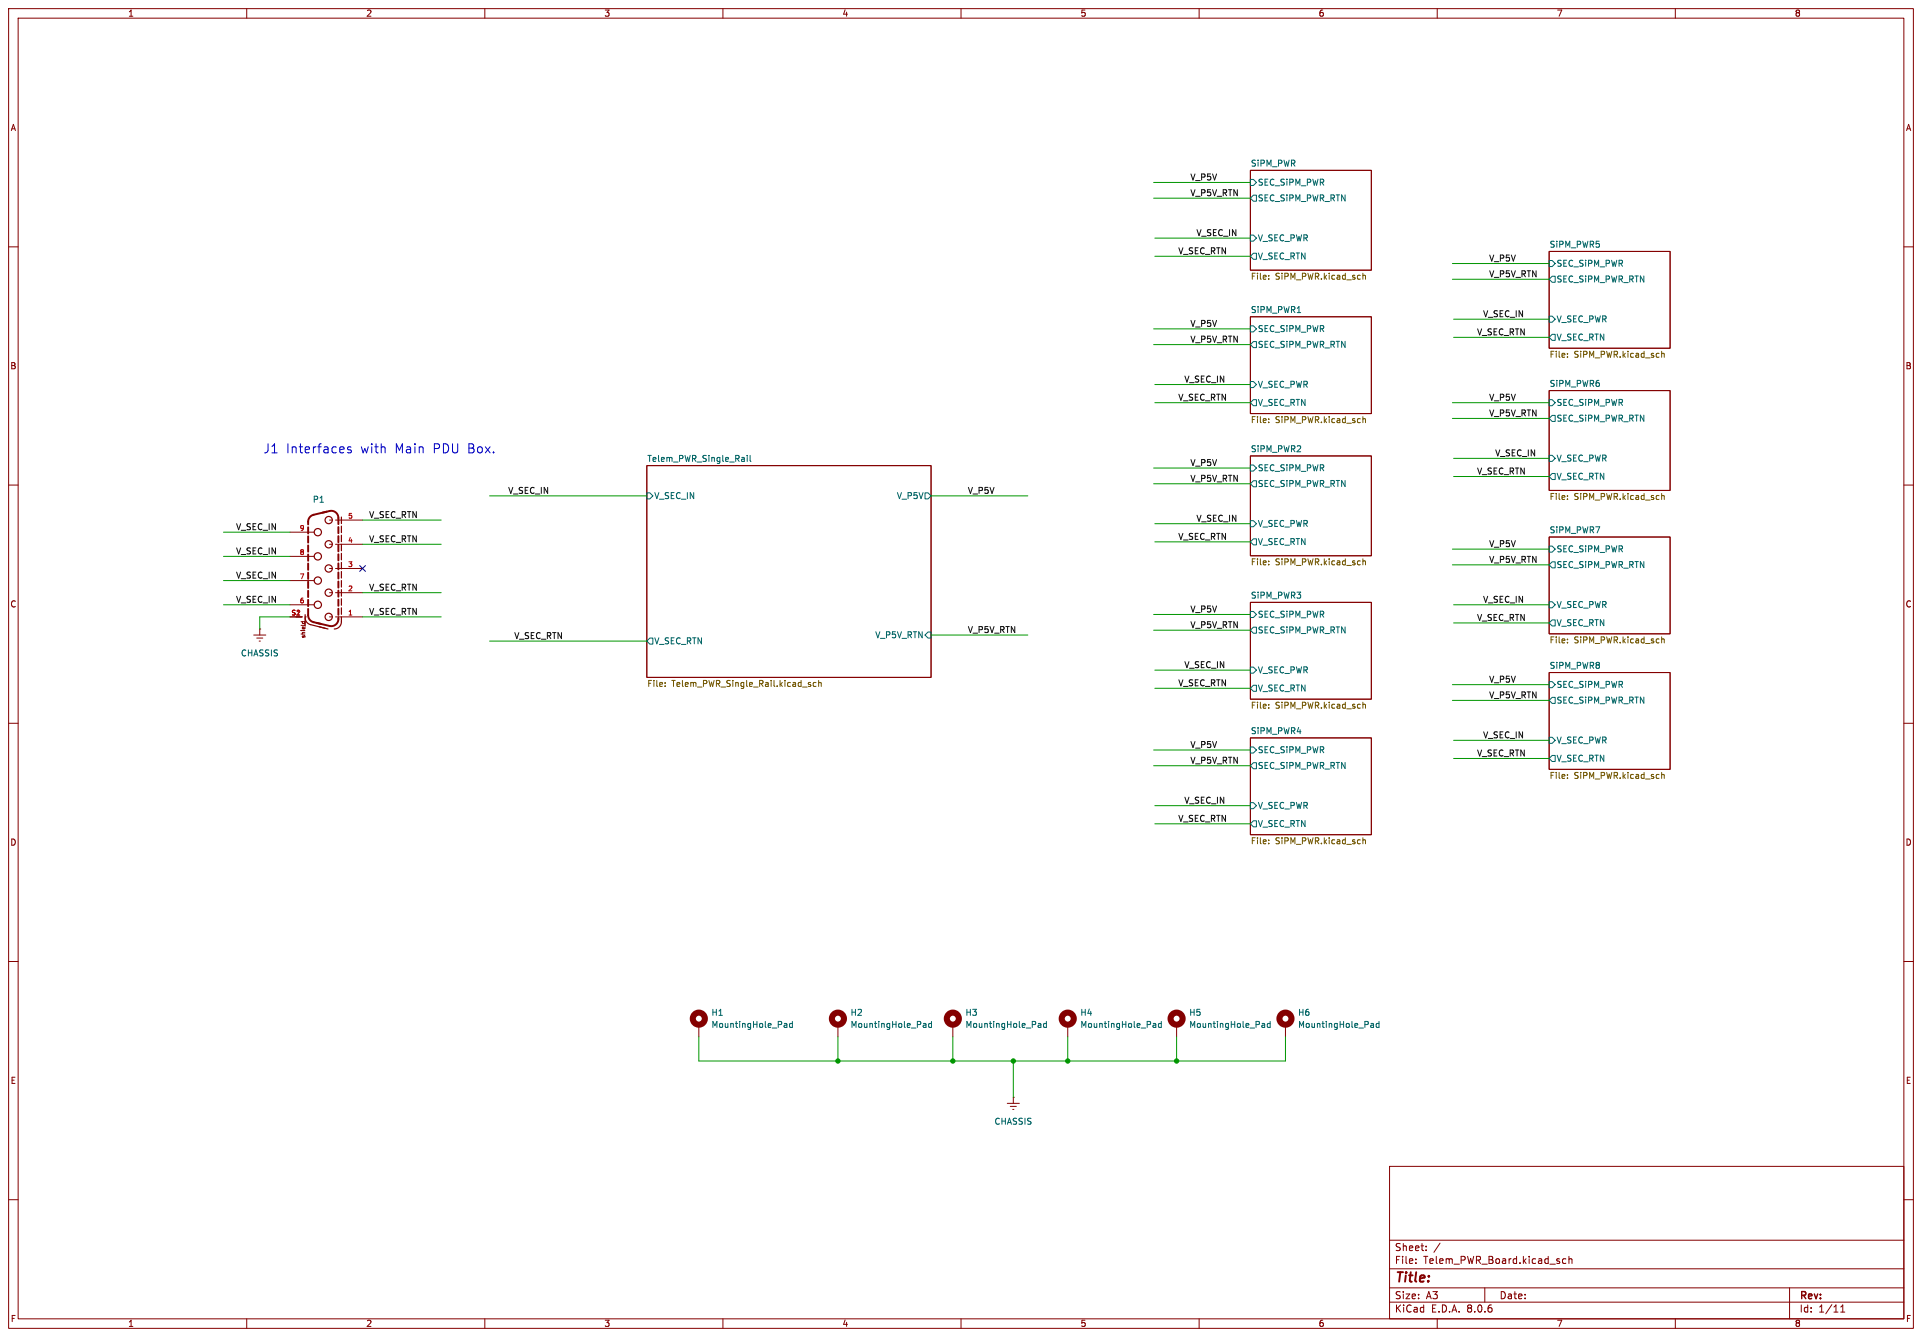
[picture p368: page 1]

Id: 1/11 Title: File: Telem_PWR_Board.kicad_sch Sheet: /


Id: 2/11 Title: File: SiPM_PWR.kicad_sch Sheet: /SiPM_PWR1/

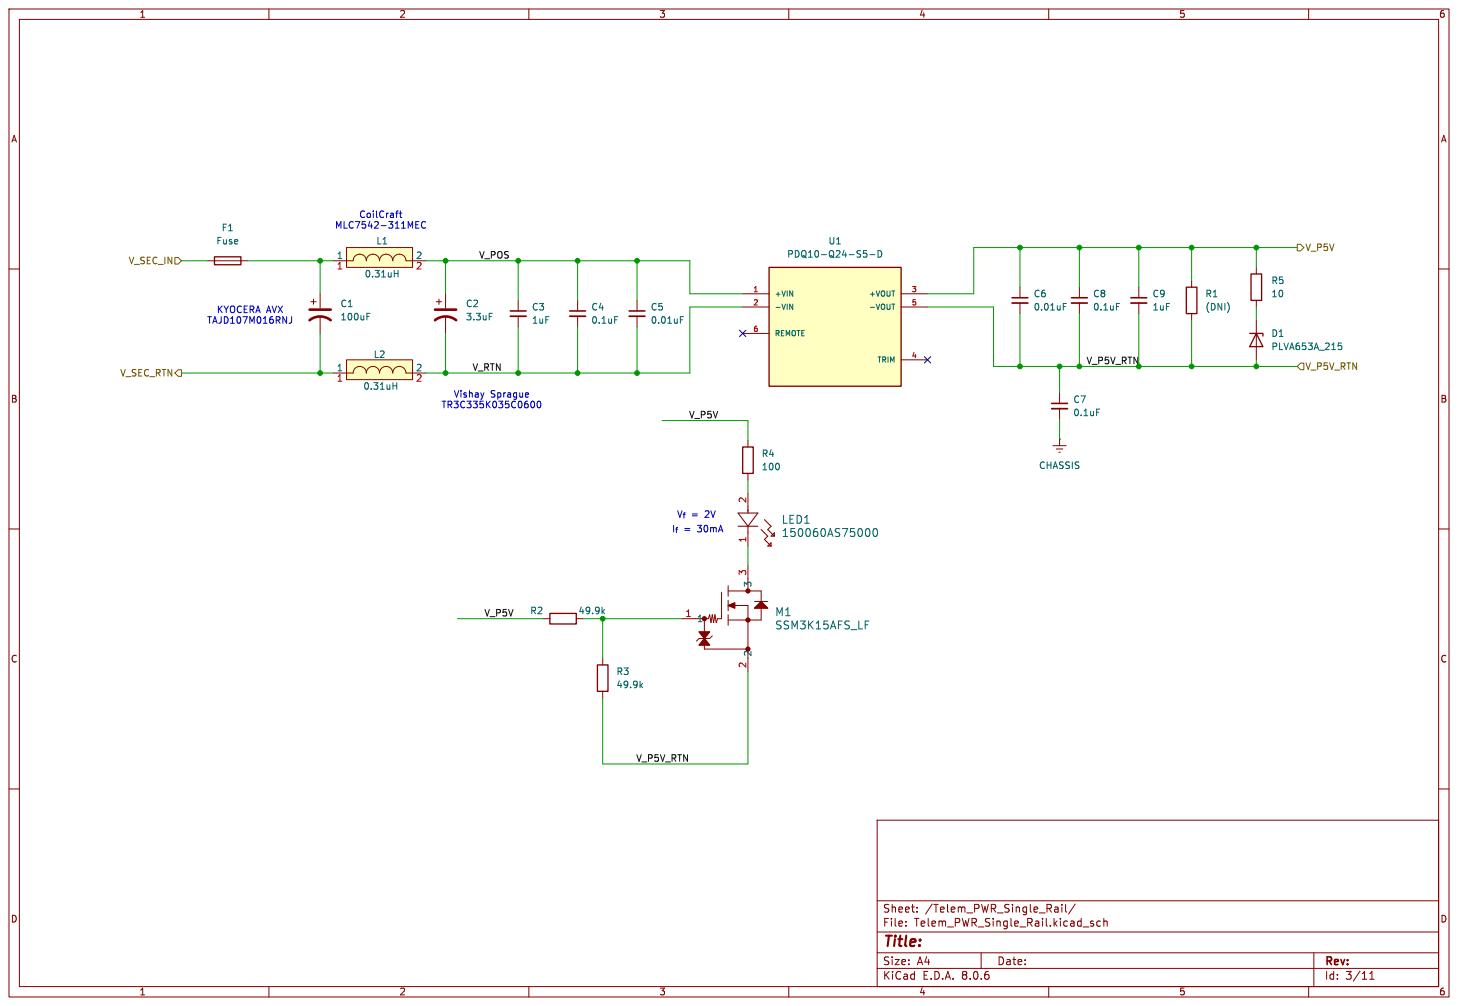
[picture p369: page 3]

Id: 3/11 Title: File: Telem_PWR_Single_Rail.kicad_sch Sheet: /Telem_PWR_Single_Rail/

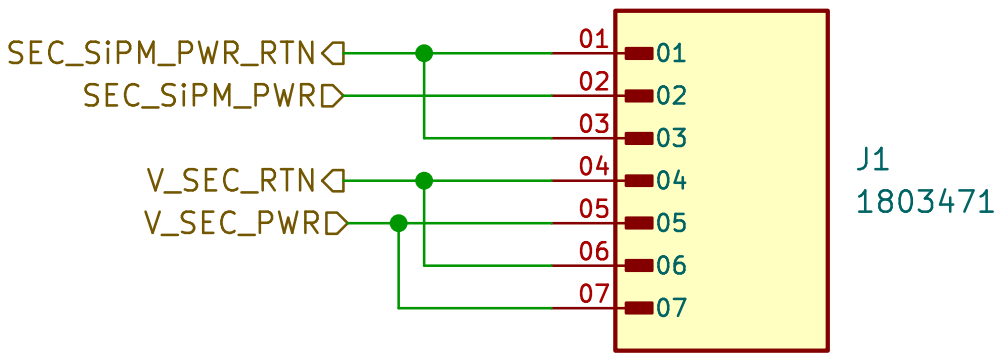
[picture p370: page 4]

Id: 3/11 Title: File: SiPM_PWR.kicad_sch Sheet: /SiPM_PWR/


Id: 4/11 Title: File: SiPM_PWR.kicad_sch Sheet: /SiPM_PWR2/


Id: 5/11 Title: File: SiPM_PWR.kicad_sch Sheet: /SiPM_PWR3/


Id: 6/11 Title: File: SiPM_PWR.kicad_sch Sheet: /SiPM_PWR4/


Id: 7/11 Title: File: SiPM_PWR.kicad_sch Sheet: /SiPM_PWR5/


Id: 8/11 Title: File: SiPM_PWR.kicad_sch Sheet: /SiPM_PWR6/

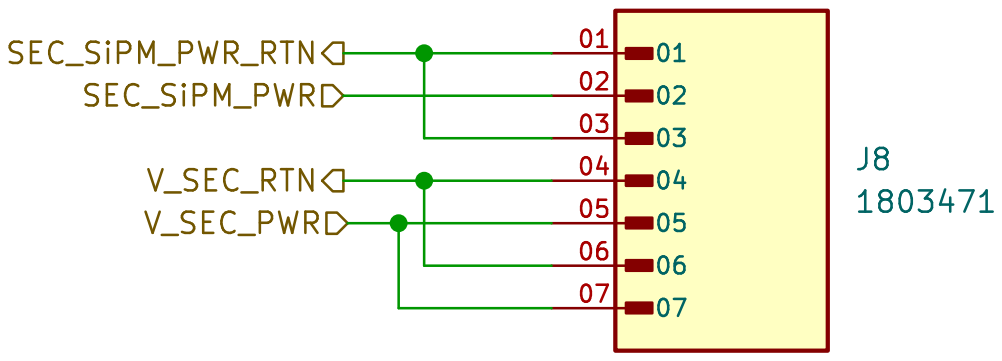
[picture p371: page 10]

Id: 9/11 Title: File: SiPM_PWR.kicad_sch Sheet: /SiPM_PWR7/

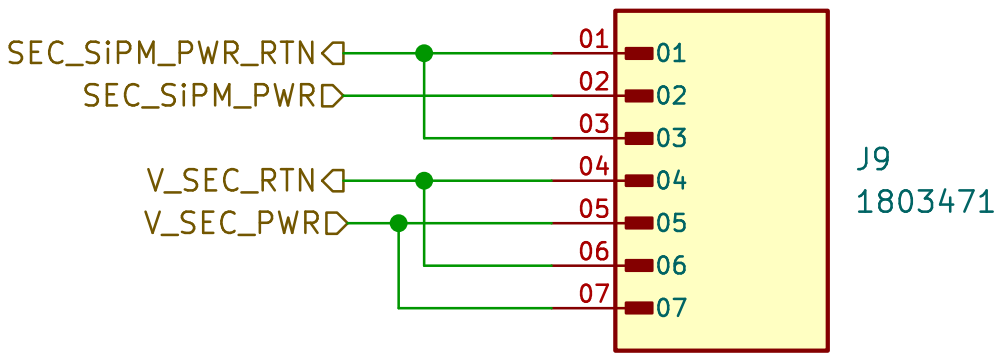
[picture p372: page 11]

Id: 10/11 Title: File: SiPM_PWR.kicad_sch Sheet: /SiPM_PWR8/
