rjridle/GRAMS/(list of files, drawings)

Other design files:
2_Schematics_and_Layout/100_GSE/Simulation_Folder/Stability/LC_Circuit.dsn
2_Schematics_and_Layout/100_GSE/Simulation_Folder/Stability/LC_Circuit.opj
2_Schematics_and_Layout/101_Simulations/SSM3K15AFS_Simulation.dsn
2_Schematics_and_Layout/101_Simulations/SSM3K15AFS_Simulation.opj
Ki-CAD6_Library_Files/Parts/Hirose/DF14A-2P-1.25H_56/DF14A-2P-1.25H_56_/Altium/DF14A2P125H56.PcbLib
Ki-CAD6_Library_Files/Parts/Hirose/DF14A-2P-1.25H_56/DF14A-2P-1.25H_56_/Altium/DF14A-2P-1.25H_56_.SchLib
Ki-CAD6_Library_Files/Parts/MEDER_Elec/Reed_Relays/SIL03-1A72-71D/3D_Model/SIL03-1A72-71D/Altium/SIL03-1A72-71D.SchLib
Ki-CAD6_Library_Files/Parts/MEDER_Elec/Reed_Relays/SIL03-1A72-71D/3D_Model/SIL03-1A72-71D/Altium/SIL031A7271D.PcbLib
Ki-CAD6_Library_Files/Parts/Panasonic/AYF530465T/Altium/AYF530465T.PcbLib
Ki-CAD6_Library_Files/Parts/Panasonic/AYF530465T/Altium/AYF530465T.SchLib
