rjridle/GRAMS/(commit log)

2025-10-30 KiCAD library files
    [0154002.DRT.step, 0154010.DRL.step, 0154Series_LTF.step, 0451Series_LTF.step, 0685T6000-01.step, 10090926-P264VLF.STEP, 10A12-N4.STEP, 1245HC100-RTR_COB.step]
2025-10-30 Schematics and Layout
    [0_MAIN_DC-DC_CONV.kicad_sch, 0_MAIN_PDU.kicad_pcb, 0_MAIN_PDU.kicad_sch, 10_WARM_TPC_SHAPER.kicad_sch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]
2025-10-31 Documentation folder
    [Book1.xlsx, PDU_Table.xlsx, Parts.xlsx, Progress_Table.xlsx, Telemetry_Tables.xlsx, Thermal_RC_Time.xlsx, Total_Power_Demand.xlsx]
2025-10-31 Added DRM and SPICE models
    [PDU-Requirements-Matrix_GRAMS.xlsx, PDU-Requirements-Matrix_GRAMS_12-Nov-24.xlsx, PDU-Requirements-Matrix_GRAMS_24-July_24.xlsx, PDU-Requirements-Matrix_GRAMS_31-July_24.xlsx]
2025-11-21 Changed connector on Charge PreAMP to DB9
    [14_COMMS_TELEM.kicad_sch, 5_COLD_TPC_Charge_Pre_Amp.kicad_sch]
2025-11-21 Added telemetry spreadsheet
    [PDU_Telemetry_Signals.xlsx]
