rjridle/GRAMS/(notices)

Notices in the files:
Ki-CAD6_Library_Files/Parts/Samtec/SMP/SMP-PC-P-HG-ST-TH2.stp:
author */ ('License CC BY-ND 4.0'),
